IGShare/01_WPGS/04_MD/01_WSM/2D_도면.jpg

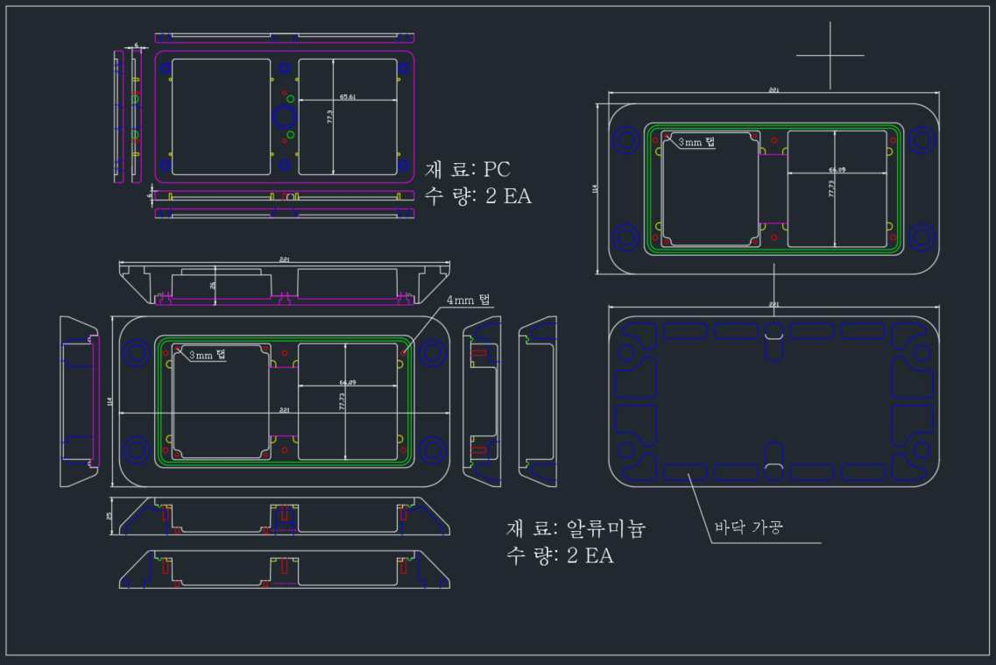
04_MD/01_WSM/2D_도면.jpg
