IGShare/01_WPGS/01_HW/02_WSCM/02_Development/01_WB/01_EVKit/01_CC2538/Readme.txt

XXXXXXXXXXXXXXXXXXXXXXXXXXXXXXXXXXXXXXXXXXXXXXXXXXXXXXXXXXXXXXXXX
X   	Artwork and documentation done by: 			X
X							X
X	TEXAS INSTRUMENTS NORWAY LPRF              		X
X  							X
X	Address: Gaustadalléen 21    0349 OSLO	              X
X 	web: www.ti.com/lprF		              	X
X                                                           	X
XXXXXXXXXXXXXXXXXXXXXXXXXXXXXXXXXXXXXXXXXXXXXXXXXXXXXXXXXXXXXXXXX

PCB NAME : CC2538EM
REVISION: 1.2
DATE: 2012-12-02

FILE:  PACKED WITH WinZIP 

PCB DESCRIPTION:4 LAYER PCB 1.6 MM
      Copper        1   35 um
      Dielectric  1-2   0.175 mm (e.g. 1x Prepreg 7628 AT05 47% Resin)
      Copper        2   18 um
      Dielectric  2-3   1.14 mm (6x 7628M 43% Resin)
      Copper        3   18 um
      Dielectric  3-4   0.175 mm (e.g. 1x Prepreg 7628 AT05 47% Resin)
      Copper        4   35 um
  DE104iML or equivalent substrate (Resin contents around 45%, which gives Er=4.42@2.4GHz, TanD=0.016)
  Dimensions in mm
  DOUBLE SIDE SOLDER MASK,
  DOUBLE SIDE SILKSCREEN,
  0.15 MM MIN TRACE WIDTH AND 0.15 MM MIN ISOLATION.

FILE NAME            		DESCRIPTION                               	FILE TYPE
-------------------------------------------------------------------------------------------
***PCB MANUFACTURING FILES:
layer1.art                 	LAYER 1 TOP SIDE/POSITIV              		EXT. GERBER
layer2.art                  	LAYER 2 Inner layer/POSITIV                 	EXT. GERBER
layer3.art                  	LAYER 3 Inner layer/POSITIV                 	EXT. GERBER
layer4.art                  	LAYER 4 SOLDER SIDE/POSITIV                 	EXT. GERBER
outline.art				Outline of PCB						EXT. GERBER
soldmask_top.art            	SOLDER MASK COMPONENT SIDE/NEGATIVE      		EXT. GERBER
soldmask_bottom.artL          SOLDER MASK SOLDER SIDE/NEGATIVE            	EXT. GERBER
silk_top.art	            SILKSCREEN COMPONENT SIDE/POSITIVE          	EXT. GERBER
silk_bottom.art			SILKSCREEN SOLDER SIDE/POSITIVE             	EXT. GERBER
NCdrill-1-4.drl               NC DRILL Plated		                       	EXCELLON
NCdrill-1-4-np.drl		NC DRILL non-Plated					EXCELLON
drill.art		            DRILL/MECHANICAL DRAWING                    	EXT. GERBER

ncdrill.log		              DRILL/NC DRILL REPORT                       	ASCII

*** ASSEMBLY FILES:
paste_top.art	             	SOLDER PAST COMPONENT SIDE/POSITIVE         	EXT. GERBER
paste_bottom.art	             	SOLDER PAST SOLDER SIDE/POSITIVE            	EXT. GERBER
assembly_top.art	            	ASSEMBLY DRAWING COMPONENT SIDE/NEGATIVE    	EXT. GERBER
assembly_bottom.art       	   	ASSEMBLY DRAWING SOLDER SIDE/NEGATIVE       	EXT. GERBER
pcp_rep.txt             		PICK AND PLACE FILE 
CC2538EM_PARTLIST_1_2_0.xlsx		BOM								Excel

PDF FILES:
CC2538EM_schematic_1_2_0.pdf	Circuit Diagram
CC2538EM_layout_1_2.pdf		Layout Diagram
CC2538EM_drill_1_2.pdf 		Drill

README.TXT           	THIS FILE                                 			ASCII

END.
