IGShare/01_WPGS/01_HW/01_WSM/02_Development/02_P0/04_Document/WSM 배치도.pptx

WSM 배치도

단위 : mm

65

65

15

8

10

18.4

23

25

13.5

5

65

- 14500 충전지-

20

40

18.4

65.3

55.2

14

50

WSM

77

J10

71

85

Antenna

56

55.2

71

J11

J12

Antenna

32

160

59

59

59

- 18650 충전지-

## Slide 2

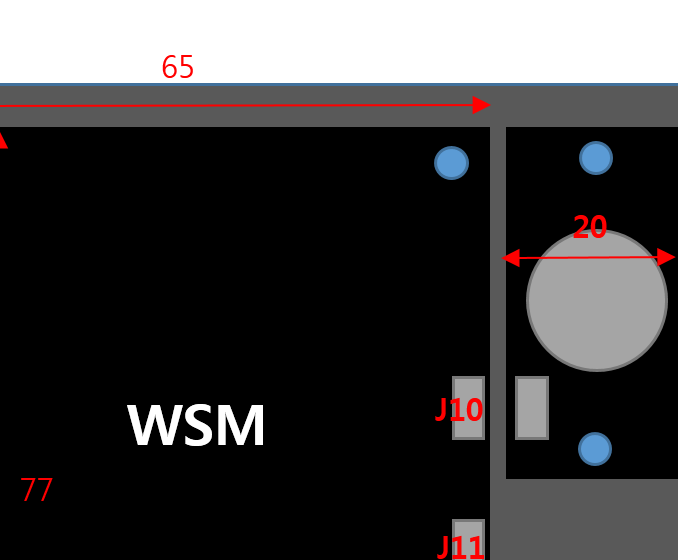
[picture p7: figure]

1.5mm

3mm

1.5mm
