IGShare/01_WPGS/01_HW/01_WSM/02_Development/03_P1/04_Document/WSM P1 배치도.pptx

77cm

WSM P1 배치도

S1 : ROM Enable 스위치
J7 : JTAGs
J6 : UART / D5,D6 : UART 보호다이오드
TH7 : D3V3P, 전원 측정 홀
TH6 : GND, 그라운드 홀
TH5 : D4V2P, 전원 측정 홀
D9 : 배터리 & 솔라 LED, 동작 전원
SW1(TP1, TP2) : CC2630 Reset 스위치
J9 : SmartRF06 evkit Debugging 핀
J8 : Reserved Pin
J2-J5: MCU Debugging LED 홀
J11(TH9, TH10) : 솔라 전원
J12(TH11, TH12) : Battery 전원
J10(TH3, TH4) : 초음파 센서 연결
U6 : D3V3P 출력 Regulator
U7 : PCM 배터리 보호칩
U3 : SPDT 초음파 Tx/Rx 선택 스위치
U4 : Op Amp 초음파 Rx 증폭
U5 : EEPROM
U2 : Magnetic Sensor
U1 : CC2630 7x7 MCU
J1 : SMA Right Angle Con, 안테나

WSM P1 배치도
- 전체 부품은 TOP 배치
- MCU 파트
1. U1, CC2630 Package 5x5 → 7x7 변경
2. S1, 스위치 KSD-02H → KHS22 변경
3. J7, JTAG Header 핀 수 변경
J8, Reserved 핀 수 변경
J9, SmartRF06 Evkit Debugging Header 추가
- Magnetic Sensor 파트
1. TP추가
- Ultra Sound Sensor 파트
1. 전원 공급 기존 D3V3P 공급 → D3V3P_US, Regulator 출력 전압
D4V2P_US, 배터리 or 솔라 출력 전압 선택 공급 가능
2. OP Amp TI社 TL072ID → TLV342IDR 변경
3. Detection Circuit IN4148W → BAT54 Shottky Diode 변경
4. TP추가
- Power 파트
1. PCM 칩 S-8200A → S-8240A 로 변경
2. 솔라 입력 전원 5V→ 4.5V 변경
3. 4.2V 출력 Regulator 삭제
4. 전원 입력 LED 삽입

1.2cm

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
TH11

J12

TH12

TH10

65cm

U2

U1

U4

J10

TH4

PCB
Ant.

TH3

1cm

J2

J3

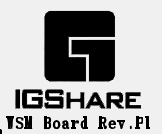
[picture p8: figure]

J1

J5

J4

1.4cm

65cm

55cm
