IGShare/01_WPGS/01_HW/01_WSM/02_Development/03_P1/04_Document/WSM P1_Review.pptx

## WSM P1_ Review

## Slide 2

WSM P0

WSM P1

1. MCU 2630RHB→ 2630RGZ 변경,
2. Reset 스위치 변경

## Slide 3

WSM P0

1. 기존에 센서 1개를 두어 초음파 아웃, 인 다이렉트로 연결 → SPDT 스위치를 두어 연결(스위치사용하면 펄서 형태 일그러짐 )
2. 다이오드 기존 정류다이오드 → 쇼트키 다이오드 BAT 54 변경

WSM P1

## Slide 4

WSM P0

WSM P1

1. PCM 사용하는 FET 변경 (너무 작아서 납땜 정확도 떨어진)
2. 초음파 전원 3.3V or 배터리 전원 선택 전원
3. 태양광에서 바로 연결된 4.2 LDO 제거(필요 없음)
4. 리튬 배터리의 그라운드는 PCM을 통해 연결되어야함. (P0설계 미스)

## Slide 5

WSM P1

WSM P1 배치도 (전체 배치 변경)
- 전체 부품은 TOP 배치
- MCU 파트
1. U1, CC2630 Package 5x5 → 7x7 변경
2. S1, 스위치 KSD-02H → KHS22 변경
3. J7, JTAG Header 핀 수 변경
J8, Reserved 핀 수 변경
J9, SmartRF06 Evkit Debugging Header 추가
- Magnetic Sensor 파트
1. TP추가
- Ultra Sound Sensor 파트
1. 전원 공급 기존 D3V3P 공급 → D3V3P_US, Regulator 출력 전압
D4V2P_US, 배터리 or 솔라 출력 전압 선택 공급 가능
2. OP Amp TI社 TL072ID → TLV342IDR 변경
3. Detection Circuit IN4148W → BAT54 Shottky Diode 변경
4. TP추가
- Power 파트
1. PCM 칩 S-8200A → S-8240A 로 변경
2. 솔라 입력 전원 5V→ 4.5V 변경
3. 4.2V 출력 Regulator 삭제
4. 전원 입력 LED 삽입
