IGShare/01_WPGS/01_HW/01_WSM/02_Development/03_P1/04_Document/아트웍 배치 WSM P1.pptx

77cm

WSM P1 배치도

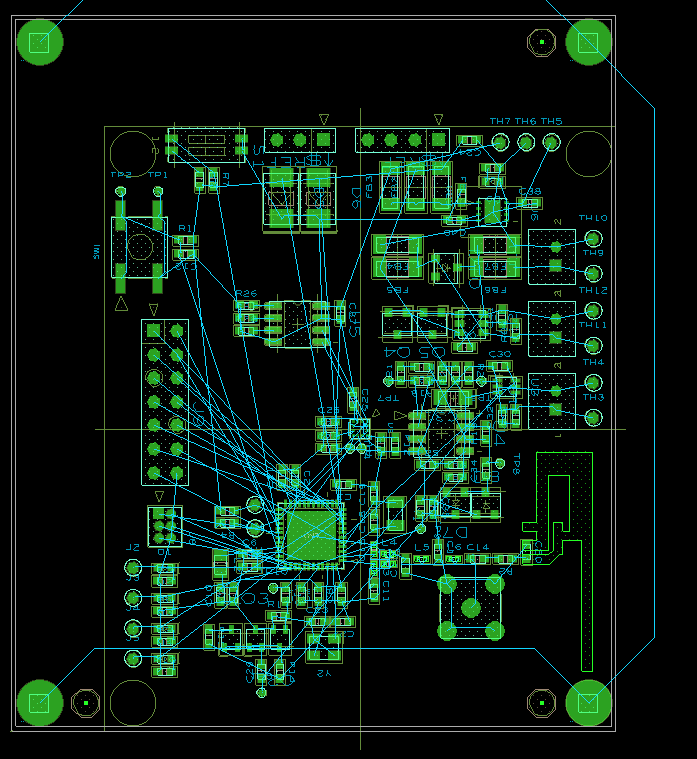
[picture p9: figure]

회사 로고 위치는
뒷면의 U2 아래 위치
WSM Board Rev. P1

1.2cm

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
TH11

J12

TH12

TH10

65cm

U2

U1

U4

J10

TH4

PCB
Ant.

TH3

1cm

J2

J3


J1

J5

J4

1.4cm

65cm

55cm
