IGShare/01_WPGS/01_HW/01_WSM/02_Development/04_P2/04_Document/WSM P2 리뷰자료.pptx

WSM P1→ P2 수정 사항
(I2C)
1. STATUS_LED3, STATUS_LED4 → I2C SCL, SDA 핀으로 변경
2. I2C 외부 연결 pin header J10 추가
(EEPROM)
1. EEPROM WP핀 스위치에 High low 변경 가능하게
(Ultra-sound)
1. Inverter SN74LVC1G04 추가
2. R19 300K → 1M
3. 3.3V 고정 전원이 아닌, 배터리 전원이 입력
(Power)
1. PCM Switch 연결
2. IRF7832PbF → CSD16413Q5A TI社
(ETC)
1. Connector Bottom 및 A2001 시리즈로 변경
2. 홀 제거
3. Vcut 제거
