IGShare/01_WPGS/01_HW/01_WSM/02_Development/05_P3/02_Artwork/wsm_p3_완료/netlist_report.htm

Design Name E:/work/jina/wsm_p3/allegro/wsm_p3_20170904.brd
Date Mon Sep 04 11:30:15 2017

Net List Report
Net Name | Net Pins
/RESET | R8.1 S1.2 U1.35
BTN_DOWN | J21.1 U1.18
BTN_RIGHT | J13.1 U1.28
BTN_SELECT | J20.1 U1.17
D3V3P | C26.2 C27.2 C28.2 C37.1 FB10.2 R12.2 TH7.1 U2.5 U2.6 U5.8
D3V3P_MCU | C2.2 C3.2 C4.2 C5.2 C6.2 C24.2 C44.2 C45.1 FB8.2 J7.1 R3.2 R4.2 R7.2 R8.2 R40.2 U1.13 U1.22 U1.34 U1.44
D3V3P_RX | C31.1 C36.2 FB12.2 FB14.2 R24.1 U4.8
D3V3P_TX | FB11.2 FB13.2 R14.2 R15.2 U8.5
D3V3P_US | C39.1 FB8.1 FB10.1 FB11.1 FB12.1 U6.1
D4V2P | C38.1 D9.1 FB13.1 FB14.1 R36.1 R50.1 TH5.1 U6.5 U6.8
DCDC_SW | L2.1 U1.33
DRDY | TP12.1 U2.8
EEPROM_WP | R40.1 S1.3 U5.7
ENABLE | R12.1 R13.2 U2.10
GND | C2.1 C3.1 C4.1 C5.1 C6.1 C7.1 C8.1 C9.1 C10.1 C11.2 C15.2 C16.1 C17.1 C18.2 C19.2 C21.2 C22.1 C23.1 C24.1 C25.1 C26.1 C27.1 C28.1 C31.2 C35.1 C36.1 C37.2 C38.2 C39.2 C40.2 C44.1 C45.2 C46.1 C52.1 D8.2 J1.2 J1.3 J1.4 J1.5 J6.3 J7.4 J10.3 J11.2 L7.2 Q2.2 Q3.3 Q4.1 Q4.2 Q4.3 R5.1 R13.1 R17.1 R22.1 R23.1 R25.1 R26.1 R27.1 R28.1 R30.2 R31.1 R38.2 R39.1 R51.2 S1.5 S1.6 S1.7 S1.8 TH6.1 U1.49 U2.3 U2.12 U4.4 U5.4 U6.4 U6.9 U8.3 Y2.2 Y2.4
GND-B | C41.2 C46.2 J12.1 Q5.1 Q5.2 Q5.3 S1.4 U7.4 U7.6
I2C_SCL | R3.1 U1.11 U2.1 U5.6
I2C_SDA | R4.1 U1.12 U2.11 U5.5
INT | U1.6 U2.7
JTAG_TCK | J7.2 U1.25
JTAG_TMS | J7.3 U1.24
LCD_CS | J14.1 U1.20
LCD_MODE | J15.1 U1.9
LCD_RESET | J16.1 U1.10
N167017791 | R38.1 U2.2
N16701813 | C25.2 U2.4
N16705809 | C32.2 R20.2
N16705820 | C32.1 R18.1 U4.2
N16705966 | R24.2 R25.2 U4.3 U4.5
N16706795 | C33.1 R19.1 U4.6
N16707221 | R18.2 R21.1 U4.1
N16707237 | C33.2 R21.2
N16707258 | C34.2 R19.2 U4.7
N16707911 | C34.1 D7.2 D8.1
N16724996 | Q2.1 R16.2 R17.2
N16725044 | Q1.1 Q2.3 Q3.1 R14.1
N167250560 | Q1.3 R15.1
N16725134 | C29.2 Q1.2 Q3.2
N16725188 | C29.1 U8.2
N16760492 | R27.2 U5.2
N16760496 | R28.2 U5.3
N16760500 | R26.2 U5.1
N16783258 | C40.1 U6.3
N16792762 | D9.2 R31.2
N16804439 | J11.1 J12.2 R29.1 R36.2
N16804638 | C41.1 R29.2 U7.5
N16804661 | Q5.4 U7.1
N16804663 | Q4.4 U7.3
N16805702 | R30.1 U7.2
N16807892 | Q4.5 Q4.6 Q4.7 Q4.8 Q4.9 Q5.5 Q5.6 Q5.7 Q5.8 Q5.9
N16891758 | J1.1 R2.1
N16891821 | C14.2 R2.2 R44.2
N16891831 | C13.2 C16.2 L4.2 L5.1
N16891837 | C13.1 L3.1 L8.2 U1.2
N16891839 | C23.2 U1.47 Y2.3
N16891854 | C14.1 C52.2 L6.2
N16891876 | C17.2 L5.2 L6.1
N16891929 | C15.1 L4.1 L8.1 U1.1
N16891931 | C22.2 U1.46 Y2.1
N16892413 | D1.2 R5.2
N16892809 | R41.1 U1.26
N16898279 | C53.1 R44.1
N16899923 | R46.2 U1.36
N16902060 | R48.1 U1.43
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
N16909290 | ANT1.1 C53.2 L7.1
N16917845 | R49.1 U1.40
N16921284 | R46.1 R50.2 R51.1
PLS_OUT | J10.1 U8.4
ROM_EN | R7.1 S1.1 U1.32
RX_ADC | C35.2 D7.1 R23.2 TP9.1 U1.42
RX_IN | J10.2 R20.1 R22.2
RX_TX | C11.1 L3.2 U1.3
SA1 | R39.2 TP11.1 U2.9
SPI_MISO | J17.1 U1.14
SPI_MOSI | J18.1 U1.15
SPI_SCK | J19.1 U1.16
STATUS_LED1 | D1.1 U1.38
TX_TRIG | R16.1 TP10.1 U1.41
UART_RX | J6.1 U1.7
UART_TX | J6.2 U1.8
VDDR | C7.2 C8.2 C9.2 C10.2 L2.2 U1.45 U1.48
