IGShare/01_WPGS/01_HW/01_WSM/02_Development/02_P0/04_Document/4.2V_3000mAh 리튬 배터리 테스트.pdf

테스트 날짜 | | | 테스트 날짜 | | | 테스트 날짜
배터리 단독 전압 | | | 배터리 단독 전압 | | | 배터리 단독 전압
로드 저항 값 | | | 로드 저항 값 | | | 로드 저항 값
배터리 | | | 배터리 | | | 배터리
측정 횟수(10분마다)/ 시간 | 배터리 전압(단위 : V) | 전류(단위 : A) | 측정 횟수(10분마다)/ 시간 | 배터리 전압(단위 : V) | 전류(단위 : A) | 측정 횟수(10분마다)/ 시간 | 배터리 전압(단위 : V) | 전류(단위 : A)
1 (시작) | 4.214(Load off) | 1.17 | 1 (시작) | 4.0681 (Load on) | 1.146 | 1 (시작) | 4.18794 (Load on) | 1.166
2 | 4.1739 | 1.153 | 2 | 4.00889 | 1.132 | 2 | 3.96937 | 1.142
3 | 4.0949 | 1.141 | 3 | 3.9108 | 1.107 | 3 | 3.97984 | 1.128
4 | 4.0553 | 1.125 | 4 | 3.83108 | 1.084 | 4 | 3.87055 | 1.114
5 | 4.0158 | 1.112 | 5 | 3.7915 | 1.075 | 5 | 3.85079 | 1.104
6 | 3.9763 | 1.102 | 6 | 3.77174 | 1.066 | 6 | 3.75198 | 1.075
7(1h) | 3.9368 | 1.092 | 7(1h) | 3.75198 | 1.058 | 7(1h) | 3.73221 | 1.066
8 | 3.8972 | 1.083 | 8 | 3.71245 | 1.052 | 8 | 3.71245 | 1.06
9 | 3.8577 | 1.069 | 9 | 3.69269 | 1.047 | 9 | 3.69269 | 1.054
10 | 3.78656 | 1.064 | 10 | 3.69269 | 1.041 | 10 | 3.67292 | 1.05
11 | 3.75494 | 1.059 | 11 | 3.67292 | 1.038 | 11 | 3.65316 | 1.047
12 | 3.71245 | 1.054 | 12 | 3.65316 | 1.035 | 12 | 3.65316 | 1.043
13(2h) | 3.69269 | 1.05 | 13(2h) | 3.6334 | 1.032 | 13(2h) | 3.6334 | 1.04
14 | 3.67292 | 1.048 | 14 | 3.61364 | 1.028 | 14 | 3.61364 | 1.036
15 | 3.65316 | 1.044 | 15 | 3.59387 | 1.018 | 15 | 3.61364 | 1.032
16 | 3.6334 | 1.04 | 16 | 3.57411 | 1.012 | 16 | 3.59387 | 1.026
17 | 3.61364 | 1.033 | 17 | 3.55435 | 1.004 | 17 | 3.57411 | 1.019
18 | 3.59387 | 1.011 | 18 | 3.4753 | 0.98 | 18 | 3.51482 | 1.007
19(3h) | 3.53458 | 0.902 | 19(3h) | x | x | 19(3h) | 3.39625 | 0.965
평균 전류 | | 1.071157895 | 평균 전류 | | 1.053055556 | 평균 전류 | | 1.061789474
#1 | #2

2016-10-25
4.229
3.4W
#1

### 배터리 전압 테스트

2016-10-21
4.214
3.4W

2016-10-24
4.204
3.4W
