IGShare/01_WPGS/01_HW/01_WSM/02_Development/02_P0/04_Document/이그쉐어 WSM 재작업 사항.pdf

# 이그쉐어 재 작업 요청사항

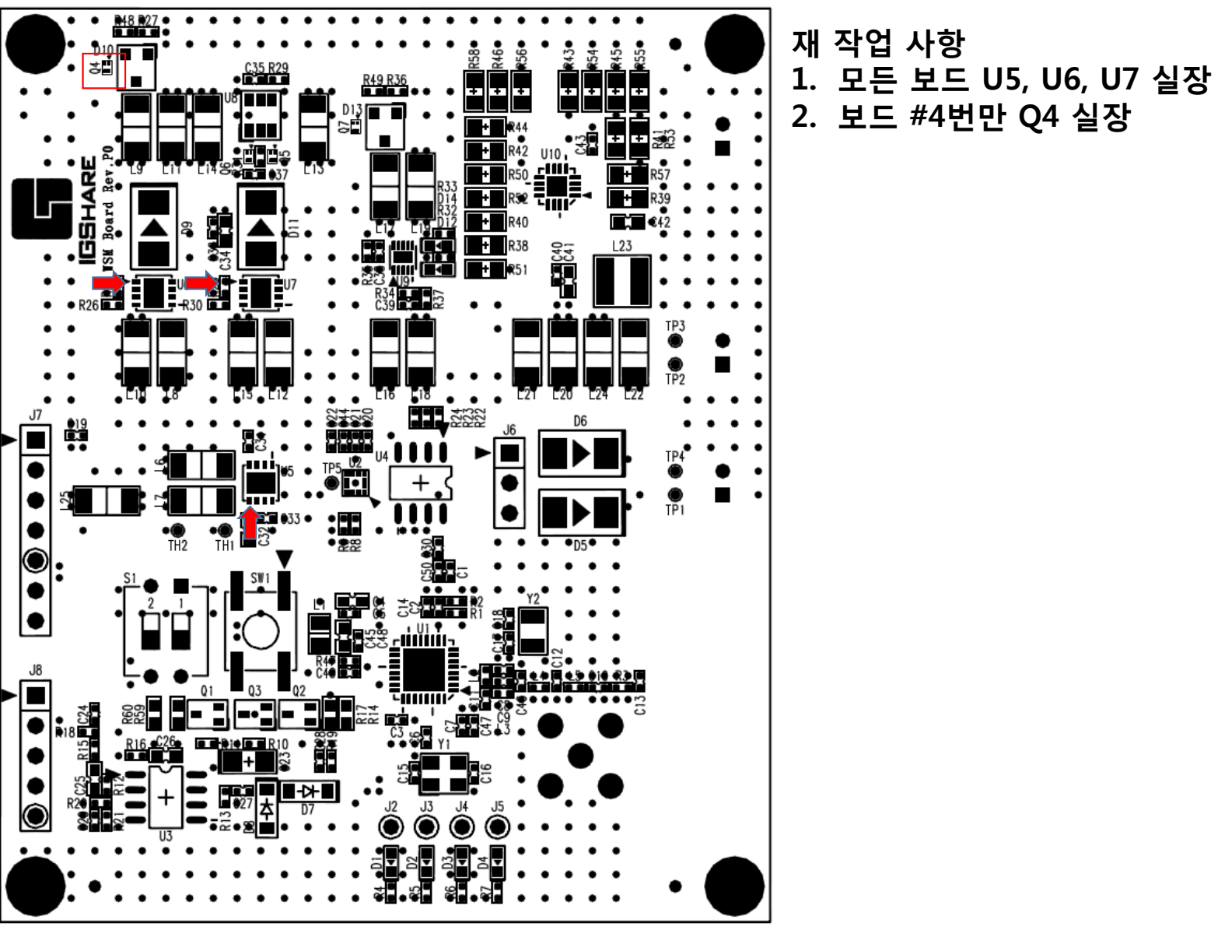
[picture p13: figure]
