IGShare/01_WPGS/01_HW/01_WSM/01_Documents/01_Datasheet/A2001-H+ (2).jpg

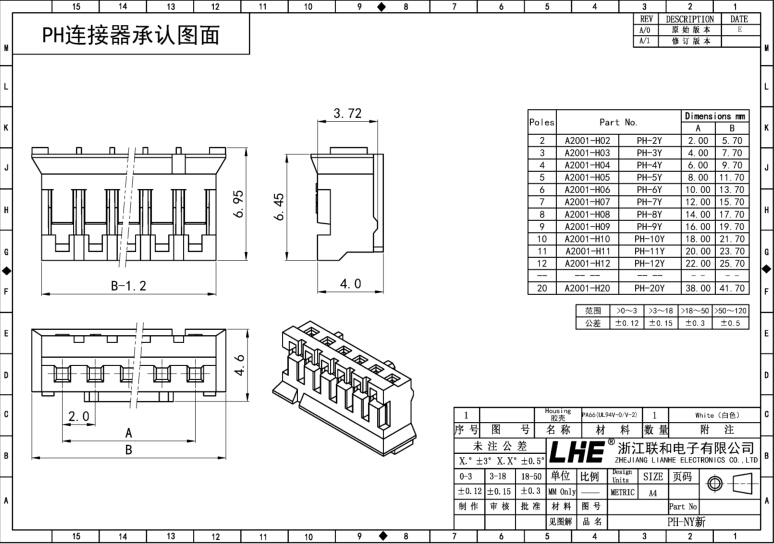
01_HW/01_WSM/01_Documents/01_Datasheet/A2001-H+ (2).jpg
