IGShare/01_WPGS/01_HW/01_WSM/01_Documents/01_Datasheet/A2001-WR .jpg

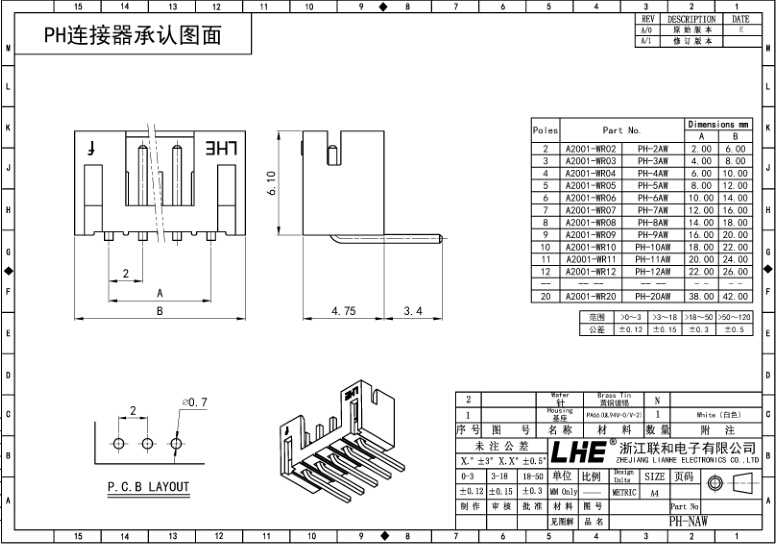
01_HW/01_WSM/01_Documents/01_Datasheet/A2001-WR .jpg
