IGShare/01_WPGS/01_HW/01_WSM/01_Documents/01_Datasheet/A2001-WV .png

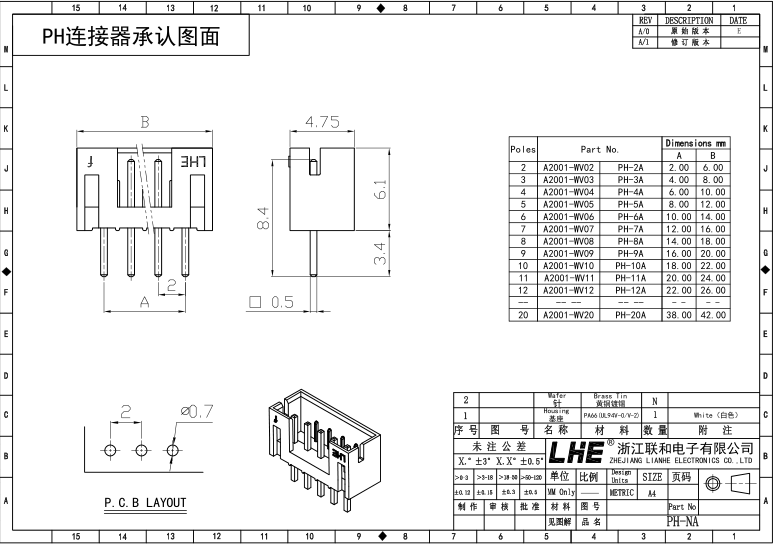
01_HW/01_WSM/01_Documents/01_Datasheet/A2001-WV .png
