IGShare/01_WPGS/01_HW/01_WSM/01_Documents/01_Datasheet/A3961-H02 (2).JPG

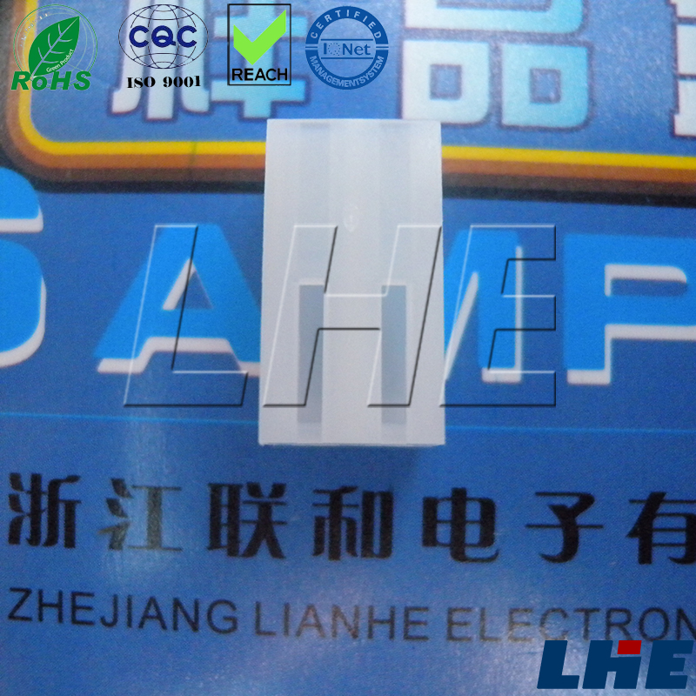
01_HW/01_WSM/01_Documents/01_Datasheet/A3961-H02 (2).JPG
