IGShare/01_WPGS/01_HW/01_WSM/01_Documents/01_Datasheet/A3961-TP2 (1).jpg

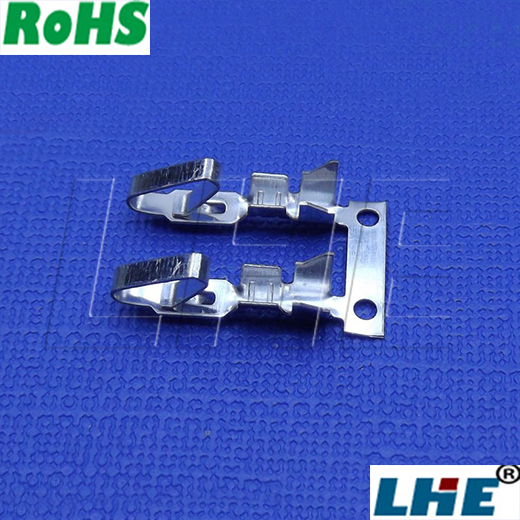
01_HW/01_WSM/01_Documents/01_Datasheet/A3961-TP2 (1).jpg
