IGShare/01_WPGS/01_HW/01_WSM/01_Documents/01_Datasheet/A3961-WV02 (1).JPG

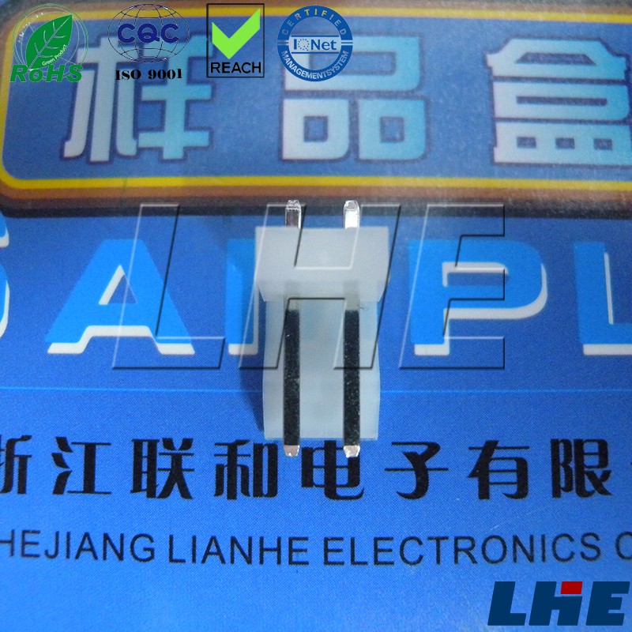
01_HW/01_WSM/01_Documents/01_Datasheet/A3961-WV02 (1).JPG
