IGShare/01_WPGS/01_HW/02_WSCM/01_Documents/01_Datasheet/Q4470-CL.jpg

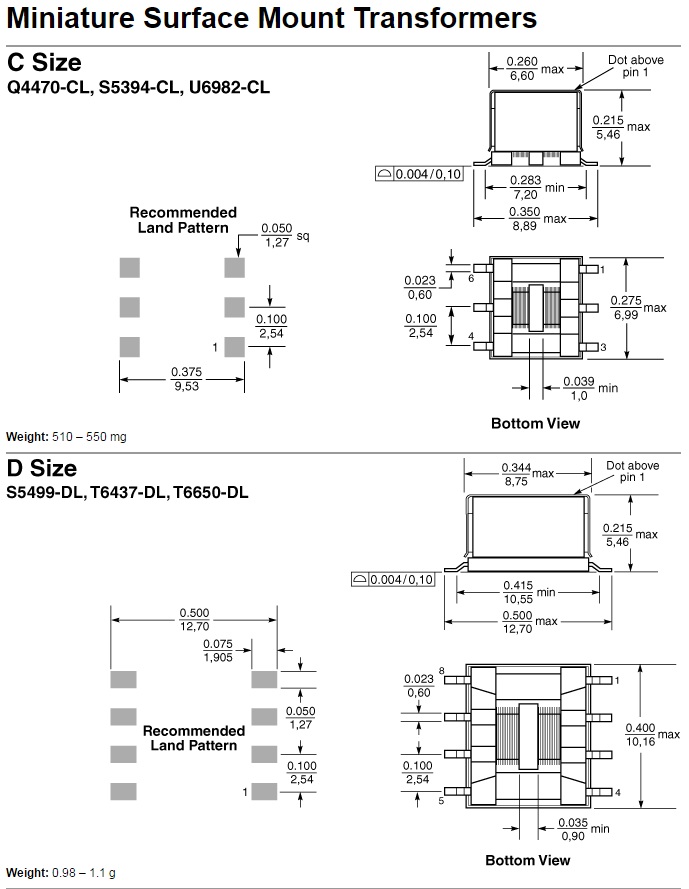
01_HW/02_WSCM/01_Documents/01_Datasheet/Q4470-CL.jpg
