IGShare/01_WPGS/01_HW/01_WSM/02_Development/02_P0/03_BOM/IGSHARE_WSM_V_P0.xlsx

BILL OF MATERIAL
Part Number |  |  |  | Rev No. | 00 | 작성자 | 김진아
Part Description |  |  | WSM Board | PCB Version | 00 | DATE | 2016-08-31 | PCB 수량 | 5
No | 품번 중복 | Material No. | 품명(Part description) | 규격(Specification) | MAKER | Quantity | Reference | 구분 | 구매 수량 | 변경 대상 | 변경 내용 | 비고
1 |  |  | 1uF | 0402X105K160CT, 1uF, 1005, 16V, 10%, X5R | WALSIN | 4 | C14,C22,C38,C39 | 도급 | 20
2 |  |  | 12pF | 0402N120K160CT, 12pF, 1005, 16V, 10%, NP0 | WALSIN | 3 | C10,C17,C18 | 도급 | 15
3 |  |  | 4.7K | 1608, 4.7K, 1% |  | 2 | R59,R60 | 도급 | 10 |  |  | 회사 재고품
4 |  |  | 100nF | 0402F104Z160CT, 100nF, 1005, 16V, -20/+80%, Y5V | WALSIN | 19 | C1,C2,C3,C5,C6,C7,C19,C20,C21,C29,C30,C31,C33,C35,C36,C37,C44,C48,C49 | 도급 | 95
5 |  |  | 1uF | TCSCN1C105MAAR, 1uF, 3216, 16V, 20%, Tant | SAMSUNG | 1 | C23 | 도급 | 5
6 |  |  | 47nF | 0402B473K160CT, 47nF, 1005, 16V, 10%, X7R | WALSIN | 1 | C24 | 도급 | 5
7 |  |  | 200pF | 200pF, 1608, 16V, 10%, NP0 | WALSIN | 1 | C25 | 도급 | 5
8 |  |  | 680pF | 0603N681K160CT, 680pF, 1608, 16V, 10%, NP0 | WALSIN | 1 | C26 | 도급 | 5
9 |  |  | 1nF | 0402B102K160CT, 1nF, 1005, 16V, 10%, X7R | WALSIN | 1 | C27 | 도급 | 5
10 |  |  | 560pF | 0402N561K160CT, 560pF, 1005, 16V, 10%, NP0 | WALSIN | 1 | C28 | 도급 | 5
11 |  |  | 2.2uF | 0603B225K160CT, 2.2uF, 1608, 16V, 10%, X7R | WALSIN | 2 | C32,C34 | 도급 | 10
12 |  |  | 10uF | 0603X106K160CT, 10uF, 1608, 16V, 10%, X5R | WALSIN | 2 | C4,C45 | 도급 | 10
13 |  |  | 10nF | 0402B103K500CT, 10nF, 1005, 50V, 10%, X7R | WALSIN | 2 | C40,C43 | 도급 | 10
14 |  |  | 4.7uF | 0603X475K160CT, 4.7uF, 1608, 16V, 10%, X5R | WALSIN | 2 | C41,C42 | 도급 | 10
15 |  |  | 1pF | 0402N1R0K160CT, 1pF, 1005, 16V, 10%, NP0 | WALSIN | 3 | C9,C11,C12 | 도급 | 15
16 |  |  | 6.8pF | 0402N6R8K160CT, 6.8pF, 1005, 16V, 10%, NP0 | WALSIN | 1 | C8 | 도급 | 5
17 |  |  | 10K | WR04X1002FTL, 1005, 10K, 1% | WALSIN | 8 | R1,R2,R15,R16,R20,R21,R35,R47 | 도급 | 40
18 |  |  | 47K | WR04X4702FTL, 1005, 47K, 1% | WALSIN | 1 | R10 | 도급 | 5
19 |  |  | 200 | WW04XR200FTL, 1005, 200, 1% | WALSIN | 1 | R11 | 도급 | 5
20 |  |  | 1M | WR04X1004FTL, 1005, 1M, 1% | WALSIN | 3 | R12,R27,R36 | 도급 | 15
21 |  |  | 300K | WR04X3003FTL, 1005, 300K, 1% | WALSIN | 1 | R13 | 도급 | 5
22 |  |  | 10K | WR06X103FTL, 1608, 10K, 5% | WALSIN | 2 | R14,R17 | 도급 | 10
23 |  |  | 3.9K | WR04X3901FTL, 1005, 3.9K, 1% | WALSIN | 1 | R18 | 도급 | 5
24 |  |  | 510K | WR04X5103FTL, 1005, 510K, 1% | WALSIN | 1 | R19 | 도급 | 5
25 |  |  | 4.64K | 1005, 4.64K, 1% | WALSIN | 2 | R25,R28 | 도급 | 10
26 |  |  | 2K | WR04X2001FTL, 1005, 2K, 1% | WALSIN | 4 | R26,R30,R31,R37 | 도급 | 20
27 |  |  | 0 | WR04X000PTL, 1005, 0, 1% | WALSIN | 1 | R3 | 도급 | 5
28 |  |  | 1.5K | WR04X1501FTL, 1005, 1.5K, 1% | WALSIN | 2 | R32, R33 | 도급 | 10
29 |  |  | 3.3M | 2012, 3.3M, 1% |  | 1 | R38 | 도급 | 5
30 |  |  | 4.3M | 2012, 4.3M, 1% |  | 3 | R39,R45,R46 | 도급 | 15
31 |  |  | 330 | WR04X3300FTL, 1005, 330, 1% | WALSIN | 5 | R4,R5,R6,R7,R29 | 도급 | 25
32 |  |  | 5.1M | 2012, 5.1M, 1% |  | 2 | R40,R44 | 도급 | 10
33 |  |  | 15M | 2012, 15M, 1% |  | 1 | R41 | 도급 | 5
34 |  |  | 1.2M | 2012, 1.2M, 1% |  | 1 | R42 | 도급 | 5
35 |  |  | 5.6M | 2012, 5.6M, 1% |  | 1 | R43 | 도급 | 5
36 |  |  | 1K | WR04X1001FTL, 1005, 1K, 1% | WALSIN | 7 | R8,R22,R23,R24,R34,R48,R49 | 도급 | 35
37 |  |  | 10uH | CKS2125100M-T, 2012, 10uH | Taiyo Yuden | 1 | L1 | 도급 | 5
38 |  |  | 2.4nH | LQG15HN2N4S02D, 1005, 2.4nH | Murata | 2 | L2,L3 | 도급 | 10
39 |  |  | 22uH | LPS4018-223MRC, 4mm*1.7mm, 22uH | Coilcraft | 1 | L23 | 도급 | 5
40 |  |  | 2nH | LQG15HN2N0S02D, 1005, 2nH | Murata | 2 | L4,L5 | 도급 | 10
41 |  |  | BLM41PG750SN1 | BLM41PG750SN1L, BEAD, 4516, 3A, 75ohm , 100MHz | Murata | 19 | L6,L7,L8,L9,L10,L11,L12,L13,L14,L15,L16,L17,L18,L19,L20,L21,L22,L24,L25 | 도급 | 95
42 |  |  | MMBT3904 | TR, NPN, 40V, 0.2A, SOT-23, | FAIRCHILD | 2 | Q1,Q2 | 도급 | 10
43 |  |  | MMBT3906 | TR, PNP, 40V, 0.2A, SOT-23, | FAIRCHILD | 1 | Q3 | 도급 | 5
44 |  |  | CSD13381F4 | MOSFET,N-CH, 12V, 3PICOSTAR | TI | 4 | Q4,Q5,Q6,Q7 | 사급 | 20
45 |  |  | BL-HG036A-AV-TRB | BL-HG036A-AV-TRB, LED, 1608, GREEN | BRT LED | 6 | D1,D2,D3,D4,D12,D14 | 도급 | 30
46 |  |  | BXZ84C2V7 | Zener Diode, 2.7V, 350mW | FCI | 2 | D10,D13 | 도급 | 10
47 |  |  | SMBJ26CA | TVS Diode, 26V, 600W, SMD | Bourns | 2 | D5,D6 | 도급 | 10
48 |  |  | 1N4148W | Diode, 100mA, 75V, SOD-123 | KD | 2 | D7,D8 | 도급 | 10
49 |  |  | VS-10BQ15-M3 | Schottky Diode, 15V, 1A, Vf=0.32, SMB(DO-214AA) | Vishay | 2 | D9,D11 | 도급 | 10
50
51 |  |  | SMW200-02 | 2mm Pitch, 2Pin, Straight Dip | YEONHO | 3 | J10,J11,J12 | 도급 | 15
52 |  |  | CC2630_RHB | IC, MCU, 128kB Flash, 48MHz, VQFN-32 | TI | 1 | U1 | 사급 | 5
53 |  |  | bq25504 | IC, BATTERY CHARGER, LI-ION, QFN-16 | TI | 1 | U10 | 사급 | 5
54 |  |  | LIS3MDL | IC, Magneticmeter, 3-AXIS, 12LGA | ST | 1 | U2 | 도급 | 5
55 |  |  | TL072ID | IC, Op-amp, JFET, 3MHz, DUAL, 8SOIC | TI | 1 | U3 | 사급 | 5
56 |  |  | AT24C02BN-SH | IC, 2Kbit, EEPROM, 8-SOIC | ATMEL | 1 | U4 | 도급 | 5
57 |  |  | TPS73533QDRBRQ1 | IC, LDO, 3.3V, 0.5A, 8SON | TI | 1 | U5 | 사급 | 5
58 |  |  | TPS73501-Q1 | IC, LDO, adj, 0.5A, 8SON | TI | 2 | U6,U7 | 사급 | 10
59 |  |  | S-8200ABE-M6T1U | IC, PCM, 1cell, SOT-23-6 | SII Semiconductor | 1 | U8 | 사급 | 5
60 |  |  | bq24040 | IC, Battery Charger Li-Ion, 800mA 4.2V 10-Pin, WSON | TI | 1 | U9 | 사급 | 5
61 |  |  | EVQ-Q2P02W | SWITCH, TACTILE, SPST, 20mA, 15VDC, SMD | PANASONIC | 1 | SW1 | 도급 | 5
62 |  |  | S3225A-024000-F09-YYD-1BDA | Crystal, 24.0000MHZ, SMD | YOKE | 1 | Y1 | 도급 | 5
63 |  |  | CM315D32768DZFT | Clock, 32.768KHz, SMD | CITIZEN | 1 | Y2 | 도급 | 5
64 |  |  | KSD-02H | DIP Switch, 접점 2 | KOREA OTAX | 1 | S1 | 도급 | 5
