IGShare/01_WPGS/01_HW/01_WSM/02_Development/03_P1/03_BOM/IGSHARE_WSM_V_P1.xlsx

BILL OF MATERIAL
Part Number |  |  |  | Rev No. | P1 | 작성자 | 김진아
Part Description |  |  | WSM Board | PCB Version | P1 | DATE | 2016-11-08 | PCB 수량
No | 품번 중복 | Material No. | 품명(Part description) | 규격(Specification) | MAKER | Quantity | Reference | 구분 | 구매 수량 | 변경 대상 | 변경 내용 | 비고
1 | 1 | 00000184 | 100nF | 1608, 100nF, 50V | WALSIN | 18 | C2,C3,C4,C6,C7,C8,C24,C25,C26,C27,C30,C36,C37,C38,C40,C41,C44,C45
2 | 1 | 00000012 | 10uF | 0603X106K160CT, 10uF, 1608, 16V, 10%, X5R | WALSIN | 3 | C5,C9,C28
3 | 1 | 00000087 | 6.8pF | 0603N6RBD500LT, 1608, 6.8pF, 50V | WALSIN | 1 | C11
4 | 1 | 00000156 | 1pF | 1pF, 1608, 16V |  | 3 | C13,C15,C17
5 | 1 | 00000172 | 12pF | 12pF, 1608, 16V, 10% |  | 3 | C14,C18,C19
6 | 1 | 00000153 | 1uF | 1uF, 1608, 16V |  | 1 | C21
7 | 1 | 00000173 | 47nF | 47nF, 1608, 16V, 10% |  | 1 | C29
8 | 1 | 00000115 | 6.8uF | 6.8uF, 3216, Tantal | AVX | 1 | C31
9 | 1 | 00000007 | 200pF | 200pF, 1608, 16V, 10%, NP0 | WALSIN | 1 | C32
10 | 1 | 00000008 | 680pF | 0603N681K160CT, 680pF, 1608, 16V, 10%, NP0 | WALSIN | 1 | C33
11 | 1 | 00000154 | 1nF | 1nF, 1608, 50V |  | 1 | C34
12 | 1 | 00000174 | 560pF | 560pF, 1608, 16V, 10% |  | 1 | C35
13 | 1 | 00000011 | 2.2uF | 0603B225K160CT, 2.2uF, 1608, 16V, 10%, X7R | WALSIN | 1 | C39
14 | 1 | 00000045 | BL-HG036A-AV-TRB | BL-HG036A-AV-TRB, LED, 1608, GREEN | BRT LED | 5 | D1,D2,D3,D4,D9
15 | 1 | 00000047 | SMBJ26CA | TVS Diode, 26V, 600W, SMD | Bourns | 2 | D5,D6
16 | 1 | 00000183 | BAT54 | Shottky Diode, SOT23, 20V, 200mA | Diode | 3 | D7,D8,D10
17 | 1 | 00000041 | BLM41PG750SN1 | BLM41PG750SN1L, BEAD, 4516, 3A, 75ohm , 100MHz | Murata | 2 | FB6,FB7
18 | 1 | 00000185 | BLM18HE152SN1 | 1608, 1500ohm, 500mA | Murata | 3 | FB8,FB9,FB10
19 | 1 | 00000037 | 10uH | CKS2125100M-T, 2012, 10uH | Taiyo Yuden | 1 | L2
20 | 1 | 00000038 | 2.4nH | LQG15HN2N4S02D, 1005, 2.4nH | Murata | 2 | L3,L4
21 | 1 | 00000040 | 2nH | LQG15HN2N0S02D, 1005, 2nH | Murata | 2 | L5,L6
22 | 1 | 00000042 | MMBT3904 | TR, NPN, 40V, 0.2A, SOT-23, | FAIRCHILD | 2 | Q1,Q2
23 | 1 | 00000043 | MMBT3906 | TR, PNP, 40V, 0.2A, SOT-23, | FAIRCHILD | 1 | Q3
24 | 1 | 00000128 | 0 | 0, 1608, 1% |  | 7 | R2,R36,R37,R38,R39,R40,R41
25 | 1 | 00000003 | 4.7K | 1608, 4.7K, 1% |  | 4 | R3,R4,R7,R8
26 | 1 | 00000166 | 330 | 330, 1608, 1% |  | 6 | R5,R6,R9,R10,R29,R31
27 | 1 | 00000132 | 1K | 1K, 1608, 1% |  | 5 | R12,R26,R27,R28,R30
28 | 1 | 00000079 | 47K | WR06X479JTL, 1608, 47K, 5% |  | 1 | R14
29 | 1 | 00000133 | 200 | 200, 1608, 1% |  | 1 | R15
30 | 1 | 00000022 | 10K | WR06X103FTL, 1608, 10K, 5% |  | 6 | R16,R17,R20,R21,R24,R25
31 | 1 | 00000175 | 1M | 1M, 1608, 1% |  | 1 | R18
32 | 1 | 00000176 | 300K | 300K, 1608, 1% |  | 1 | R19
33 | 1 | 00000177 | 100K | 100K, 1608, 1% |  | 1 | R22
34 | 1 | 00000178 | 510K | 510K, 1608, 1% |  | 1 | R23
35 | 1 | 00000179 | KHS22 | KHS22, 초소형SMD타입 DIP SWITCH 2극 Slide type, 2pole | KOREA OTAX | 1 | S1
36 | 1 | 00000180 | CC2630F128RGZT | MCU, 32BIT, CORTEX M3, 48MHZ, VQFN-48 | TI | 1 | U1
37 | 1 | 00000054 | LIS3MDL | IC, Magneticmeter, 3-AXIS, 12LGA | ST Microelectronics | 1 | U2
38 | 1 | 00000187 | STG3157 | SPDT Switch, SOT323-6L | ST Microelectronics | 1 | U3
39 | 1 | 00000181 | TLV342IDR | IC OPAMP GP R-R 2.3MHZ 8SOIC | TI | 1 | U4
40 | 1 | 00000056 | AT24C02BN-SH | IC, 2Kbit, EEPROM, 8-SOIC | ATMEL | 1 | U5
41 | 1 | 00000057 | TPS73533QDRBRQ1 | IC, LDO, 3.3V, 0.5A, 8SON | TI | 1 | U6
42 | 1 | 00000059 | S-8200ABE-M6T1U | IC, PCM, 1cell, SOT-23-6 | SII Semiconductor | 1 | U7
43 | 1 | 00000063 | CM315D32768DZFT | Clock, 32.768KHz, SMD | CITIZEN | 1 | Y1
44 | 1 | 00000062 | S3225A-024000-F09-YYD-1BDA | Crystal, 24.0000MHZ, SMD | YOKE | 1 | Y2
