IGShare/01_WPGS/01_HW/01_WSM/02_Development/04_P2/03_BOM/IGSHARE_WSM_V_P2_20170123.xlsx

BILL OF MATERIAL
Part Number |  |  |  | Rev No. | P2 | 작성자 | 김진아
Part Description |  |  | WSM Board | PCB Version | P2 | DATE | 2017-01-23 | PCB 수량 | 20
No | 품번 중복 | Material No. | 품명(Part description) | 규격(Specification) | MAKER | Quantity | Reference | 구분 | 구매 수량 | 변경 대상 | 변경 내용 | 비고
1 | 1 | 00000082 | 100nF | 0603Y104Z250BD, 1608, 100nF, 25V, -20/+80% | YAGEO, Walsin | 17 | C2,C3,C4,C6,C7,C8,C24,C25,C26,C27,C36,C37,C38,C40,C41,C44,C45 |  | 재고
2 | 1 | 00000012 | 10uF | 0603X106K160CT, 10uF, 1608, 16V, 10%, X5R | WALSIN | 3 | C5,C9,C28 |  | Reel
3 | 1 | 00000087 | 6.8pF | 0603N6RBD500LT, 1608, 6.8pF, 50V | WALSIN | 1 | C11 |  | 재고
4 | 1 | 00000156 | 1pF | 1pF, 1608, 50V |  | 3 | C13,C15,C17 |  | 재고
5 | 1 | 00000172 | 12pF | 12pF, 1608, 16V, 10% |  | 3 | C14,C18,C19 |  | 재고
6 | 1 | 00000153 | 1uF | 1uF, 1608, 16V |  | 2 | C21,C46 |  | Reel
7 | 1 | 00000173 | 47nF | 47nF, 2012, 50V, 10% |  | 1 | C29 |  | 재고
8 | 1 | 00000188 | TCSCS1C685MAAR | 6.8uF, 3216, 6.3V, 10%, Tant | AVX | 1 | C31 |  | 재고
9 | 1 | 00000007 | 200pF | 200pF, 1608, 50V, 10%, NP0 | WALSIN | 1 | C32 |  | 재고
10 | 1 | 00000008 | 680pF | 680pF, 1608, 50V, 10%, NP0 | WALSIN | 1 | C33 |  | 재고
11 | 1 | 00000154 | 1nF | 1nF, 1608, 50V |  | 1 | C34 |  | 재고
12 | 1 | 00000174 | 560pF | 560pF, 1608, 50V, 10% |  | 1 | C35 |  | 재고
13 | 1 | 00000011 | 2.2uF | 0603B225K160CT, 2.2uF, 1608, 16V, 10%, X7R | WALSIN | 1 | C39 |  | 재고
14 | 1 | 00000045 | BL-HG036A-AV-TRB | BL-HG036A-AV-TRB, LED, 1608, GREEN | BRT LED | 3 | D1,D2,D9 |  | Reel
15 | 1 | 00000047 | SMBJ26CA | TVS Diode, 26V, 600W, SMD | Bourns | 2 | D5,D6 |  | 50
16 | 1 | 00000183 | BAT54 | Shottky Diode, SOT23, 20V, 200mA | Diode | 2 | D7,D8 |  | 재고
17 | 1 | 00000185 | BLM18HE152SN1 | 1608, 1500ohm, 500mA | Murata | 2 | FB8,FB10 |  | 재고
18 | 1 | 00000124 | PH01(2.54)-SS40P-11.5MM | 2.54 pitch, Header | FCI | 4 | J6,J7,J9,J13 |  | 재고
19 | 1 | 00000213 | A2001-WR03 | R/A Connector, 3Pin | LHE | 1 | J10 |  | 재고
20 | 1 | 00000214 | A2001-WR02 | R/A Connector 2 pin | LHE | 2 | J11,J12 |  | 재고
21 | 1 | 00000037 | 10uH | CKS2125100M-T, 2012, 10uH | Murata | 1 | L2 |  | 재고
22 | 1 | 00000038 | 2.4nH | LQG15HN2N4S02D, 1005, 2.4nH | Murata | 2 | L3,L4 |  | 재고
23 | 1 | 00000040 | 2nH | LQG15HN2N0S02D, 1005, 2nH | Murata | 2 | L5,L6 |  | 재고
24 | 1 | 00000042 | MMBT3904 | TR, NPN, 40V, 0.2A, SOT-23, | FAIRCHILD | 2 | Q1,Q2 |  | 재고
25 | 1 | 00000043 | MMBT3906 | TR, PNP, 40V, 0.2A, SOT-23, | FAIRCHILD | 1 | Q3 |  | 재고
26 | 1 | 00000210 | CSD16413Q5A | MOSFET, n Channel 8-SON | TI | 2 | Q4,Q5 |  | 재고
27 | 1 | 00000128 | 0 | 0, 1608, 1% |  | 7 | R2,R36,R37,R38,R39,R41,R42 |  | 재고
28 | 1 | 00000003 | 4.7K | 1608, 4.7K, 1% | YAGEO | 5 | R3,R4,R7,R8,R40 |  | 재고
29 | 1 | 00000166 | 330 | 330, 1608, 1% |  | 4 | R5,R6,R29,R31 |  | 재고
30 | 1 | 00000132 | 1K | 1K, 1608, 1% |  | 5 | R12,R26,R27,R28,R30 |  | 재고
31 | 1 | 00000079 | 47K | WR06X479JTL, 1608, 47K, 5% | WALSIN | 1 | R14 |  | 재고
32 | 1 | 00000133 | 200 | 200, 1608, 1% |  | 1 | R15 |  | 재고
33 | 1 | 00000022 | 10K | WR06X103FTL, 1608, 10K, 5% | WALSIN | 6 | R16,R17,R20,R21,R24,R25 |  | 재고
34 | 1 | 00000175 | 1M | 1M, 1608, 1% |  | 2 | R18,R19 |  | 재고
35 | 1 | 00000177 | 100K | 100K, 1608, 1% |  | 1 | R22 |  | 재고
36 | 1 | 00000178 | 510K | 510K, 1608, 1% |  | 1 | R23 |  | 재고
37 | 1 | 00000215 | LL1051-1-4 | DIP Switch, 접점 4 |  | 1 | S1 |  | 재고
38 | 1 | 00000180 | CC2630F128RGZT | MCU, 32BIT, CORTEX M3, 48MHZ, VQFN-48 |  | 1 | U1 |  | 재고
39 | 1 | 00000054 | LIS3MDL | IC, Magneticmeter, 3-AXIS, 12LGA |  | 1 | U2 |  | 재고
40 | 1 | 00000216 | TLV342IDR | C OPAMP GP R-R 2.3MHZ 8SOIC | TI | 1 | U4 |  | 재고
41 | 1 | 00000056 | AT24HC02C-SSHM-T | IC, 2Kbit, EEPROM, 8-SOIC | ATMEL | 1 | U5 |  | 재고
42 | 1 | 00000057 | TPS73533QDRBRQ1 | IC, LDO, 3.3V, 0.5A, 8SON | TI | 1 | U6 |  | 재고
43 | 1 | 00000219 | DW01A | One Cell Battery protection IC | Fortune | 1 | U7 |  | 재고
44 | 1 | 00000217 | SN74LVC1G04 | IC, INVERTER, SINGLE, SMD, SOT-23-5 | TI | 1 | U8 |  | 재고
45 | 1 | 00000063 | CM315D32768DZFT | Clock, 32.768KHz, SMD | CITIZEN | 1 | Y1 |  | 재고
46 | 1 | 00000062 | S3225A-024000-F09-YYD-1BDA | Crystal, 24.0000MHZ, SMD | YOKE | 1 | Y2 |  | 재고
