IGShare/01_WPGS/01_HW/02_WSCM/02_Development/01_WB/02_P0/03_BOM/IGSHARE_WB_V_P0.xlsx

BILL OF MATERIAL
Part Number |  |  |  | Rev No. | P0 | 작성자 | 김진아
Part Description |  |  | WB | PCB Version | 00 | DATE | 2016-09-30 | PCB 수량 | 5
No | 품번 중복 | Material No. | 품명(Part description) | 규격(Specification) | MAKER | Quantity | Reference | 구분 | 구매 수량 | 변경 대상 | 변경 내용 | 비고
1 | 1 | 00000082 | 100nF | 0603Y104Z250BD, 1608, 100nF, 25V, -20/+80% | YAGEO | 18 | C1,C2,C3,C4,C6,C7,C10,C14,C25,C26,C27,C28,C29,C30,C31,C34,C36,C38 | 사급 | 0
2 | 1 | 00000153 | 1uF | 1uF, 1608, 16V |  | 4 | C8,C9,C19,C33 | 도급 | 20
3 | 1 | 00000154 | 1nF | 1nF, 1608, 16V |  | 2 | C11,C35 | 도급 | 10 |  |  | 회사 재고품
4 | 1 | 00000155 | 18pF | 18pF, 1608, 16V |  | 2 | C12,C18 | 도급 | 10
5 | 1 | 00000156 | 1pF | 1pF, 1608, 16V |  | 2 | C13,C20 | 도급 | 10
6 | 1 | 00000094 | 220pF | 0603B221K500BD, 1608, 220pF, 50V, 10% | YAGEO | 1 | C15 | 사급 | 0
7 | 1 | 00000157 | 1.2pF | 1.2pF, 1608, 16V |  | 1 | C16 | 도급 | 5
8 | 1 | 00000158 | 22pF | 22pF, 1608, 16V |  | 2 | C23,C24 | 도급 | 10
9 | 1 | 00000159 | 10uF | 10uF, 2012, 16V, 10%, Tant |  | 1 | C32 | 도급 | 5
12 | 1 | 00000011 | 2.2uF | 0603B225K160CT, 2.2uF, 1608, 16V, 10%, X7R | WALSIN | 1 | C37 | 사급 | 0
13 | 1 | 00000045 | BL-HG036A-AV-TRB | BL-HG036A-AV-TRB, LED, 1608, GREEN | BRT LED | 4 | D1,D2,D3,D4 | 사급 | 0
14 | 1 | 00000047 | SMBJ26CA | TVS Diode, 26V, 600W, SMD | Bourns | 2 | D7,D8 | 도급 | 10
15 | 1 | 00000160 | BLM41PG181SN1 | Bead, 4516, 3A, 180@100MHz | Murata | 2 | FB1,FB2 | 도급 | 10
16 | 1 | 00000161 | SMA-LR-PC | RF Connector, SMA Right, DIP | Hirose | 1 | J1 | 사급 | 0
17 | 1 | 00000162 | SMW200-03 | 2mm Pitch, 3Pin, Straight Dip | YEONHO | 1 | J10 | 도급 | 5
18 | 1 | 00000123 | 76342-305LF | 76342-305LF, 2Row, 5+5way | Molex | 2 | J11,J13 | 도급 | 10
19 | 1 | 00000040 | 2nH | LQG15HN2N0S02D, 1005, 2nH | Murata | 3 | L1,L3,L4 | 사급 | 0
20 | 1 | 00000163 | 3.3nH | LQG15HN3N3S02, 1005, 3.3nH | Murata | 2 | L2,L8 | 도급 | 10
21 | 1 | 00000041 | BLM41PG750SN1 | BLM41PG750SN1L, BEAD, 4516, 3A, 75ohm , 100MHz | Murata | 3 | L5,L6,L7 | 사급 | 0
22 | 1 | 00000164 | 2.2K | 2.2K, 1608, 1% |  | 1 | R1 | 도급 | 5
23 | 1 | 00000165 | 56K | 56K, 1608, 1% |  | 1 | R2 | 도급 | 5
24 | 1 | 00000166 | 330 | 330, 1608, 1% |  | 4 | R5,R6,R7,R8 | 도급 | 20
25 | 1 | 00000167 | 0 | 0, 1608, 1% |  | 4 | R9,R10,R11,R12 | 도급 | 20
26 | 1 | 00000168 | CC2538 | RF IC, Zigbee | TI | 1 | U1 | 도급 | 5
27 | 1 | 00000169 | MAX3232CDR_SOIC | RS-232 인터페이스 IC 3-5.5V Mult-Ch RS232 | TI | 1 | U2 | 도급 | 5
28 | 1 | 00000170 | TPS73533QDRBRQ1 | LDO 전압 레귤레이터 500-mA, Low Quiescnt low noise high PSRR | TI | 1 | U3 | 도급 | 5
29 | 1 | 00000171 | 32 MHz Crystal/S3225A Crystal | S3225A, SMD Crystal 32*25*0.7 | YOKETAN CORPORATION | 1 | Y1 | 도급 | 5
30 | 1 | 00000063 | CM315D32768DZFT | Clock, 32.768KHz, SMD | CITIZEN | 1 | Y2 | 사급 | 0
