IGShare/01_WPGS/01_HW/02_WSCM/02_Development/01_WB/03_P1/03_BOM/IGSHARE_WB_V_P1.xlsx

BILL OF MATERIAL
Part Number |  |  |  | Rev No. | P0 | 작성자 | 김진아
Part Description |  |  | WB | PCB Version | 00 | DATE | 2016-12-27 | PCB 수량 | 3
No | 품번 중복 | Material No. | 품명(Part description) | 규격(Specification) | MAKER | Quantity | Reference | 구분 | 구매 수량 | 변경 대상 | 변경 내용 | 비고
1 | 1 | 00000082 | 100nF | 0603Y104Z250BD, 1608, 100nF, 25V, -20/+80% | YAGEO | 17 | C1,C2,C3,C6,C7,C10,C14,C26,C27,C28,C29,C30,C31,C34,C36,C38,C39 | 사급
2 | 1 | 00000153 | 1uF | 1uF, 1608, 16V |  | 4 | C8,C9,C19,C33 | 도급 | 12
3 | 1 | 00000154 | 1nF | 1nF, 1608, 16V |  | 2 | C11,C35 | 사급
4 | 1 | 00000155 | 18pF | 18pF, 1608, 16V |  | 2 | C12,C18 | 도급 | 6
5 | 1 | 00000156 | 1pF | 1pF, 1608, 16V |  | 2 | C13,C20 | 사급
6 | 1 | 00000094 | 220pF | 0603B221K500BD, 1608, 220pF, 50V, 10% | YAGEO | 1 | C15 | 사급
7 | 1 | 00000157 | 1.2pF | 1.2pF, 1608, 16V |  | 1 | C16 | 사급
8 | 1 | 00000172 | 12pF | 12pF, 1608, 16V, 10% |  | 2 | C21,C22 | 사급
9 | 1 | 00000158 | 22pF | 22pF, 1608, 16V |  | 2 | C23,C24 | 사급
10 | 1 | 00000159 | 10uF | 10uF, 2012, 16V, 10%, Tant |  | 1 | C32 | 사급
13 | 1 | 00000011 | 2.2uF | 0603B225K160CT, 2.2uF, 1608, 16V, 10%, X7R | WALSIN | 1 | C37 | 사급
14 | 1 | 00000045 | BL-HG036A-AV-TRB | BL-HG036A-AV-TRB, LED, 1608, GREEN | BRT LED | 5 | D1,D2,D3,D4,D11 | 사급
15 | 1 | 00000047 | SMBJ26CA | TVS Diode, 26V, 600W, SMD | Bourns | 4 | D7,D8,D9,D10 | 도급 | 12
16 | 1 | 00000160 | BLM41PG181SN1 | Bead, 4516, 3A, 180@100MHz | Murata | 2 | FB1,FB2 | 사급
17 | 1 | 00000161 | SMA-LR-PC | RF Connector, SMA Right, DIP | Hirose | 1 | J1
18 | 1 | 00000124 | PH01(2.54)-SS40P-11.5MM | 2.54 pitch, Header | FCI | 4 | J6,J12,J11, J13
21 | 1 | 00000040 | 2nH | LQG15HN2N0S02D, 1005, 2nH | Murata | 3 | L1,L3,L4 | 사급
23 | 1 | 00000185 | BLM18HE152SN1 | 1608, 1500ohm, 500mA | Murata | 2 | L5,L7 | 사급
24 | 1 | 00000163 | 3.3nH | LQG15HN3N3S02, 1005, 3.3nH | Murata | 1 | L8 | 도급 | 3
25 | 1 | 00000164 | 2.2K | 2.2K, 1608, 1% |  | 1 | R1 | 사급
26 | 1 | 00000165 | 56K | 56K, 1608, 1% |  | 1 | R2 | 사급
27 | 1 | 00000166 | 330 | 330, 1608, 1% |  | 5 | R5,R6,R7,R8,R34 | 사급
28 | 1 | 00000167 | 0 | 0, 1608, 1% |  | 4 | R9,R10,R11,R12 | 도급 | 12
29 | 1 | 00000075 | 4.7K | RC0603JR-074K7, 1608, 4.7K, 5% | YAGEO | 2 | R32,R33 | 사급
30 | 1 | 00000179 | KHS22 | KHS22, 초소형SMD타입 DIP SWITCH 2극 Slide type, 2pole | KOREA OTAX | 1 | S1 | 사급
31 | 1 | 00000168 | CC2538 | RF IC, Zigbee | TI | 1 | U1 | 사급
32 | 1 | 00000169 | MAX3232CDR_SOIC | RS-232 인터페이스 IC 3-5.5V Mult-Ch RS232 | TI | 1 | U2 | 사급
33 | 1 | 00000170 | TPS73533QDRBRQ1 | LDO 전압 레귤레이터 500-mA, Low Quiescnt low noise high PSRR | TI | 1 | U3 | 사급
34 | 1 | 00000171 | 32 MHz Crystal/S3225A Crystal | S3225A, SMD Crystal 32*25*0.7 | YOKETAN CORPORATION | 1 | Y1 | 도급 | 3
35 | 1 | 00000063 | CM315D32768DZFT | Clock, 32.768KHz, SMD | CITIZEN | 1 | Y2 | 사급
