IGShare/01_WPGS/01_HW/01_WSM/02_Development/05_P3/02_Artwork/wsm_p3_완료/components_location_unit_(mm).txt

    ---------------------------------------------------------------------------
                                                                           
    * Data units = mm                            
    * TOP/BOTTOM	REFDES	PCB_x	PCB_y	ROTATION	VALUE	FOOTPRINT
   SMD_TOP	ANT1	28.500000	36.000000	0.0	ANTENNA	ANTENNA868_915MHZ
   SMD_TOP	C10	24.875000	13.875000	180.0	DNI	CC1608
   SMD_TOP	C11	21.750000	29.000000	90.0	100pF	CC1005
   SMD_TOP	C13	22.750000	29.000000	90.0	3.6pF	CC1005
   SMD_TOP	C14	30.750000	30.750000	0.0	100pF	CC1005
   SMD_TOP	C15	24.250000	27.500000	0.0	3.6pF	CC1005
   SMD_TOP	C16	23.250000	31.250000	270.0	2.7pF	CC1005
   SMD_TOP	C17	26.250000	30.250000	90.0	6.2pF	CC1005
   SMD_TOP	C18	19.250000	32.250000	270.0	12pF	CC1005
   SMD_TOP	C19	19.250000	30.250000	90.0	12pF	CC1005
   SMD_TOP	C2	16.125000	19.250000	90.0	100nF	CC1005
   SMD_TOP	C21	16.375000	16.375000	270.0	1uF	CC1608
   SMD_TOP	C22	31.250000	22.250000	180.0	DNI	CC1005
   SMD_TOP	C23	30.125000	27.500000	180.0	DNI	CC1005
   SMD_TOP	C24	17.500000	10.500000	90.0	100nF	CC1005
   SMD_TOP	C25	13.375000	26.000000	180.0	100nF	CC1005
   SMD_TOP	C26	14.500000	27.750000	180.0	100nF	CC1005
   SMD_TOP	C27	14.500000	28.750000	180.0	100nF	CC1005
   SMD_TOP	C28	8.750000	26.625000	90.0	10uF	CC1608
   SMD_TOP	C29	50.500000	14.250000	0.0	47nF	CC2012
   SMD_TOP	C3	23.500000	16.375000	90.0	100nF	CC1005
   SMD_TOP	C31	40.125000	16.000000	270.0	6.8uF	TC3216
   SMD_TOP	C32	47.250000	20.250000	90.0	200pF	CC1608
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
   SMD_TOP	R8	19.500000	10.500000	90.0	4.7K	RC1005
   SMD_TOP	S1	16.000000	3.500000	90.0	KHS-42C	KHS-42C
   SMD_TOP	TP10	34.625000	14.250000	0.0	T__POINT__S	TP_SMD
   SMD_TOP	TP11	10.125000	31.125000	0.0	T__POINT__S	TP_SMD
   SMD_TOP	TP12	13.375000	31.125000	270.0	T__POINT__S	TP_SMD
   SMD_TOP	TP9	34.750000	16.750000	0.0	T__POINT__S	TP_SMD
   SMD_TOP	U1	20.750000	22.000000	270.0	CC1310F128RGZT	QFN48_7_0_5
   SMD_TOP	U2	12.000000	28.000000	90.0	LIS3MDL	LGA-12
   SMD_TOP	U4	41.500000	22.750000	90.0	TLV342IDR	SOP8_3_9_6_1_27
   SMD_TOP	U5	9.875000	20.500000	0.0	AT24HC02C-SSHM__	SOP8_3_9_6_1_27
   SMD_TOP	U6	39.750000	5.500000	180.0	TPS73533QDRBRQ1	QFN8_3_0_65
   SMD_TOP	U7	25.000000	9.750000	0.0	S-8200ABE-M6T1U	SOT23-6P
   SMD_TOP	U8	50.250000	17.375000	0.0	SN74LVC1G04	SOT23-5P_0_95P
   SMD_TOP	Y1	17.500000	31.250000	90.0	32.768KHz__XTAL/CM315D3279DZFT	CM315
   SMD_TOP	Y2	30.500000	24.875000	90.0	24__MHz__Crystal/S3225A__Crystal	S3225A
 DIP_TOP	H1	3.000000	45.000000	0.0	PCB_HOLE	PCB-HOLE
 DIP_TOP	H2	52.000000	45.000000	0.0	PCB_HOLE	PCB-HOLE
 DIP_TOP	H3	3.000000	3.000000	0.0	PCB_HOLE	PCB-HOLE
 DIP_TOP	H4	52.000000	3.000000	0.0	PCB_HOLE	PCB-HOLE
 DIP_TOP	J1	38.750000	30.750000	0.0	RF__SMA-R-PC/DNI	RF_SMA_R_PC
 DIP_TOP	J10	48.750000	24.000000	90.0	A2001-WR03	A2001-WR03
 DIP_TOP	J11	6.250000	20.450000	270.0	A2001-WR02	A2001-WR02
 DIP_TOP	J12	6.250000	27.300000	270.0	A2001-WR02	A2001-WR02
 DIP_TOP	J13	19.500000	14.250000	270.0	1__PIN__HDR	1PIN-HDR
 DIP_TOP	J14	14.750000	14.875000	0.0	1__PIN__HDR	1PIN-HDR
 DIP_TOP	J15	13.250000	33.500000	0.0	1__PIN__HDR	1PIN-HDR
 DIP_TOP	J16	10.500000	33.500000	0.0	1__PIN__HDR	1PIN-HDR
 DIP_TOP	J17	13.500000	23.250000	0.0	1__PIN__HDR	1PIN-HDR
 DIP_TOP	J18	13.625000	21.125000	0.0	1__PIN__HDR	1PIN-HDR
 DIP_TOP	J19	13.750000	19.000000	0.0	1__PIN__HDR	1PIN-HDR
 DIP_TOP	J20	13.500000	16.875000	0.0	1__PIN__HDR	1PIN-HDR
 DIP_TOP	J21	12.250000	15.125000	0.0	1__PIN__HDR	1PIN-HDR
 DIP_TOP	J6	5.000000	34.000000	0.0	HEADER_2.54mm_3P	HEADER3
 DIP_TOP	J7	14.750000	11.500000	180.0	HEADER_2.54mm_4P/DNI	HEADER4
 DIP_TOP	TH5	36.750000	1.500000	0.0	D4V2P	1PIN-HDR
 DIP_TOP	TH6	40.750000	1.500000	0.0	GND	1PIN-HDR
 DIP_TOP	TH7	44.750000	1.500000	0.0	D3V3P	1PIN-HDR
