IGShare/01_WPGS/01_HW/02_WSCM/02_Development/01_WB/02_P0/02_Artwork/rep/기구도/assy1.dxf

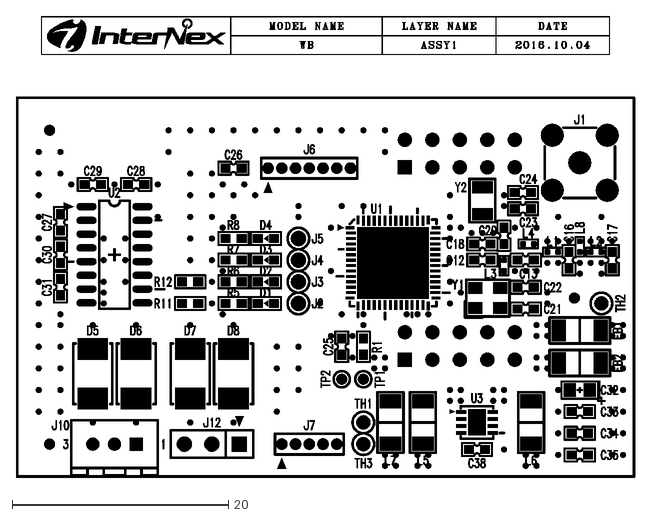
[picture p26: CAD file, 2018-02-06]
01_HW/02_WSCM/02_Development/01_WB/02_P0/02_Artwork/rep/기구도/assy1.dxf
57.2 x 42.6
