IGShare/01_WPGS/01_HW/01_WSM/02_Development/05_P3/02_Artwork/wsm_p3_완료/wsm_p3_top.dxf

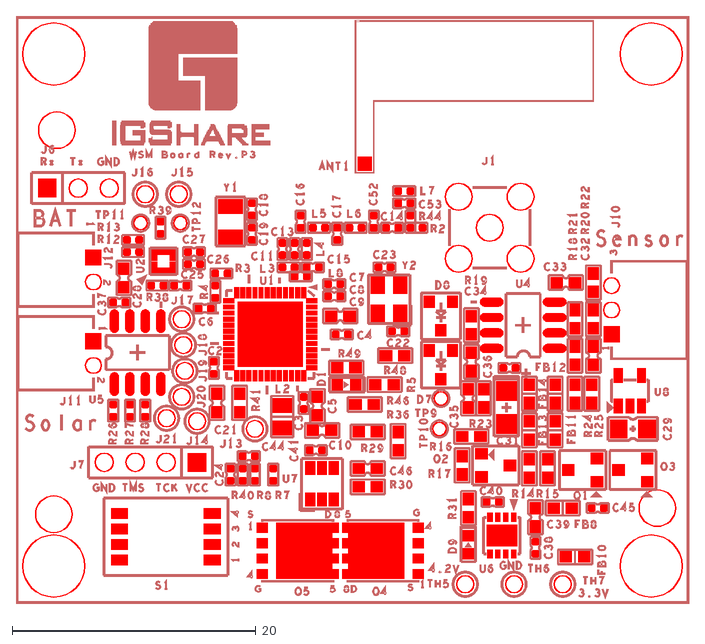
[picture p28: CAD file, 2018-02-06]
01_HW/01_WSM/02_Development/05_P3/02_Artwork/wsm_p3_완료/wsm_p3_top.dxf
55.2 x 48.2
