IGShare/01_WPGS/01_HW/02_WSCM/02_Development/01_WB/03_P1/02_Artwork/dxf/top.dxf

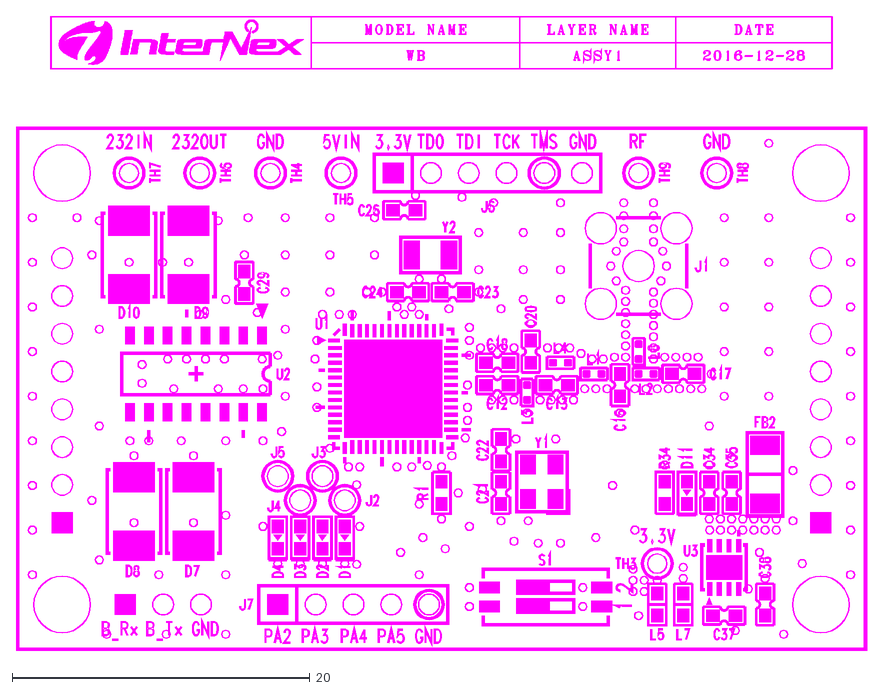
[picture p29: CAD file, 2018-02-06]
01_HW/02_WSCM/02_Development/01_WB/03_P1/02_Artwork/dxf/top.dxf
57.2 x 42.6
