IGShare/01_WPGS/01_HW/01_WSM/02_Development/03_P1/02_Artwork/dxf/top.dxf

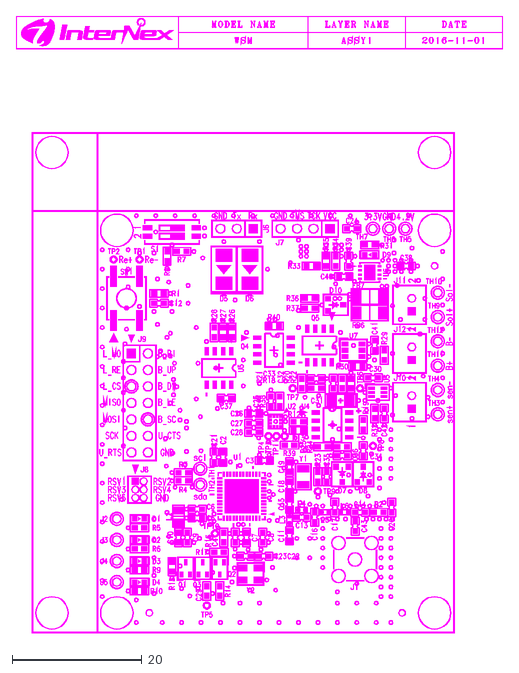
[picture p30: CAD file, 2018-02-06]
01_HW/01_WSM/02_Development/03_P1/02_Artwork/dxf/top.dxf
75.1 x 95.1
