IGShare/01_WPGS/04_MD/01_WSM/SW-1711[RF-2000].igs

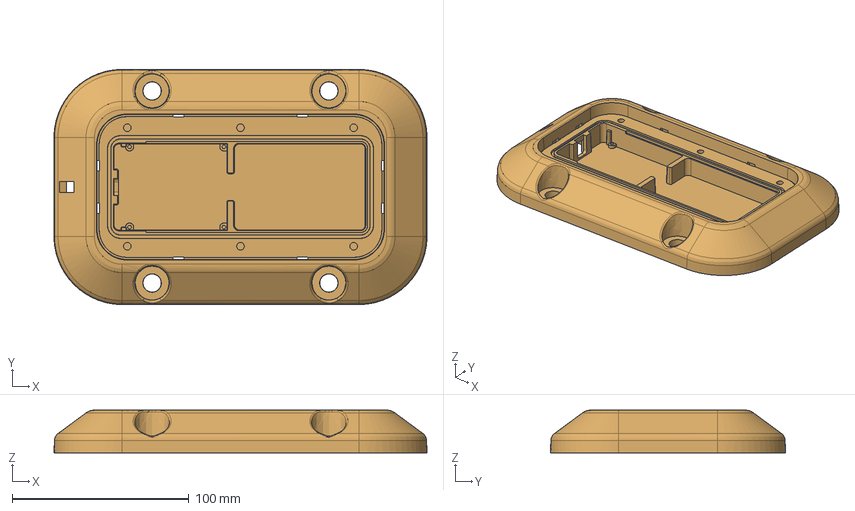
[picture p32: CAD file, 2018-02-06]
04_MD/01_WSM/SW-1711[RF-2000].igs
211.0 x 133.0 x 24.2 mm
