IGShare/01_WPGS/04_MD/01_WSM/wsm_p3_top.dxf

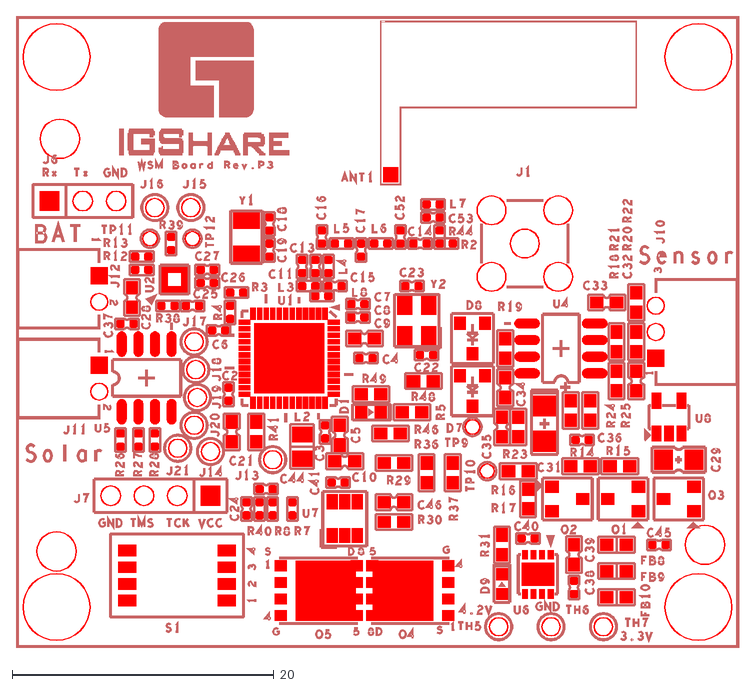
[picture p33: CAD file, 2018-02-06]
04_MD/01_WSM/wsm_p3_top.dxf
55.2 x 48.2
