IGShare/01_WPGS/04_MD/01_WSM/SW-1711[RF-2000]_2.STL

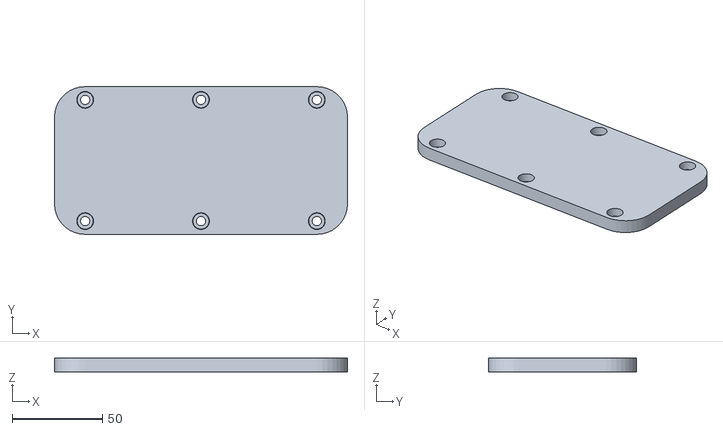
[picture p34: CAD file, 2018-02-06]
04_MD/01_WSM/SW-1711[RF-2000]_2.STL
161.9 x 81.6 x 7.70
