IGShare/01_WPGS/(list of files, cad)

Other CAD files:
02_FW/01_WSM/12_esayLinkTest_01/tirtos_builds_CC1310_LAUNCHXL_release_ccs/src/sysbios/m3_IntrinsicsSupport_asm.obj
02_FW/01_WSM/13_EasyLinkWLGM/tirtos_builds_CC1310_LAUNCHXL_release_ccs/src/sysbios/m3_Hwi_asm_switch.obj
02_FW/01_WSM/14_EasyLinkWSM/tirtos_builds_CC1310_LAUNCHXL_release_ccs/src/sysbios/m3_Hwi_asm.obj
02_FW/01_WSM/i2c_light_sensor(20171201 대충됨)/projects/iar_tirtos/src/sysbios/rom_arm_m3_IntrinsicsSupport_asm_iar_lib.obj
02_FW/01_WSM/11_RFTEST_01/tirtos_builds_CC1310_LAUNCHXL_release_ccs/src/sysbios/m3_TaskSupport_asm.obj
02_FW/01_WSM/12_esayLinkTest_01/tirtos_builds_CC1310_LAUNCHXL_release_ccs/src/sysbios/m3_Hwi_asm_switch.obj
02_FW/01_WSM/13_EasyLinkWLGM/tirtos_builds_CC1310_LAUNCHXL_release_ccs/src/sysbios/m3_IntrinsicsSupport_asm.obj
02_FW/01_WSM/14_EasyLinkWSM/tirtos_builds_CC1310_LAUNCHXL_release_ccs/src/sysbios/m3_Hwi_asm_switch.obj
02_FW/01_WSM/11_RFTEST_01/tirtos_builds_CC1310_LAUNCHXL_release_ccs/src/sysbios/m3_Hwi_asm_switch.obj
02_FW/01_WSM/12_esayLinkTest_01/tirtos_builds_CC1310_LAUNCHXL_release_ccs/src/sysbios/m3_TaskSupport_asm.obj
02_FW/01_WSM/14_EasyLinkWSM/tirtos_builds_CC1310_LAUNCHXL_release_ccs/src/sysbios/m3_IntrinsicsSupport_asm.obj
02_FW/01_WSM/i2c_light_sensor(20171201 대충됨)/projects/iar_tirtos/src/sysbios/rom_arm_m3_Hwi_asm_switch_iar_lib.obj
02_FW/01_WSM/11_RFTEST_01/tirtos_builds_CC1310_LAUNCHXL_release_ccs/src/sysbios/m3_Hwi_asm.obj
02_FW/01_WSM/12_esayLinkTest_01/tirtos_builds_CC1310_LAUNCHXL_release_ccs/src/sysbios/m3_Hwi_asm.obj
02_FW/01_WSM/13_EasyLinkWLGM/tirtos_builds_CC1310_LAUNCHXL_release_ccs/src/sysbios/m3_TaskSupport_asm.obj
02_FW/01_WSM/i2c_light_sensor(20171201 대충됨)/projects/iar_tirtos/src/sysbios/rom_arm_m3_Hwi_asm_iar_lib.obj
02_FW/01_WSM/11_RFTEST_01/tirtos_builds_CC1310_LAUNCHXL_release_ccs/src/sysbios/m3_IntrinsicsSupport_asm.obj
02_FW/01_WSM/13_EasyLinkWLGM/tirtos_builds_CC1310_LAUNCHXL_release_ccs/src/sysbios/m3_Hwi_asm.obj
02_FW/01_WSM/14_EasyLinkWSM/tirtos_builds_CC1310_LAUNCHXL_release_ccs/src/sysbios/m3_TaskSupport_asm.obj
02_FW/01_WSM/i2c_light_sensor(20171201 대충됨)/projects/iar_tirtos/src/sysbios/rom_arm_m3_TaskSupport_asm_iar_lib.obj
02_FW/01_WSM/07_CC1310_RF/rfPacketRx_CC1310DK_7XD_TI/Debug/smartrf_settings/smartrf_settings.obj
02_FW/01_WSM/11_RFTEST_01/rfPacketTx_CC1310_LAUNCHXL_tirtos_ccs/Debug/smartrf_settings/smartrf_settings.obj
02_FW/01_WSM/11_RFTEST_01/tirtos_builds_CC1310_LAUNCHXL_release_ccs/src/sysbios/rom_sysbios.obj
02_FW/01_WSM/12_esayLinkTest_01/rfEasyLinkNp_CC1310_LAUNCHXL_tirtos_ccs/Debug/at/AtControl.obj
02_FW/01_WSM/12_esayLinkTest_01/rfEasyLinkNp_CC1310_LAUNCHXL_tirtos_ccs/Debug/at/platform/tirtos/AtTerm.obj
02_FW/01_WSM/12_esayLinkTest_01/rfEasyLinkNp_CC1310_LAUNCHXL_tirtos_ccs/Debug/easylink/EasyLink.obj
02_FW/01_WSM/12_esayLinkTest_01/rfEasyLinkNp_CC1310_LAUNCHXL_tirtos_ccs/Debug/smartrf_settings/smartrf_settings.obj
04_MD/01_WSM/RF-2000 수정 도면 dwg.dwg
02_FW/01_WSM/12_esayLinkTest_01/rfEasyLinkNp_CC1310_LAUNCHXL_tirtos_ccs/Debug/at/AtProcess.obj
02_FW/01_WSM/12_esayLinkTest_01/rfEasyLinkNp_CC1310_LAUNCHXL_tirtos_ccs/Debug/smartrf_settings/smartrf_settings_predefined.obj
02_FW/01_WSM/i2c_light_sensor(20171201 대충됨)/projects/iar_tirtos/src/sysbios/rom_sysbios.obj
02_FW/01_WSM/12_esayLinkTest_01/rfEasyLinkNp_CC1310_LAUNCHXL_tirtos_ccs/Debug/at/AtParams.obj
02_FW/01_WSM/13_EasyLinkWLGM/tirtos_builds_CC1310_LAUNCHXL_release_ccs/src/sysbios/rom_sysbios.obj
04_MD/01_WSM/쎈서 도면 전송 2.dwg
02_FW/01_WSM/14_EasyLinkWSM/tirtos_builds_CC1310_LAUNCHXL_release_ccs/src/sysbios/rom_sysbios.obj
04_MD/01_WSM/dxf_RF-M 최종수정 도면 2[2852].dxf
02_FW/01_WSM/12_esayLinkTest_01/tirtos_builds_CC1310_LAUNCHXL_release_ccs/src/sysbios/rom_sysbios.obj
04_MD/01_WSM/RF 2000 바닥용 도면2.dwg
04_MD/01_WSM/RF-2000 전송 도면 dwg.dwg
04_MD/01_WSM/myEom_New_WSM_2007.dwg
04_MD/01_WSM/WSM_TOP.dwg
04_MD/01_WSM/RF-M 최종수정 도면 2[2852].dwg
04_MD/01_WSM/RF 2000 바닥용 도면.dwg
04_MD/01_WSM/P고정판 금형도면 1.dwg
04_MD/01_WSM/myEom_New_WSM.dwg
02_FW/01_WSM/07_CC1310_RF/rfPacketRx_CC1310DK_7XD_TI/src/sysbios/m3_Hwi_asm.obj
02_FW/01_WSM/07_CC1310_RF/rfPacketRx_CC1310DK_7XD_TI/src/sysbios/m3_Hwi_asm_switch.obj
02_FW/01_WSM/07_CC1310_RF/rfPacketRx_CC1310DK_7XD_TI/src/sysbios/m3_IntrinsicsSupport_asm.obj
02_FW/01_WSM/07_CC1310_RF/rfPacketRx_CC1310DK_7XD_TI/src/sysbios/m3_TaskSupport_asm.obj
02_FW/01_WSM/07_CC1310_RF/rfPacketRx_CC1310DK_7XD_TI/src/sysbios/rom_sysbios.obj
04_MD/01_WSM/SW-1711[RF-2000].STL
