IGShare/01_WPGS/03_SW/03_UARTTest/UARTDebug/Debug/BuildLog.htm

빌드 로그

| | 빌드 시작: 프로젝트: UARTDebug, 구성: Debug|Win32

명령줄

"rc.exe /d "_DEBUG" /d "_AFXDLL" /l 0x412 /I "Debug" /fo"Debug/UARTDebug.res" .\UARTDebug.rc" 명령줄을 만들고 있습니다.
다음 내용이 포함된 "e:\igs_svn_data\PROJECT_01\03_SW\03_UARTTest\UARTDebug\Debug\RSP000001159529792.rsp" 임시 파일을 만들고 있습니다.
[
/OUT:"E:\igs_svn_data\PROJECT_01\03_SW\03_UARTTest\UARTDebug\Debug\UARTDebug.exe" /INCREMENTAL /MANIFEST /MANIFESTFILE:"Debug\UARTDebug.exe.intermediate.manifest" /MANIFESTUAC:"level='asInvoker' uiAccess='false'" /DEBUG /PDB:"e:\igs_svn_data\PROJECT_01\03_SW\03_UARTTest\UARTDebug\Debug\UARTDebug.pdb" /SUBSYSTEM:WINDOWS /DYNAMICBASE /NXCOMPAT /MACHINE:X86 ".\Debug\Comm.obj"

".\Debug\stdafx.obj"

".\Debug\UARTDebug.obj"

".\Debug\UARTDebugDlg.obj"

".\Debug\UARTDebug.res"

".\Debug\UARTDebug.exe.embed.manifest.res"
]
"link.exe @e:\igs_svn_data\PROJECT_01\03_SW\03_UARTTest\UARTDebug\Debug\RSP000001159529792.rsp /NOLOGO /ERRORREPORT:PROMPT" 명령줄을 만들고 있습니다.
다음 내용이 포함된 "e:\igs_svn_data\PROJECT_01\03_SW\03_UARTTest\UARTDebug\Debug\RSP000002159529792.rsp" 임시 파일을 만들고 있습니다.
[
/out:.\Debug\UARTDebug.exe.embed.manifest /notify_update /manifest

.\Debug\UARTDebug.exe.intermediate.manifest
]
"mt.exe @e:\igs_svn_data\PROJECT_01\03_SW\03_UARTTest\UARTDebug\Debug\RSP000002159529792.rsp /nologo" 명령줄을 만들고 있습니다.
다음 내용이 포함된 "e:\igs_svn_data\PROJECT_01\03_SW\03_UARTTest\UARTDebug\Debug\BAT000003159529792.bat" 임시 파일을 만들고 있습니다.
[
@echo 매니페스트 리소스 최종 업데이트: %TIME%(%DATE%) > .\Debug\mt.dep
]
"e:\igs_svn_data\PROJECT_01\03_SW\03_UARTTest\UARTDebug\Debug\BAT000003159529792.bat" 명령줄을 만들고 있습니다.

출력 창

| | 리소스를 컴파일하고 있습니다... Microsoft (R) Windows (R) Resource Compiler Version 6.1.6723.1 Copyright (C) Microsoft Corporation. All rights reserved. 링크하고 있습니다... 매니페스트를 포함하고 있습니다...

결과

| | 빌드 로그가 "file://e:\igs_svn_data\PROJECT_01\03_SW\03_UARTTest\UARTDebug\Debug\BuildLog.htm"에 저장되었습니다. UARTDebug - 오류: 0개, 경고: 0개
