IGShare/01_WPGS/03_SW/01_FWDownLoader/FWDownLoader/Debug/BuildLog.htm

빌드 로그

| | 빌드 시작: 프로젝트: FWDownLoader, 구성: Debug|Win32

명령줄

다음 내용이 포함된 "d:\igs_svn_data\PROJECT_01\03_SW\01_FWDownLoader\FWDownLoader\Debug\RSP00000180244980.rsp" 임시 파일을 만들고 있습니다.
[
/Od /D "WIN32" /D "_WINDOWS" /D "_DEBUG" /D "_AFXDLL" /D "_MBCS" /Gm /EHsc /RTC1 /MDd /Yu"stdafx.h" /Fp"Debug\FWDownLoader.pch" /Fo"Debug\\" /Fd"Debug\vc90.pdb" /W3 /c /ZI /TP .\FWDownLoaderDlg.cpp

.\FWDownLoader.cpp

.\Comm.cpp
]
"cl.exe @d:\igs_svn_data\PROJECT_01\03_SW\01_FWDownLoader\FWDownLoader\Debug\RSP00000180244980.rsp /nologo /errorReport:prompt" 명령줄을 만들고 있습니다.
다음 내용이 포함된 "d:\igs_svn_data\PROJECT_01\03_SW\01_FWDownLoader\FWDownLoader\Debug\RSP00000280244980.rsp" 임시 파일을 만들고 있습니다.
[
/Od /D "WIN32" /D "_WINDOWS" /D "_DEBUG" /D "_AFXDLL" /D "_MBCS" /Gm /EHsc /RTC1 /MDd /Yc"stdafx.h" /Fp"Debug\FWDownLoader.pch" /Fo"Debug\\" /Fd"Debug\vc90.pdb" /W3 /c /ZI /TP .\stdafx.cpp
]
"cl.exe @d:\igs_svn_data\PROJECT_01\03_SW\01_FWDownLoader\FWDownLoader\Debug\RSP00000280244980.rsp /nologo /errorReport:prompt" 명령줄을 만들고 있습니다.
"rc.exe /d "_DEBUG" /d "_AFXDLL" /l 0x412 /I "Debug" /fo"Debug/FWDownLoader.res" .\FWDownLoader.rc" 명령줄을 만들고 있습니다.
다음 내용이 포함된 "d:\igs_svn_data\PROJECT_01\03_SW\01_FWDownLoader\FWDownLoader\Debug\TMP00000380244980.tmp" 임시 파일을 만들고 있습니다.
[
1 /* CREATEPROCESS_MANIFEST_RESOURCE_ID */ 24 /* RT_MANIFEST */ ".\\Debug\\FWDownLoader.exe.embed.manifest"
]
"rc.exe /fo".\Debug\FWDownLoader.exe.embed.manifest.res" d:\igs_svn_data\PROJECT_01\03_SW\01_FWDownLoader\FWDownLoader\Debug\TMP00000380244980.tmp" 명령줄을 만들고 있습니다.
다음 내용이 포함된 "d:\igs_svn_data\PROJECT_01\03_SW\01_FWDownLoader\FWDownLoader\Debug\RSP00000480244980.rsp" 임시 파일을 만들고 있습니다.
[
/OUT:"D:\igs_svn_data\PROJECT_01\03_SW\01_FWDownLoader\FWDownLoader\Debug\FWDownLoader.exe" /INCREMENTAL /MANIFEST /MANIFESTFILE:"Debug\FWDownLoader.exe.intermediate.manifest" /MANIFESTUAC:"level='asInvoker' uiAccess='false'" /DEBUG /PDB:"d:\igs_svn_data\PROJECT_01\03_SW\01_FWDownLoader\FWDownLoader\Debug\FWDownLoader.pdb" /SUBSYSTEM:WINDOWS /DYNAMICBASE /NXCOMPAT /MACHINE:X86 ".\Debug\Comm.obj"

".\Debug\FWDownLoader.obj"

".\Debug\FWDownLoaderDlg.obj"

".\Debug\stdafx.obj"

".\Debug\FWDownLoader.res"

".\Debug\FWDownLoader.exe.embed.manifest.res"
]
"link.exe @d:\igs_svn_data\PROJECT_01\03_SW\01_FWDownLoader\FWDownLoader\Debug\RSP00000480244980.rsp /NOLOGO /ERRORREPORT:PROMPT" 명령줄을 만들고 있습니다.
다음 내용이 포함된 "d:\igs_svn_data\PROJECT_01\03_SW\01_FWDownLoader\FWDownLoader\Debug\RSP00000580244980.rsp" 임시 파일을 만들고 있습니다.
[
/out:.\Debug\FWDownLoader.exe.embed.manifest /notify_update /manifest

.\Debug\FWDownLoader.exe.intermediate.manifest
]
"mt.exe @d:\igs_svn_data\PROJECT_01\03_SW\01_FWDownLoader\FWDownLoader\Debug\RSP00000580244980.rsp /nologo" 명령줄을 만들고 있습니다.
다음 내용이 포함된 "d:\igs_svn_data\PROJECT_01\03_SW\01_FWDownLoader\FWDownLoader\Debug\BAT00000680244980.bat" 임시 파일을 만들고 있습니다.
[
@echo 매니페스트 리소스 최종 업데이트: %TIME%(%DATE%) > .\Debug\mt.dep
]
"d:\igs_svn_data\PROJECT_01\03_SW\01_FWDownLoader\FWDownLoader\Debug\BAT00000680244980.bat" 명령줄을 만들고 있습니다.

출력 창

컴파일하고 있습니다...
stdafx.cpp
컴파일하고 있습니다...
Comm.cpp
FWDownLoader.cpp
FWDownLoaderDlg.cpp
d:\igs_svn_data\project_01\03_sw\01_fwdownloader\fwdownloader\fwdownloaderdlg.cpp(203) : warning C4101: 'temp' :참조되지 않은 지역 변수입니다.
코드를 생성하고 있습니다...
리소스를 컴파일하고 있습니다...
Microsoft (R) Windows (R) Resource Compiler Version 6.1.6723.1
Copyright (C) Microsoft Corporation. All rights reserved.
매니페스트를 리소스에 컴파일하고 있습니다...
Microsoft (R) Windows (R) Resource Compiler Version 6.1.6723.1
Copyright (C) Microsoft Corporation. All rights reserved.
링크하고 있습니다...
LINK : D:\igs_svn_data\PROJECT_01\03_SW\01_FWDownLoader\FWDownLoader\Debug\FWDownLoader.exe을(를) 찾을 수 없거나 마지막 증분 링크에 의해 빌드되지 않았습니다. 전체 링크를 수행하고 있습니다.
매니페스트를 포함하고 있습니다...

결과

| | 빌드 로그가 "file://d:\igs_svn_data\PROJECT_01\03_SW\01_FWDownLoader\FWDownLoader\Debug\BuildLog.htm"에 저장되었습니다. FWDownLoader - 오류: 0개, 경고: 1개
