IGShare/01_WPGS/03_SW/04_DebugTool/01_WSMDebugTool/Debug/BuildLog.htm

빌드 로그

| | 빌드 시작: 프로젝트: 01_WSMDebugTool, 구성: Debug|Win32

명령줄

다음 내용이 포함된 "e:\igs_svn_data\PROJECT_01\03_SW\04_DebugTool\01_WSMDebugTool\Debug\RSP0000071451618752.rsp" 임시 파일을 만들고 있습니다.
[
/Od /D "WIN32" /D "_WINDOWS" /D "_DEBUG" /D "_AFXDLL" /D "_MBCS" /Gm /EHsc /RTC1 /MDd /Fo"Debug\\" /Fd"Debug\vc90.pdb" /W3 /c /ZI /TP .\01_WSMDebugToolDlg.cpp
]
"cl.exe @e:\igs_svn_data\PROJECT_01\03_SW\04_DebugTool\01_WSMDebugTool\Debug\RSP0000071451618752.rsp /nologo /errorReport:prompt" 명령줄을 만들고 있습니다.
다음 내용이 포함된 "e:\igs_svn_data\PROJECT_01\03_SW\04_DebugTool\01_WSMDebugTool\Debug\RSP0000081451618752.rsp" 임시 파일을 만들고 있습니다.
[
/OUT:"E:\igs_svn_data\PROJECT_01\03_SW\04_DebugTool\01_WSMDebugTool\Debug\01_WSMDebugTool.exe" /INCREMENTAL /MANIFEST /MANIFESTFILE:"Debug\01_WSMDebugTool.exe.intermediate.manifest" /MANIFESTUAC:"level='asInvoker' uiAccess='false'" /DEBUG /PDB:"e:\igs_svn_data\PROJECT_01\03_SW\04_DebugTool\01_WSMDebugTool\Debug\01_WSMDebugTool.pdb" /SUBSYSTEM:WINDOWS /DYNAMICBASE /NXCOMPAT /MACHINE:X86 ".\Debug\01_WSMDebugTool.obj"

".\Debug\01_WSMDebugToolDlg.obj"

".\Debug\Comm.obj"

".\Debug\stdafx.obj"

".\Debug\01_WSMDebugTool.res"

".\Debug\01_WSMDebugTool.exe.embed.manifest.res"
]
"link.exe @e:\igs_svn_data\PROJECT_01\03_SW\04_DebugTool\01_WSMDebugTool\Debug\RSP0000081451618752.rsp /NOLOGO /ERRORREPORT:PROMPT" 명령줄을 만들고 있습니다.
다음 내용이 포함된 "e:\igs_svn_data\PROJECT_01\03_SW\04_DebugTool\01_WSMDebugTool\Debug\RSP0000091451618752.rsp" 임시 파일을 만들고 있습니다.
[
/out:.\Debug\01_WSMDebugTool.exe.embed.manifest /notify_update /manifest

.\Debug\01_WSMDebugTool.exe.intermediate.manifest
]
"mt.exe @e:\igs_svn_data\PROJECT_01\03_SW\04_DebugTool\01_WSMDebugTool\Debug\RSP0000091451618752.rsp /nologo" 명령줄을 만들고 있습니다.
다음 내용이 포함된 "e:\igs_svn_data\PROJECT_01\03_SW\04_DebugTool\01_WSMDebugTool\Debug\BAT00000A1451618752.bat" 임시 파일을 만들고 있습니다.
[
@echo 매니페스트 리소스 최종 업데이트: %TIME%(%DATE%) > .\Debug\mt.dep
]
"e:\igs_svn_data\PROJECT_01\03_SW\04_DebugTool\01_WSMDebugTool\Debug\BAT00000A1451618752.bat" 명령줄을 만들고 있습니다.

출력 창

컴파일하고 있습니다...
01_WSMDebugToolDlg.cpp
e:\igs_svn_data\project_01\03_sw\04_debugtool\01_wsmdebugtool\01_wsmdebugtooldlg.cpp(427) : warning C4805: '==' : 연산에 'bool' 형식과 'int' 형식을 함께 사용하는 것은 안전하지 않습니다.
e:\igs_svn_data\project_01\03_sw\04_debugtool\01_wsmdebugtool\01_wsmdebugtooldlg.cpp(612) : warning C4996: 'fopen': This function or variable may be unsafe. Consider using fopen_s instead. To disable deprecation, use _CRT_SECURE_NO_WARNINGS. See online help for details.
c:\program files (x86)\microsoft visual studio 9.0\vc\include\stdio.h(237) : 'fopen' 선언을 참조하십시오.
e:\igs_svn_data\project_01\03_sw\04_debugtool\01_wsmdebugtool\01_wsmdebugtooldlg.cpp(614) : warning C4996: 'fopen': This function or variable may be unsafe. Consider using fopen_s instead. To disable deprecation, use _CRT_SECURE_NO_WARNINGS. See online help for details.
c:\program files (x86)\microsoft visual studio 9.0\vc\include\stdio.h(237) : 'fopen' 선언을 참조하십시오.
링크하고 있습니다...
매니페스트를 포함하고 있습니다...

결과

| | 빌드 로그가 "file://e:\igs_svn_data\PROJECT_01\03_SW\04_DebugTool\01_WSMDebugTool\Debug\BuildLog.htm"에 저장되었습니다. 01_WSMDebugTool - 오류: 0개, 경고: 3개
