IGShare/01_WPGS/03_SW/04_DebugTool/01_WSMDebugTool/Data/Image/10_ultrasound_normal.png

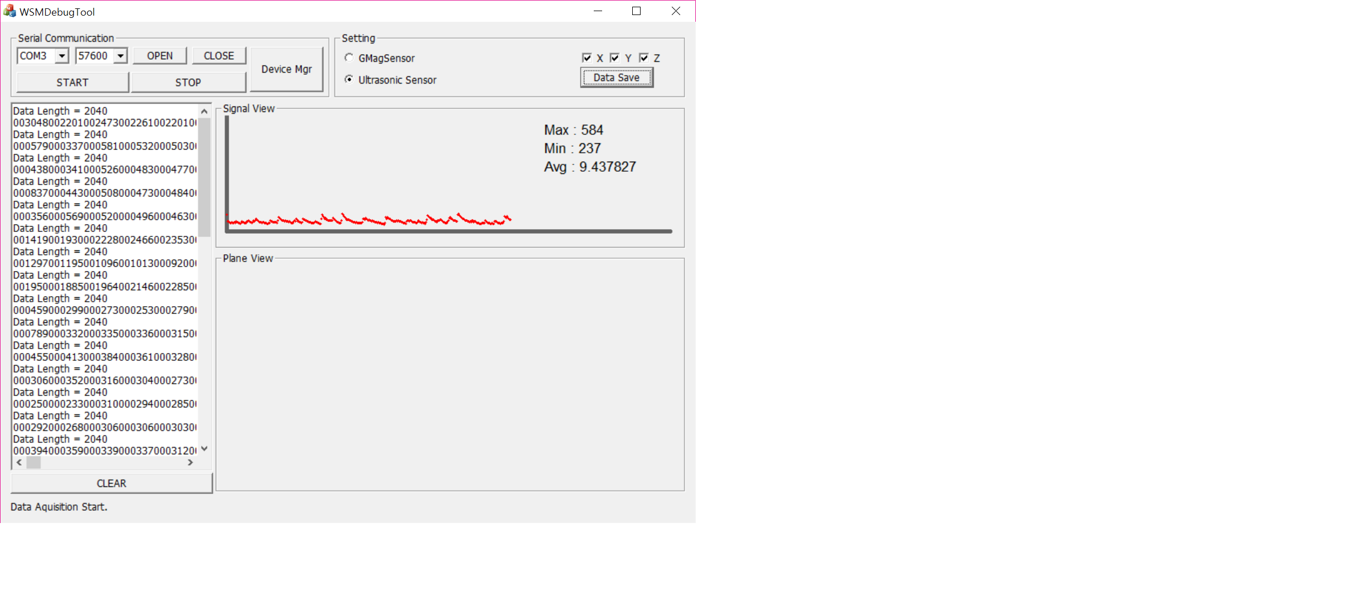
03_SW/04_DebugTool/01_WSMDebugTool/Data/Image/10_ultrasound_normal.png
