IGShare/01_WPGS/03_SW/04_DebugTool/01_WSMDebugTool/Data/Image/14_GMS_OFFSET_YZ.png

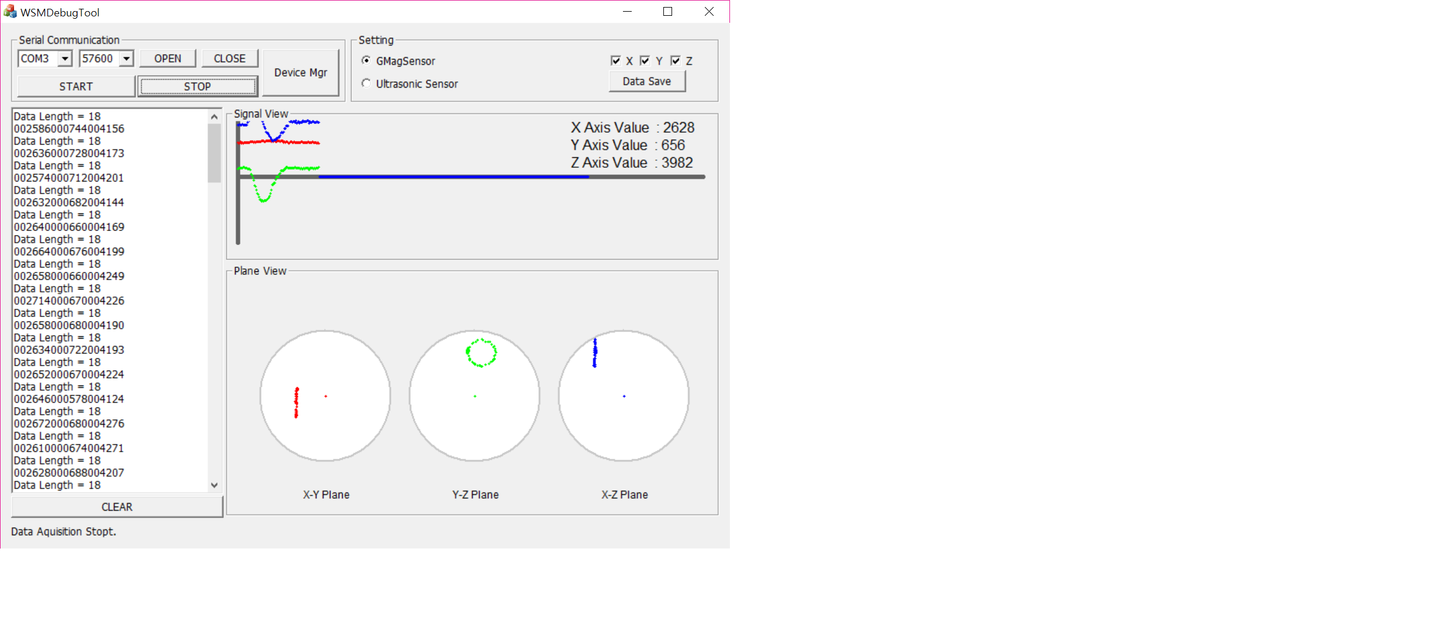
03_SW/04_DebugTool/01_WSMDebugTool/Data/Image/14_GMS_OFFSET_YZ.png
