IGShare/01_WPGS/03_SW/04_DebugTool/01_WSMDebugTool/Data/Image/벡터 양자화.jpg

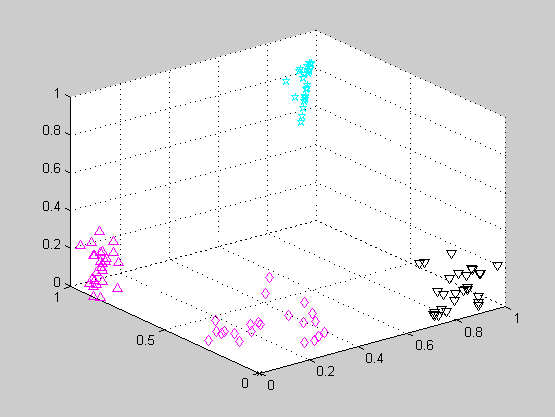
03_SW/04_DebugTool/01_WSMDebugTool/Data/Image/벡터 양자화.jpg
