IGShare/01_WPGS/01_HW/02_WSCM/02_Development/01_WB/01_EVKit/01_CC2538/Schematic/CC2538EM_schematic_1_2_0.pdf

# USB interface Power supply

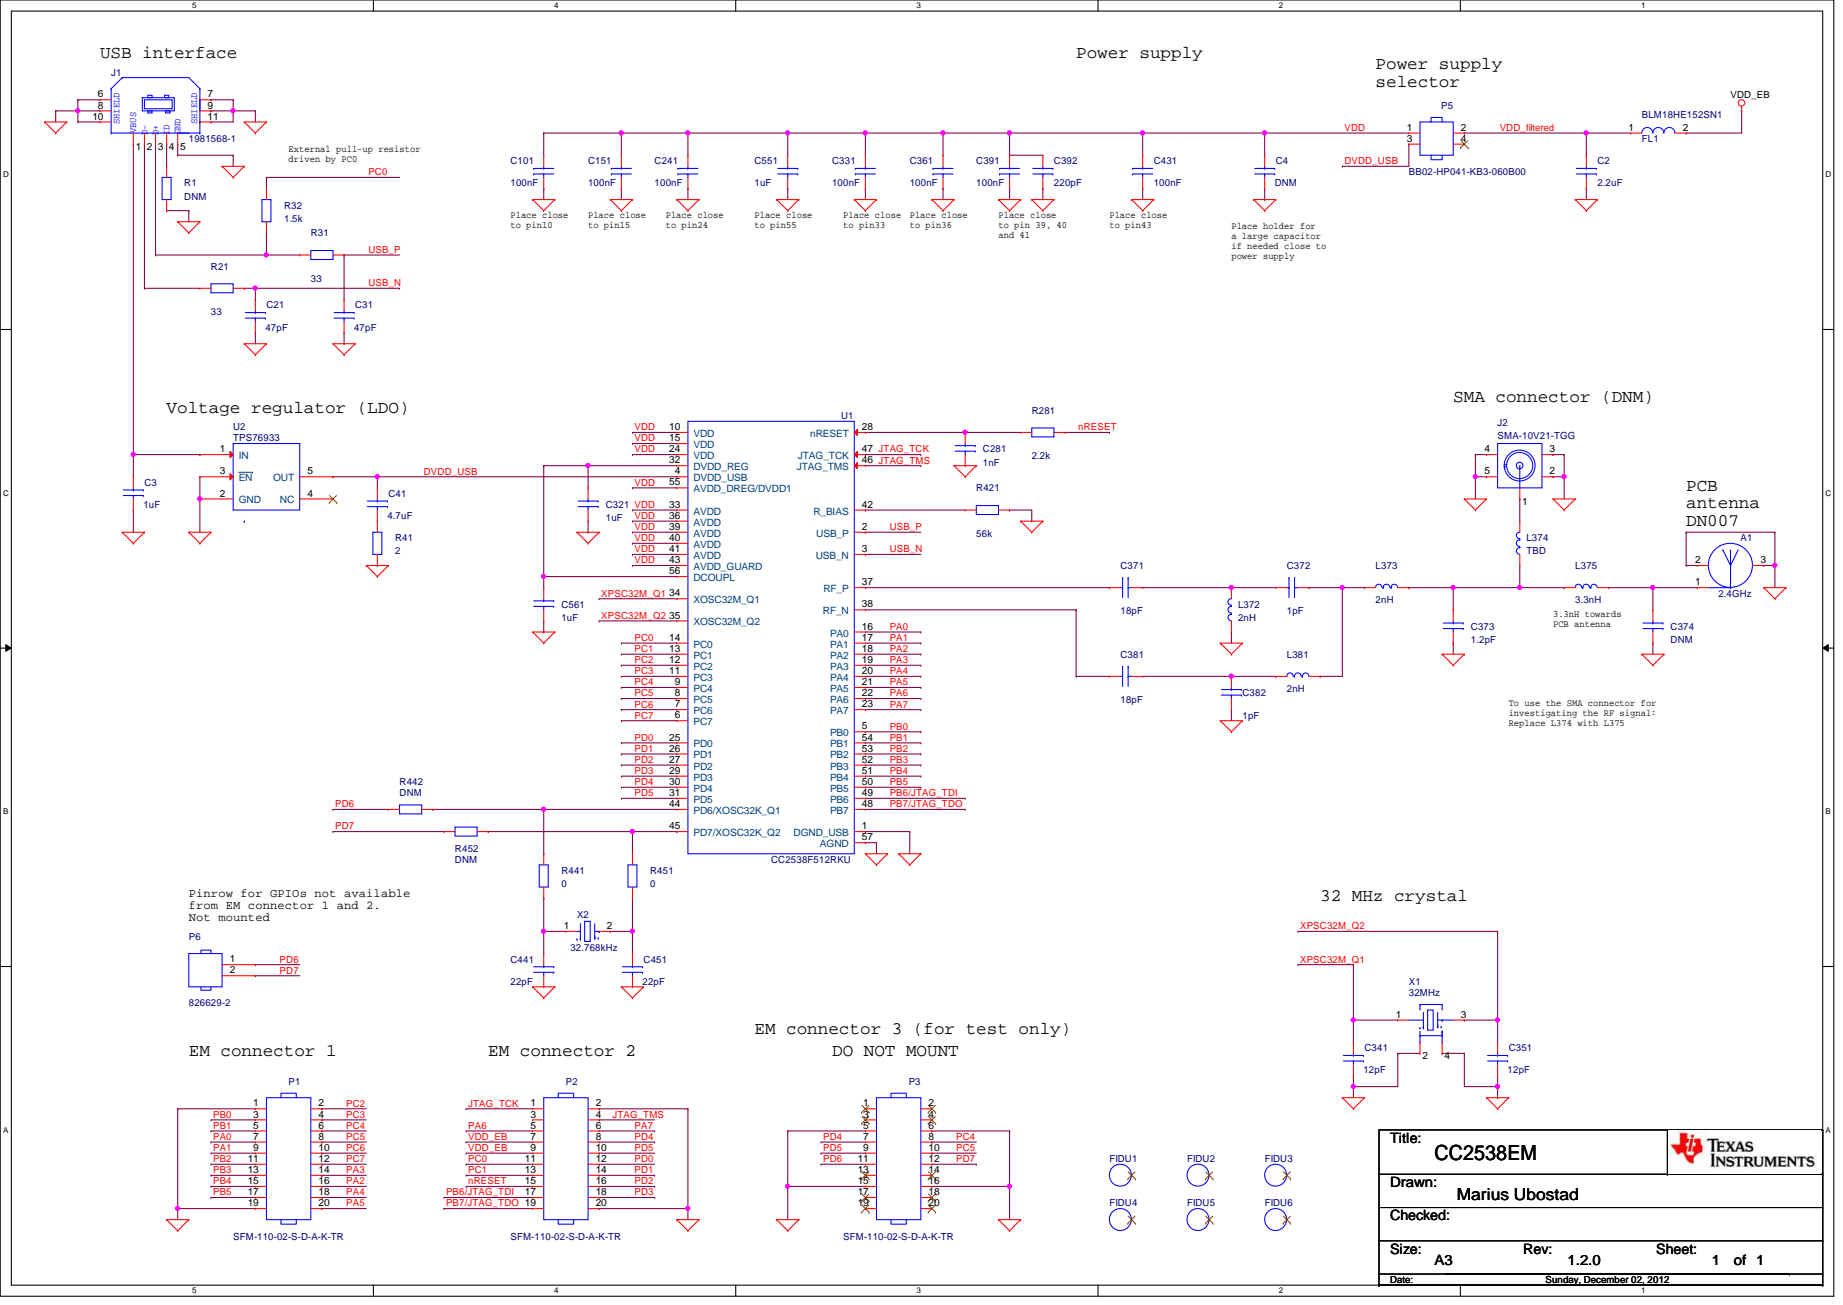
[picture p48: page 1]

External pull-up resistor
driven by PC0

Place holder for
a large capacitor
if needed close to
power supply

To use the SMA connector for
investigating the RF signal:
Replace L374 with L375

Pinrow for GPIOs not available
from EM connector 1 and 2.
Not mounted

EM connector 3 (for test only)
