IGShare/01_WPGS/01_HW/01_WSM/02_Development/02_P0/01_Circuit/igshare_wsm_16_2v_p0.pdf

# WSM Board by IGS_Version P0

# Initial drawing

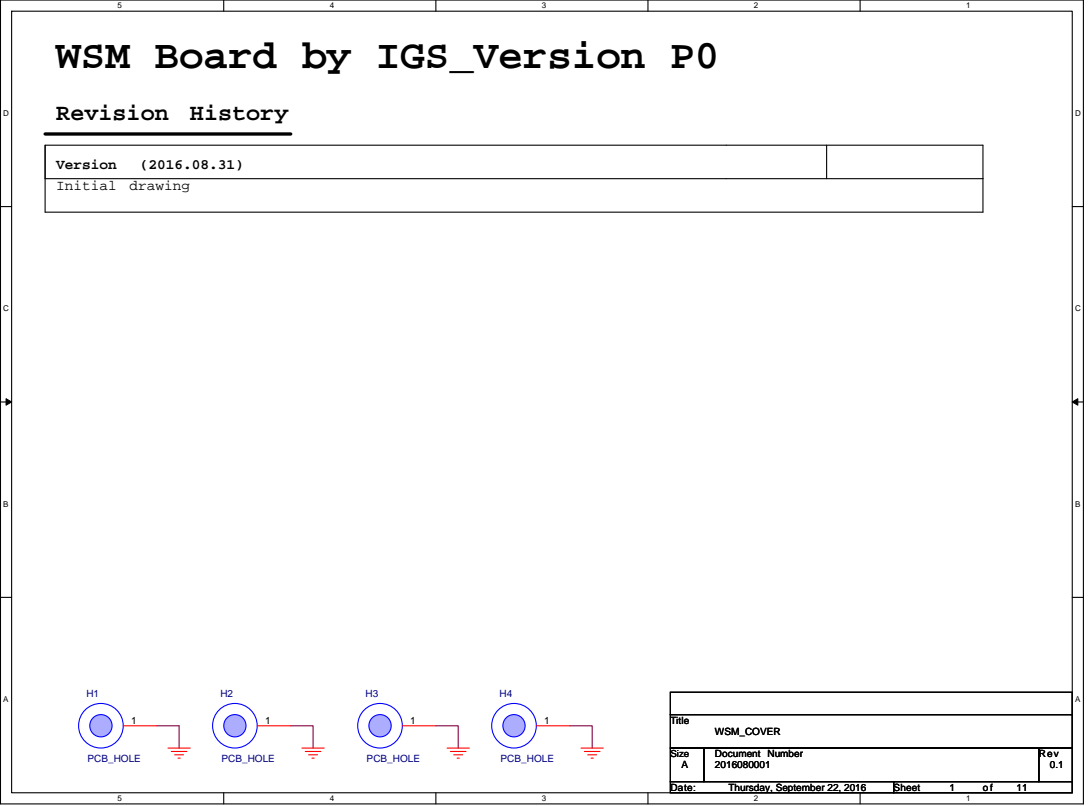
[picture p49: page 1]
Revision History; Version; Title; WSM_COVER; PCB_HOLE

Size A A A | Document Number 2016080001 | Rev 0.1

Date: Thursday, September 22, 2016 Thursday, September 22, 2016 Thursday, September 22, 2016 | Sheet 1 1 1 of 11 11 11

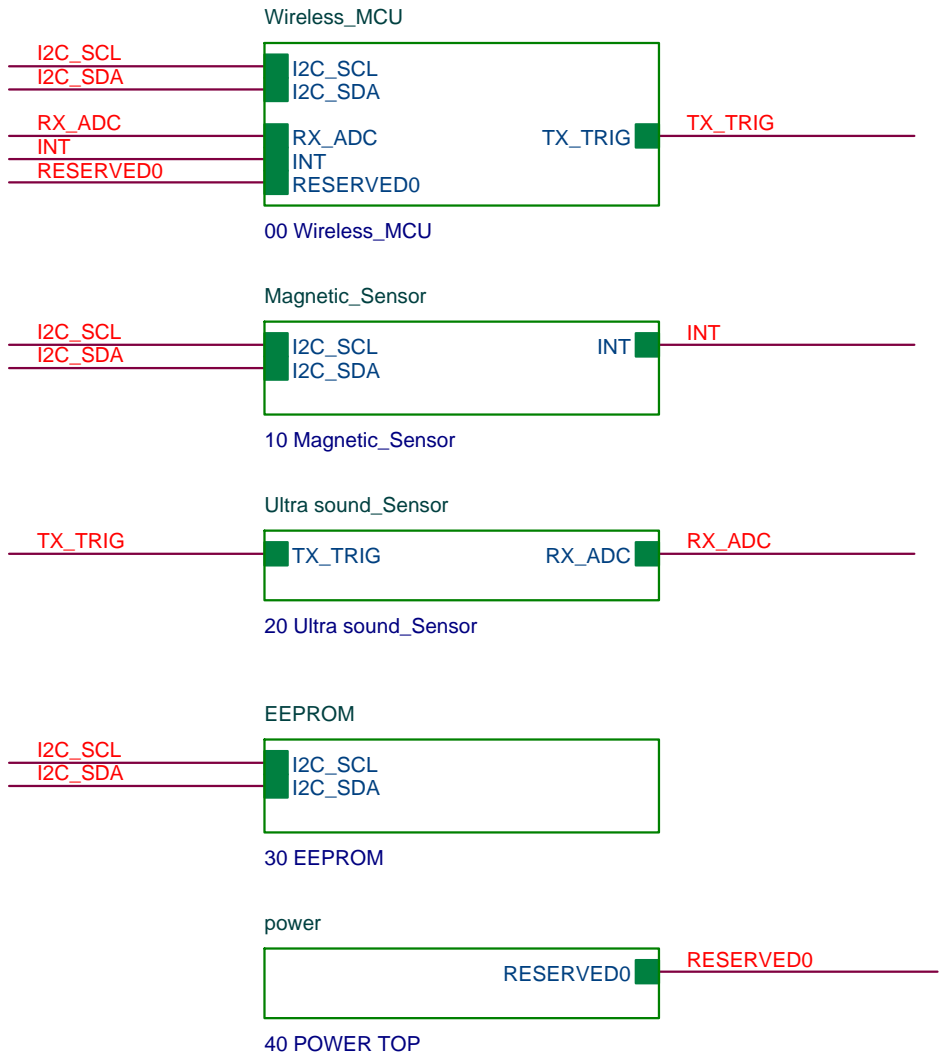
[picture p50: page 2]
I2C_SCL I2C_SDA; TX_TRIG; RX_ADC; INT; RESERVED0; INT RESERVED0; Title; WSM_TOP; EEPROM; 30 EEPROM; Wireless_MCU; 00 Wireless_MCU; I2C_SDA; I2C_SCL; Magnetic_Sensor; 10 Magnetic_Sensor; power; 40 POWER TOP; Ultra sound_Sensor; 20 Ultra sound_Sensor

Thursday, September 22, 2016 Thursday, September 22, 2016 Thursday, September 22, 2016 | 2 2 2 11 11 11

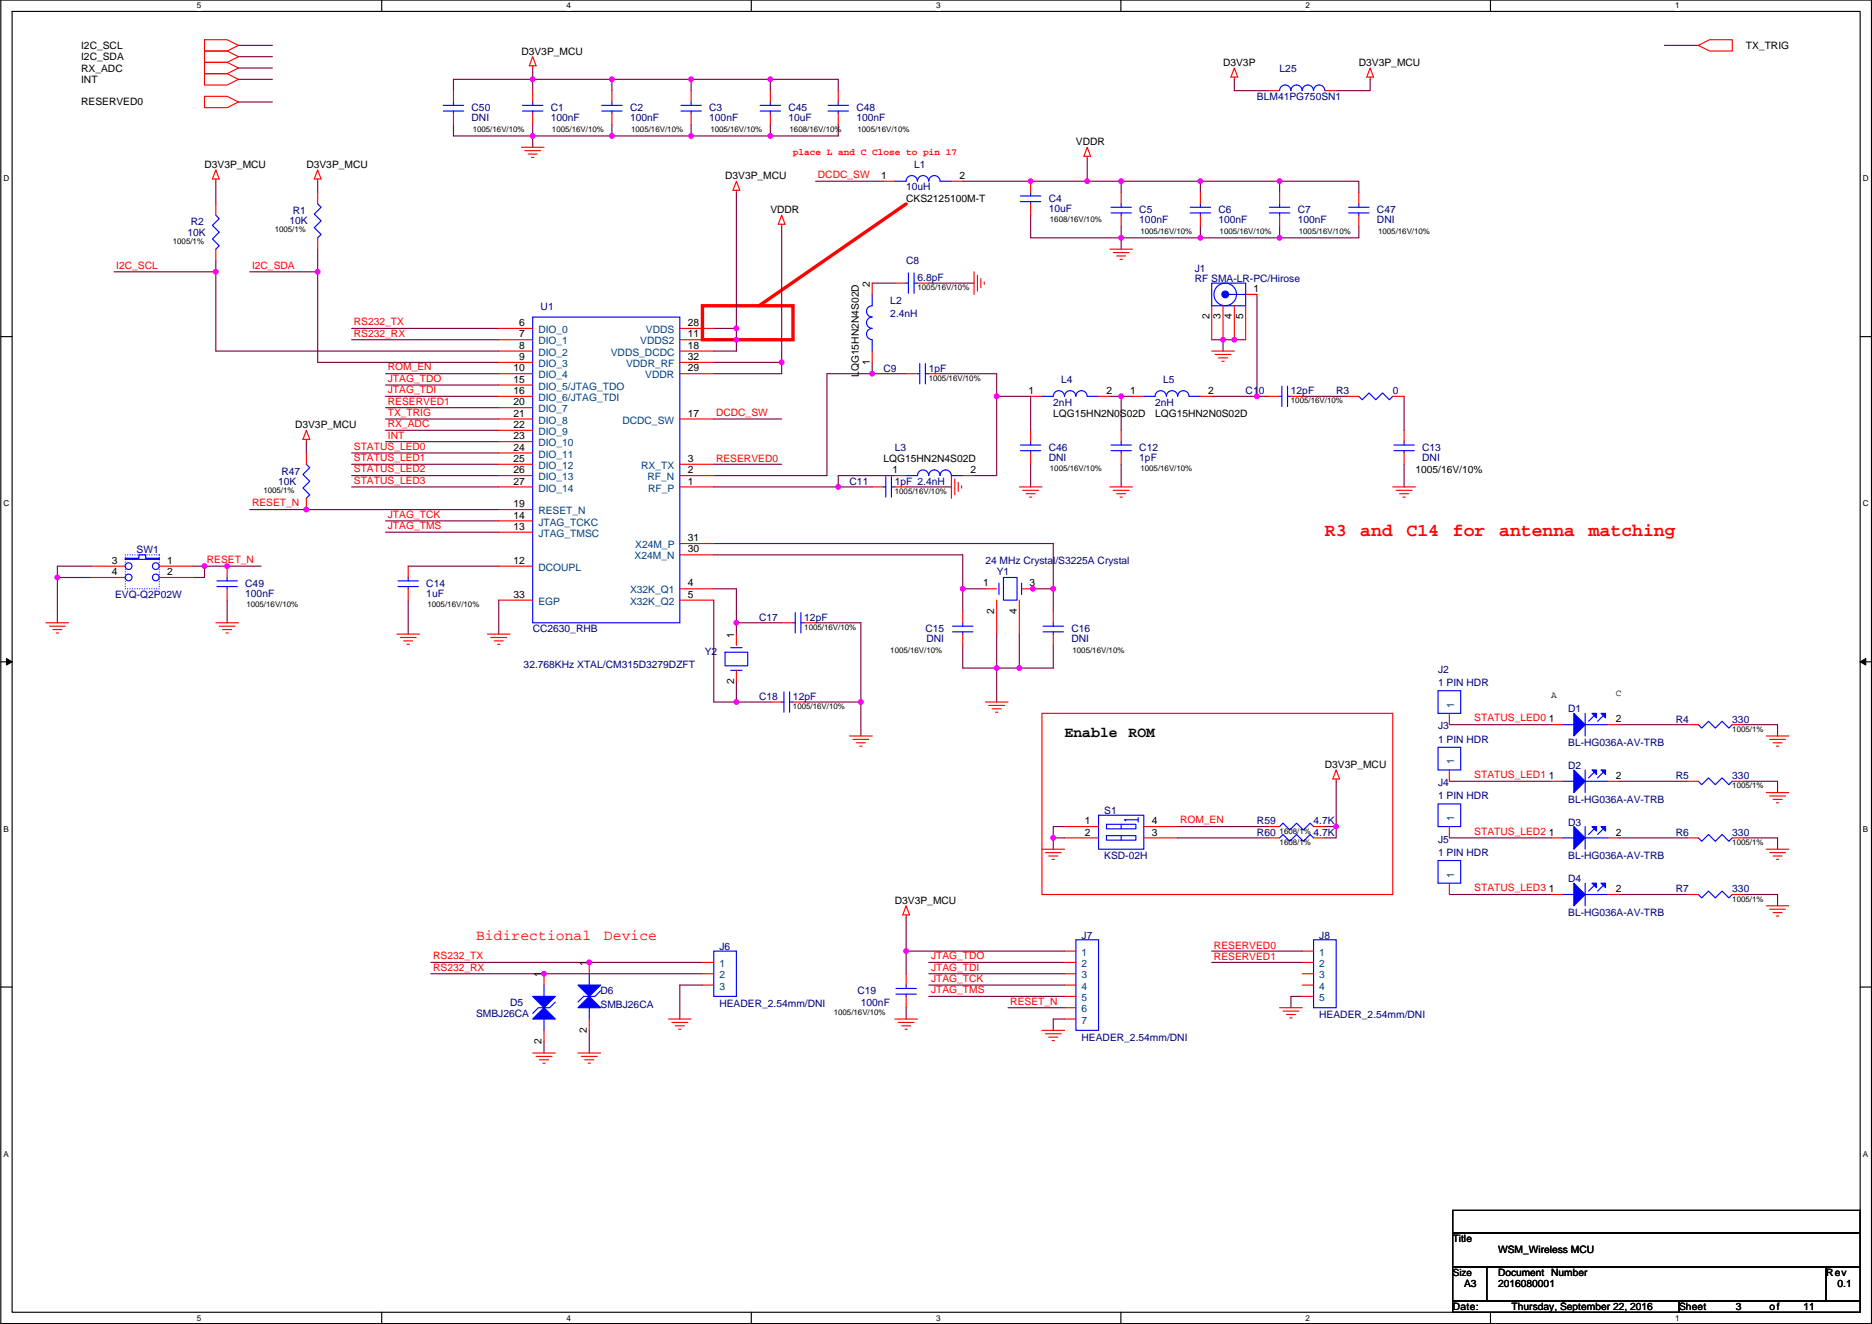
[picture p51: page 3]

place L and C Close to pin 17

RF SMA-LR-PC/Hirose

R3 and C14 for antenna matching

Thursday, September 22, 2016 Thursday, September 22, 2016 Thursday, September 22, 2016 | 3 3 3 11 11 11

I2C

## High=able/Low=Disable

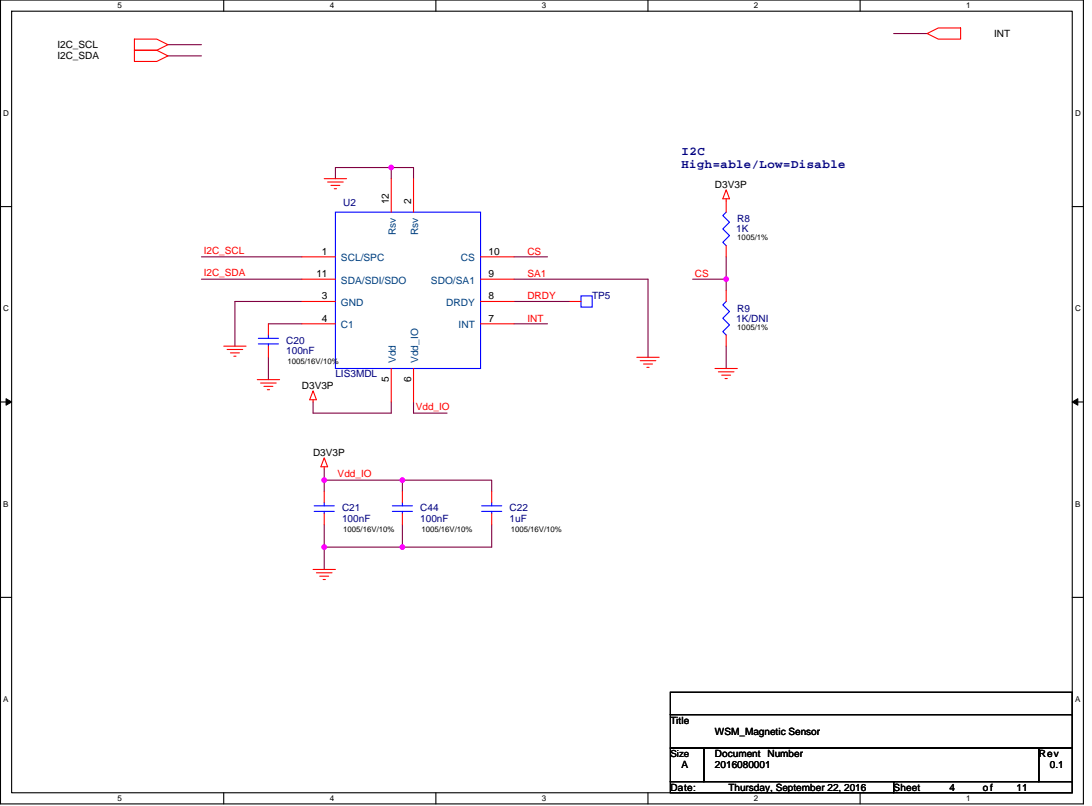
[picture p52: page 4]

Thursday, September 22, 2016 Thursday, September 22, 2016 Thursday, September 22, 2016 | 4 4 4 11 11 11

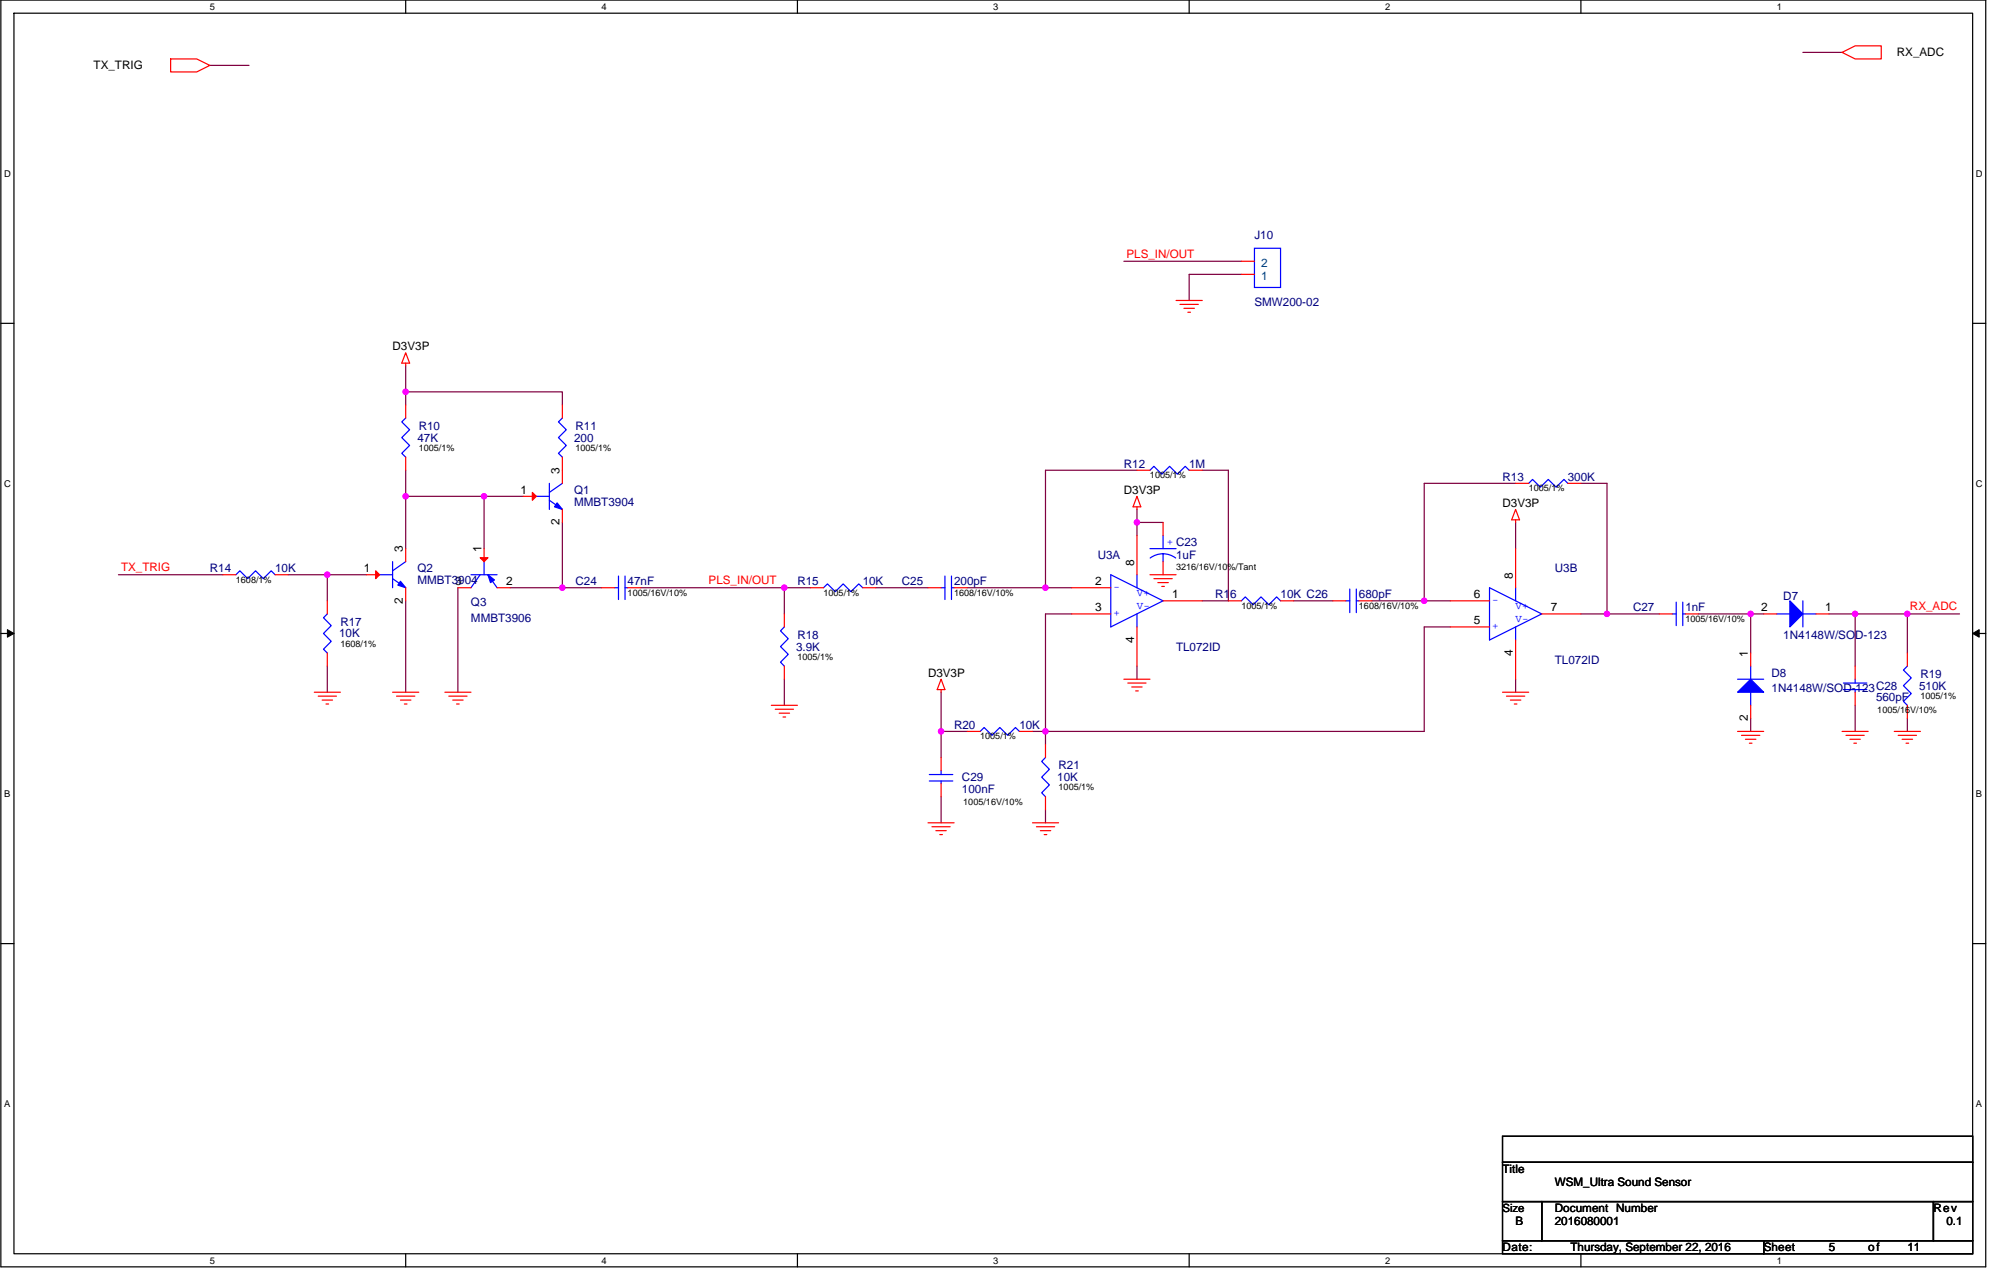
[picture p53: page 5]

Size Size Size B B B | Document Number Document Number Document Number 2016080001 2016080001 2016080001 | Rev Rev Rev 0.1 0.1 0.1

Date: Date: Date: Thursday, September 22, 2016 Thursday, September 22, 2016 Thursday, September 22, 2016 | Sheet Sheet Sheet 5 5 5 of of of 11 11 11

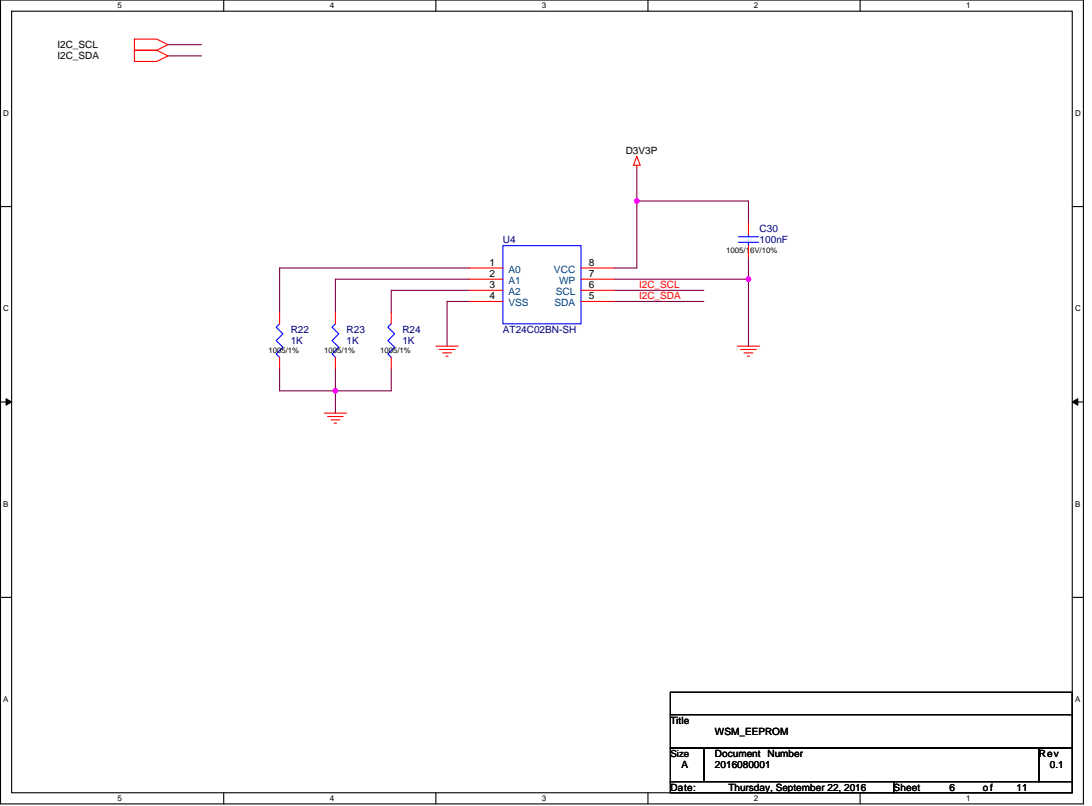
[picture p54: page 6]
I2C_SCL I2C_SDA; Title; WSM_EEPROM; VSS 4; SDA; 5 SCL; 67 VCC

Thursday, September 22, 2016 Thursday, September 22, 2016 Thursday, September 22, 2016 | 6 6 6 11 11 11

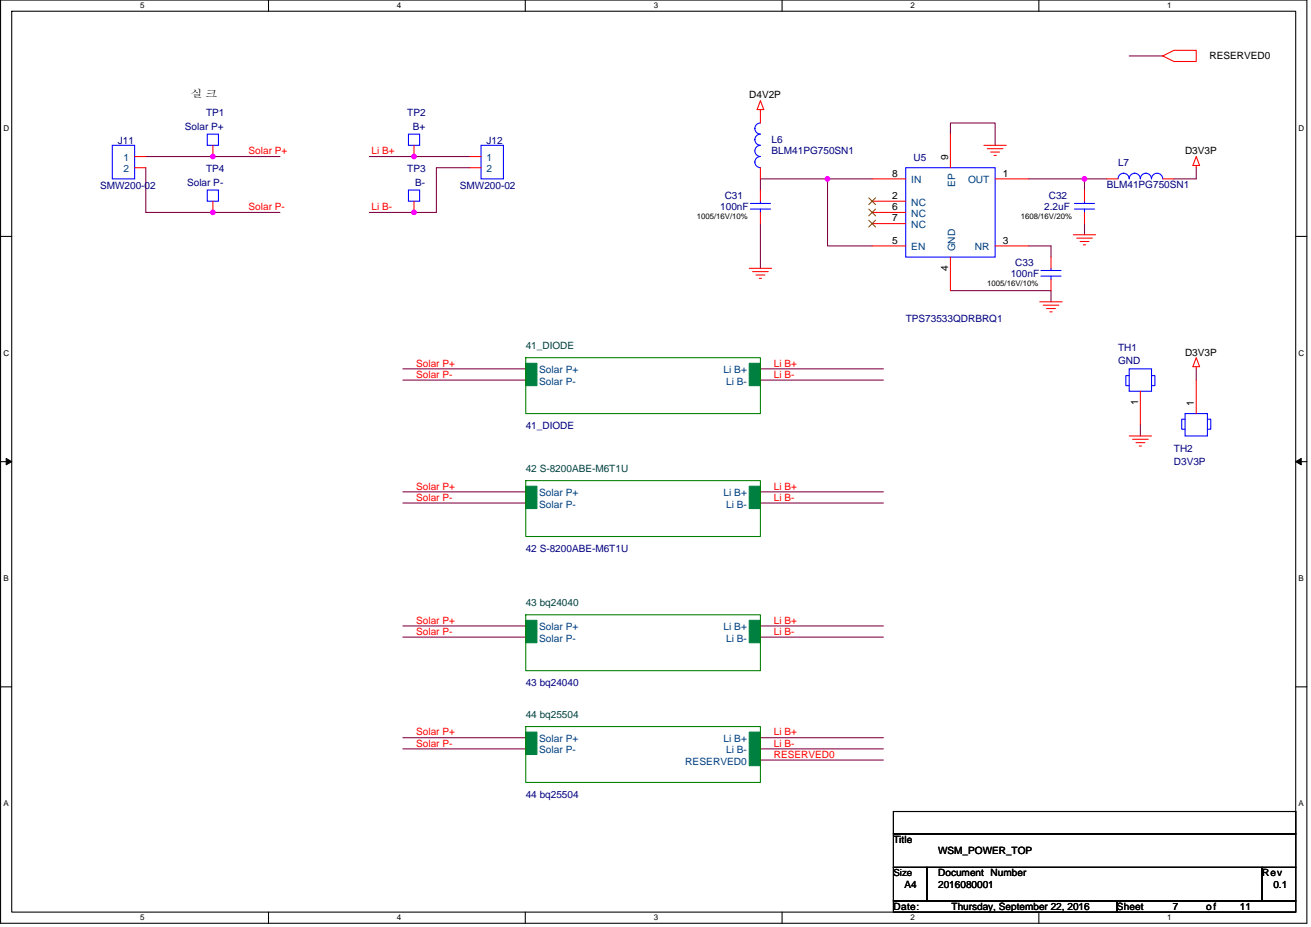
[picture p55: page 7]

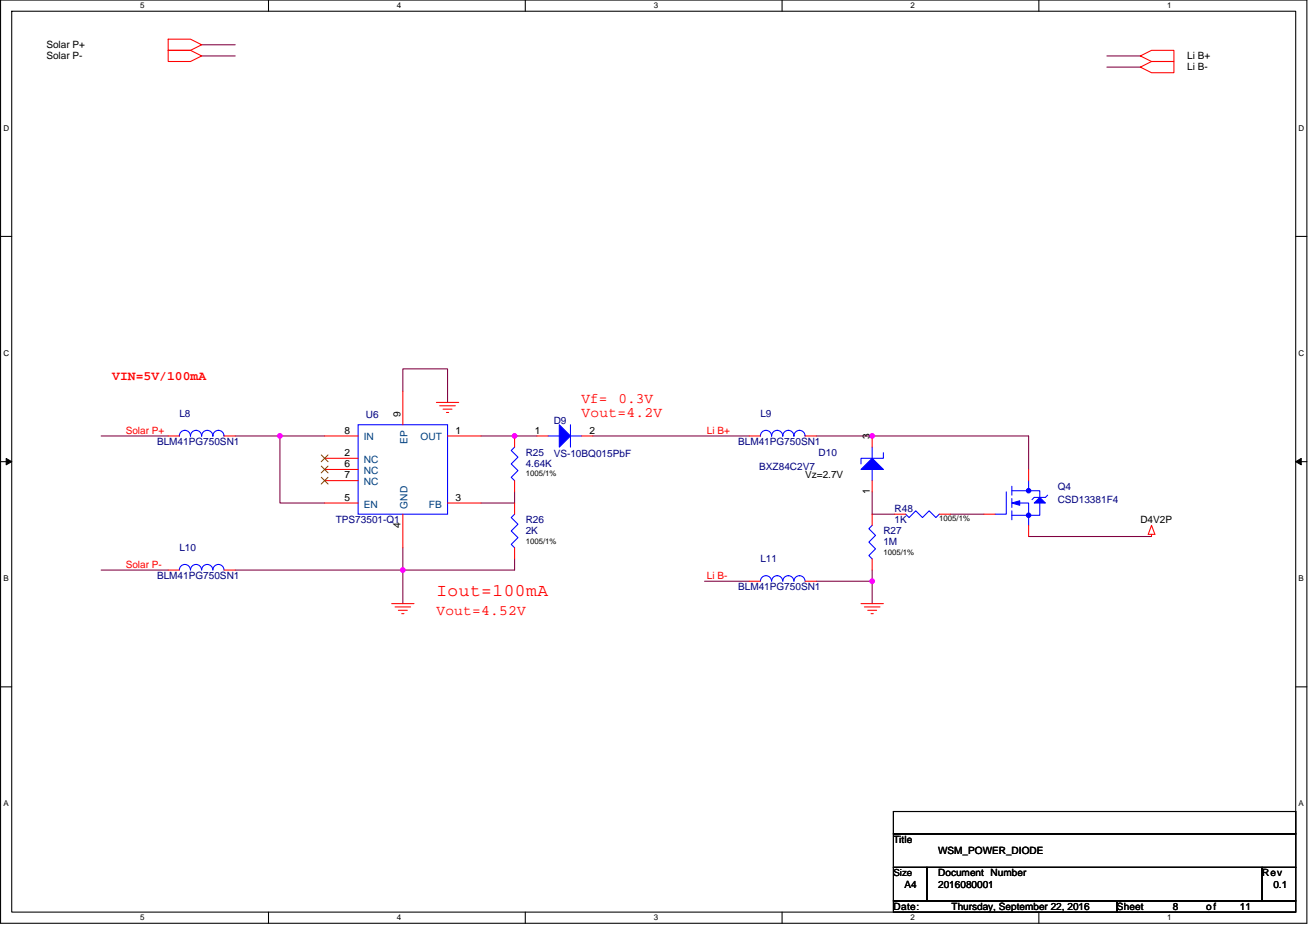
[picture p56: page 8]

VIN=5V | Vf=0.32V

# Li B+ Li B-

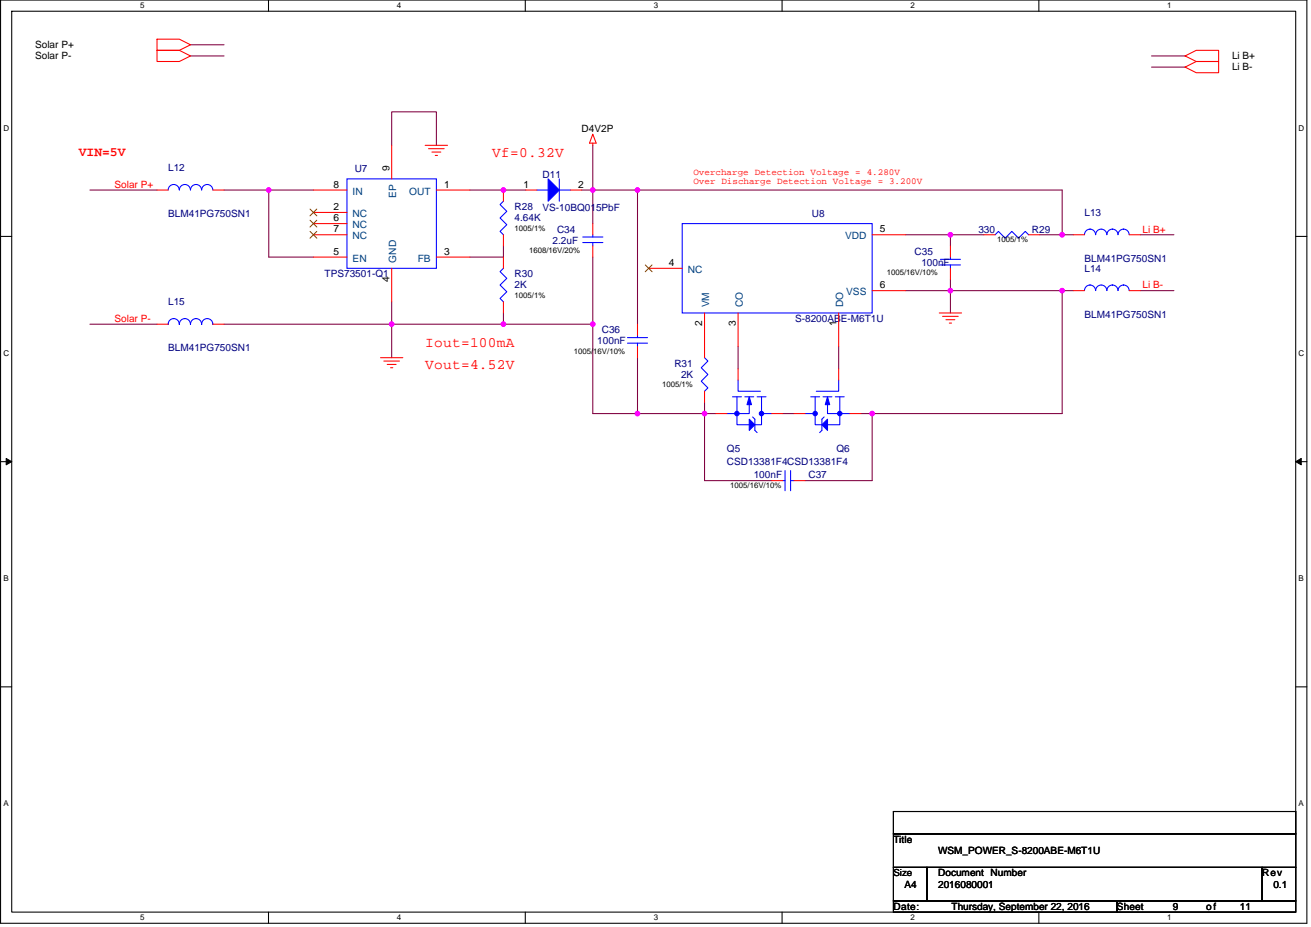
[picture p57: page 9]

Overcharge Detection Voltage = 4.280V
Over Discharge Detection Voltage = 3.200V

## VIN=5V

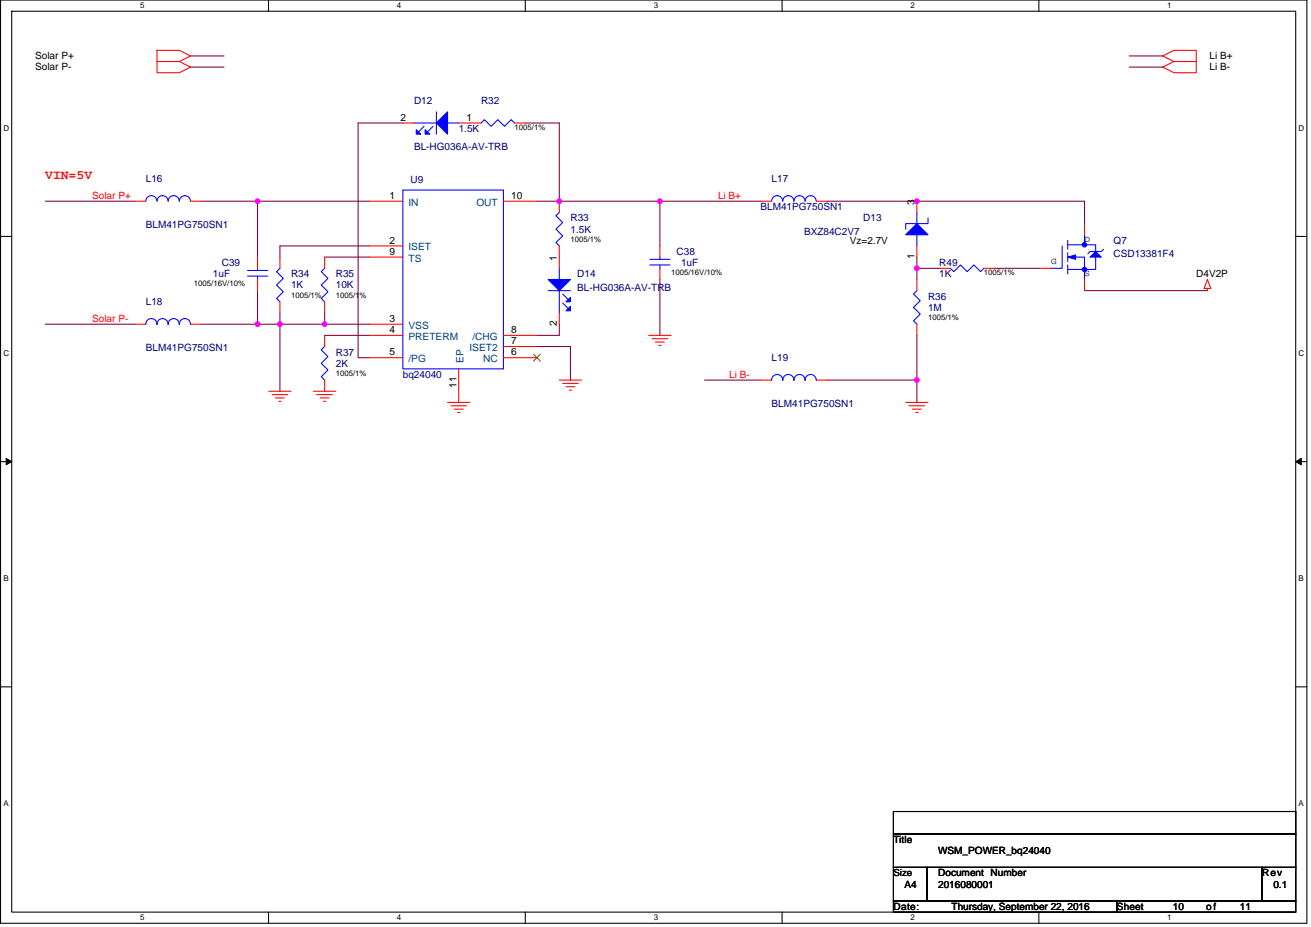
[picture p58: page 10]

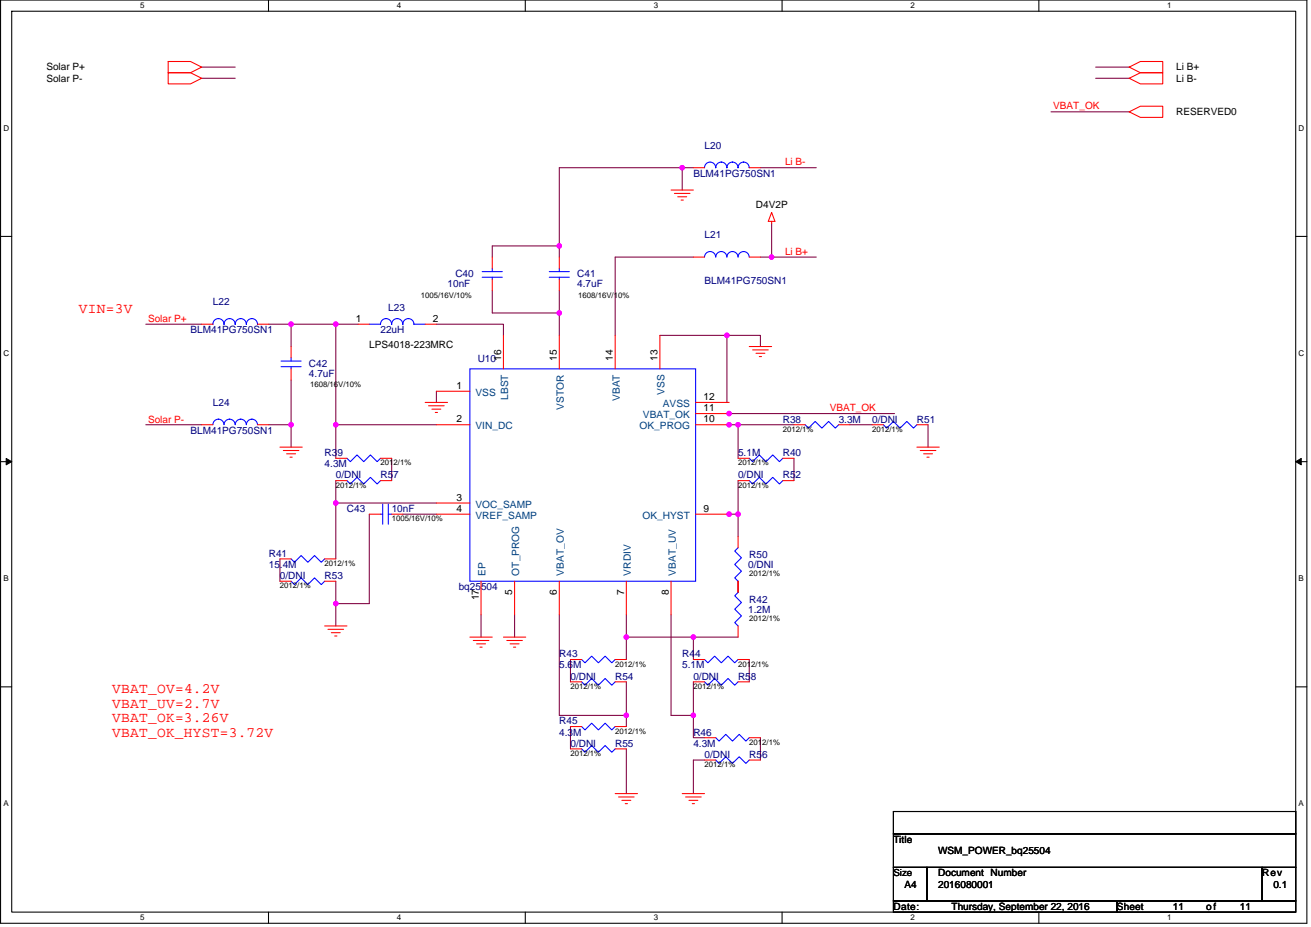
[picture p59: page 11]
