IGShare/01_WPGS/01_HW/01_WSM/02_Development/03_P1/01_Circuit/igshare_wsm_p1_16_2v_Final.pdf

D | D

# WSM Board by IGS_Version P1

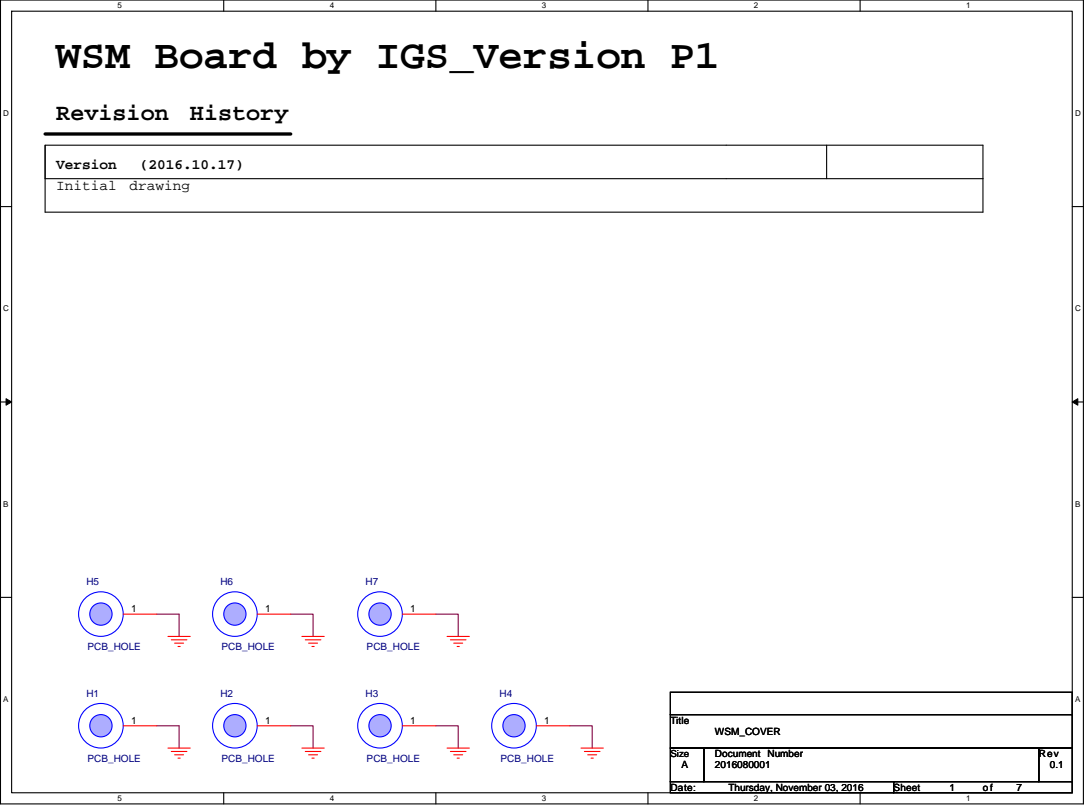
[picture p60: page 1]
Initial drawing; Revision History; Version; Title; WSM_COVER; PCB_HOLE

Size A | Document Number 2016080001 | Rev 0.1

Date: Thursday, November 03, 2016 Thursday, November 03, 2016 Thursday, November 03, 2016 | Sheet 1 1 1 of 7 7 7

D | D

## I2C_SCL

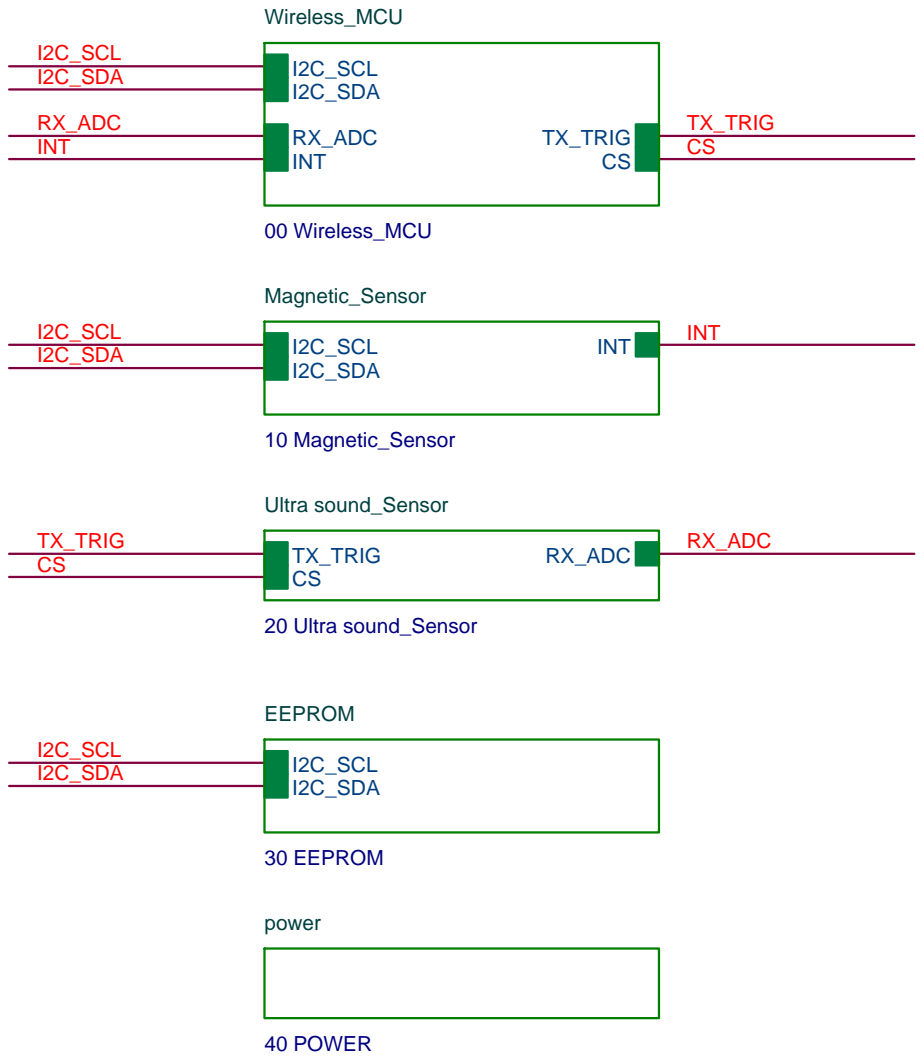
[picture p61: page 2]
I2C_SCL I2C_SDA; I2C_SDA; TX_TRIG; RX_ADC; INT; Title; WSM_TOP; Thursday, November 03, 2016; EEPROM; 30 EEPROM; Wireless_MCU; 00 Wireless_MCU; I2C_SCL; Magnetic_Sensor; 10 Magnetic_Sensor; power; 40 POWER; Ultra sound_Sensor; 20 Ultra sound_Sensor

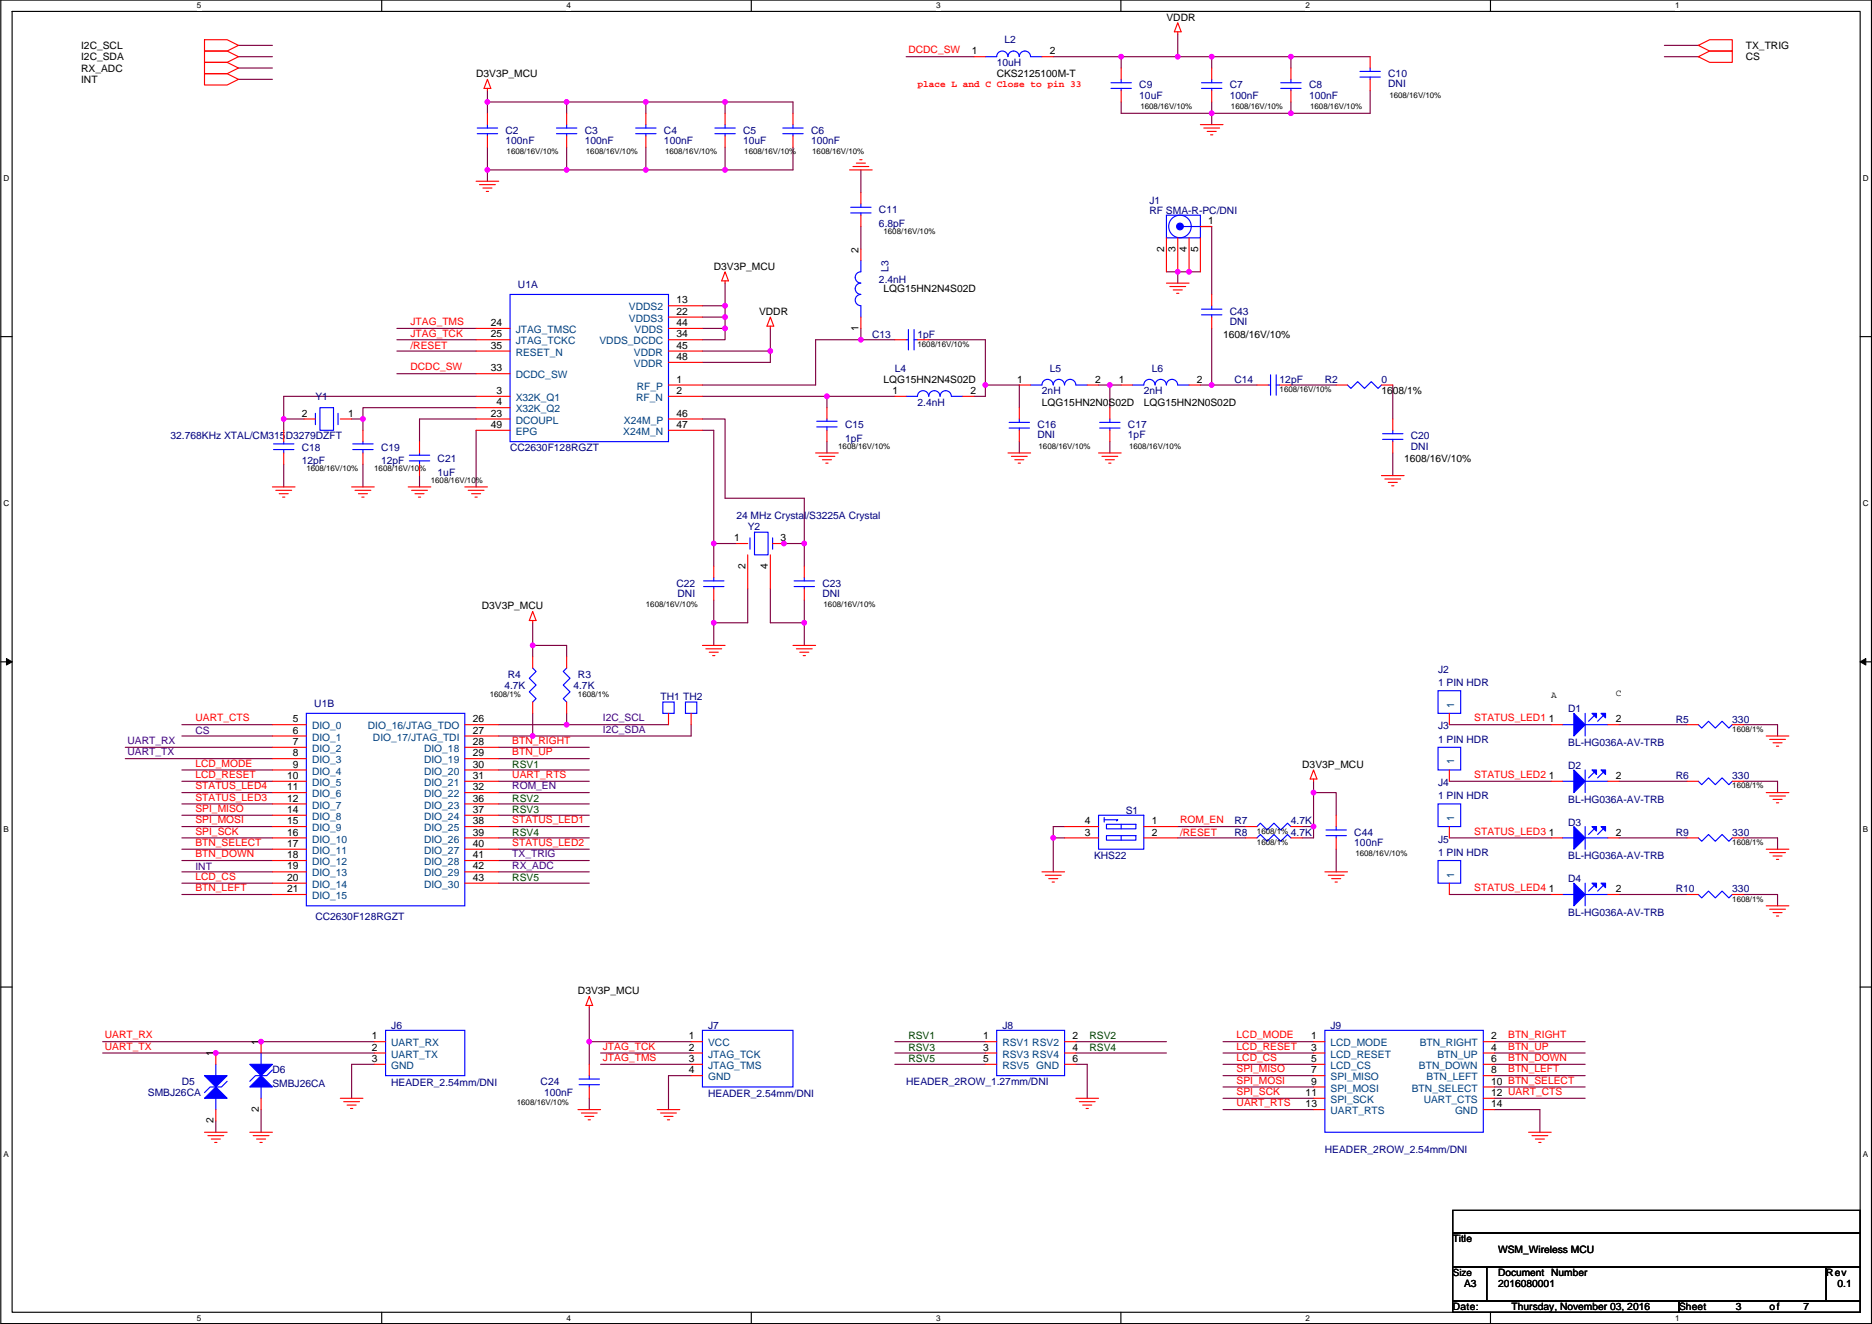
[picture p62: page 3]

place L and C Close to pin 33

RF SMA-R-PC/DNI

Thursday, November 03, 2016 Thursday, November 03, 2016 Thursday, November 03, 2016 | 3 3 3 7 7 7

D | D

I2C

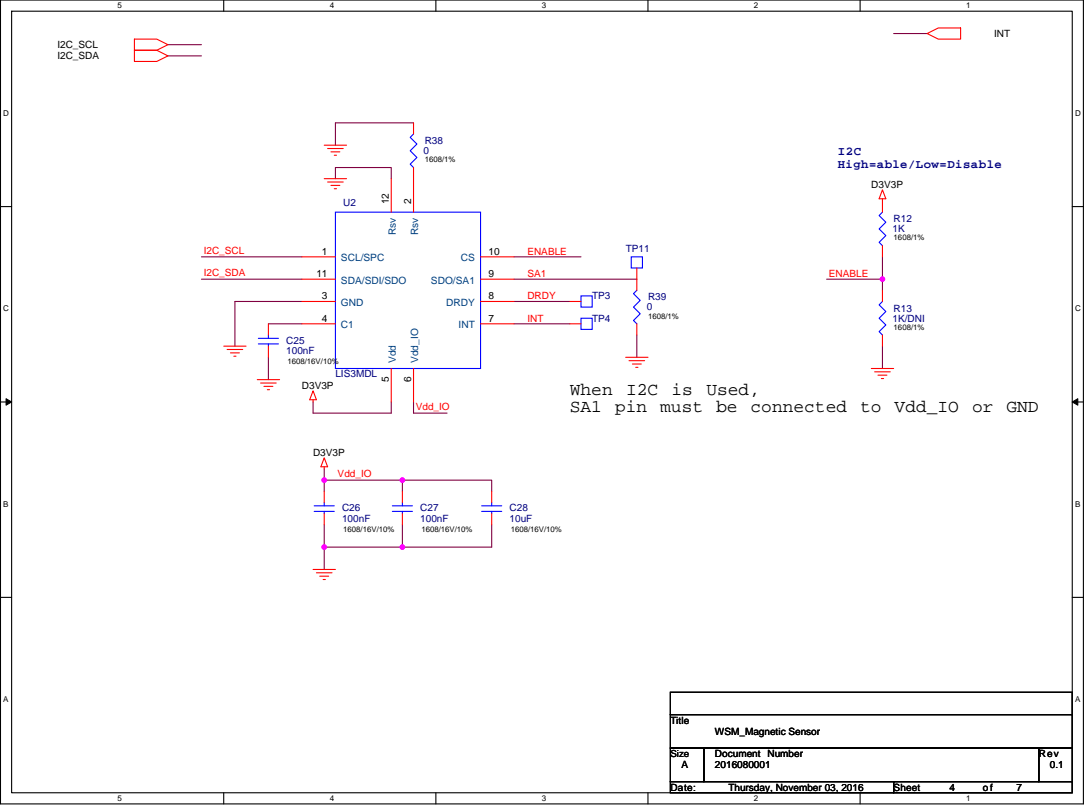
[picture p63: page 4]

High=able/Low=Disable

When I2C is Used,
SA1 pin must be connected to Vdd_IO or GND

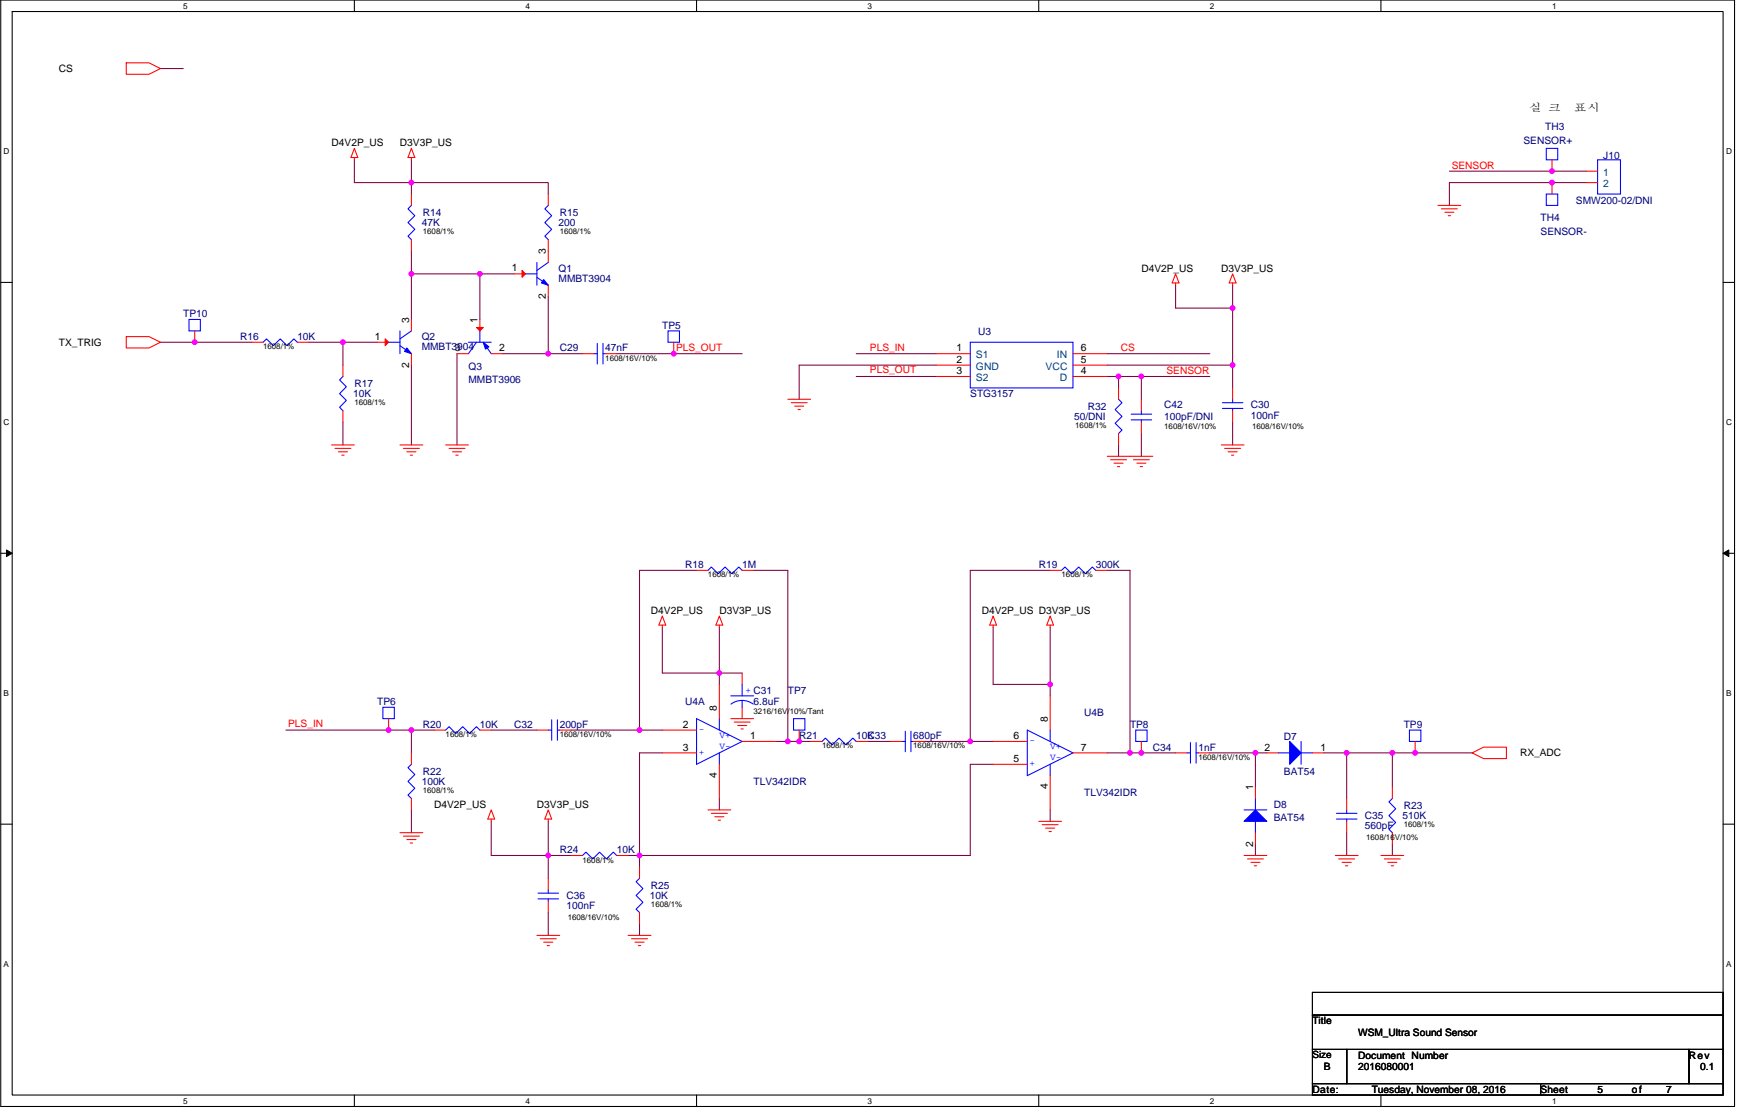
[picture p64: page 5]

Size Size Size B B B | Document Number Document Number Document Number 2016080001 2016080001 2016080001 | Rev Rev Rev 0.1 0.1 0.1

Date: Date: Date: Tuesday, November 08, 2016 Tuesday, November 08, 2016 Tuesday, November 08, 2016 | Sheet Sheet Sheet 5 5 5 of of of 7 7 7

D | D

## D3V3P

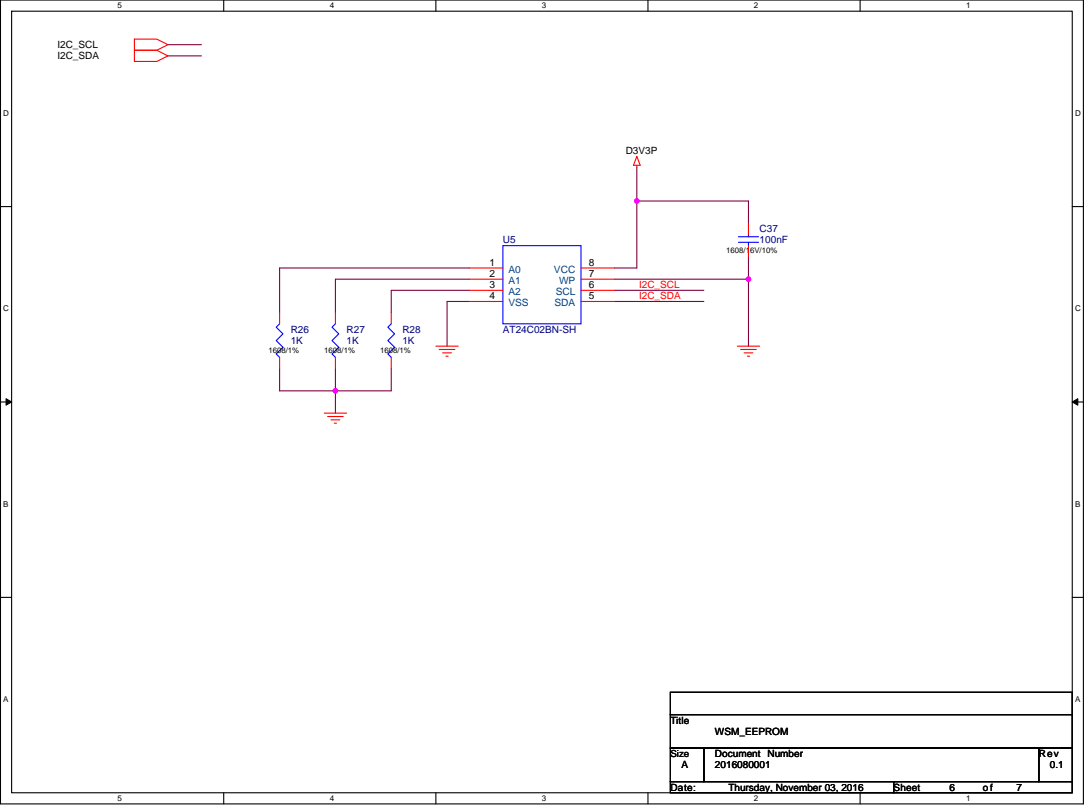
[picture p65: page 6]
I2C_SCL I2C_SDA; Title; WSM_EEPROM; Thursday, November 03, 2016; VSS 4; SDA; 5 SCL; 67 VCC

## D4V2P

D4V2P | D3V3P

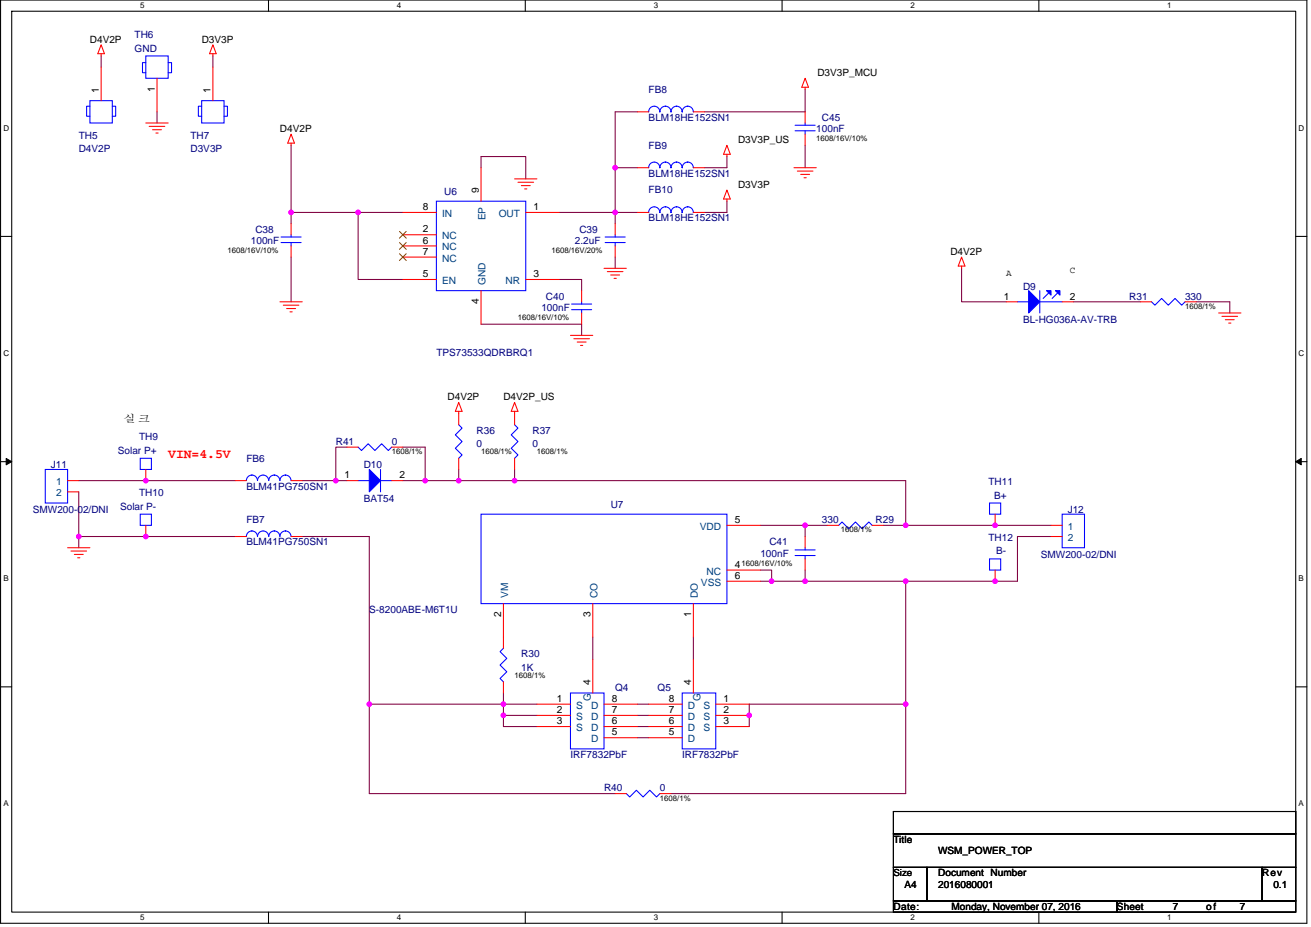
[picture p66: page 7]

Monday, November 07, 2016 Monday, November 07, 2016 Monday, November 07, 2016 | 7 7 7
