IGShare/01_WPGS/01_HW/01_WSM/02_Development/04_P2/01_Circuit/IGSHARE_WSM_P2_16_2V_0_02.pdf

D | D

# WSM Board by IGS_Version P2

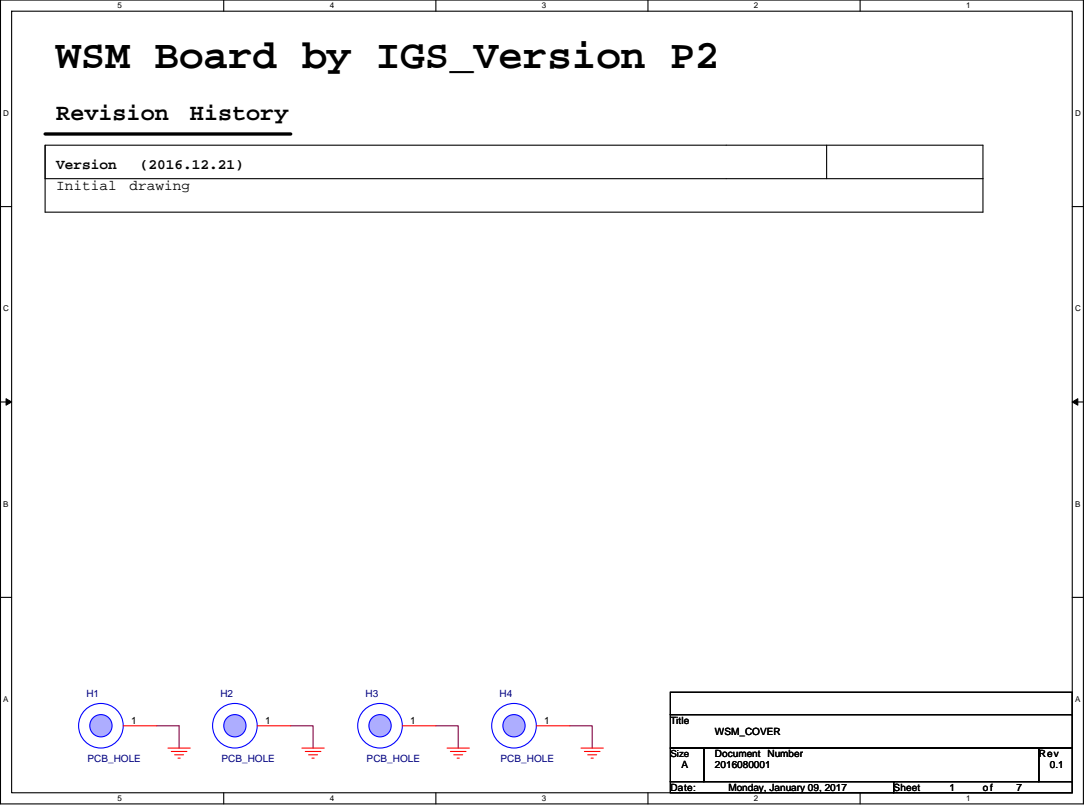
[picture p67: page 1]
Initial drawing; Revision History; Version; Title; WSM_COVER; PCB_HOLE

Size A | Document Number 2016080001 | Rev 0.1

Date: Monday, January 09, 2017 Monday, January 09, 2017 Monday, January 09, 2017 | Sheet 1 1 1 of 7 7 7

D | D

## I2C_SCL

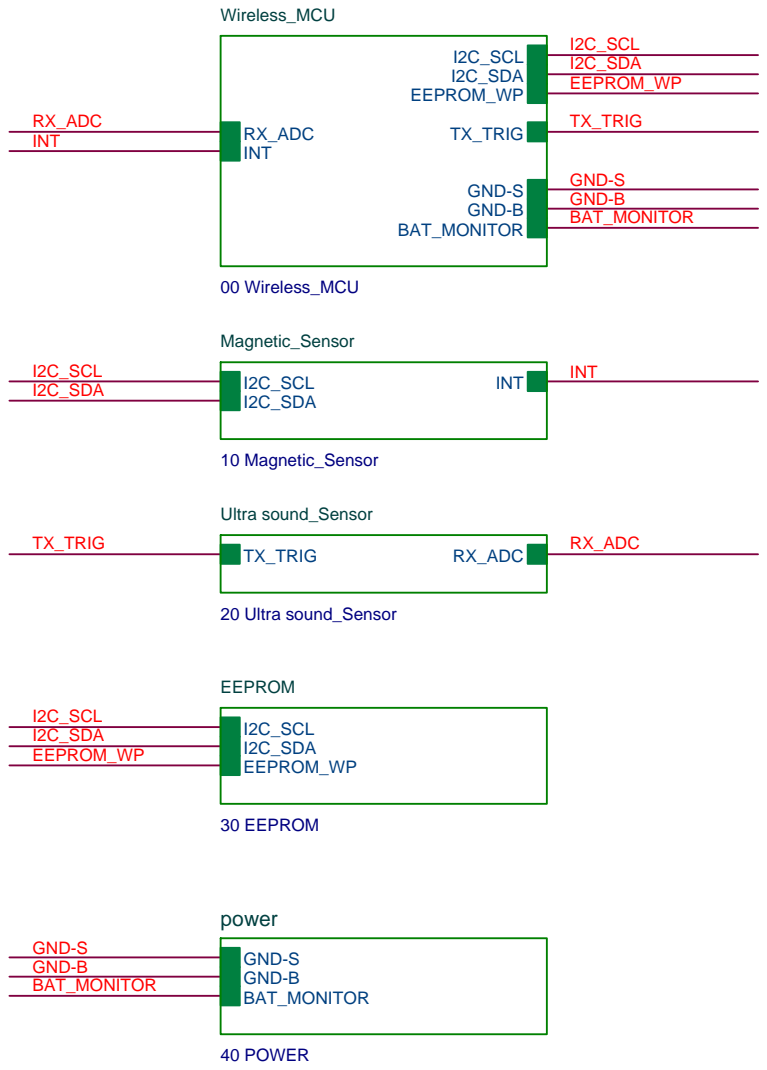
[picture p68: page 2]
I2C_SCL I2C_SDA; TX_TRIG; RX_ADC; INT; EEPROM_WP; I2C_SDA; GND-S GND-B; GND-S GND-B BAT_MONITOR; BAT_MONITOR; Title; WSM_TOP; Monday, January 09, 2017; EEPROM; 30 EEPROM; I2C_SCL I2C_SDA EEPROM_WP; Magnetic_Sensor; 10 Magnetic_Sensor; I2C_SCL; Ultra sound_Sensor; 20 Ultra sound_Sensor; Wireless_MCU; 00 Wireless_MCU; GND-B; GND-S; power; 40 POWER

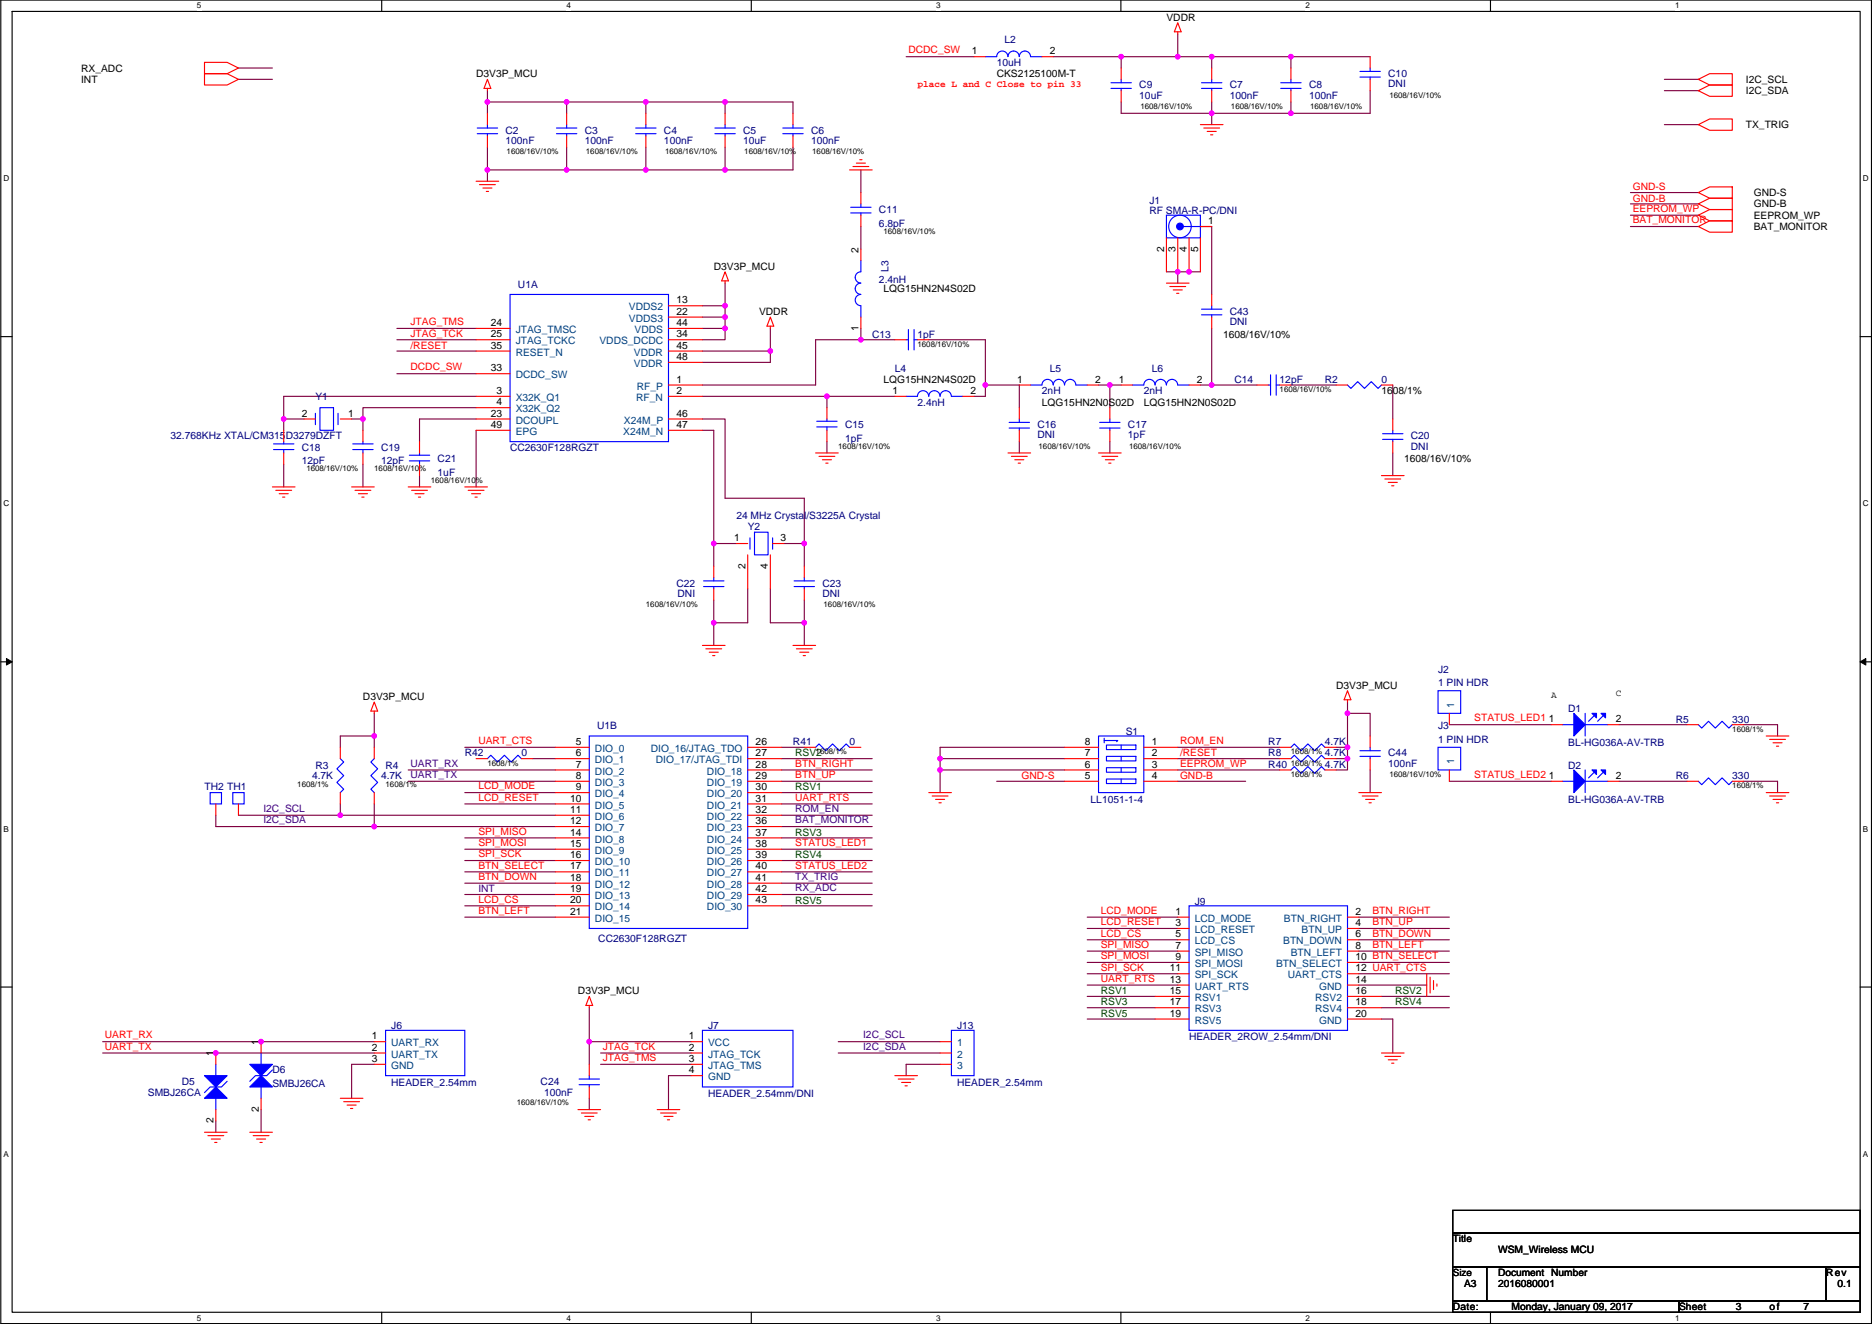
[picture p69: page 3]

place L and C Close to pin 33

RF SMA-R-PC/DNI

Monday, January 09, 2017 Monday, January 09, 2017 Monday, January 09, 2017 | 3 3 3 7 7 7

D | D

I2C

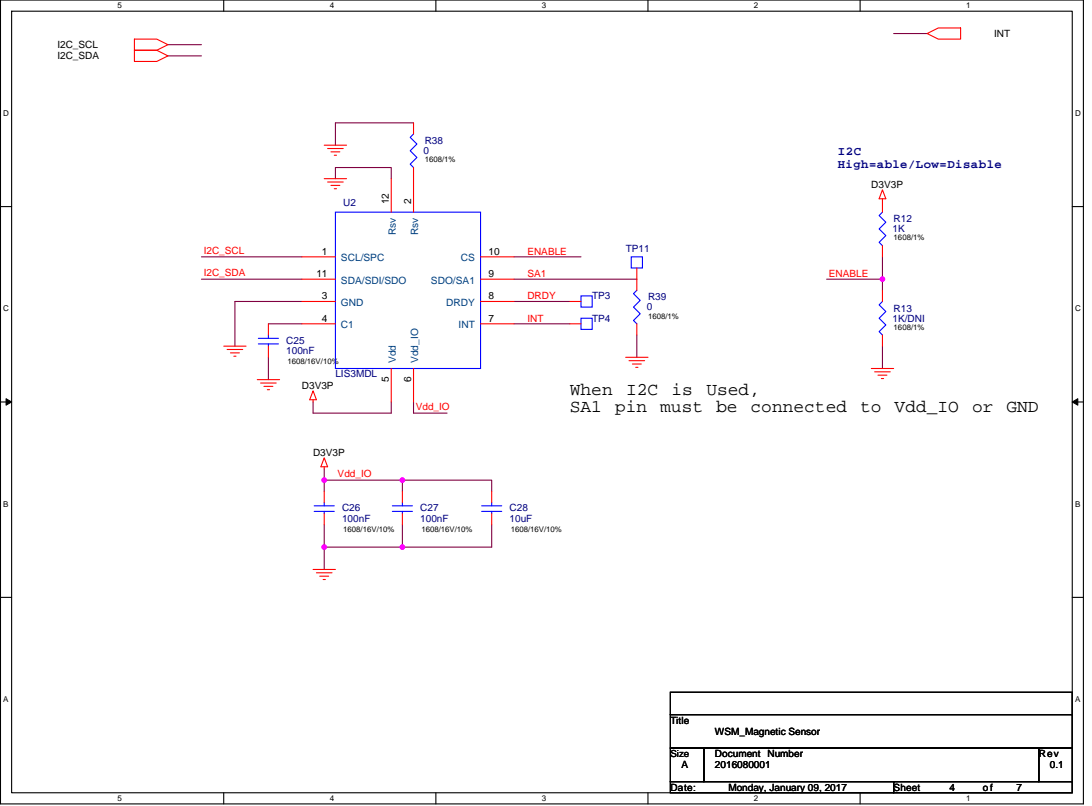
[picture p70: page 4]

High=able/Low=Disable

When I2C is Used,
SA1 pin must be connected to Vdd_IO or GND

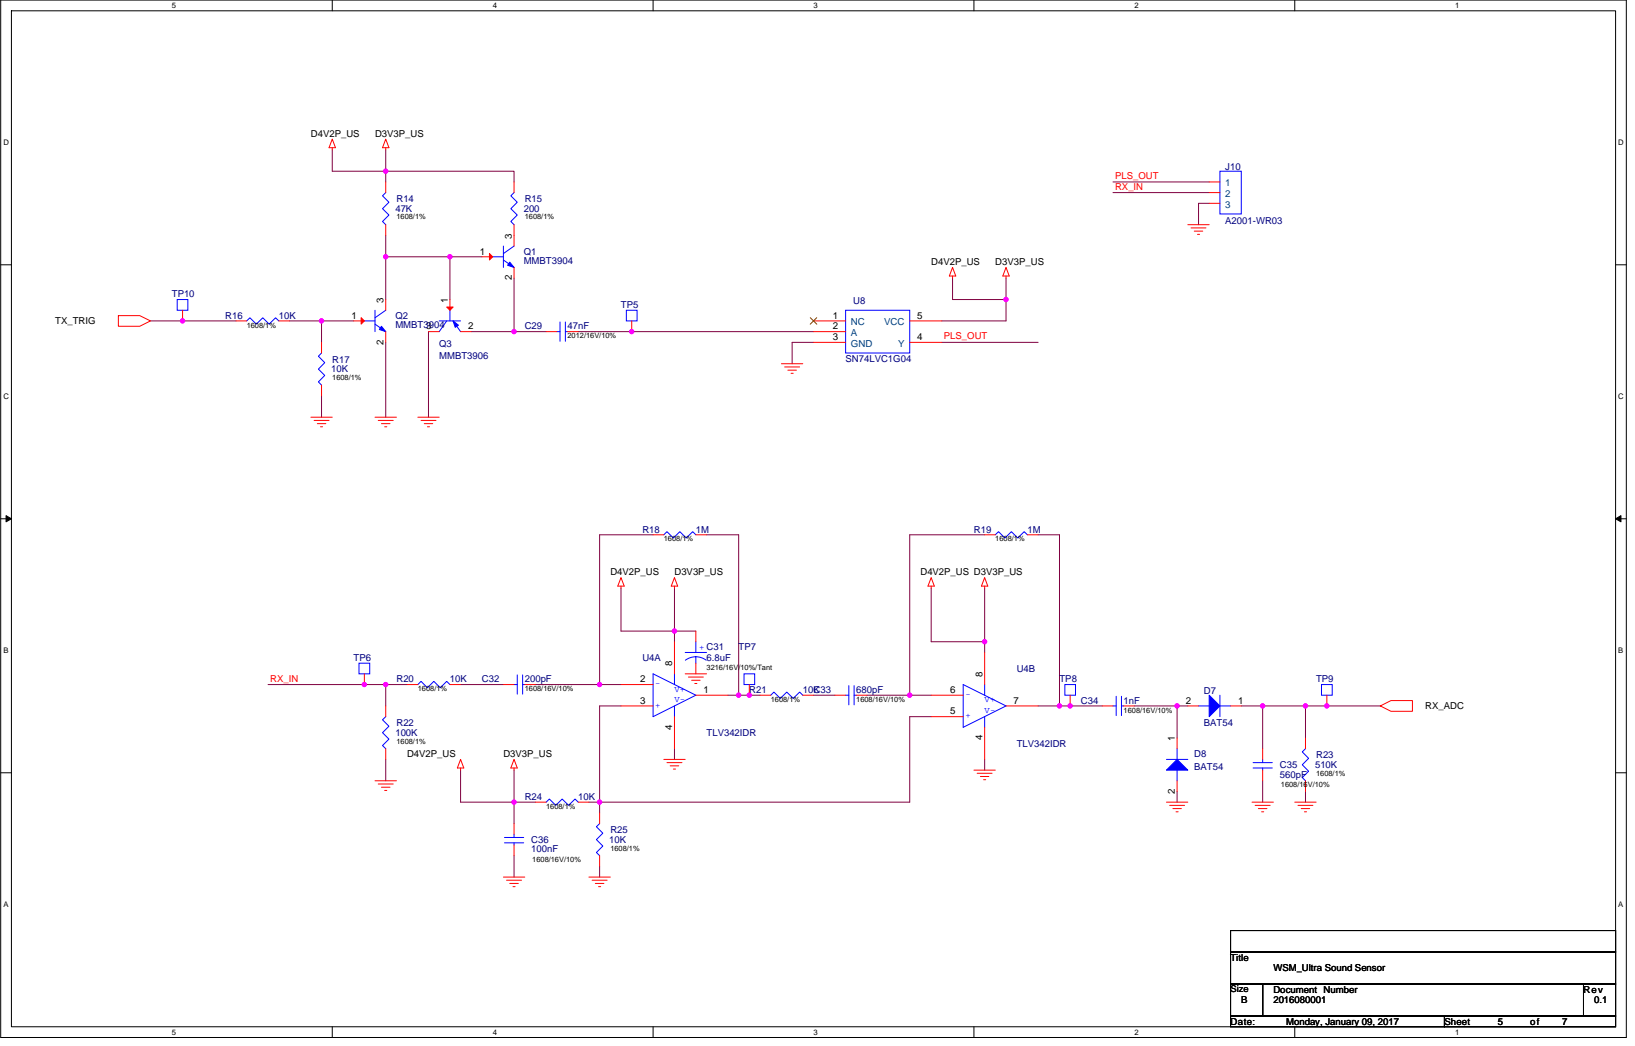
[picture p71: page 5]

Size Size Size B B B | Document Number Document Number Document Number 2016080001 2016080001 2016080001 | Rev Rev Rev 0.1 0.1 0.1

Date: Date: Date: Monday, January 09, 2017 Monday, January 09, 2017 Monday, January 09, 2017 | Sheet Sheet Sheet 5 5 5 of of of 7 7 7

D | D

## EEPROM_WP

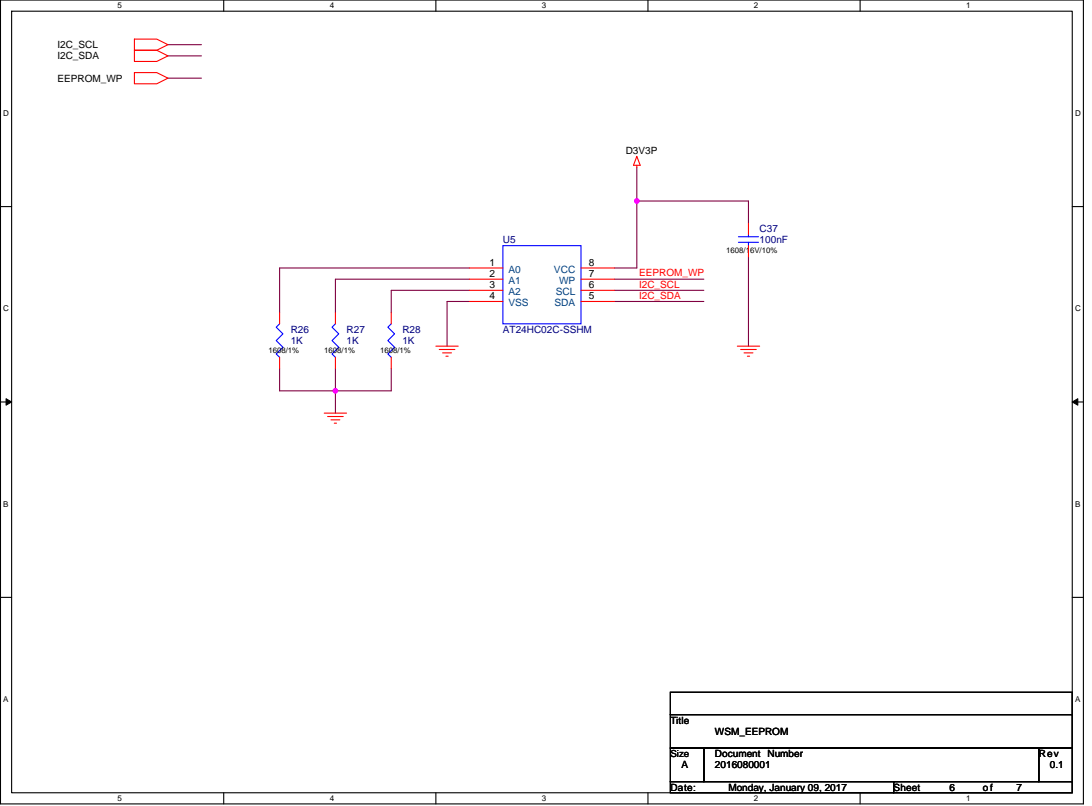
[picture p72: page 6]
I2C_SCL I2C_SDA; EEPROM_WP; Title; WSM_EEPROM; Monday, January 09, 2017; AT24HC02C-SSHM; VSS 4; SDA; 5 SCL; 67 VCC

## D4V2P

D4V2P | D3V3P

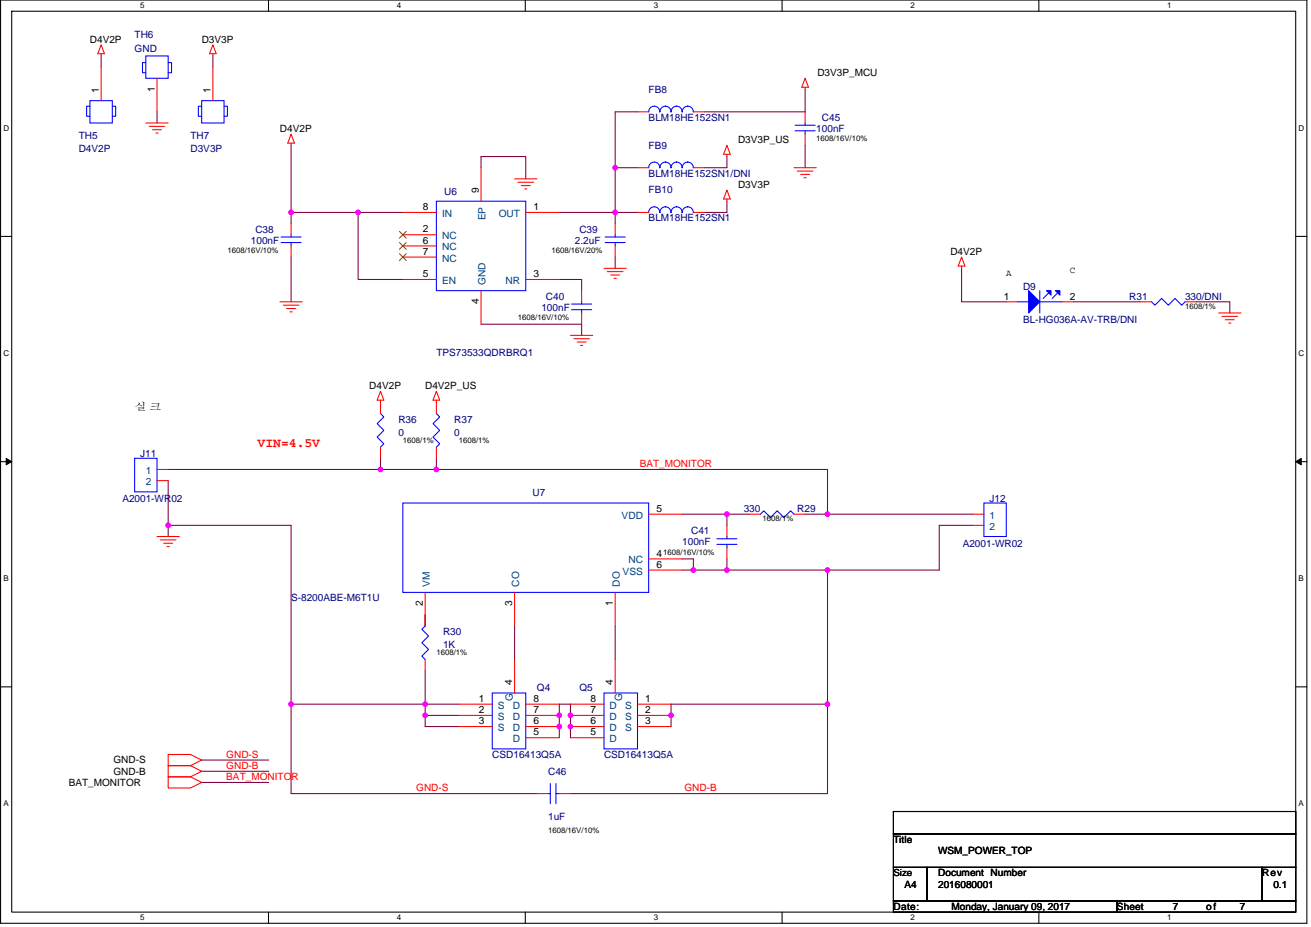
[picture p73: page 7]

BL-HG036A-AV-TRB/DNI

Monday, January 09, 2017 Monday, January 09, 2017 Monday, January 09, 2017 | 7 7 7
