IGShare/01_WPGS/01_HW/01_WSM/02_Development/05_P3/01_Circuit/igshare_wsm_p3_16_2v_0_16 _fina.pdf

# WSM Board by IGS_Version P3

## Initial drawing

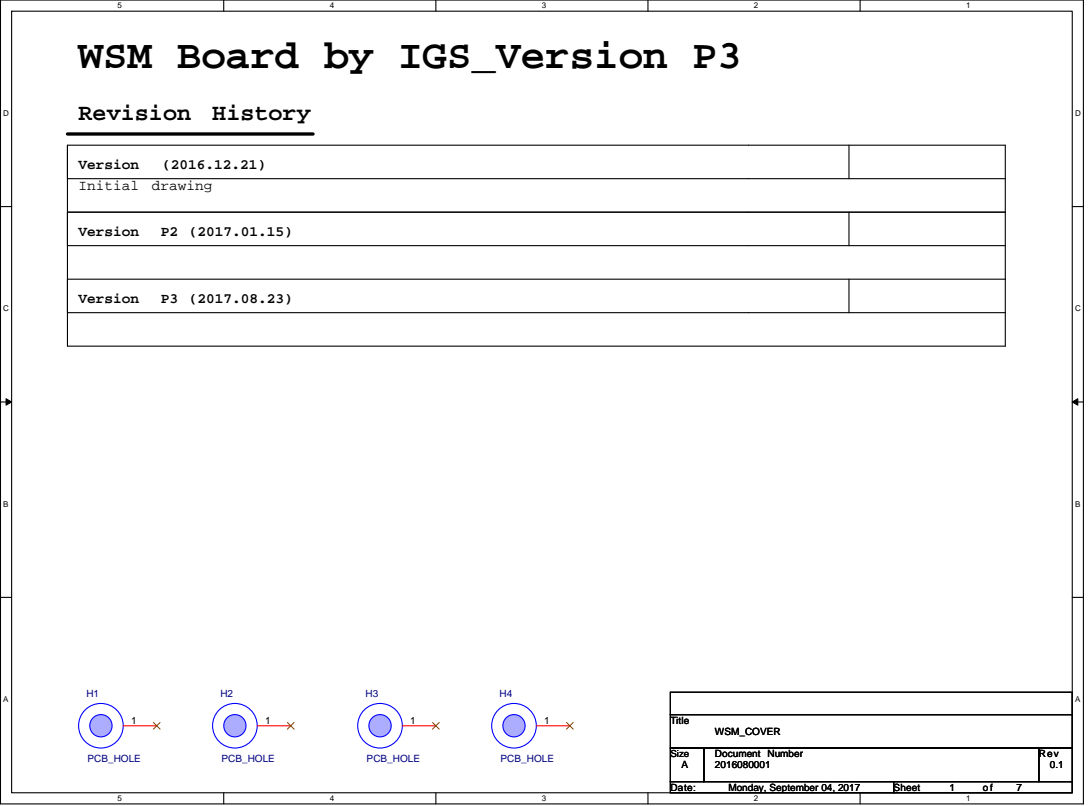
[picture p74: page 1]
Revision History; Version; Title; WSM_COVER; PCB_HOLE

Size A | Document Number 2016080001 | Rev 0.1

Date: Monday, September 04, 2017 Monday, September 04, 2017 Monday, September 04, 2017 | Sheet 1 1 1 of 7 7 7

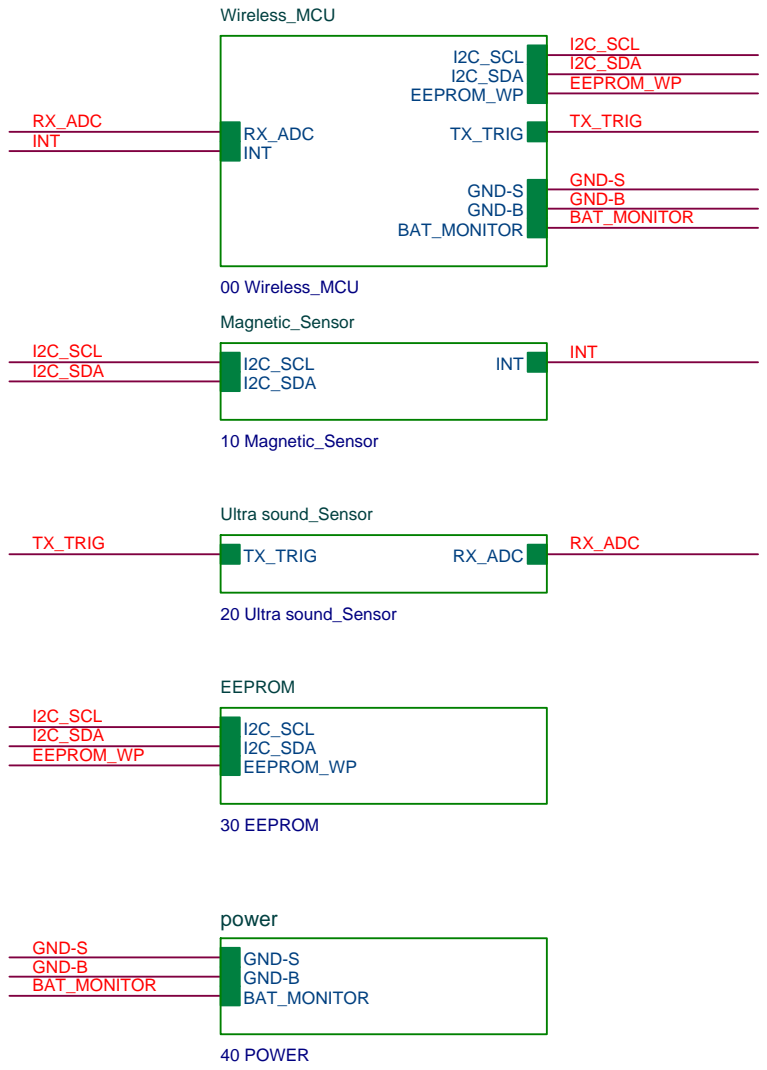
[picture p75: page 2]
I2C_SCL I2C_SDA; TX_TRIG; RX_ADC; INT; EEPROM_WP; I2C_SCL; I2C_SDA; GND-S GND-B; GND-S GND-B BAT_MONITOR; BAT_MONITOR; Title; WSM_TOP; Monday, September 04, 2017; EEPROM; 30 EEPROM; I2C_SCL I2C_SDA EEPROM_WP; Wireless_MCU; 00 Wireless_MCU; GND-B; GND-S; Magnetic_Sensor; 10 Magnetic_Sensor; power; 40 POWER; Ultra sound_Sensor; 20 Ultra sound_Sensor

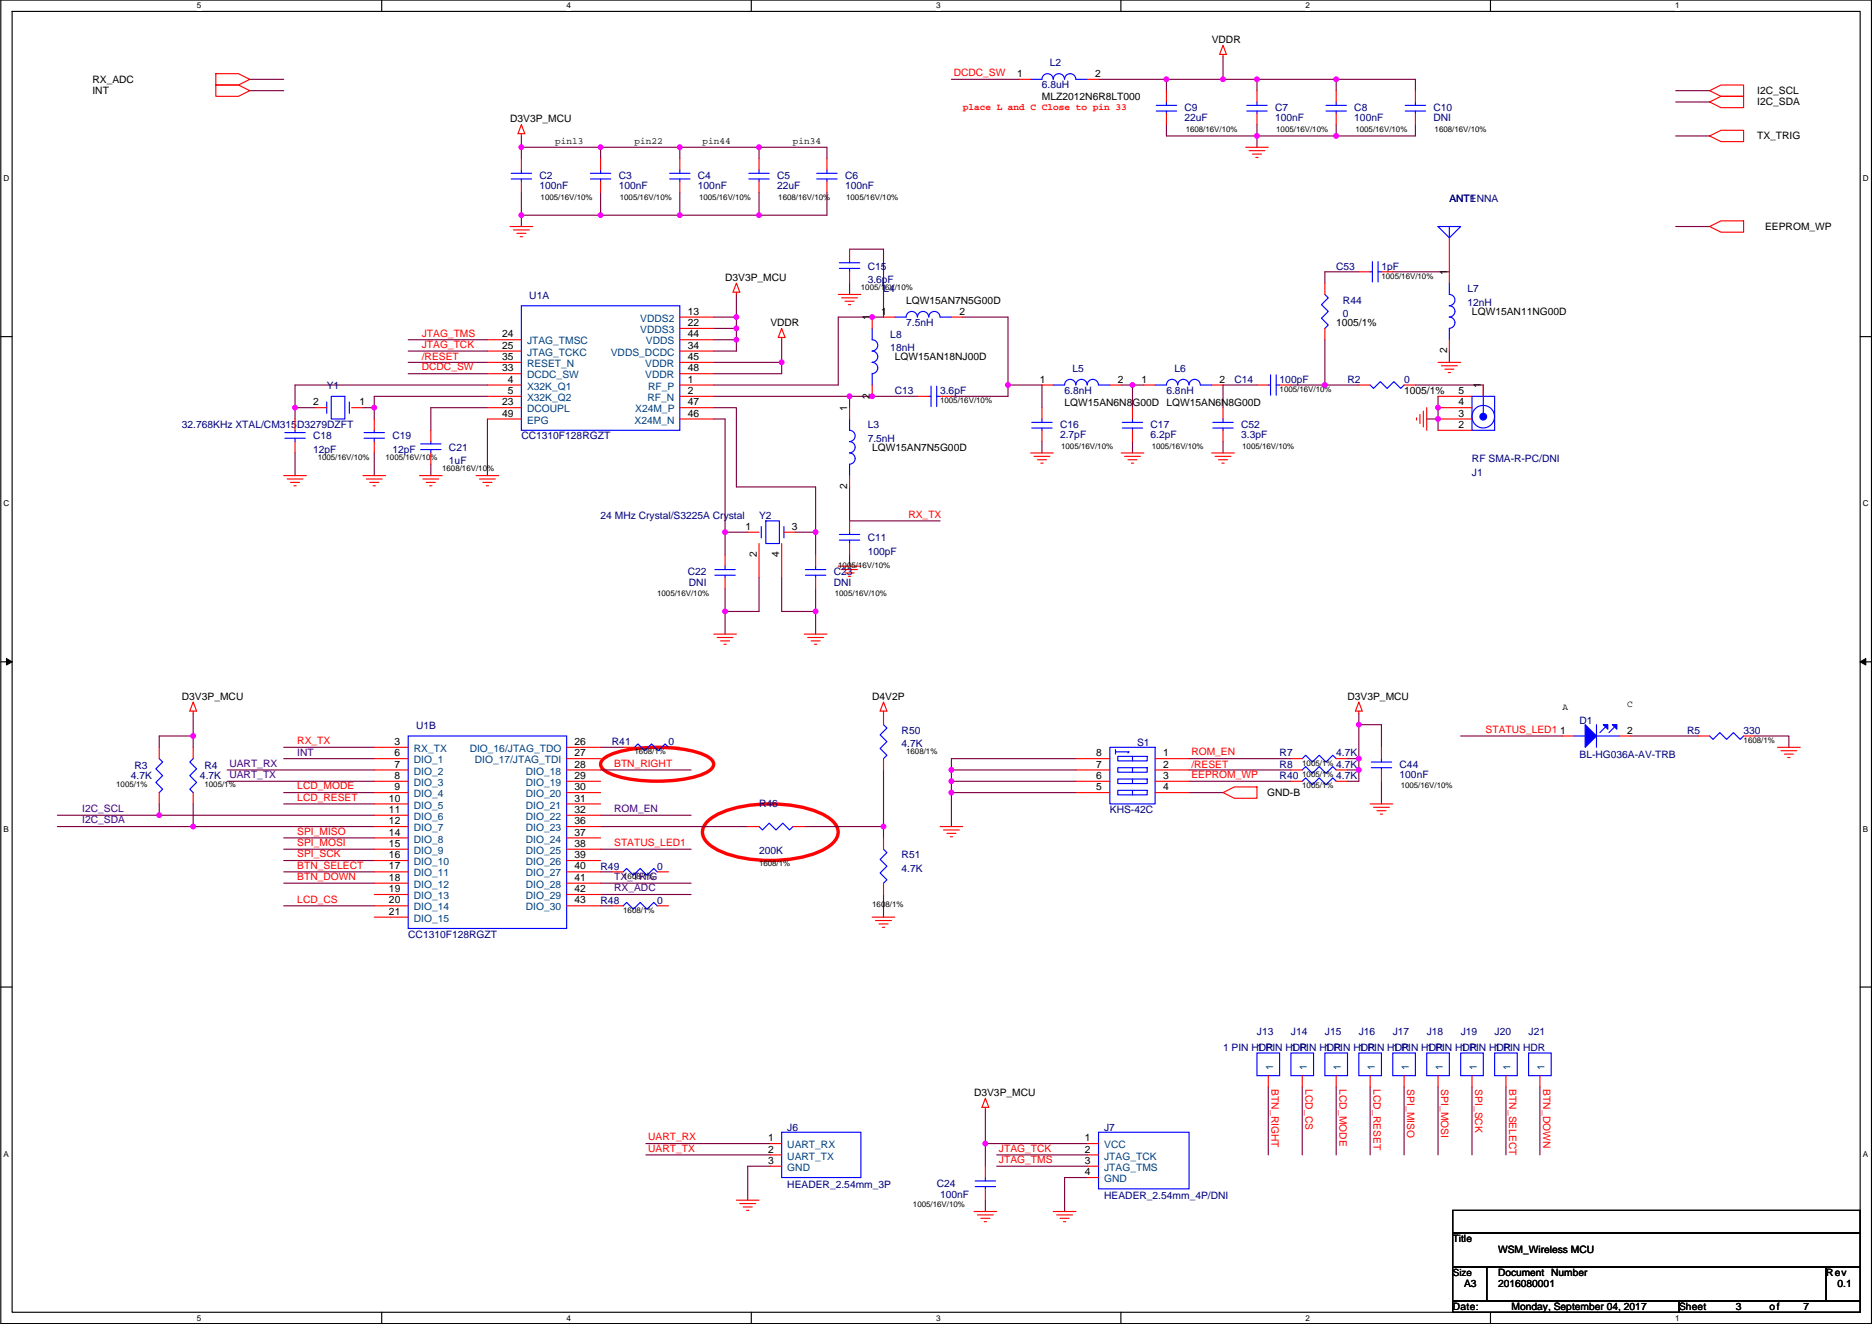
[picture p76: page 3]

place L and C Close to pin 33

RF SMA-R-PC/DNI

Monday, September 04, 2017 Monday, September 04, 2017 Monday, September 04, 2017 | 3 3 3 7 7 7

I2C

### High=able/Low=Disable

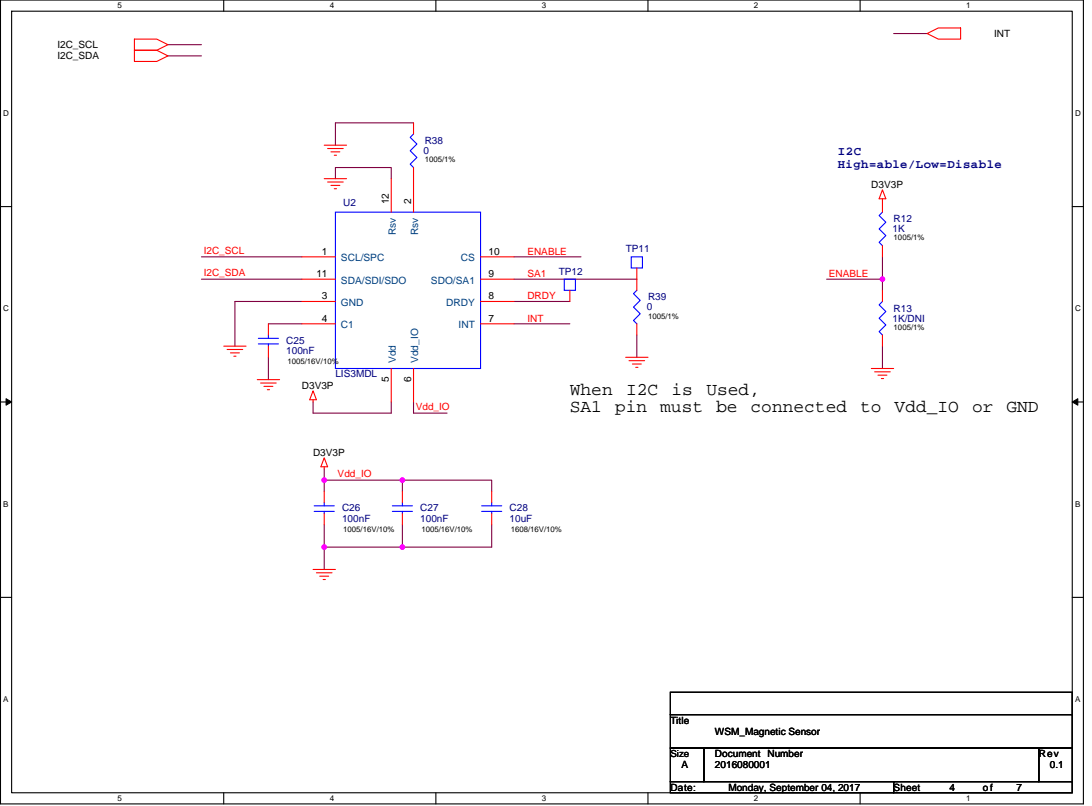
[picture p77: page 4]

When I2C is Used,
SA1 pin must be connected to Vdd_IO or GND

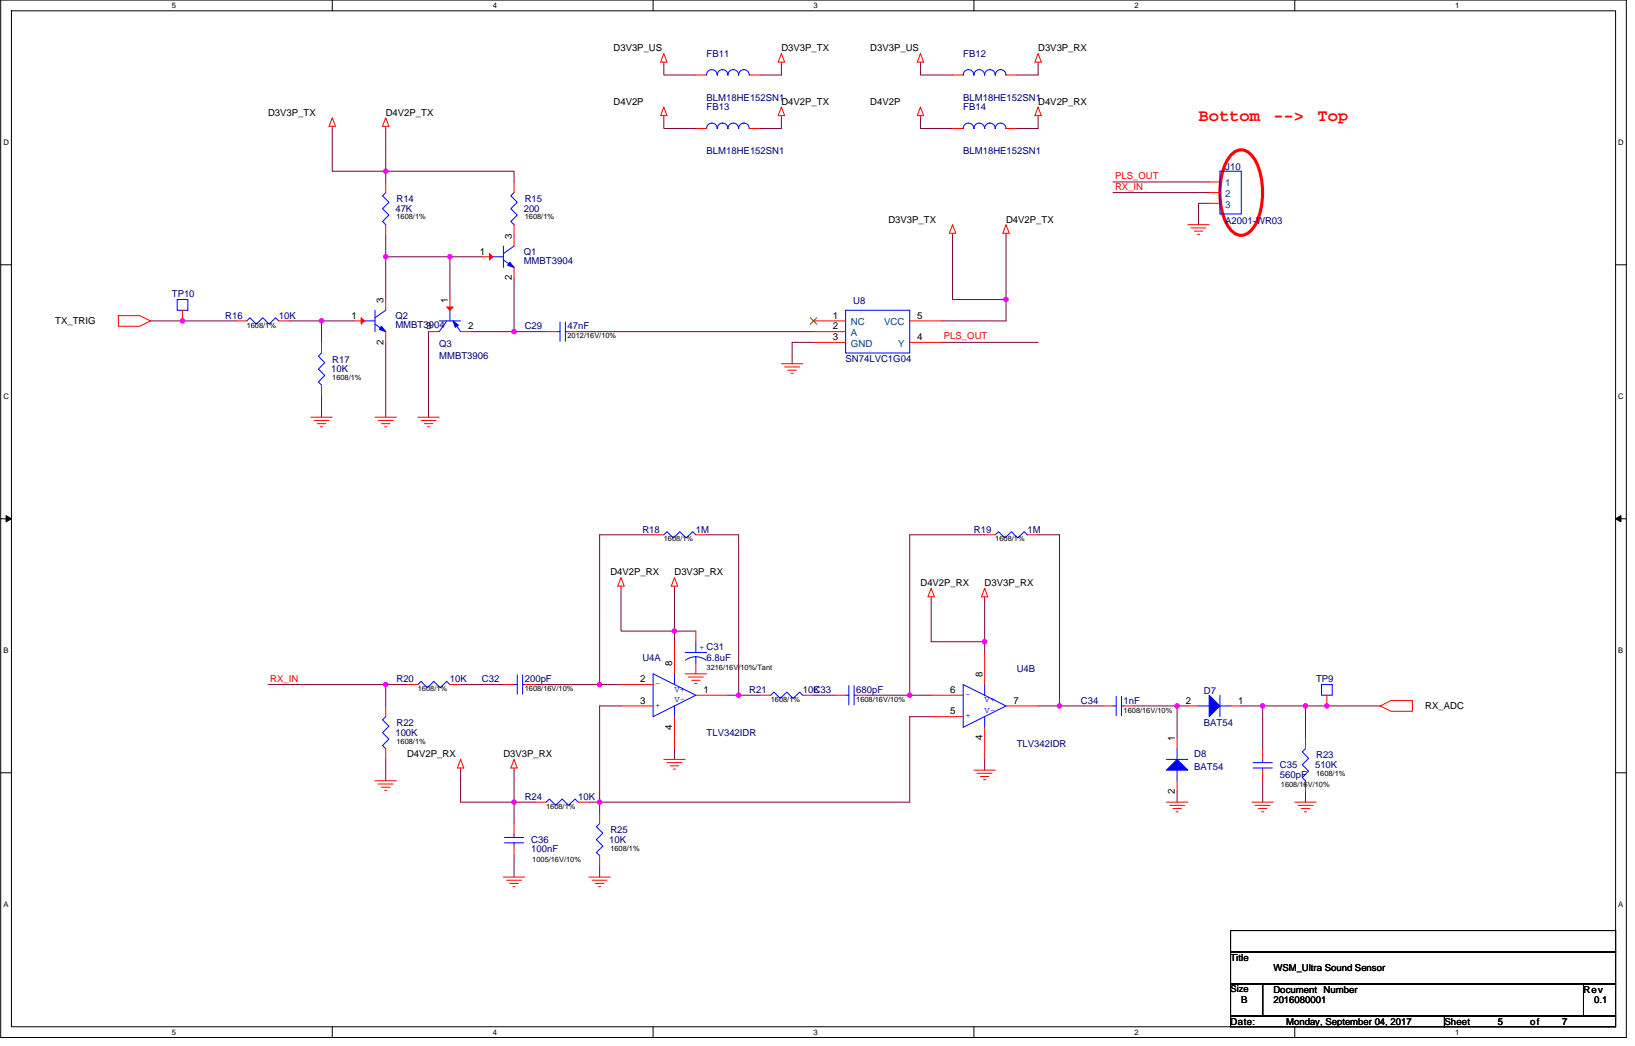
[picture p78: page 5]

Size Size Size B B B | Document Number Document Number Document Number 2016080001 2016080001 2016080001 | Rev Rev Rev 0.1 0.1 0.1

Date: Date: Date: Monday, September 04, 2017 Monday, September 04, 2017 Monday, September 04, 2017 | Sheet Sheet Sheet 5 5 5 of of of 7 7 7

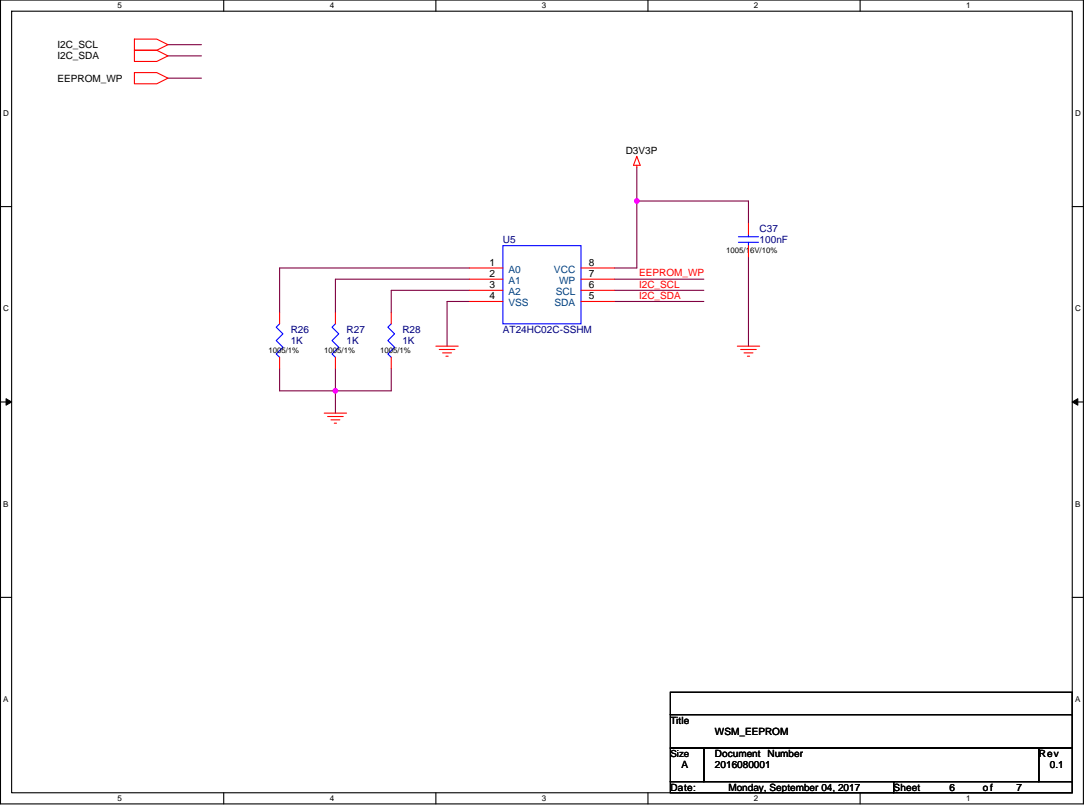
[picture p79: page 6]
I2C_SCL I2C_SDA; EEPROM_WP; Title; WSM_EEPROM; Monday, September 04, 2017; AT24HC02C-SSHM; VSS 4; SDA; 5 SCL; 67 VCC

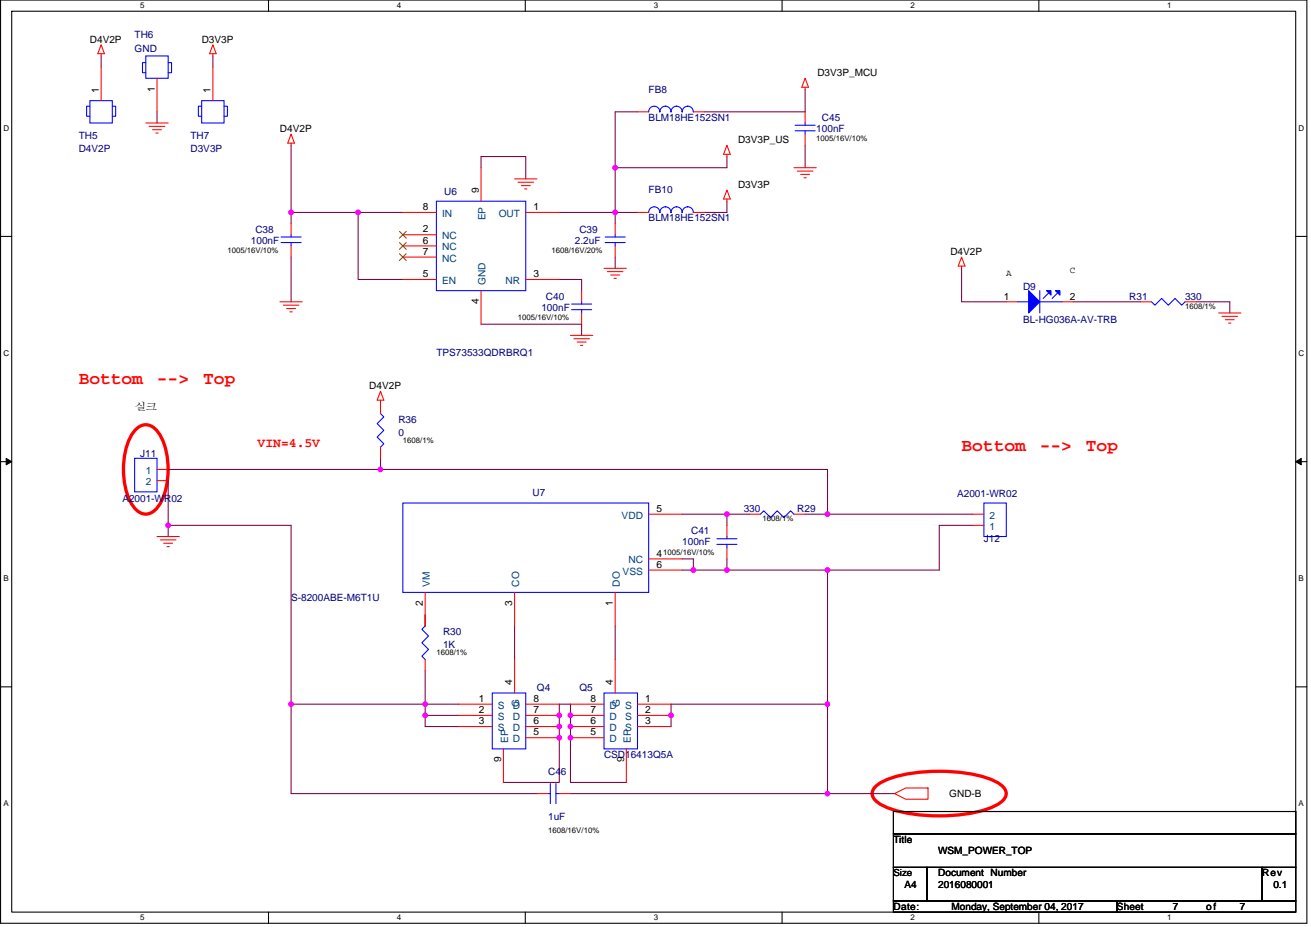
[picture p80: page 7]

Monday, September 04, 2017 Monday, September 04, 2017 Monday, September 04, 2017 | 7 7 7
