IGShare/01_WPGS/01_HW/02_WSCM/02_Development/01_WB/02_P0/01_Circuit/IGSHARE_WB_16_2_VP0.pdf

# Wireless Board

## Initial drawing

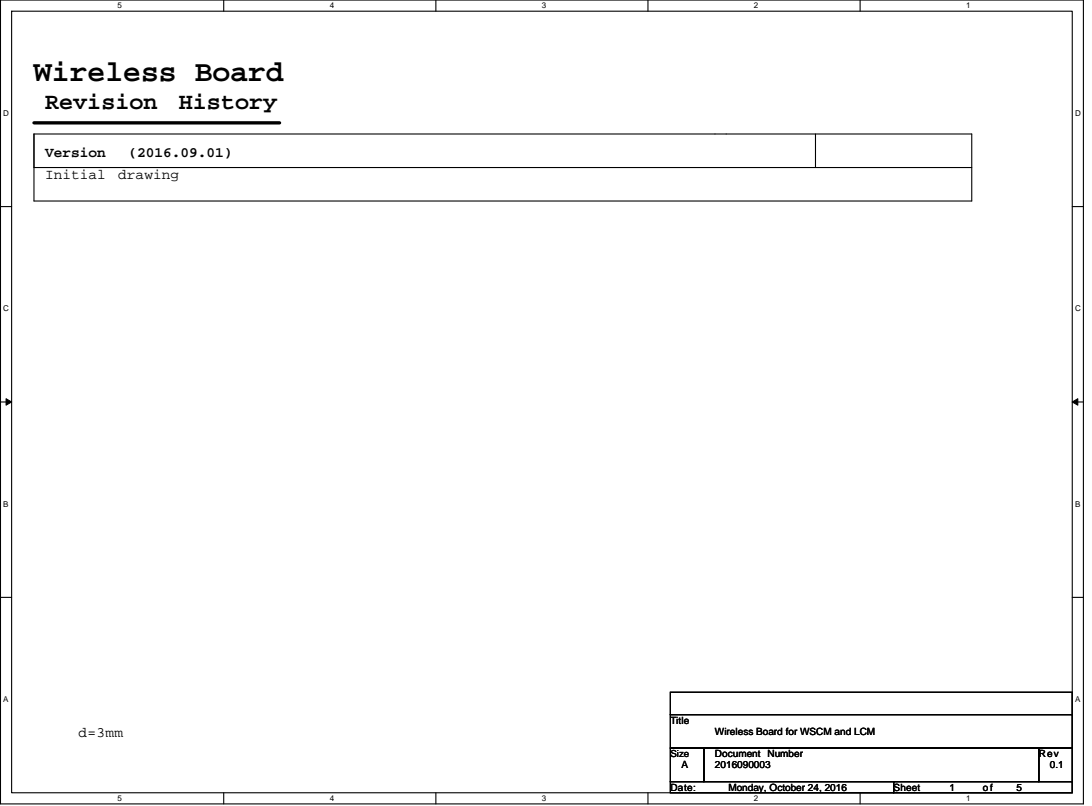
[picture p81: page 1]
Revision History; Version; Title

Wireless Board for WSCM and LCM

Size A | Document Number 2016090003 | Rev 0.1

Date: Monday, October 24, 2016 Monday, October 24, 2016 Monday, October 24, 2016 | Sheet 1 1 1 of 5 5 5

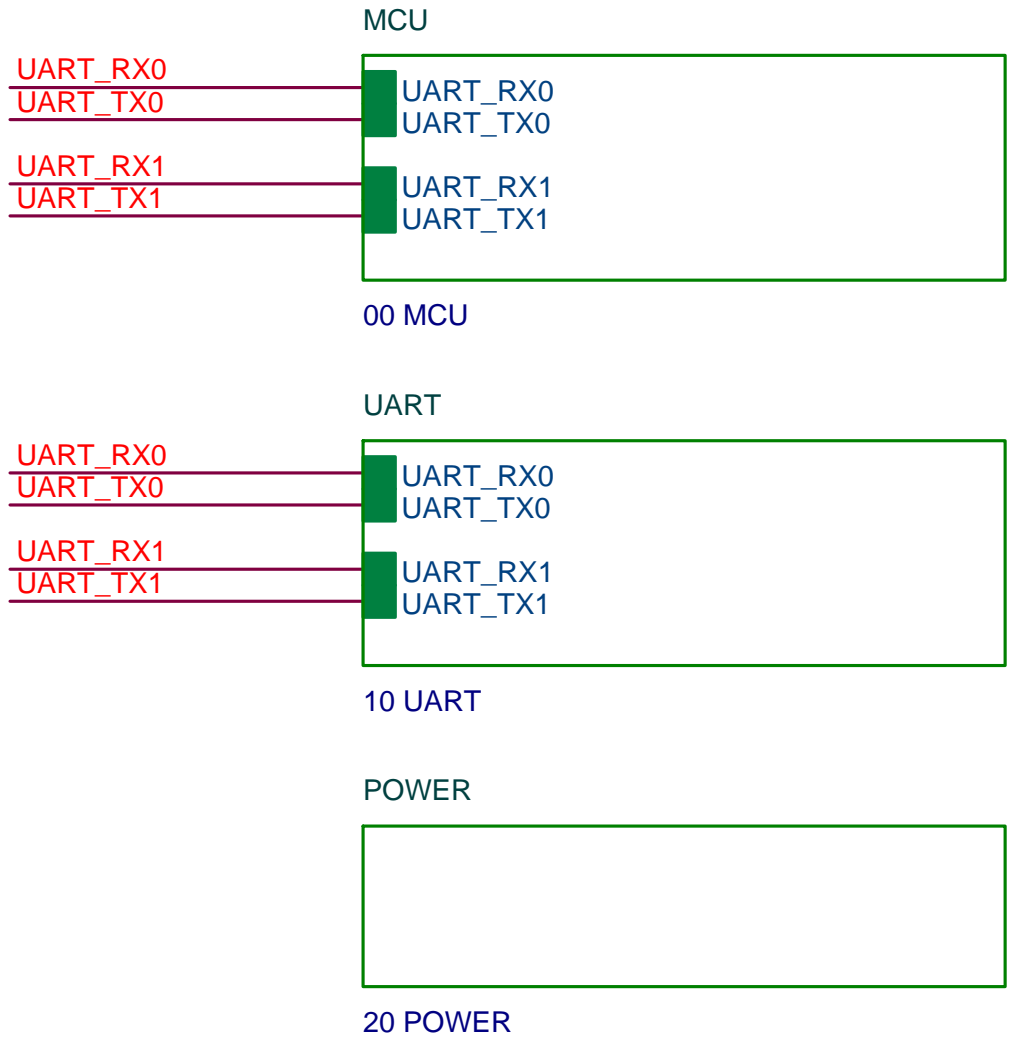
[picture p82: page 2]
UART_RX0 UART_TX0; UART_RX1 UART_TX1; Title; Monday, October 24, 2016; MCU; 00 MCU; UART_RX0; UART_RX1; UART_TX0; UART_TX1; UART; 10 UART; POWER; 20 POWER

Wireless Board for SCM and LED_TOP

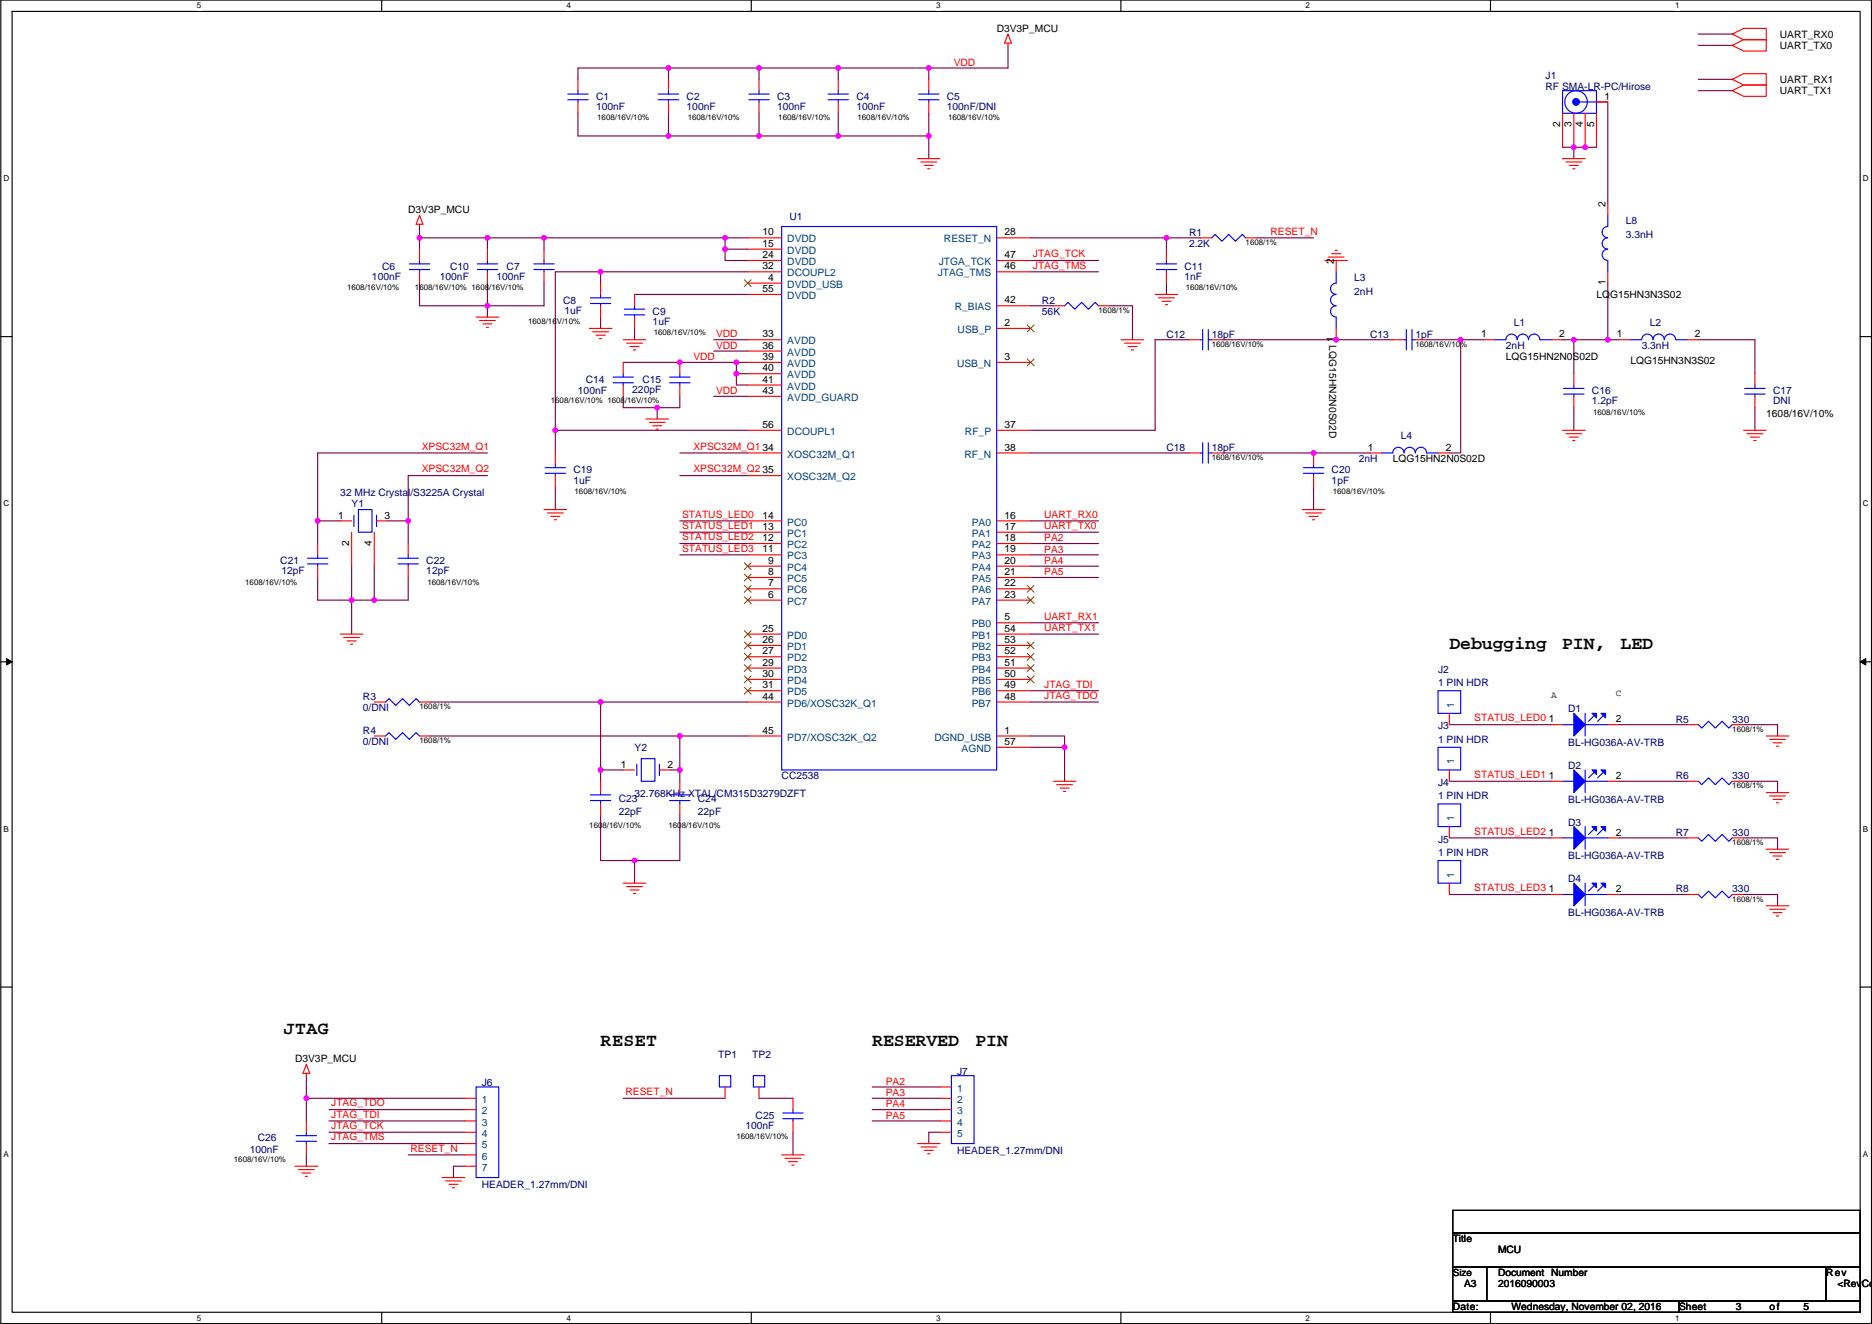
[picture p83: page 3]

RF SMA-LR-PC/Hirose

A3 A3 A3 | 2016090003 2016090003 2016090003 | <RevCo <RevCo <RevCo

Wednesday, November 02, 2016 Wednesday, November 02, 2016 Wednesday, November 02, 2016 | 3 3 3 5 5 5

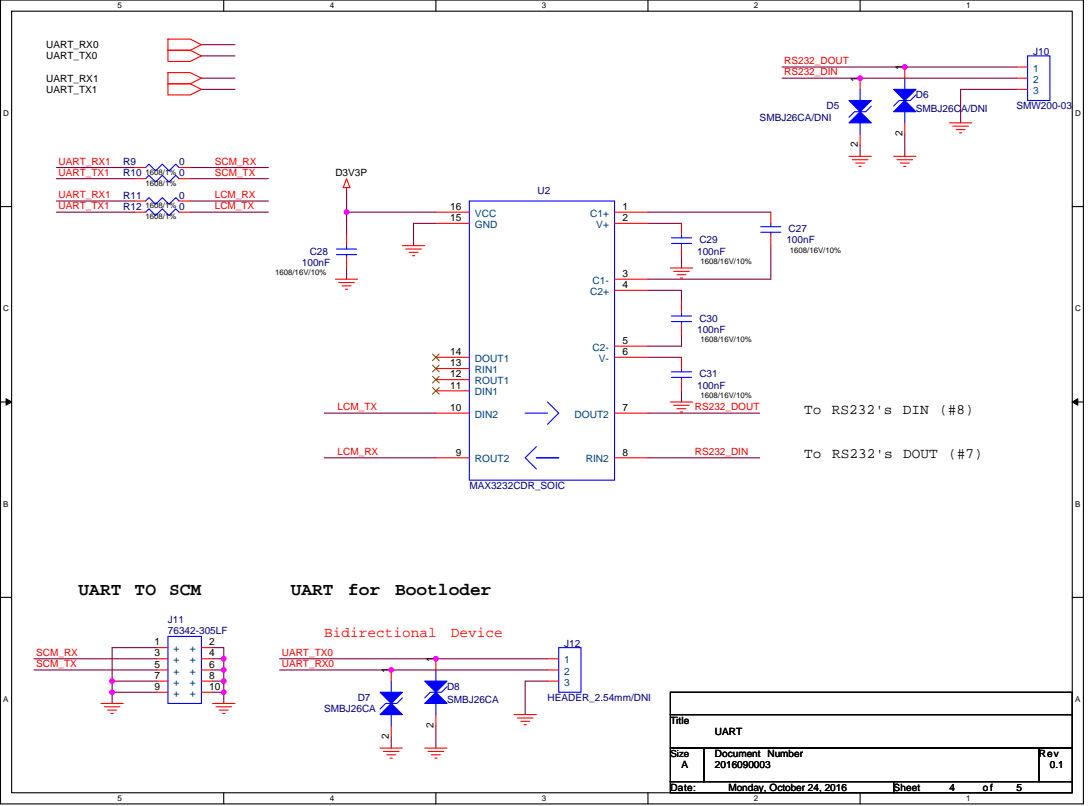
[picture p84: page 4]

용량이큽니다 . 선을굵게 부 탁 드 립니 다.

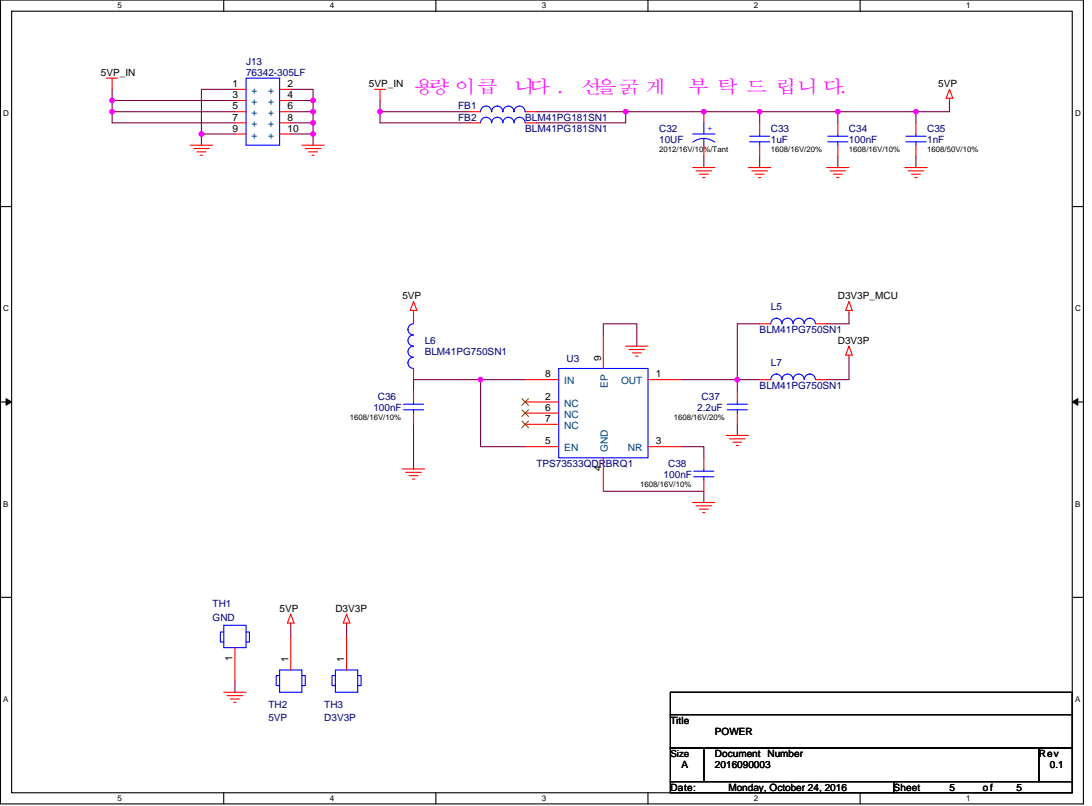
[picture p85: page 5]
