IGShare/01_WPGS/01_HW/02_WSCM/02_Development/01_WB/03_P1/01_Circuit/IGSHARE_WB_REV_P1_.pdf

# Wireless Board

## Initial drawing

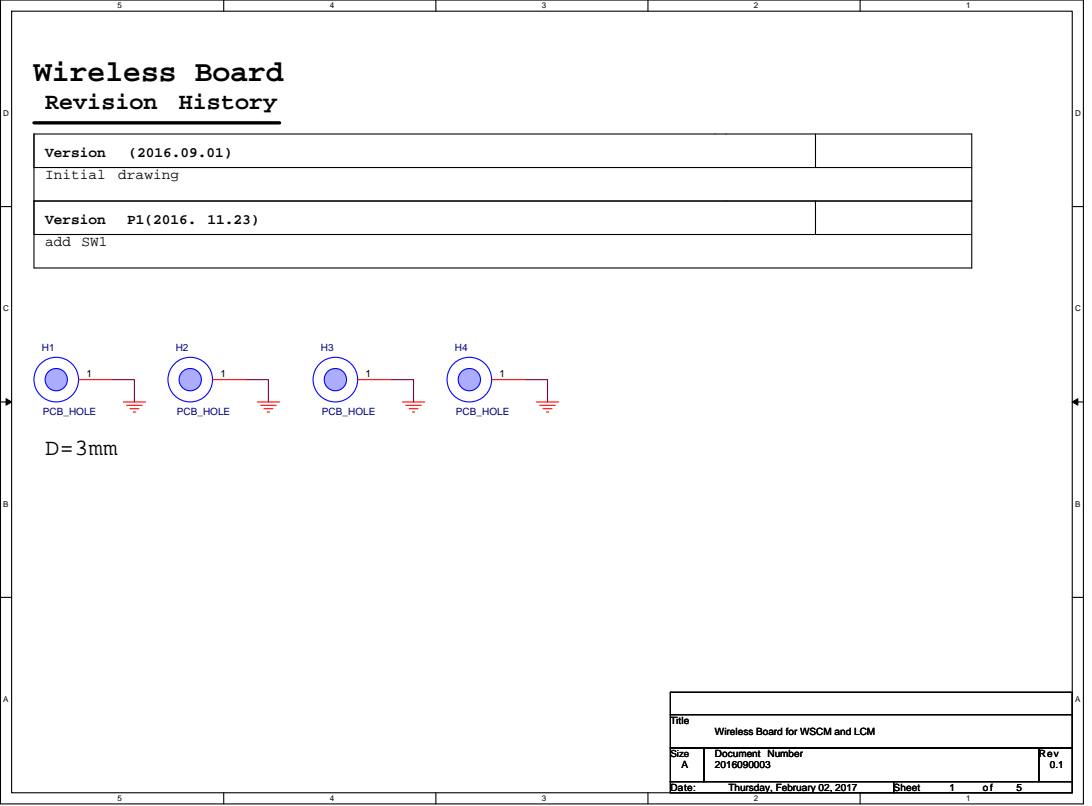
[picture p86: page 1]
Revision History; Version; add SW1; Title; PCB_HOLE

Wireless Board for WSCM and LCM

Size A | Document Number 2016090003 | Rev 0.1

Date: Thursday, February 02, 2017 Thursday, February 02, 2017 Thursday, February 02, 2017 | Sheet 1 1 1 of 5 5 5

UART_RX0 UART_TX0; UART_RX1 UART_TX1; Title; Thursday, February 02, 2017; POWER; 20 POWER; MCU; 00 MCU; UART_RX0; UART_RX1; UART_TX0; UART_TX1; UART; 10 UART

Wireless Board for SCM and LED_TOP

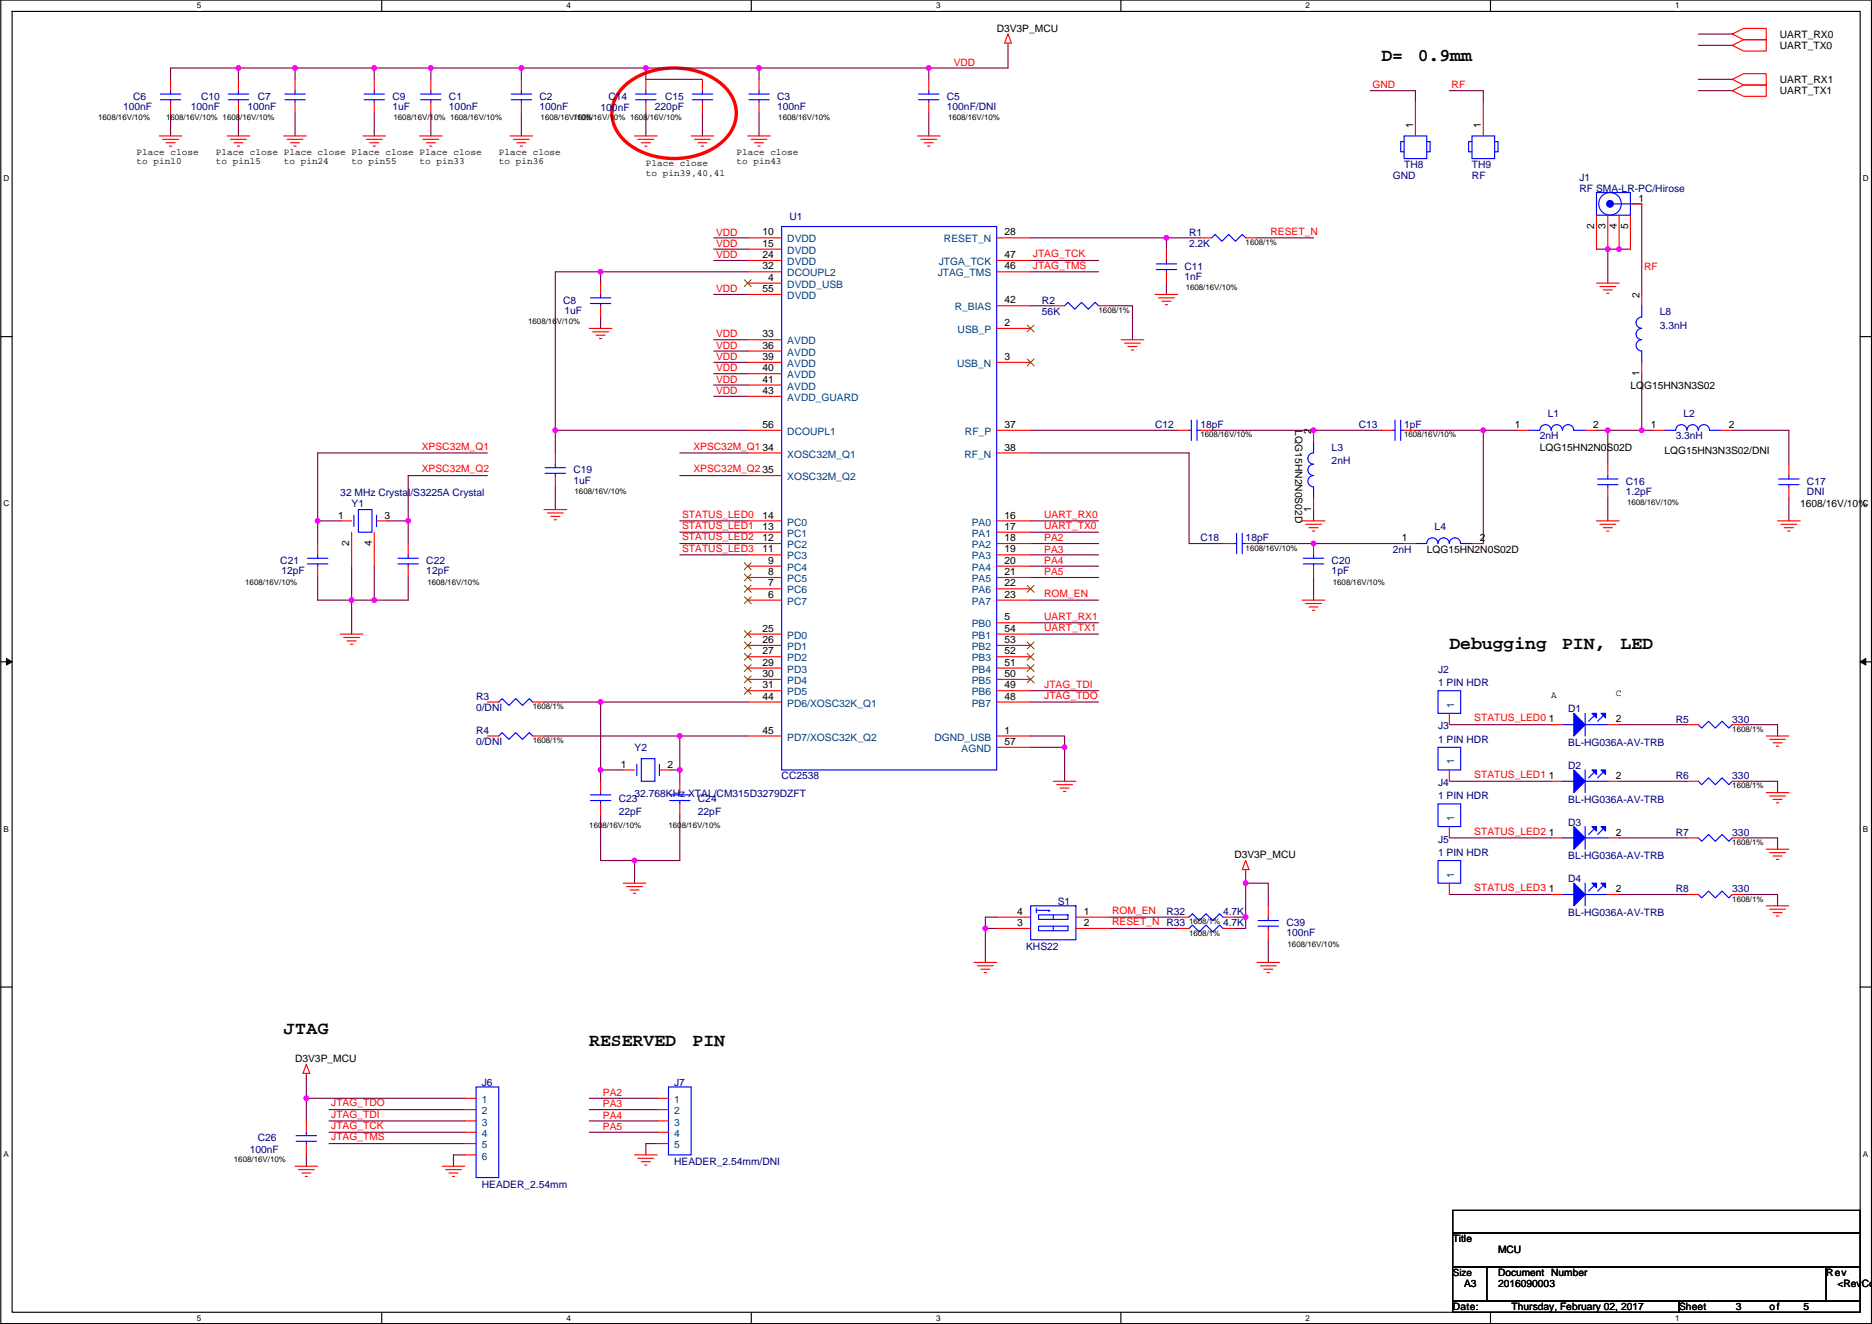
[picture p87: page 3]

RF SMA-LR-PC/Hirose

A3 A3 A3 | 2016090003 2016090003 2016090003 | <RevCo <RevCo <RevCo

Thursday, February 02, 2017 Thursday, February 02, 2017 Thursday, February 02, 2017 | 3 3 3 5 5 5

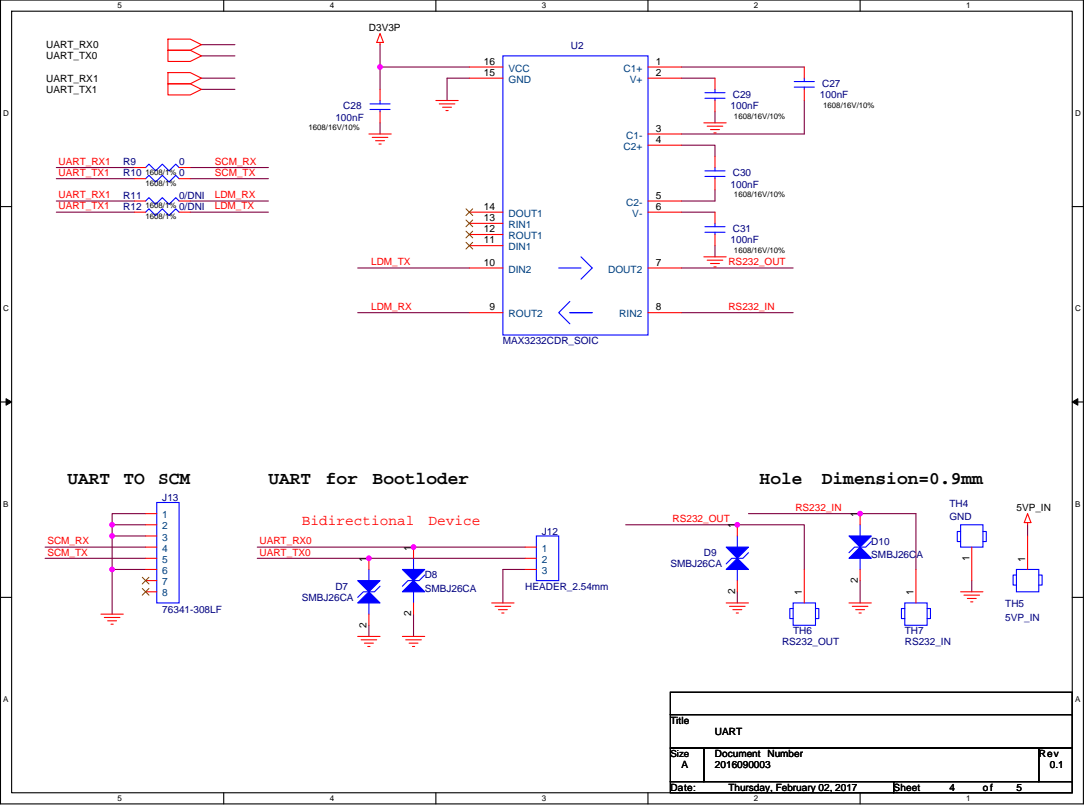
[picture p88: page 4]

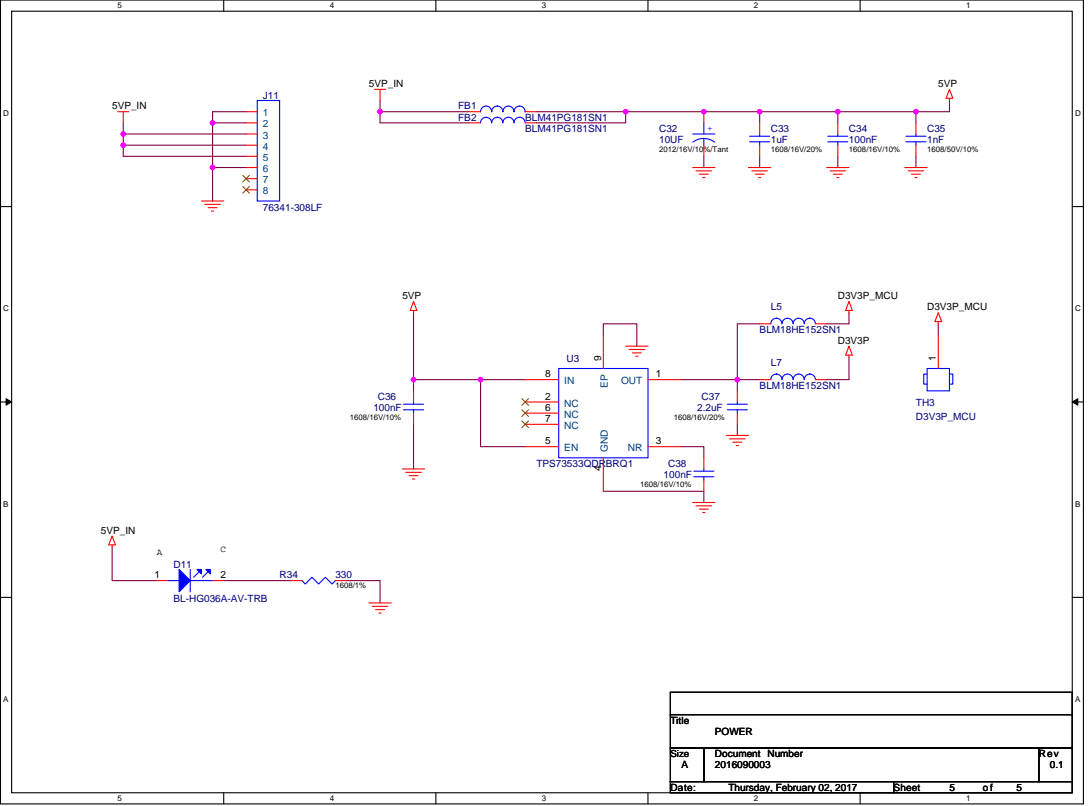
[picture p89: page 5]
