IGShare/01_WPGS/01_HW/02_WSCM/02_Development/01_WB/01_EVKit/01_CC2538/Gerber/CC2538EM_drill_1_2.pdf

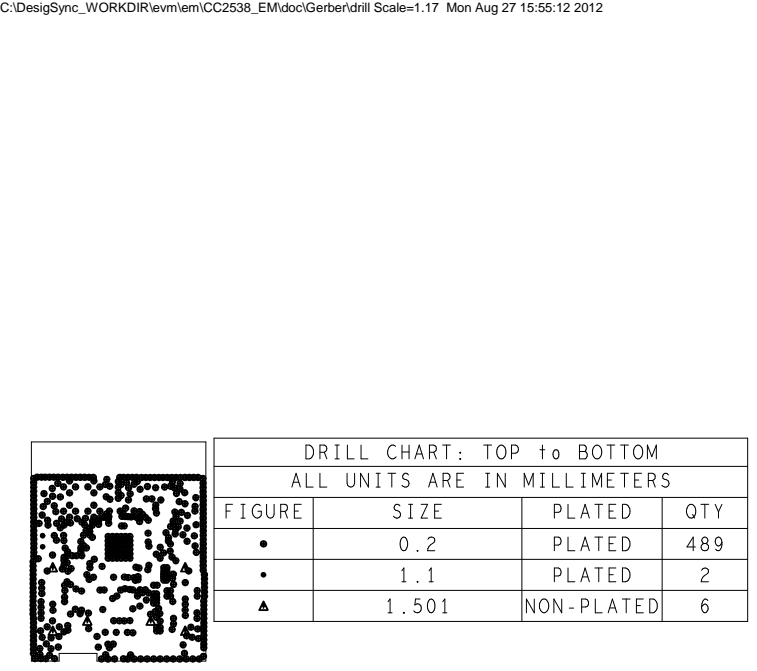
[picture p90: page 1]

C:\DesigSync_WORKDIR\evm\em\CC2538_EM\doc\Gerber\drill Scale=1.17 Mon Aug 27 15:55:12 2012
