IGShare/01_WPGS/01_HW/01_WSM/02_Development/02_P0/02_Artwork/gbr_pdf/fab.pdf

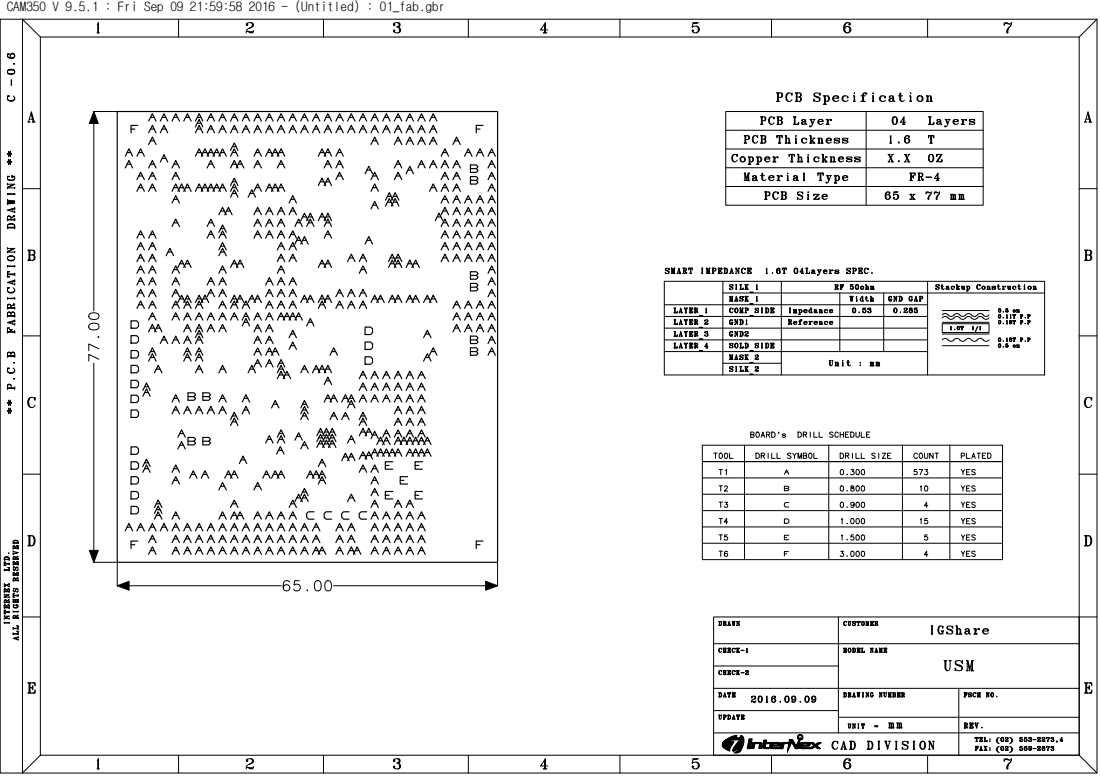
[picture p91: page 1]

CAM350 V 9.5.1 : Fri Sep 09 21:59:58 2016 - (Untitled) : 01_fab.gbr
