IGShare/01_WPGS/01_HW/01_WSM/02_Development/02_P0/02_Artwork/gbr_pdf/gbr_pdf.pdf

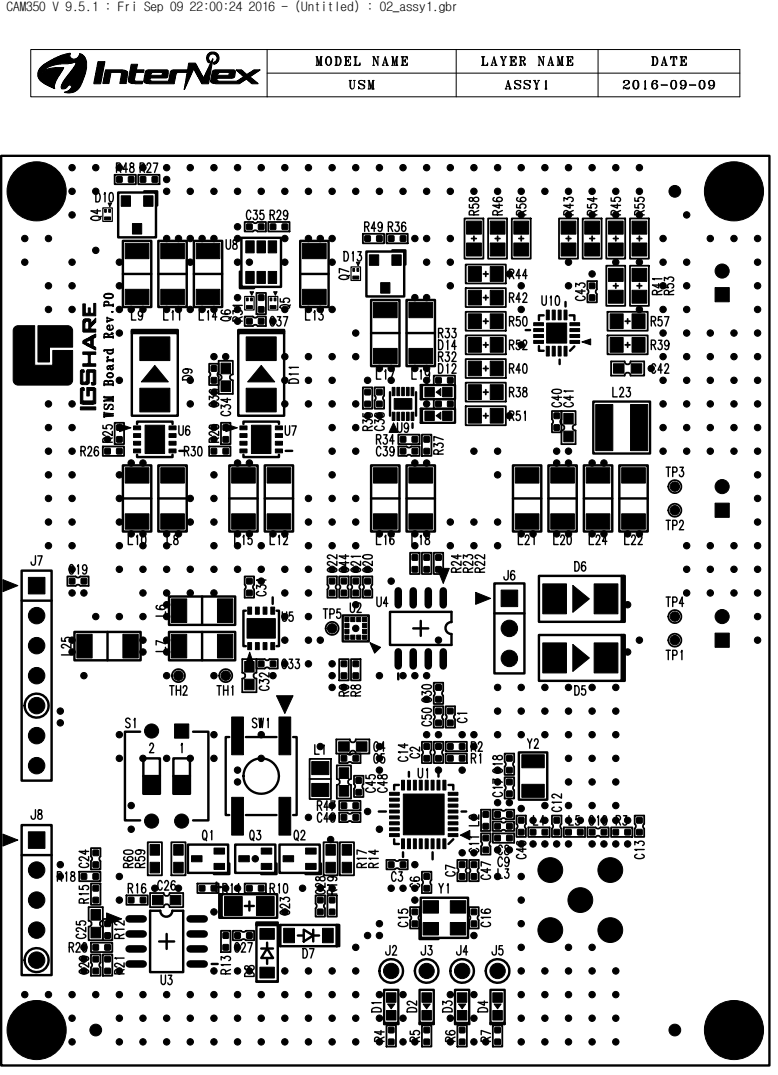
[picture p92: page 1]

CAM350 V 9.5.1 : Fri Sep 09 22:00:24 2016 - (Untitled) : 02_assy1.gbr

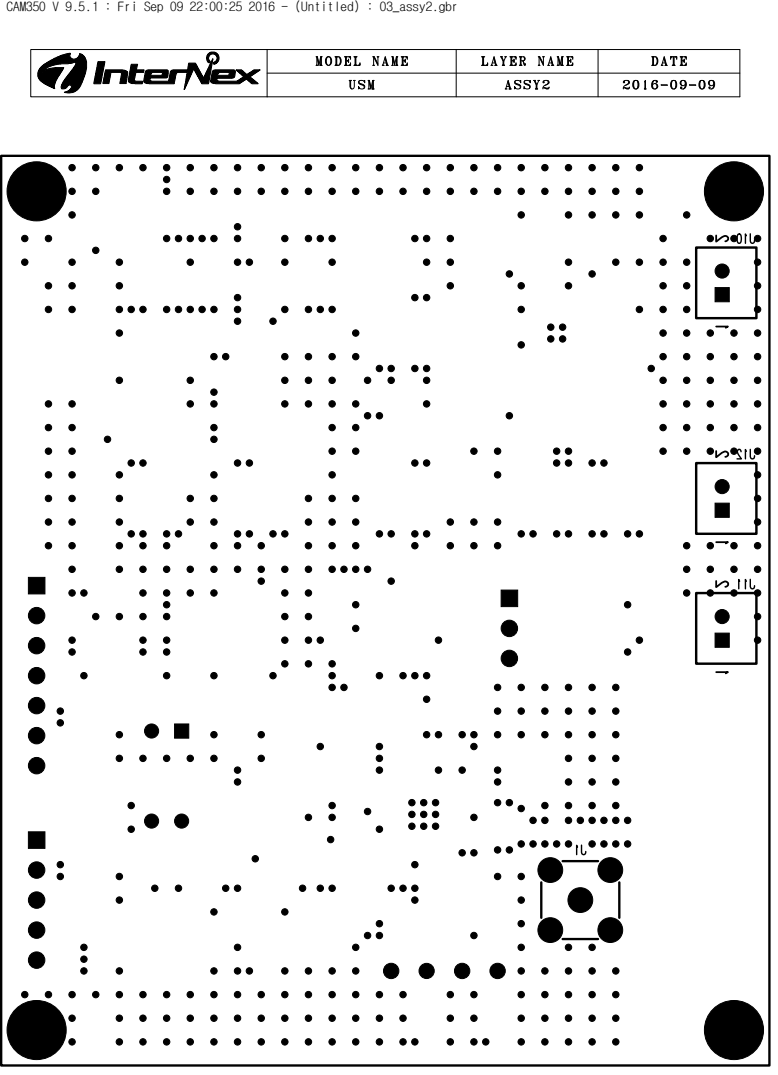
[picture p93: page 2]

CAM350 V 9.5.1 : Fri Sep 09 22:00:25 2016 - (Untitled) : 03_assy2.gbr

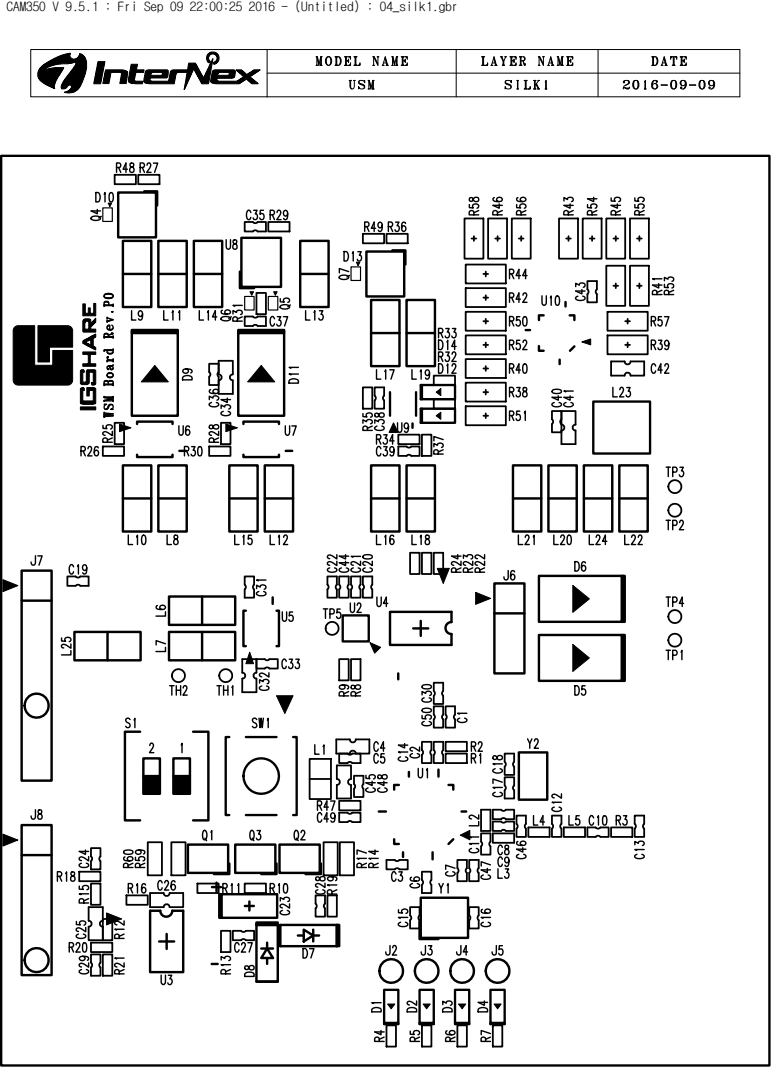
[picture p94: page 3]

CAM350 V 9.5.1 : Fri Sep 09 22:00:25 2016 - (Untitled) : 04_silk1.gbr

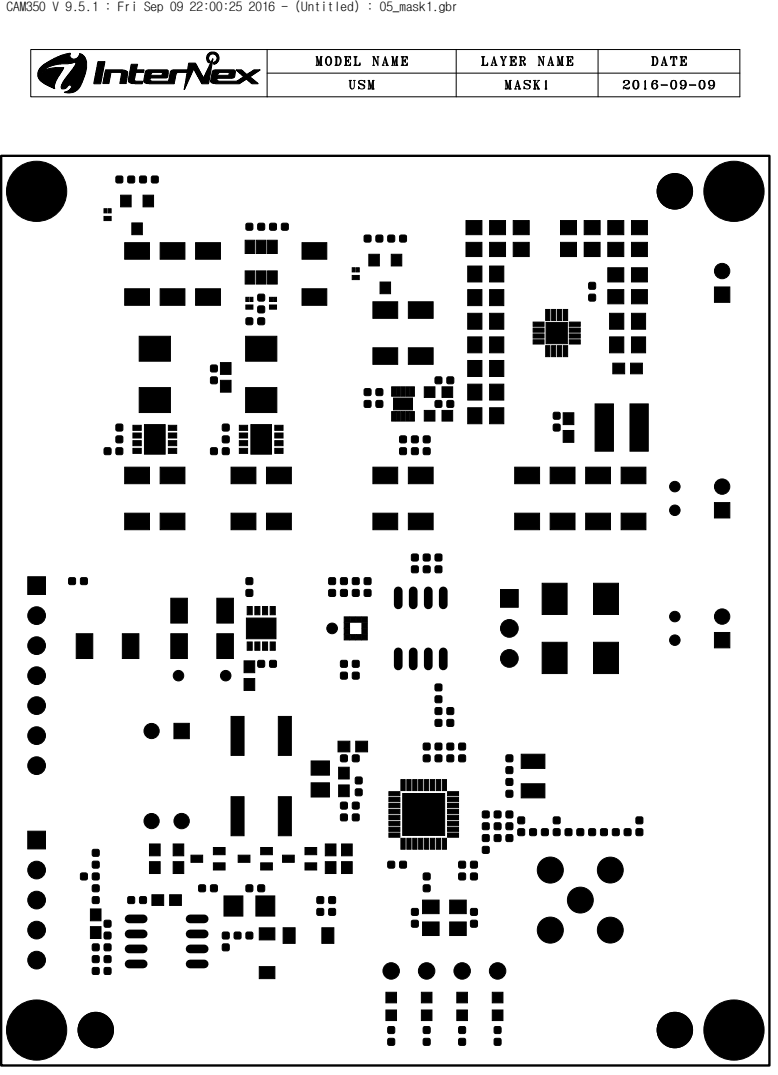
[picture p95: page 4]

CAM350 V 9.5.1 : Fri Sep 09 22:00:25 2016 - (Untitled) : 05_mask1.gbr

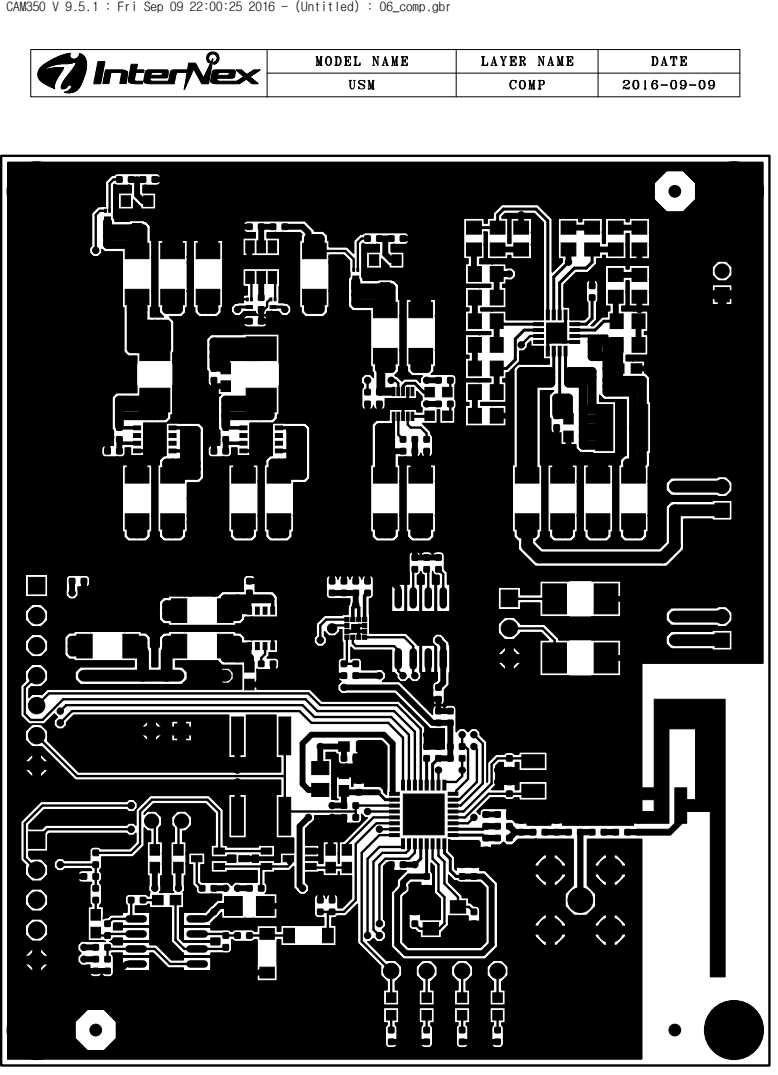
[picture p96: page 5]

CAM350 V 9.5.1 : Fri Sep 09 22:00:25 2016 - (Untitled) : 06_comp.gbr

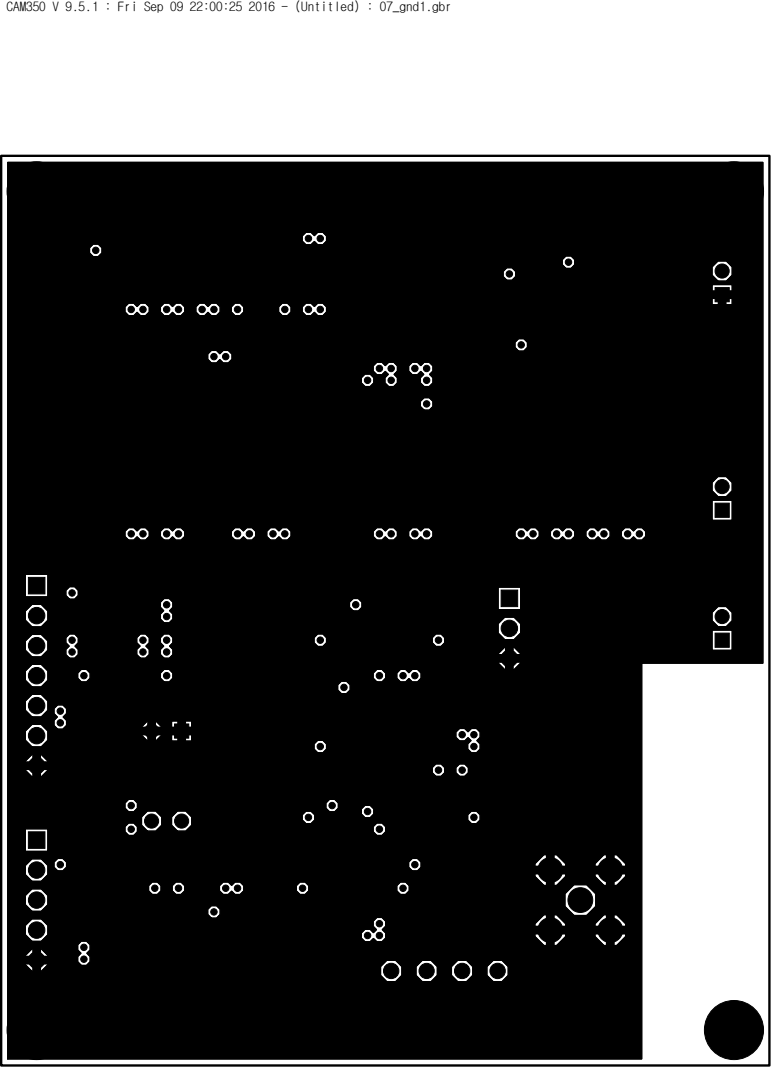
[picture p97: page 6]

CAM350 V 9.5.1 : Fri Sep 09 22:00:25 2016 - (Untitled) : 07_gnd1.gbr

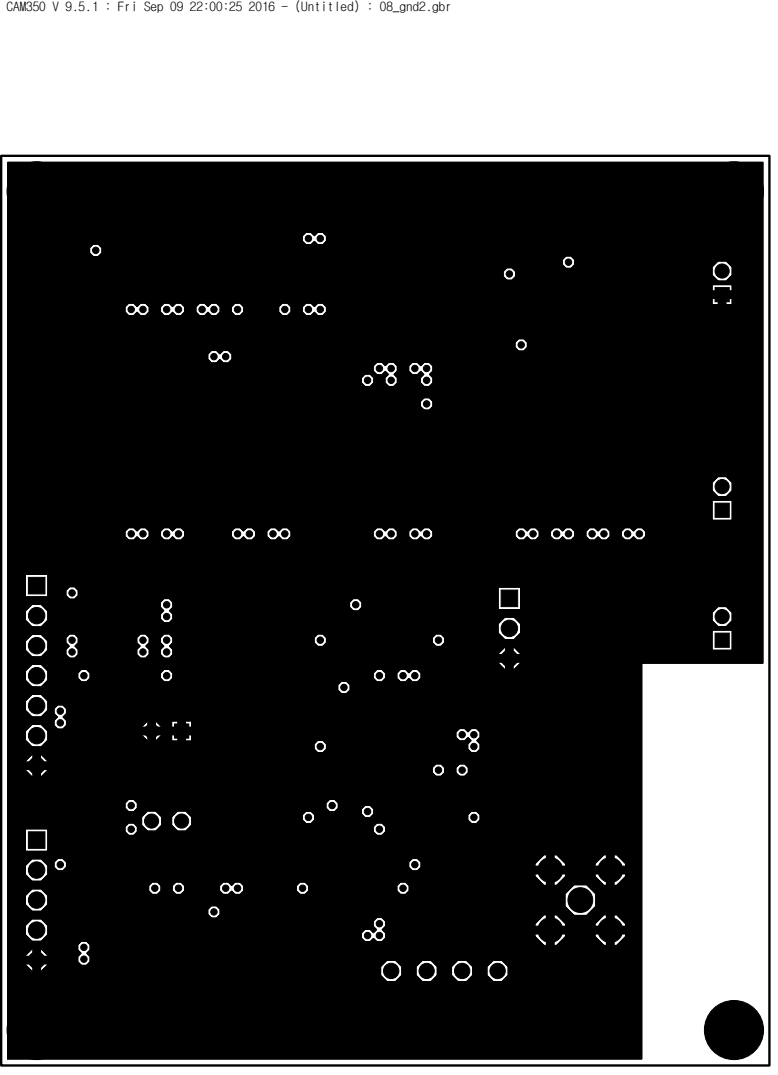
[picture p98: page 7]

CAM350 V 9.5.1 : Fri Sep 09 22:00:25 2016 - (Untitled) : 08_gnd2.gbr

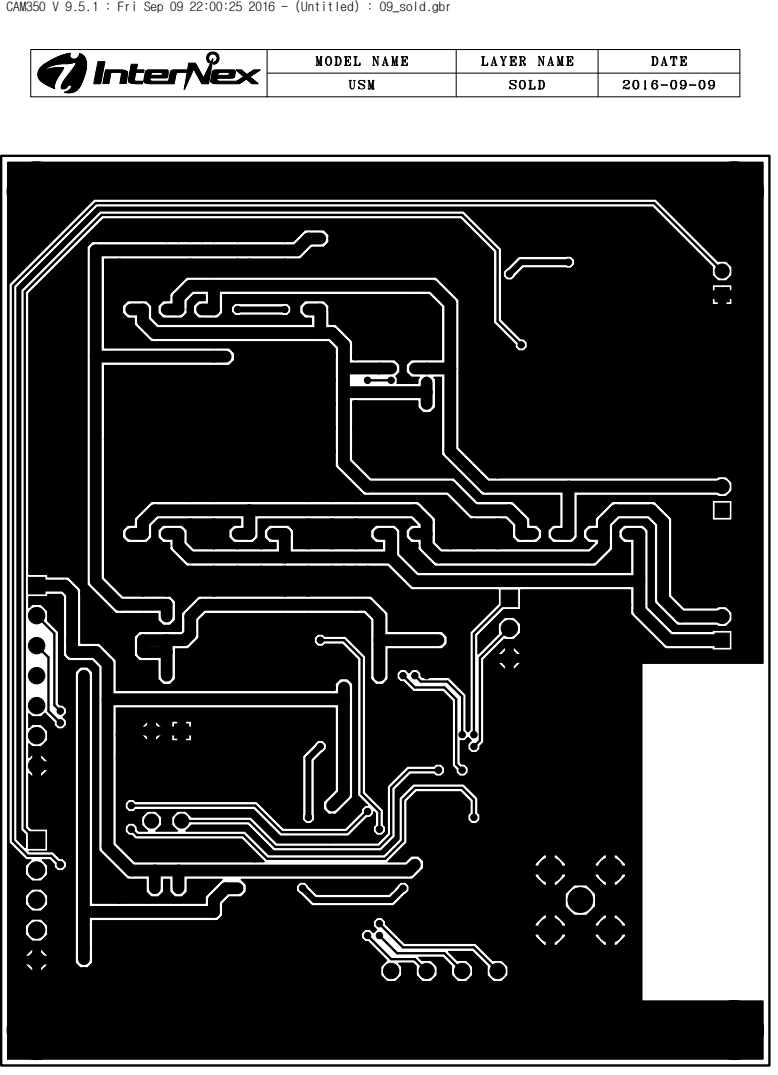
[picture p99: page 8]

CAM350 V 9.5.1 : Fri Sep 09 22:00:25 2016 - (Untitled) : 09_sold.gbr

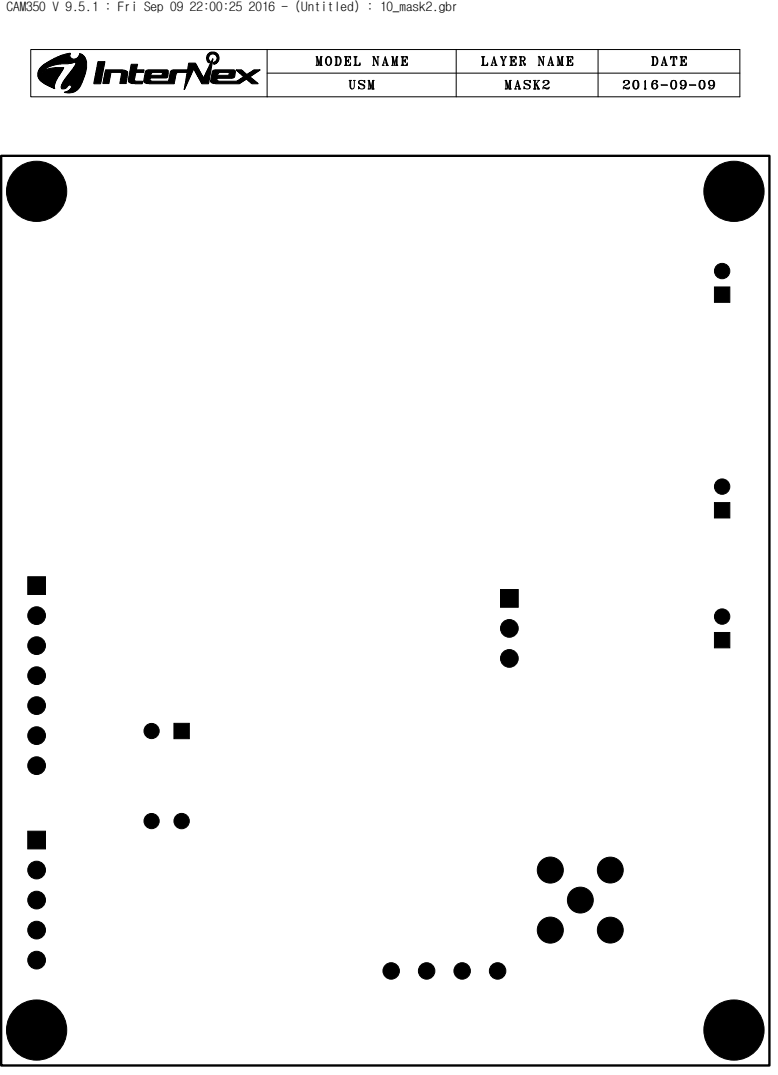
[picture p100: page 9]

CAM350 V 9.5.1 : Fri Sep 09 22:00:25 2016 - (Untitled) : 10_mask2.gbr

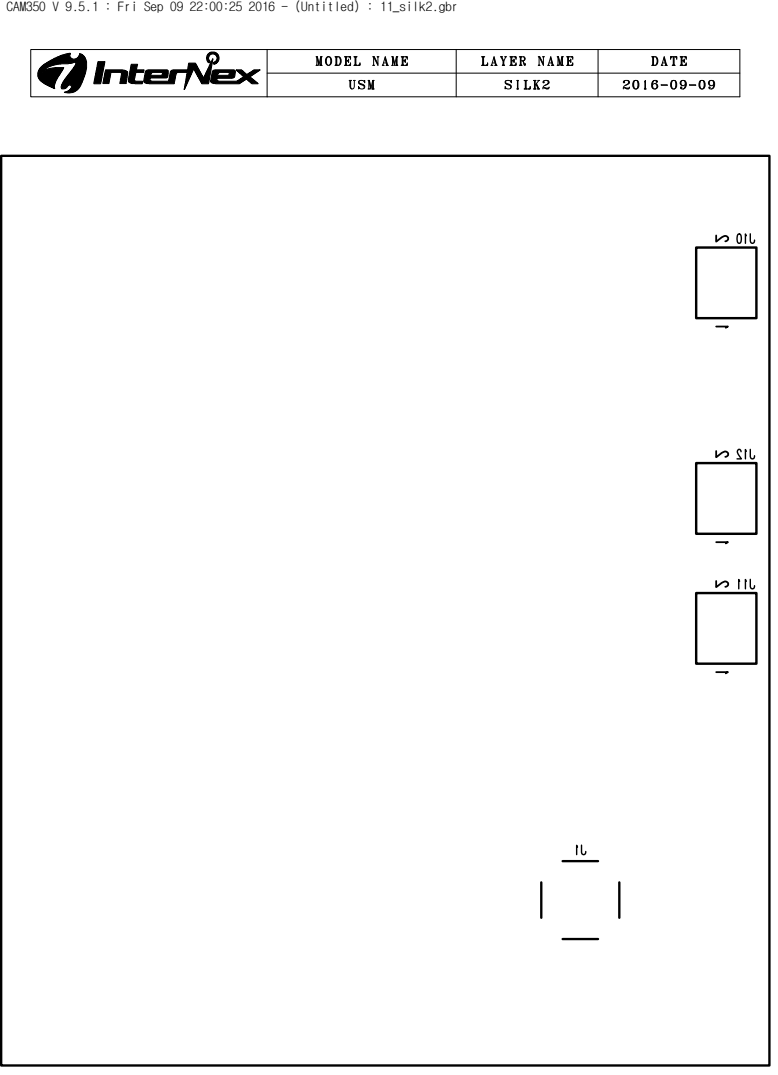
[picture p101: page 10]

CAM350 V 9.5.1 : Fri Sep 09 22:00:25 2016 - (Untitled) : 11_silk2.gbr

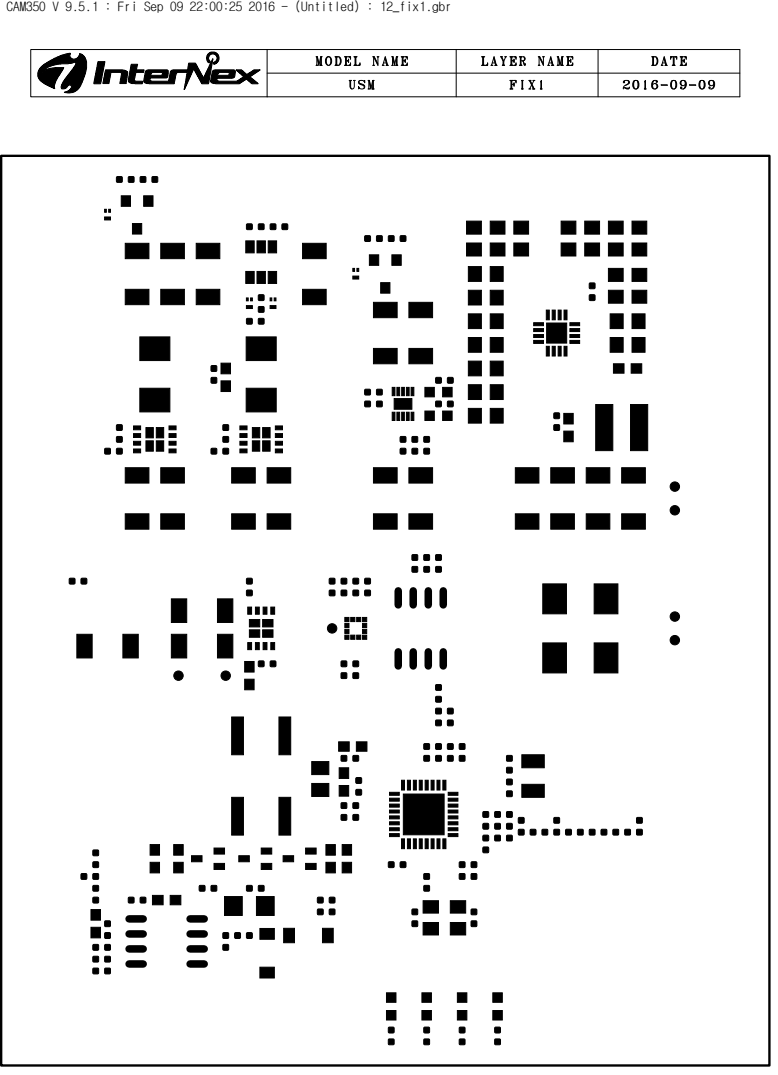
[picture p102: page 11]

CAM350 V 9.5.1 : Fri Sep 09 22:00:25 2016 - (Untitled) : 12_fix1.gbr

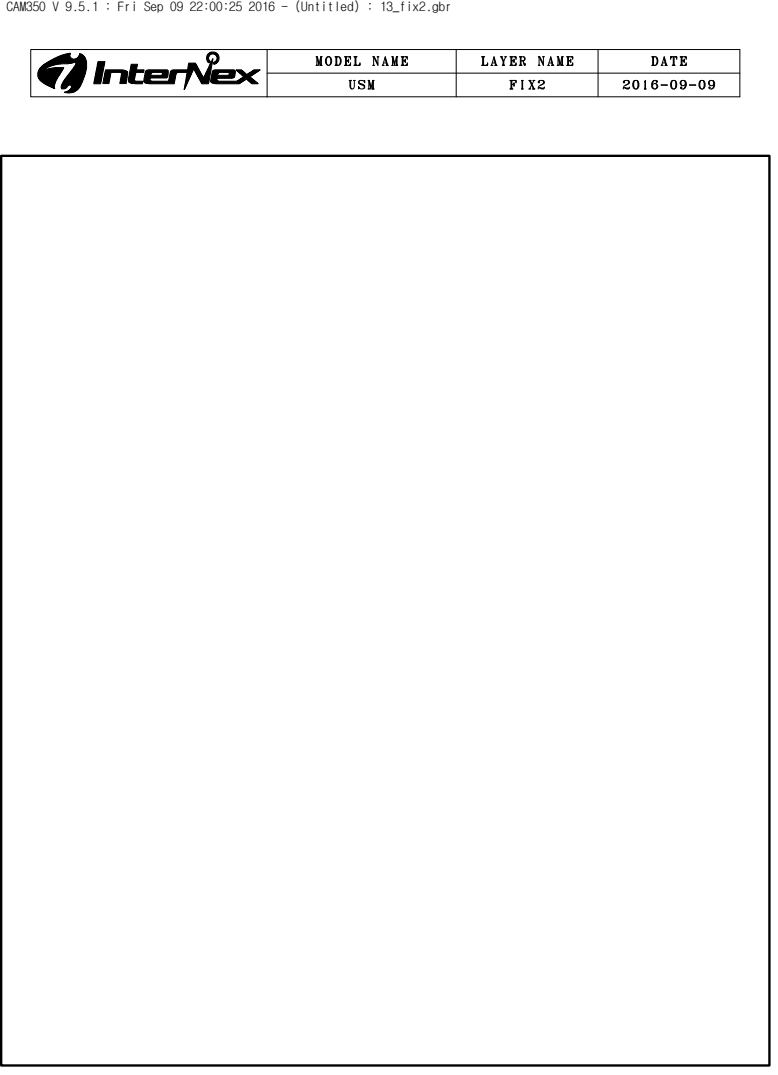
[picture p103: page 12]

CAM350 V 9.5.1 : Fri Sep 09 22:00:25 2016 - (Untitled) : 13_fix2.gbr
