IGShare/01_WPGS/01_HW/01_WSM/02_Development/03_P1/02_Artwork/gbr_pdf/fab.pdf

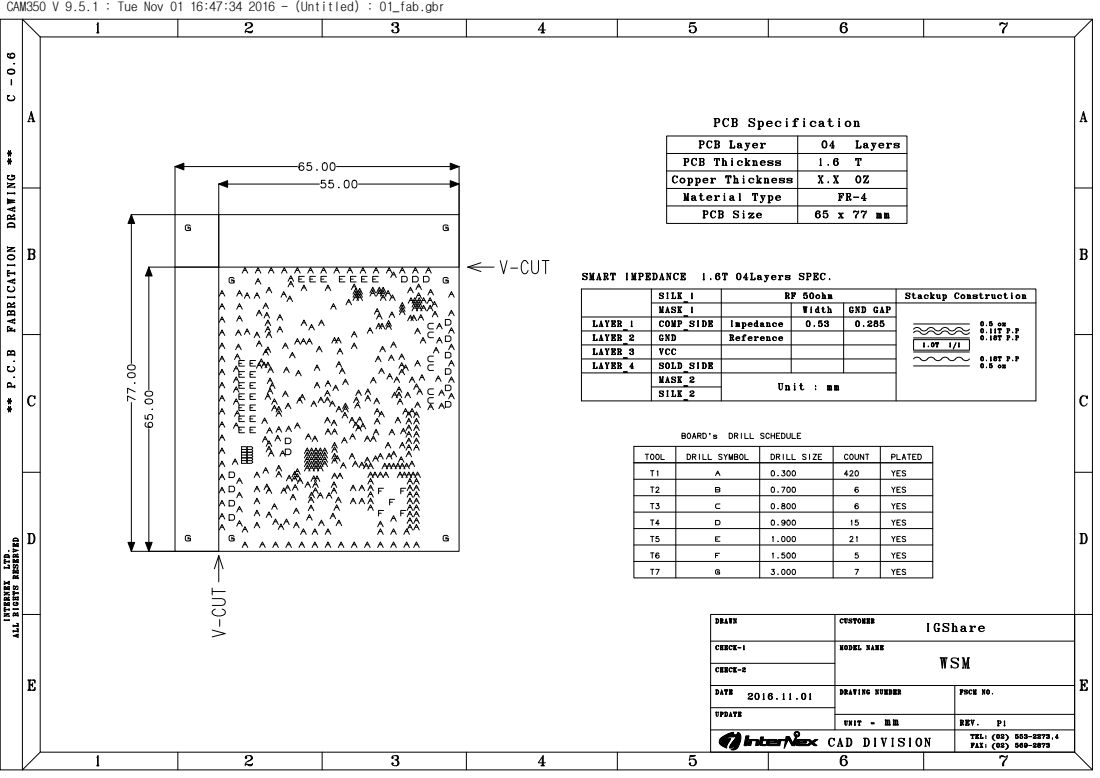
[picture p104: page 1]

CAM350 V 9.5.1 : Tue Nov 01 16:47:34 2016 - (Untitled) : 01_fab.gbr
