IGShare/01_WPGS/01_HW/01_WSM/02_Development/03_P1/02_Artwork/gbr_pdf/gbr_pdf.pdf

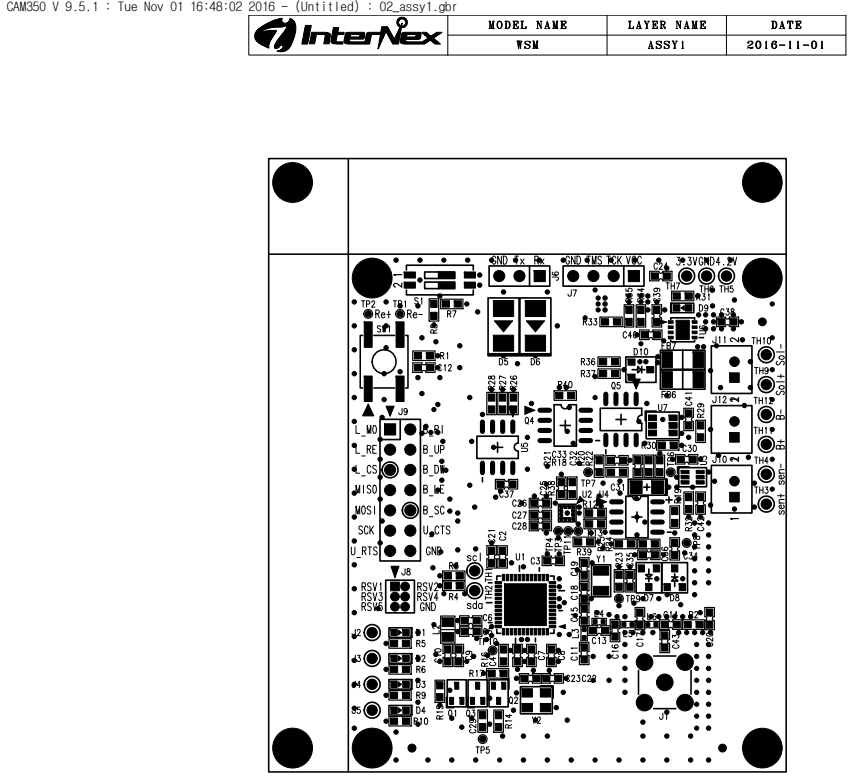
[picture p105: page 1]

CAM350 V 9.5.1 : Tue Nov 01 16:48:02 2016 - (Untitled) : 02_assy1.gbr

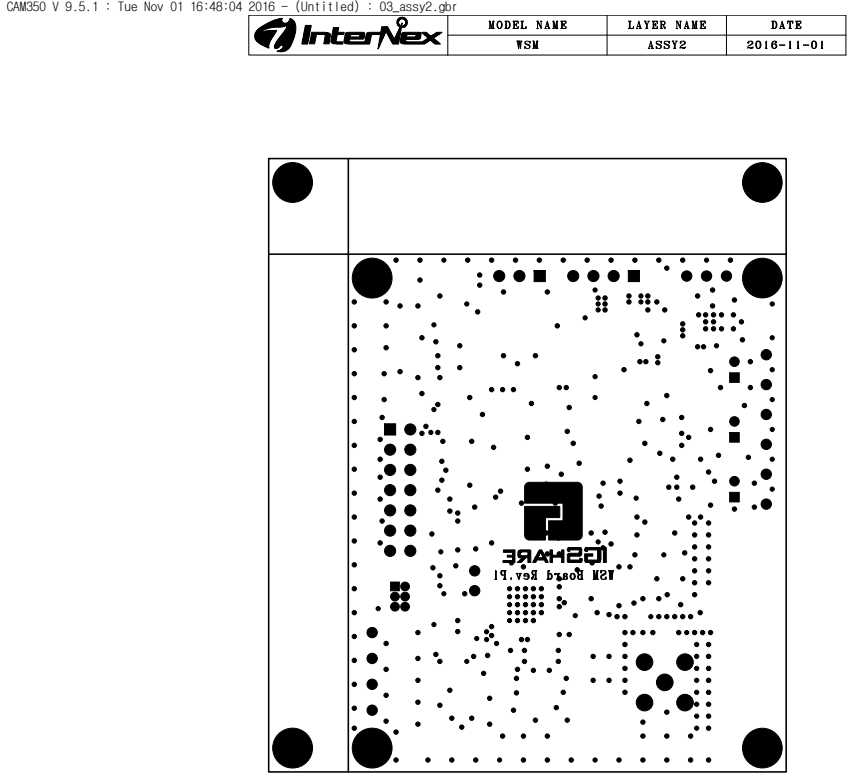
[picture p106: page 2]

CAM350 V 9.5.1 : Tue Nov 01 16:48:04 2016 - (Untitled) : 03_assy2.gbr

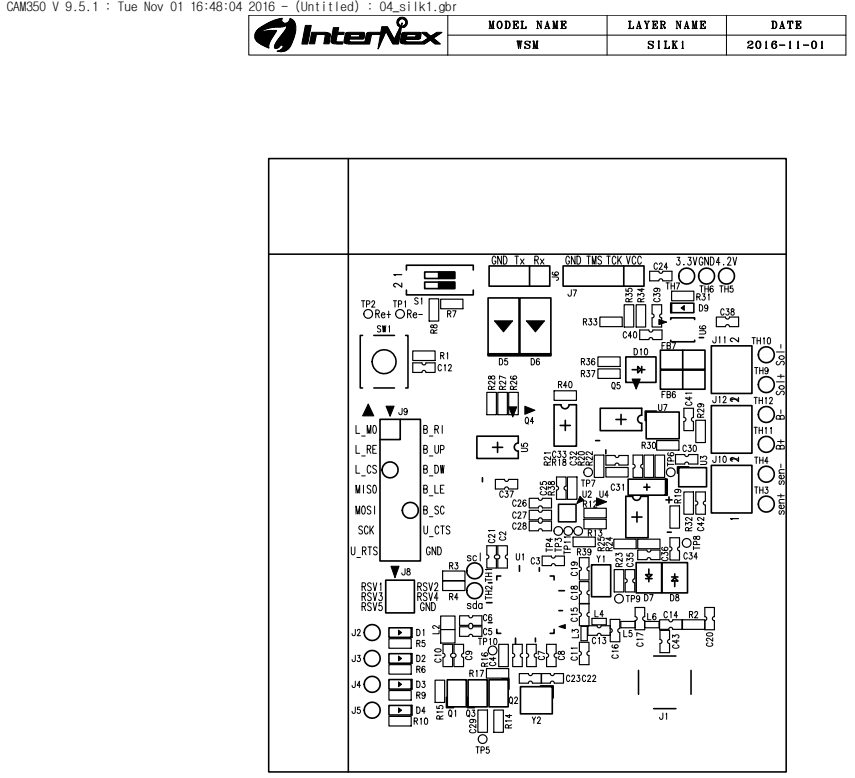
[picture p107: page 3]

CAM350 V 9.5.1 : Tue Nov 01 16:48:04 2016 - (Untitled) : 04_silk1.gbr

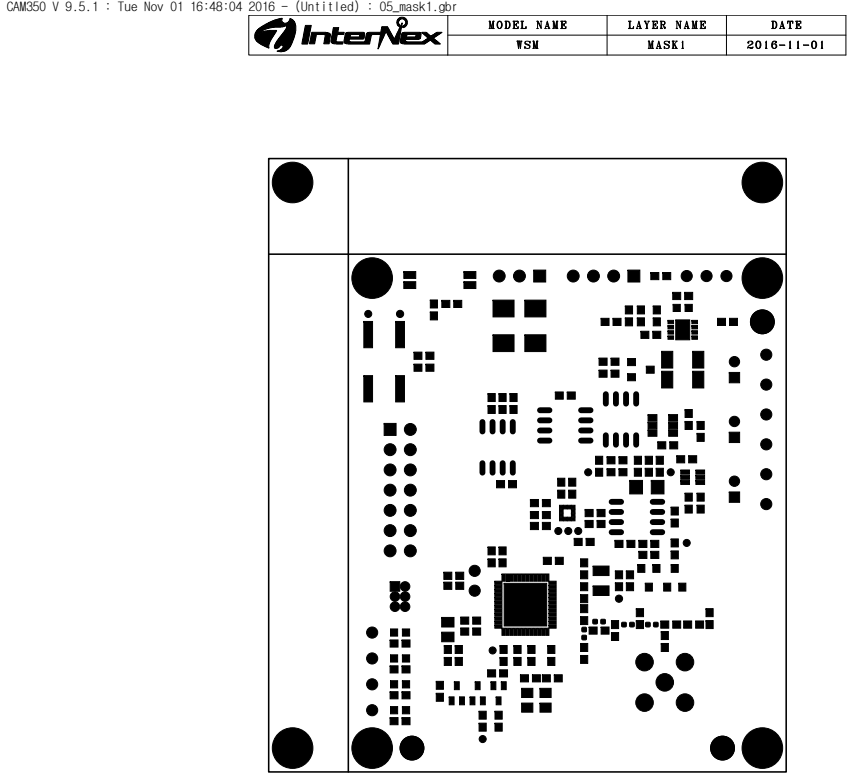
[picture p108: page 4]

CAM350 V 9.5.1 : Tue Nov 01 16:48:04 2016 - (Untitled) : 05_mask1.gbr

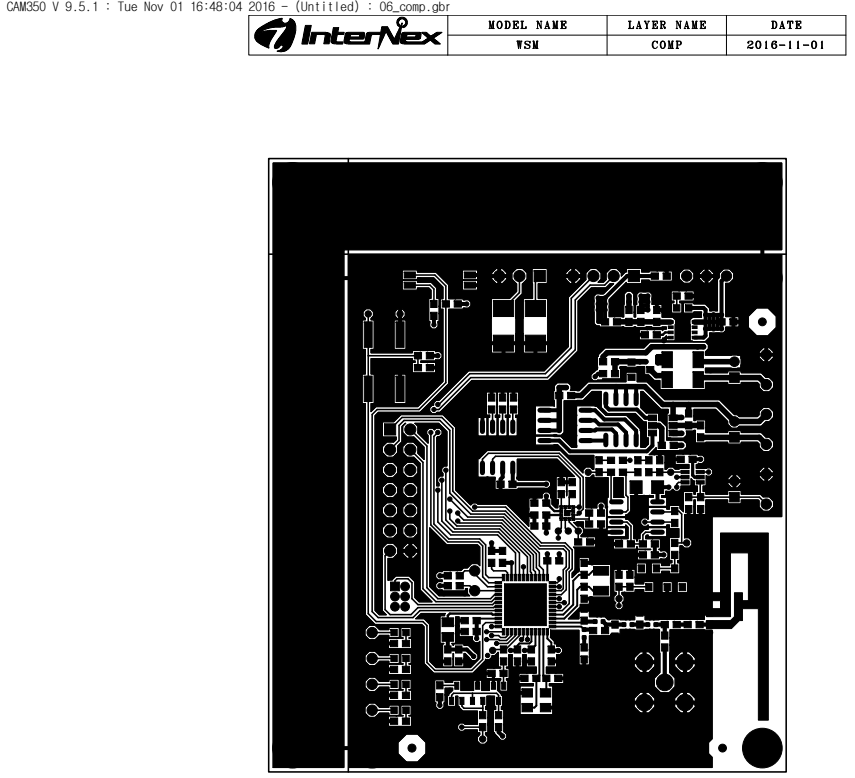
[picture p109: page 5]

CAM350 V 9.5.1 : Tue Nov 01 16:48:04 2016 - (Untitled) : 06_comp.gbr

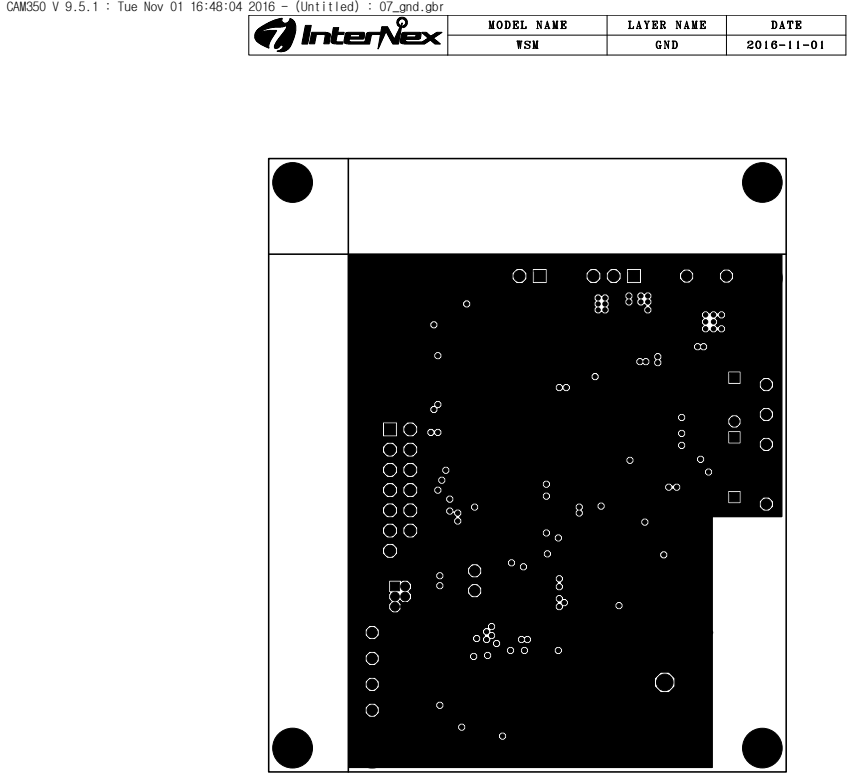
[picture p110: page 6]

CAM350 V 9.5.1 : Tue Nov 01 16:48:04 2016 - (Untitled) : 07_gnd.gbr

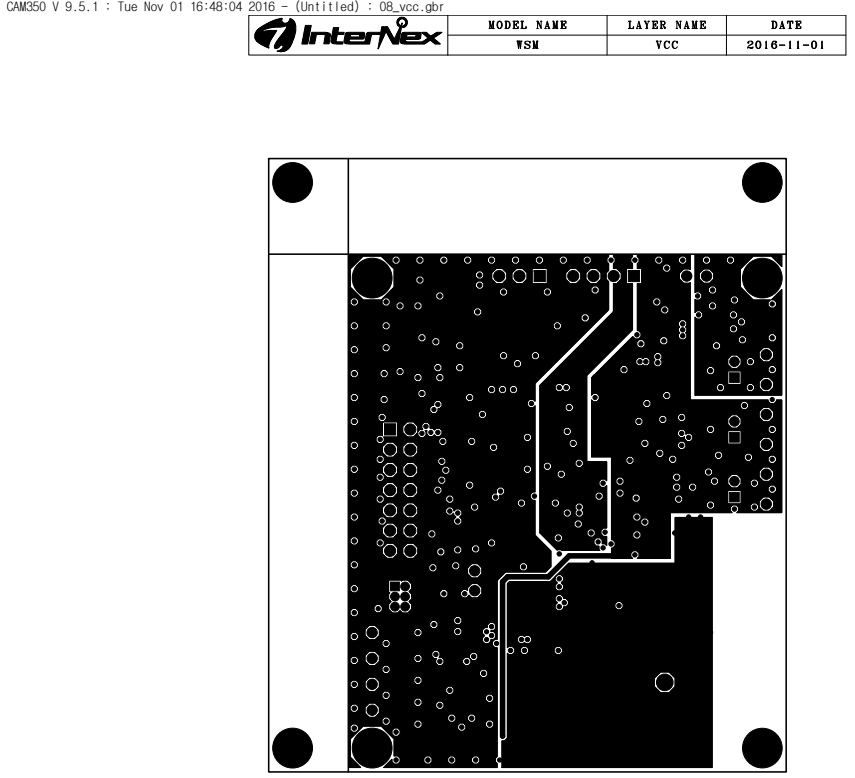
[picture p111: page 7]

CAM350 V 9.5.1 : Tue Nov 01 16:48:04 2016 - (Untitled) : 08_vcc.gbr

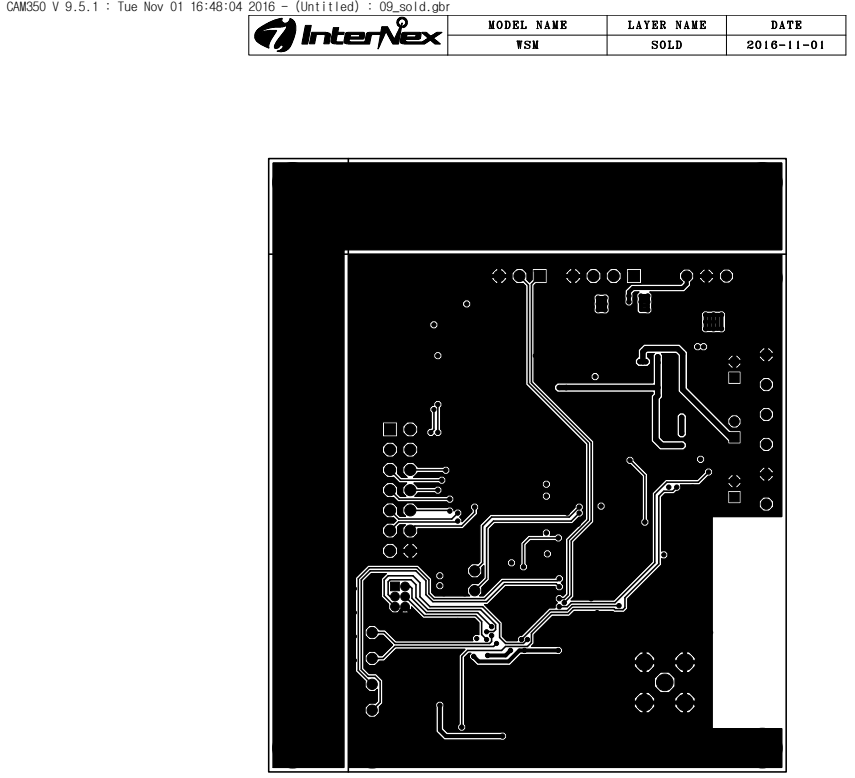
[picture p112: page 8]

CAM350 V 9.5.1 : Tue Nov 01 16:48:04 2016 - (Untitled) : 09_sold.gbr

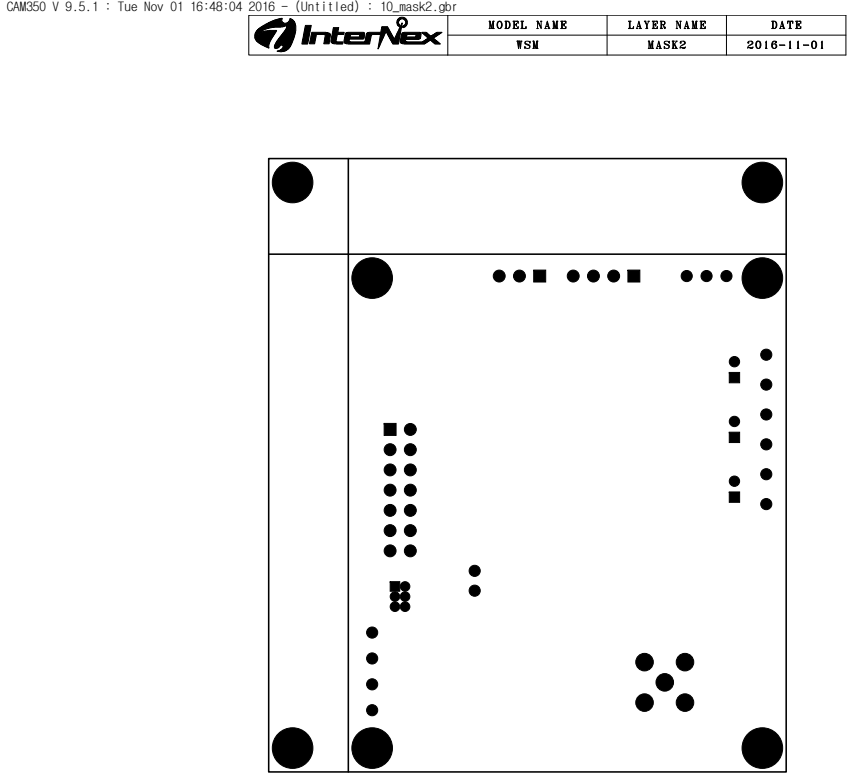
[picture p113: page 9]

CAM350 V 9.5.1 : Tue Nov 01 16:48:04 2016 - (Untitled) : 10_mask2.gbr

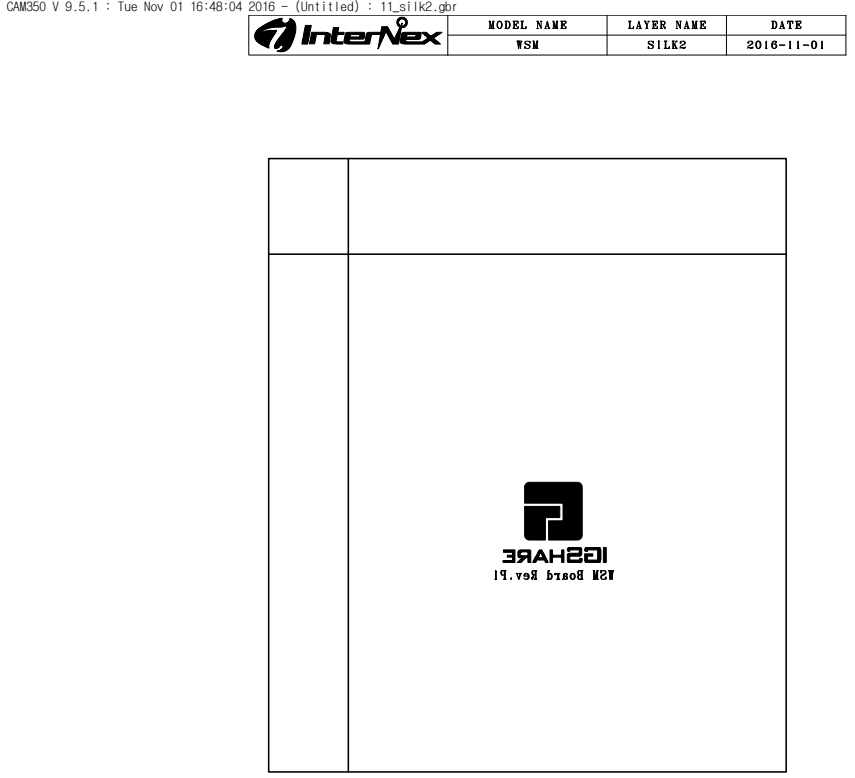
[picture p114: page 10]

CAM350 V 9.5.1 : Tue Nov 01 16:48:04 2016 - (Untitled) : 11_silk2.gbr

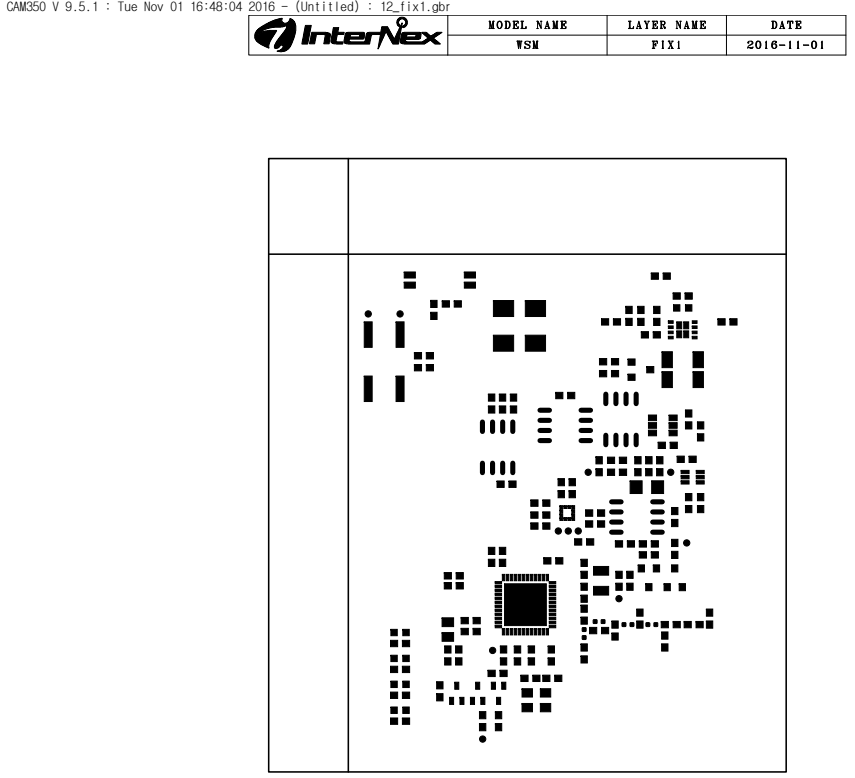
[picture p115: page 11]

CAM350 V 9.5.1 : Tue Nov 01 16:48:04 2016 - (Untitled) : 12_fix1.gbr

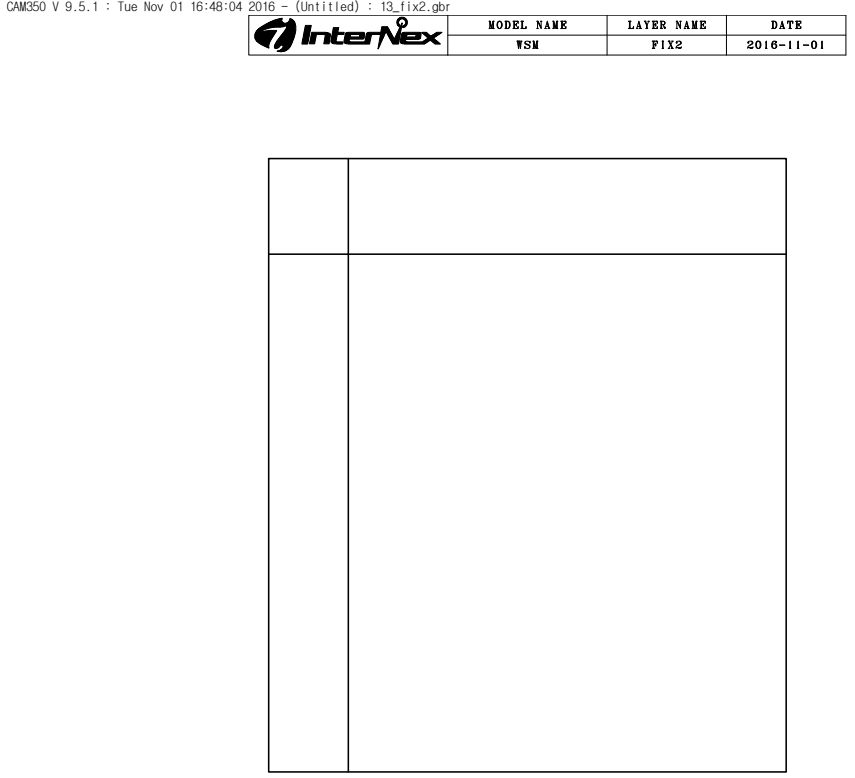
[picture p116: page 12]

CAM350 V 9.5.1 : Tue Nov 01 16:48:04 2016 - (Untitled) : 13_fix2.gbr
