IGShare/01_WPGS/01_HW/01_WSM/02_Development/05_P3/02_Artwork/wsm_p3_완료/wsm_p3_20170904.pdf

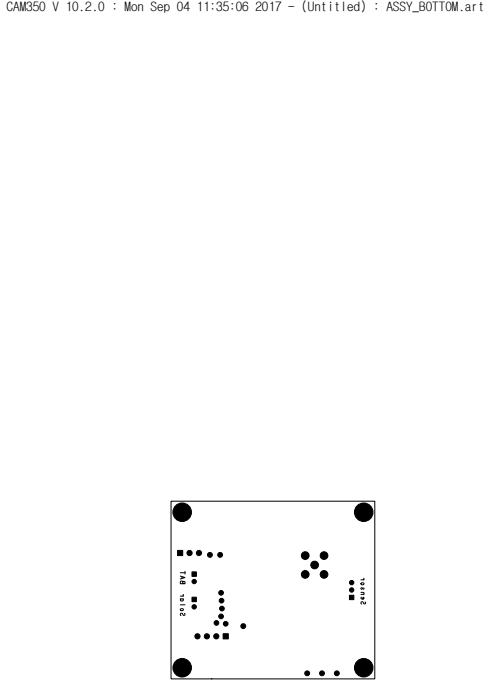
[picture p117: page 1]

CAM350 V 10.2.0 : Mon Sep 04 11:35:06 2017 - (Untitled) : ASSY_BOTTOM.art

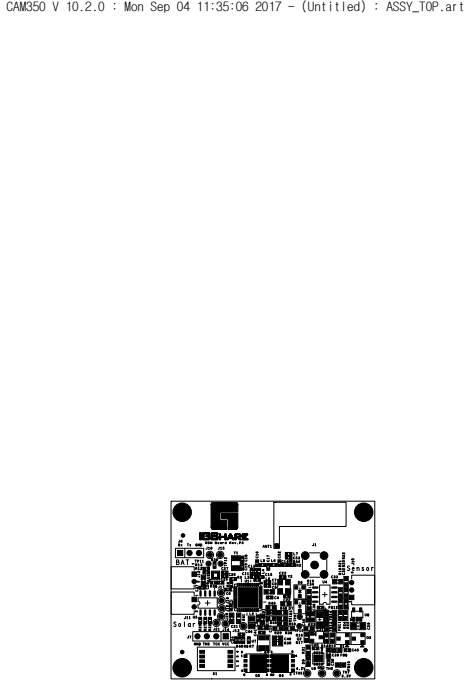
[picture p118: page 2]

CAM350 V 10.2.0 : Mon Sep 04 11:35:06 2017 - (Untitled) : ASSY_TOP.art

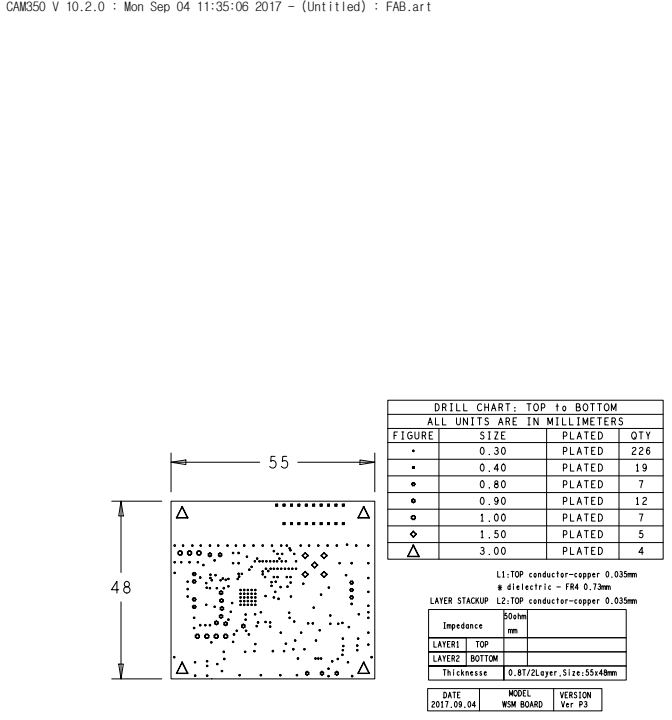
[picture p119: page 3]

CAM350 V 10.2.0 : Mon Sep 04 11:35:06 2017 - (Untitled) : FAB.art

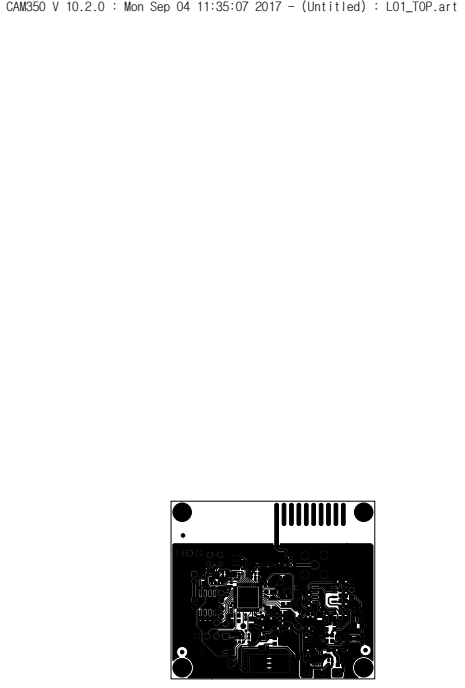
[picture p120: page 4]

CAM350 V 10.2.0 : Mon Sep 04 11:35:07 2017 - (Untitled) : L01_TOP.art

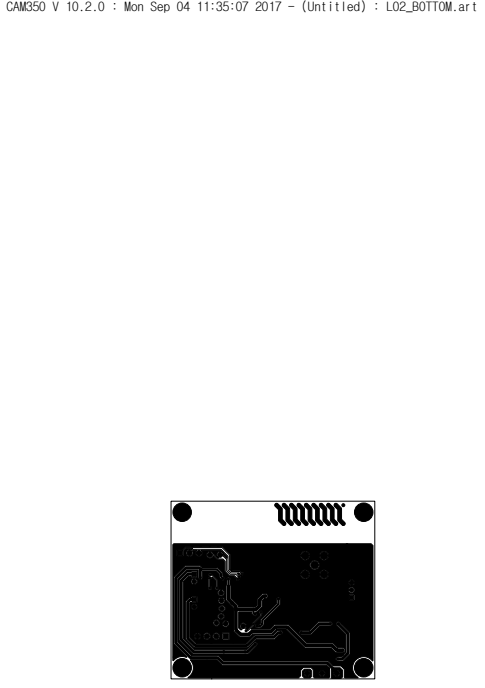
[picture p121: page 5]

CAM350 V 10.2.0 : Mon Sep 04 11:35:07 2017 - (Untitled) : L02_BOTTOM.art

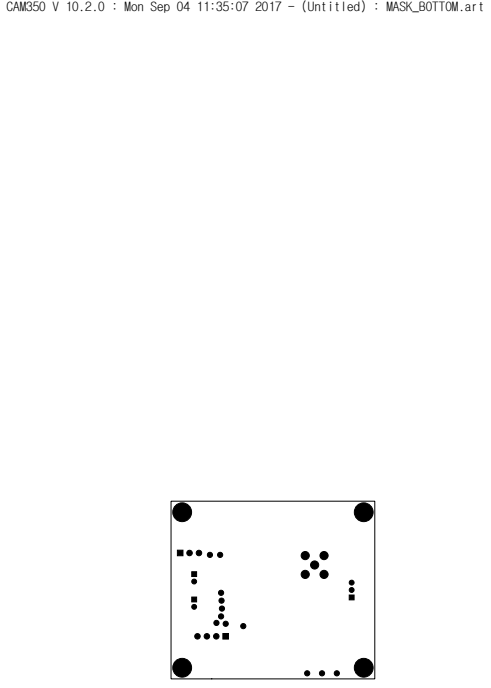
[picture p122: page 6]

CAM350 V 10.2.0 : Mon Sep 04 11:35:07 2017 - (Untitled) : MASK_BOTTOM.art

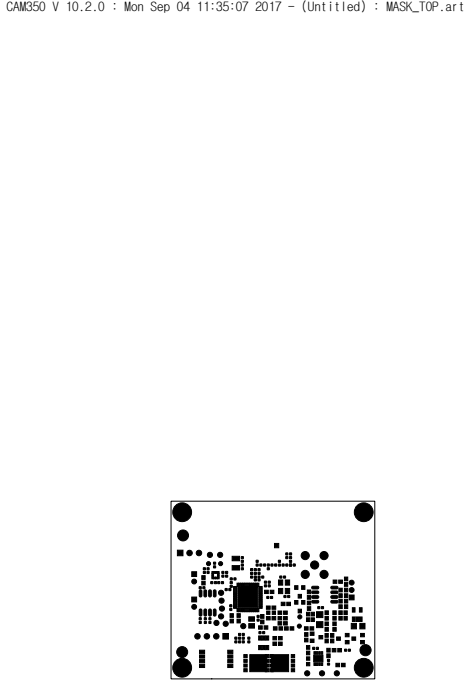
[picture p123: page 7]

CAM350 V 10.2.0 : Mon Sep 04 11:35:07 2017 - (Untitled) : MASK_TOP.art

CAM350 V 10.2.0 : Mon Sep 04 11:35:07 2017 - (Untitled) : PASTE_BOTTOM.art

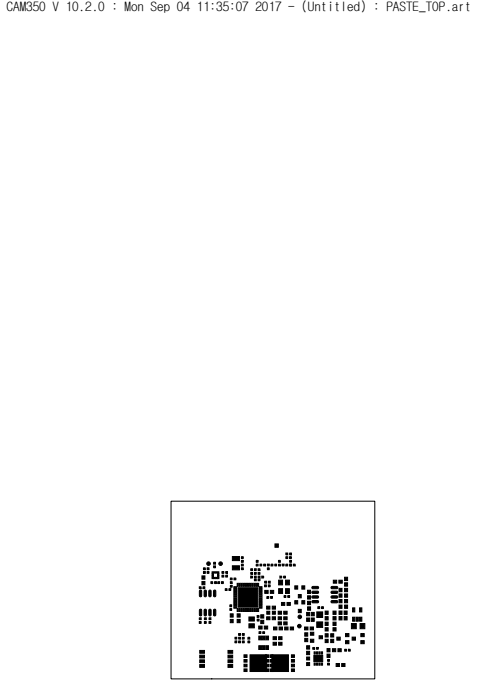
[picture p124: page 9]

CAM350 V 10.2.0 : Mon Sep 04 11:35:07 2017 - (Untitled) : PASTE_TOP.art

CAM350 V 10.2.0 : Mon Sep 04 11:35:07 2017 - (Untitled) : SILK_BOTTOM.art

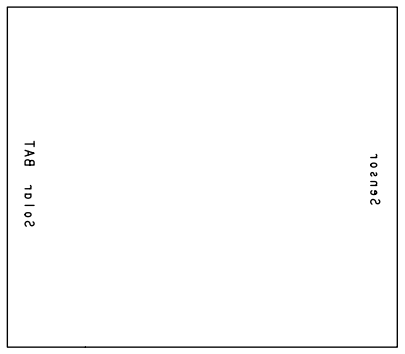
[picture p125: figure]
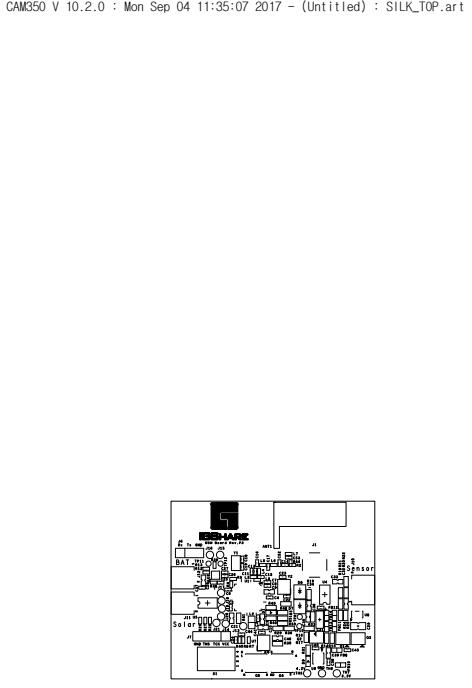
[picture p126: page 11]

CAM350 V 10.2.0 : Mon Sep 04 11:35:07 2017 - (Untitled) : SILK_TOP.art

CAM350 V 10.2.0 : Mon Sep 04 11:35:07 2017 - (Untitled) : wsm_p3_20170904-1-2.drl
