IGShare/01_WPGS/01_HW/02_WSCM/02_Development/01_WB/03_P1/02_Artwork/gbr_pdf/fab.pdf

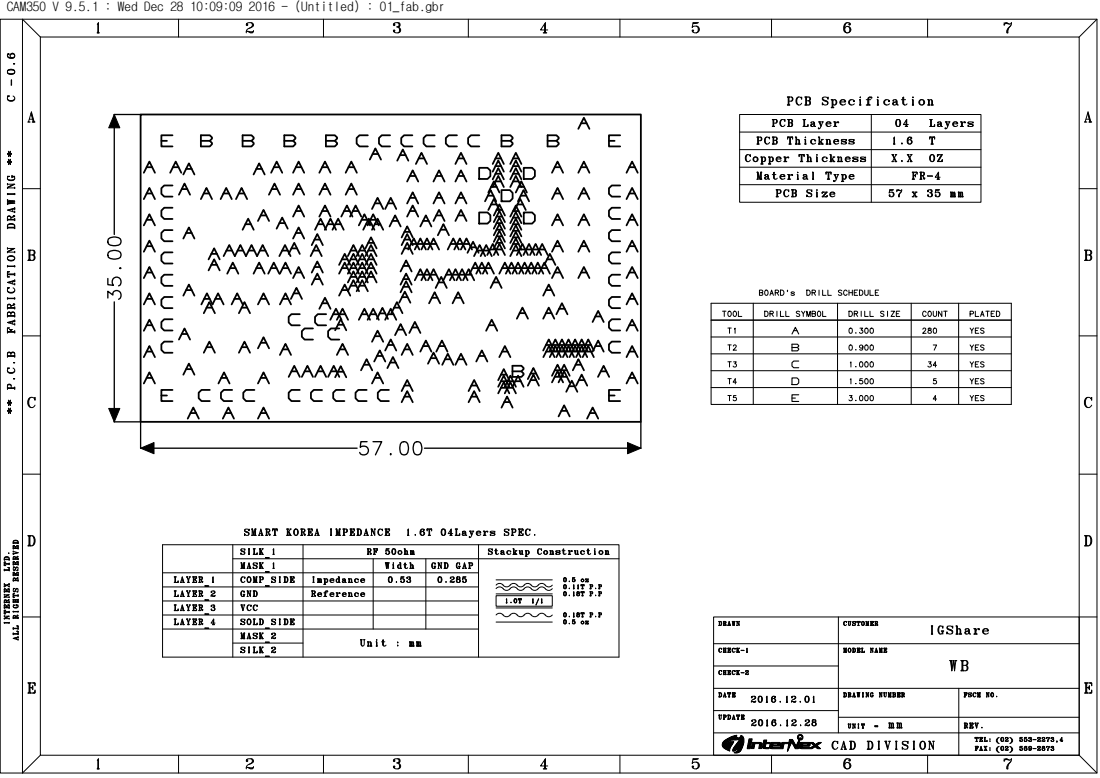
[picture p127: page 1]

CAM350 V 9.5.1 : Wed Dec 28 10:09:09 2016 - (Untitled) : 01_fab.gbr
