IGShare/01_WPGS/01_HW/02_WSCM/02_Development/01_WB/03_P1/02_Artwork/gbr_pdf/gbr_pdf.pdf

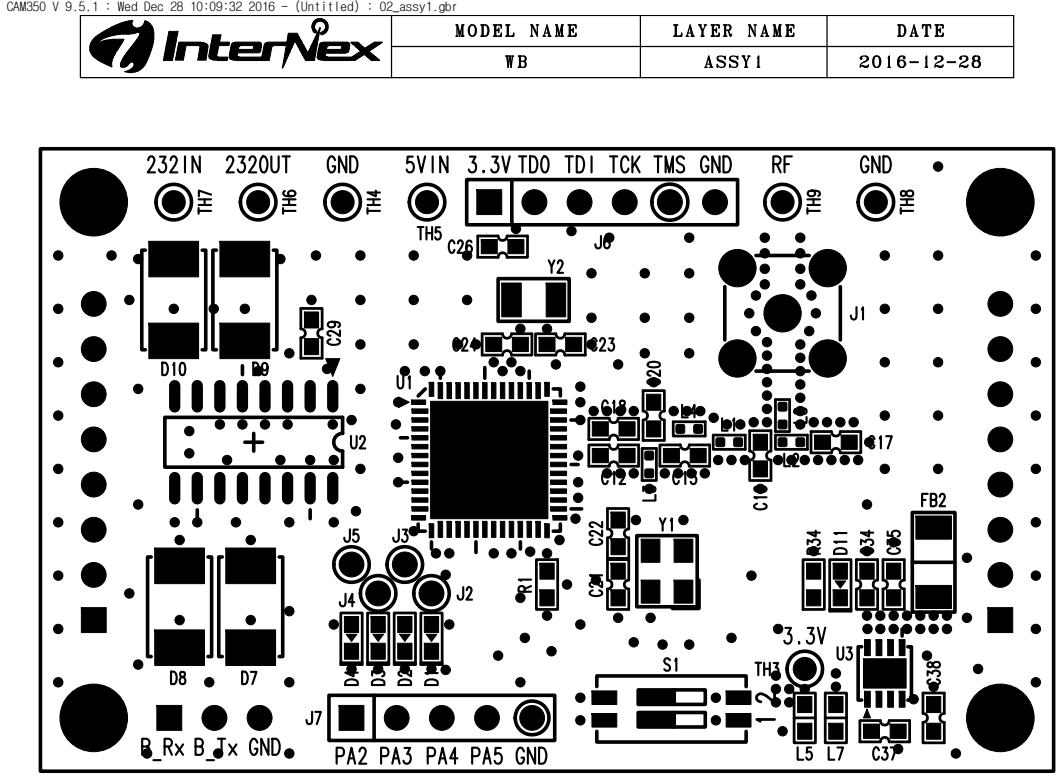
[picture p128: page 1]

CAM350 V 9.5.1 : Wed Dec 28 10:09:32 2016 - (Untitled) : 02_assy1.gbr

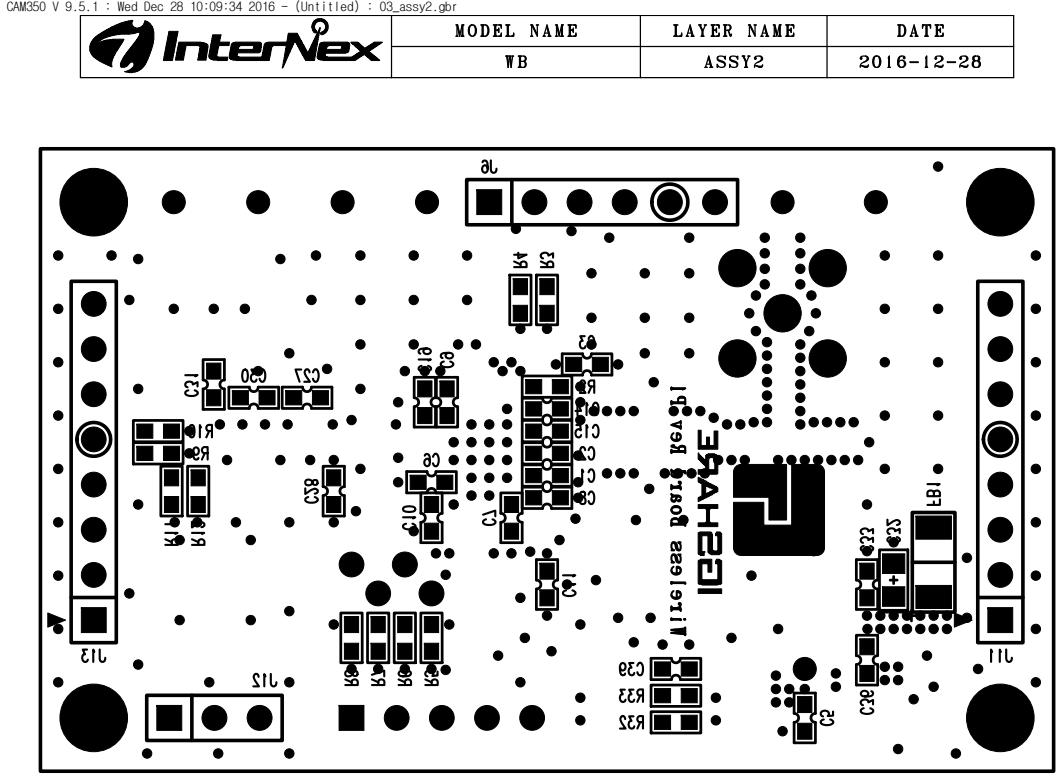
[picture p129: page 2]

CAM350 V 9.5.1 : Wed Dec 28 10:09:34 2016 - (Untitled) : 03_assy2.gbr

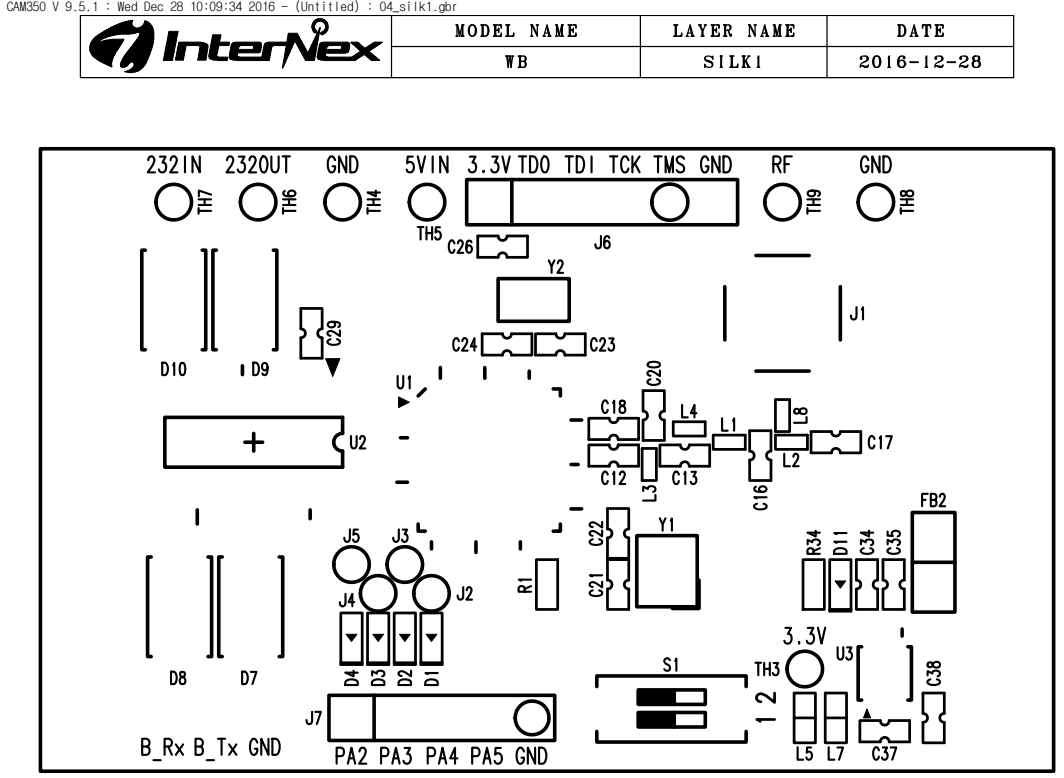
[picture p130: page 3]

CAM350 V 9.5.1 : Wed Dec 28 10:09:34 2016 - (Untitled) : 04_silk1.gbr

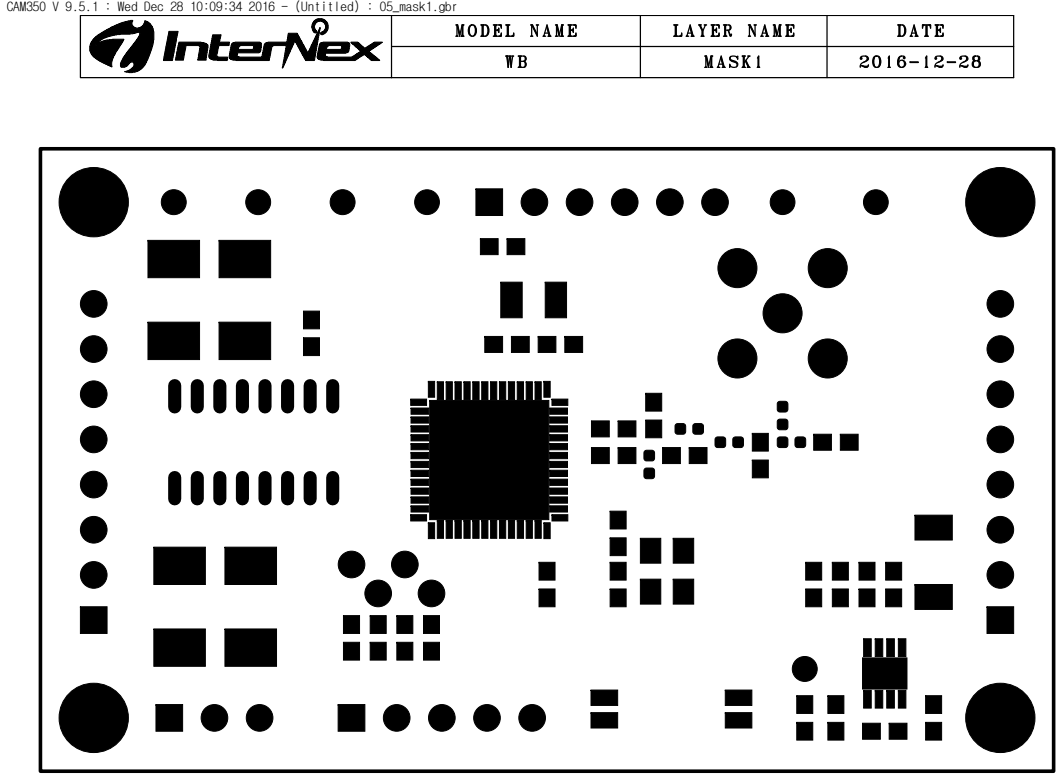
[picture p131: page 4]

CAM350 V 9.5.1 : Wed Dec 28 10:09:34 2016 - (Untitled) : 05_mask1.gbr

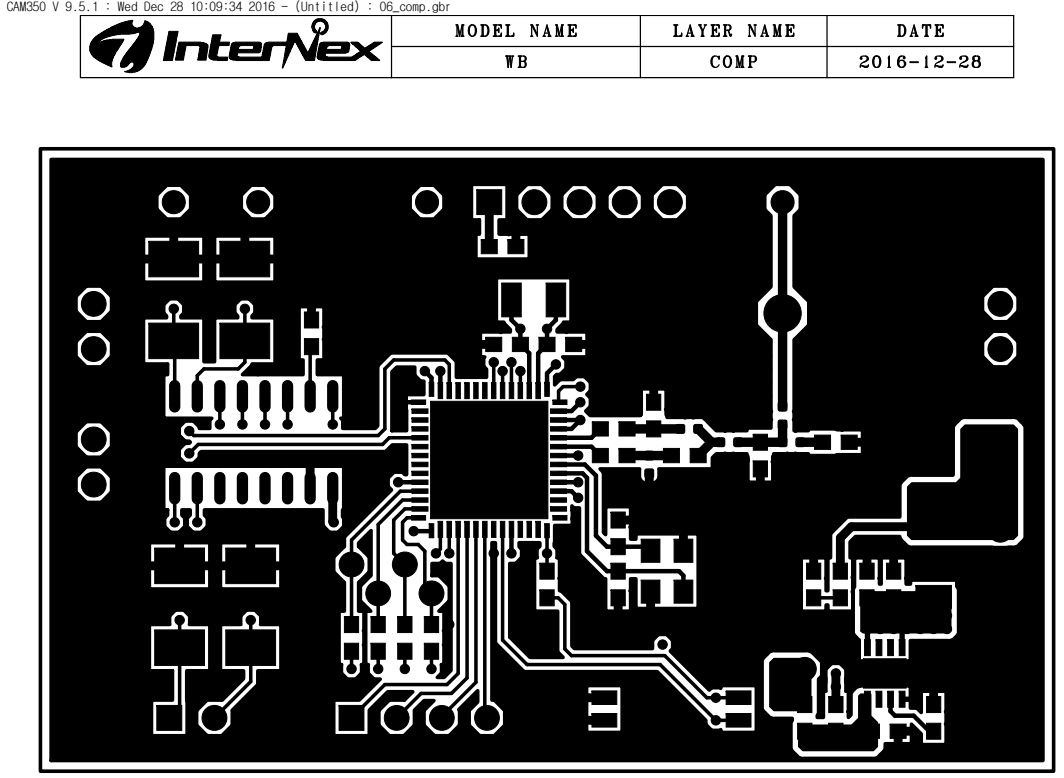
[picture p132: page 5]

CAM350 V 9.5.1 : Wed Dec 28 10:09:34 2016 - (Untitled) : 06_comp.gbr

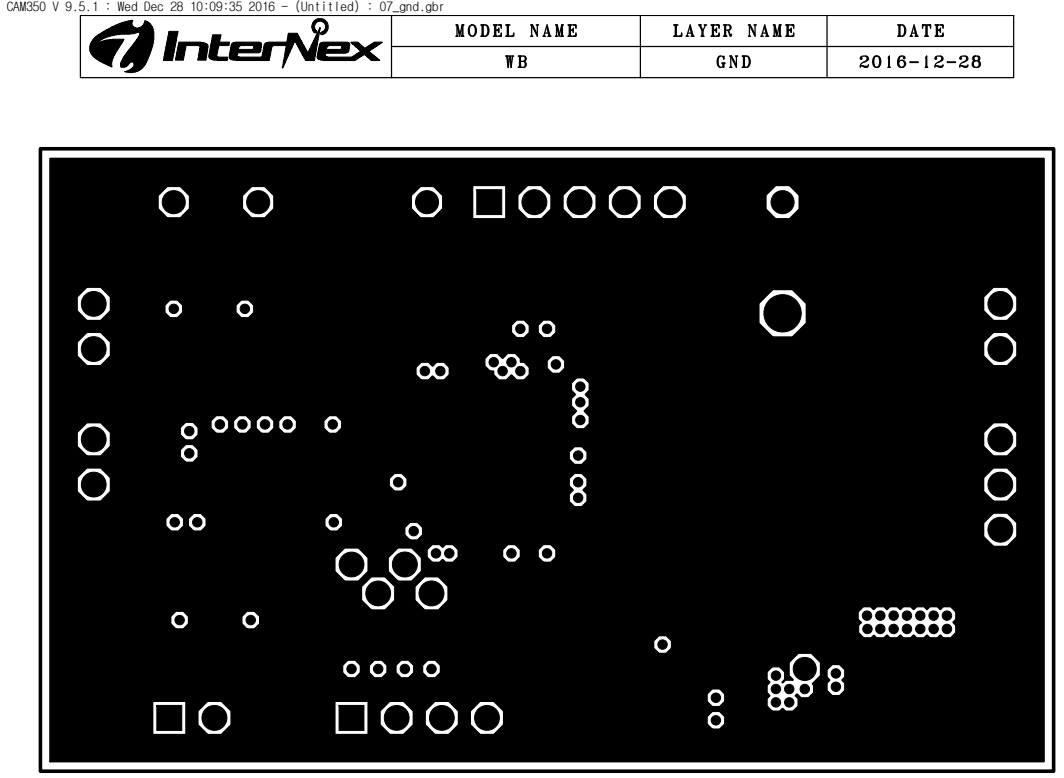
[picture p133: page 6]

CAM350 V 9.5.1 : Wed Dec 28 10:09:35 2016 - (Untitled) : 07_gnd.gbr

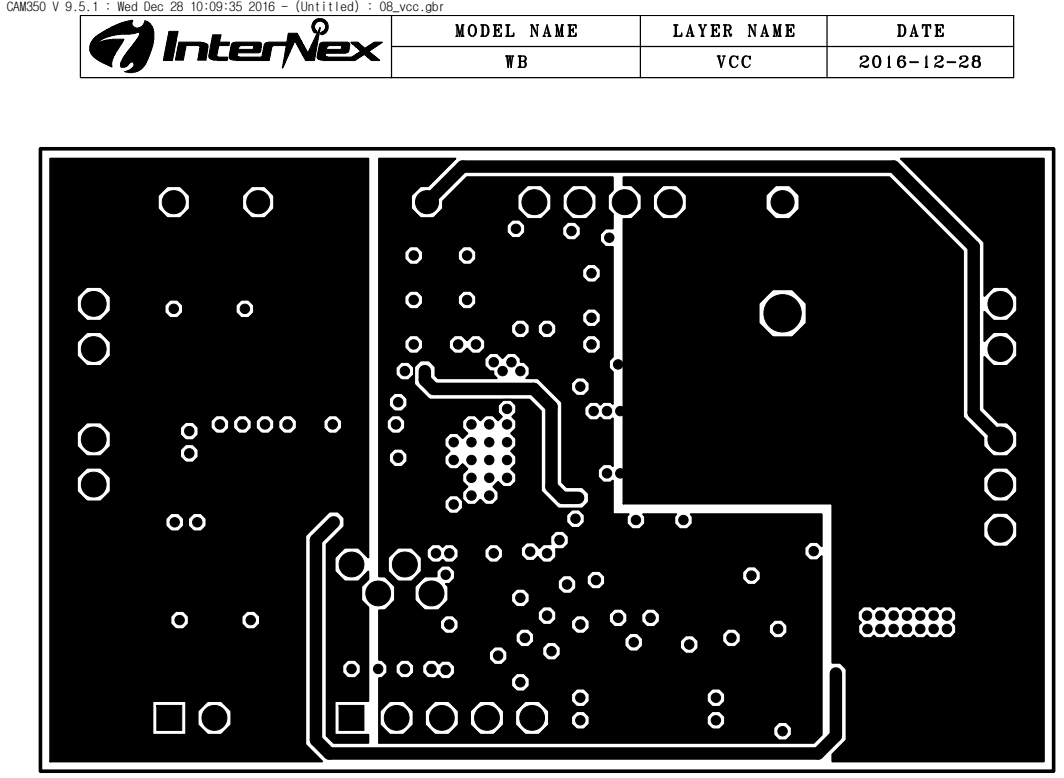
[picture p134: page 7]

CAM350 V 9.5.1 : Wed Dec 28 10:09:35 2016 - (Untitled) : 08_vcc.gbr

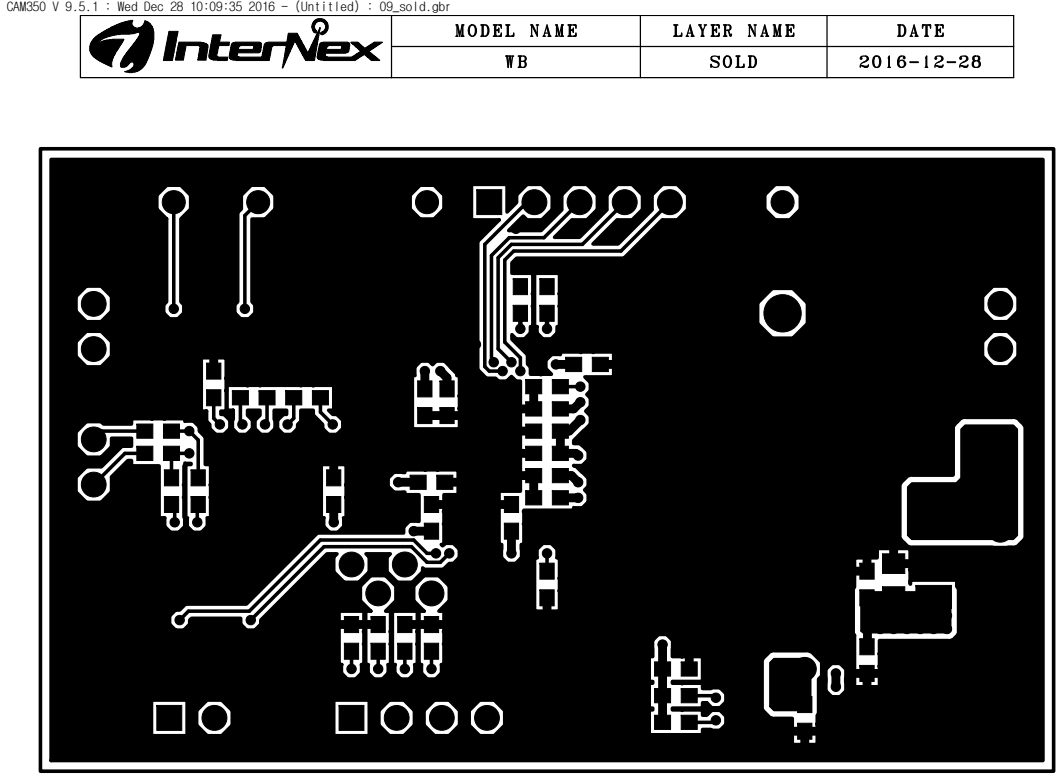
[picture p135: page 8]

CAM350 V 9.5.1 : Wed Dec 28 10:09:35 2016 - (Untitled) : 09_sold.gbr

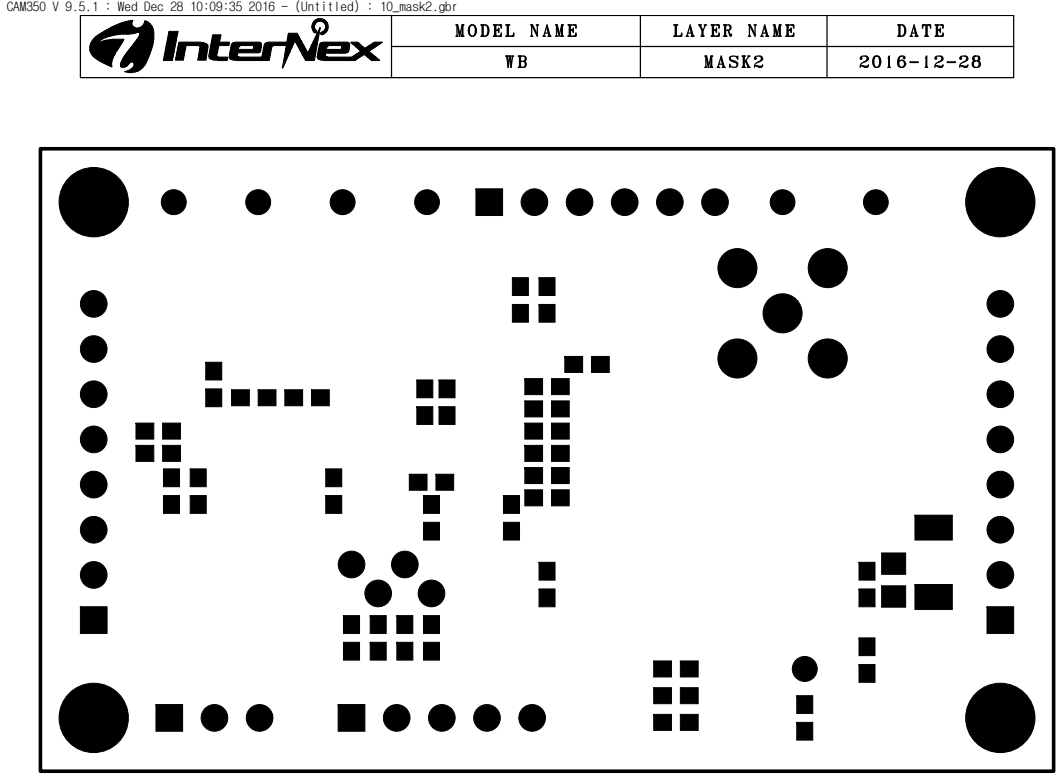
[picture p136: page 9]

CAM350 V 9.5.1 : Wed Dec 28 10:09:35 2016 - (Untitled) : 10_mask2.gbr

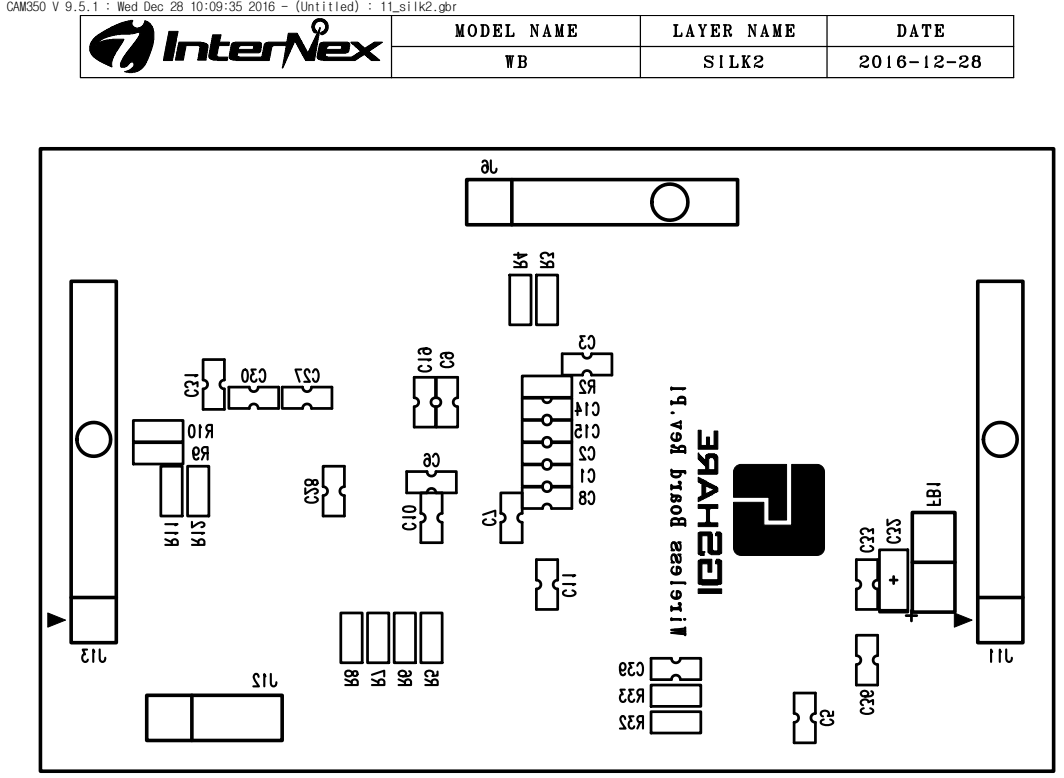
[picture p137: page 10]

CAM350 V 9.5.1 : Wed Dec 28 10:09:35 2016 - (Untitled) : 11_silk2.gbr

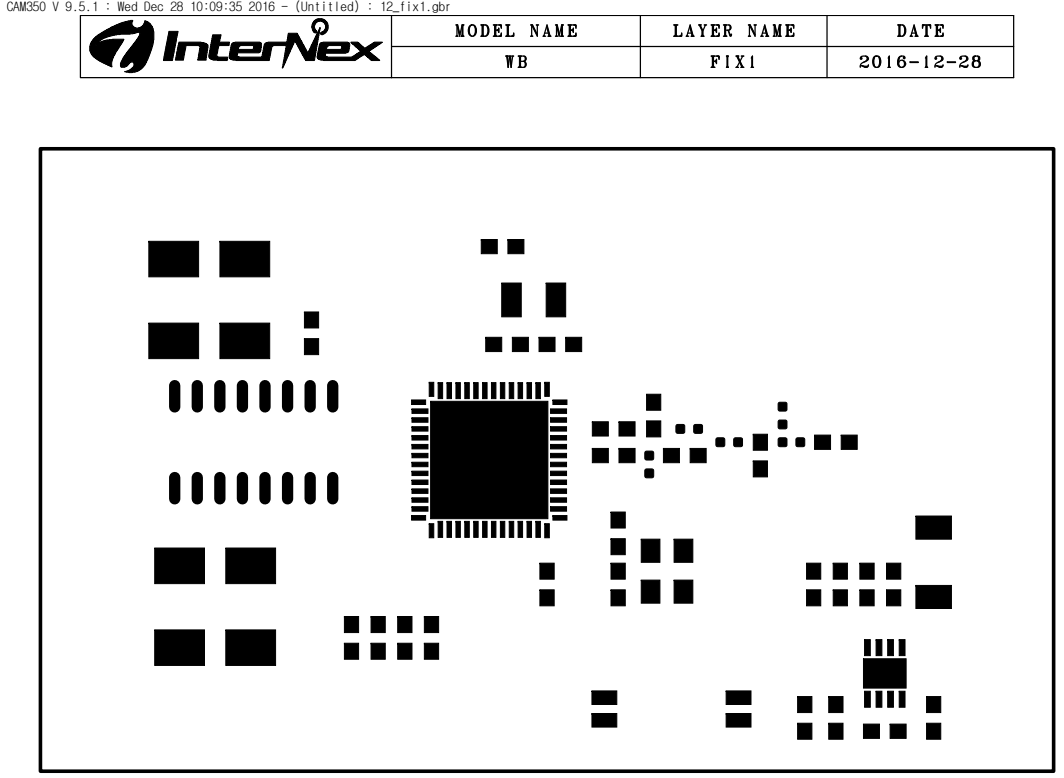
[picture p138: page 11]

CAM350 V 9.5.1 : Wed Dec 28 10:09:35 2016 - (Untitled) : 12_fix1.gbr

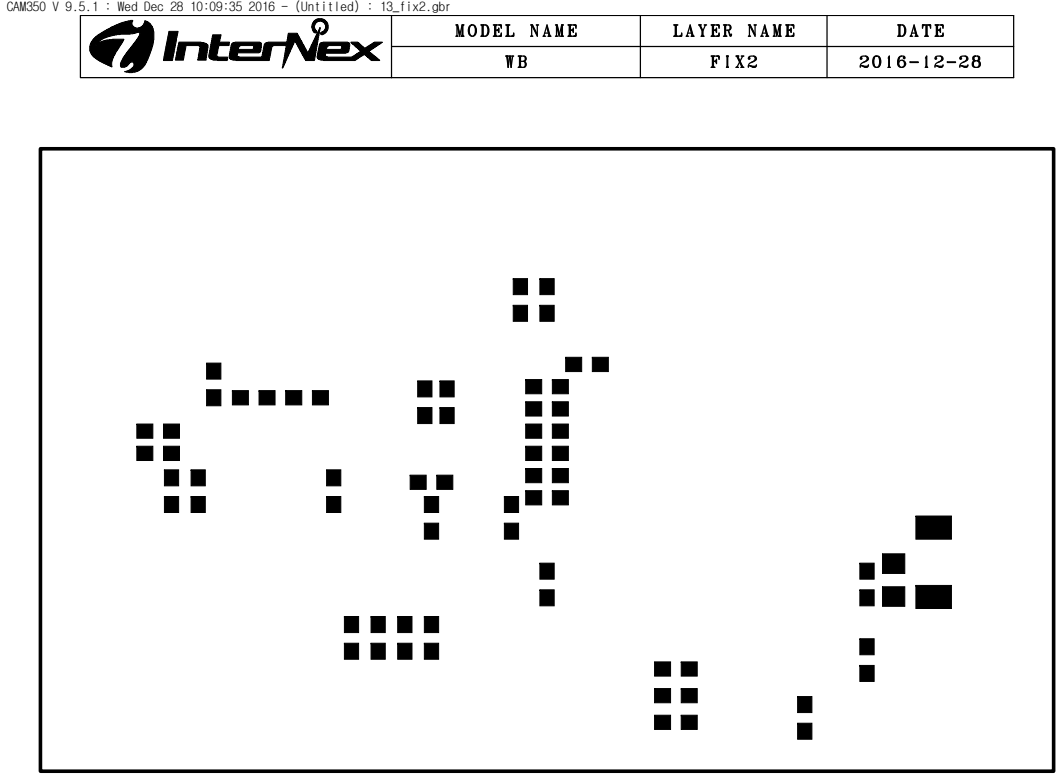
[picture p139: page 12]

CAM350 V 9.5.1 : Wed Dec 28 10:09:35 2016 - (Untitled) : 13_fix2.gbr
