IGShare/01_WPGS/01_HW/02_WSCM/02_Development/01_WB/02_P0/02_Artwork/gbrpdf/gbrpdf/gbrpdf.pdf

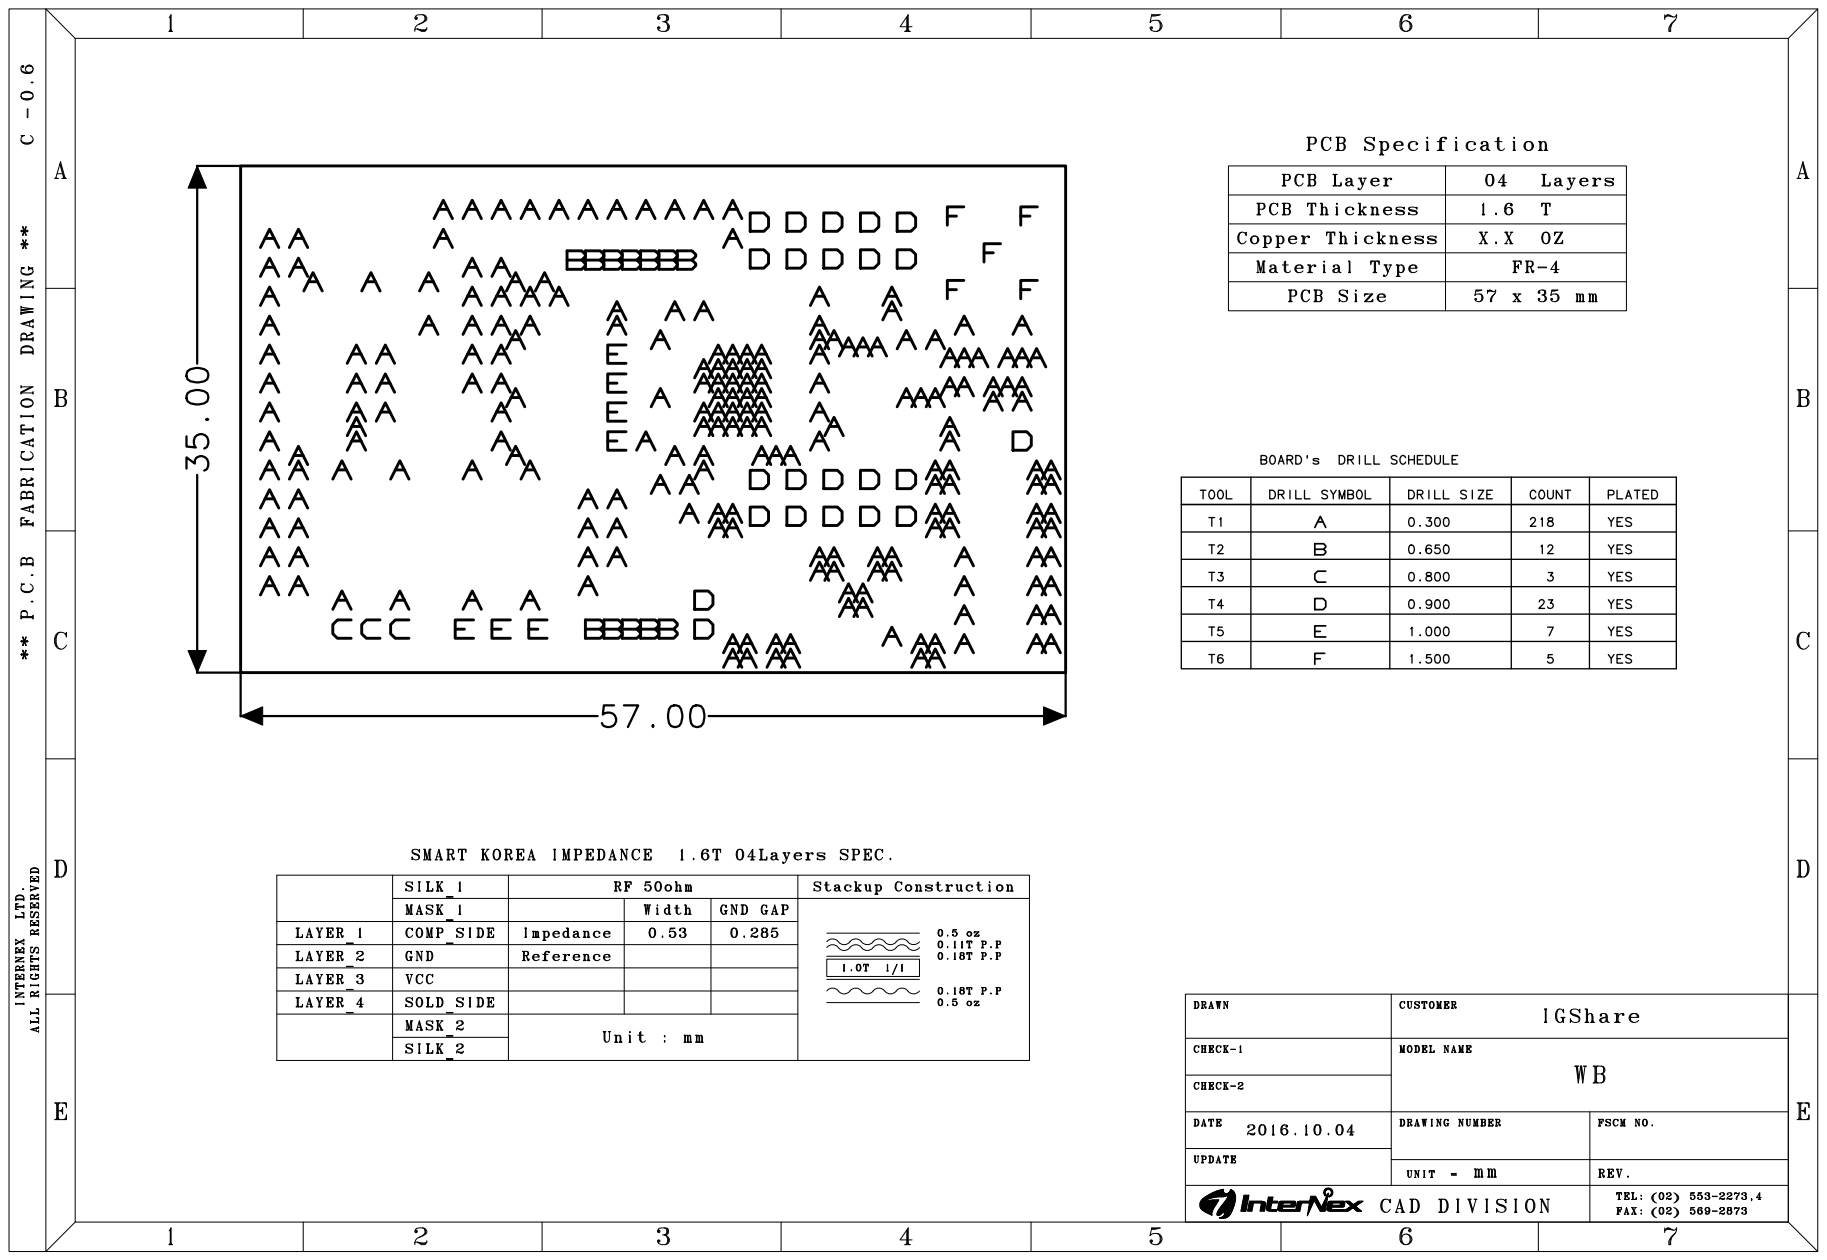
[picture p140: page 1]

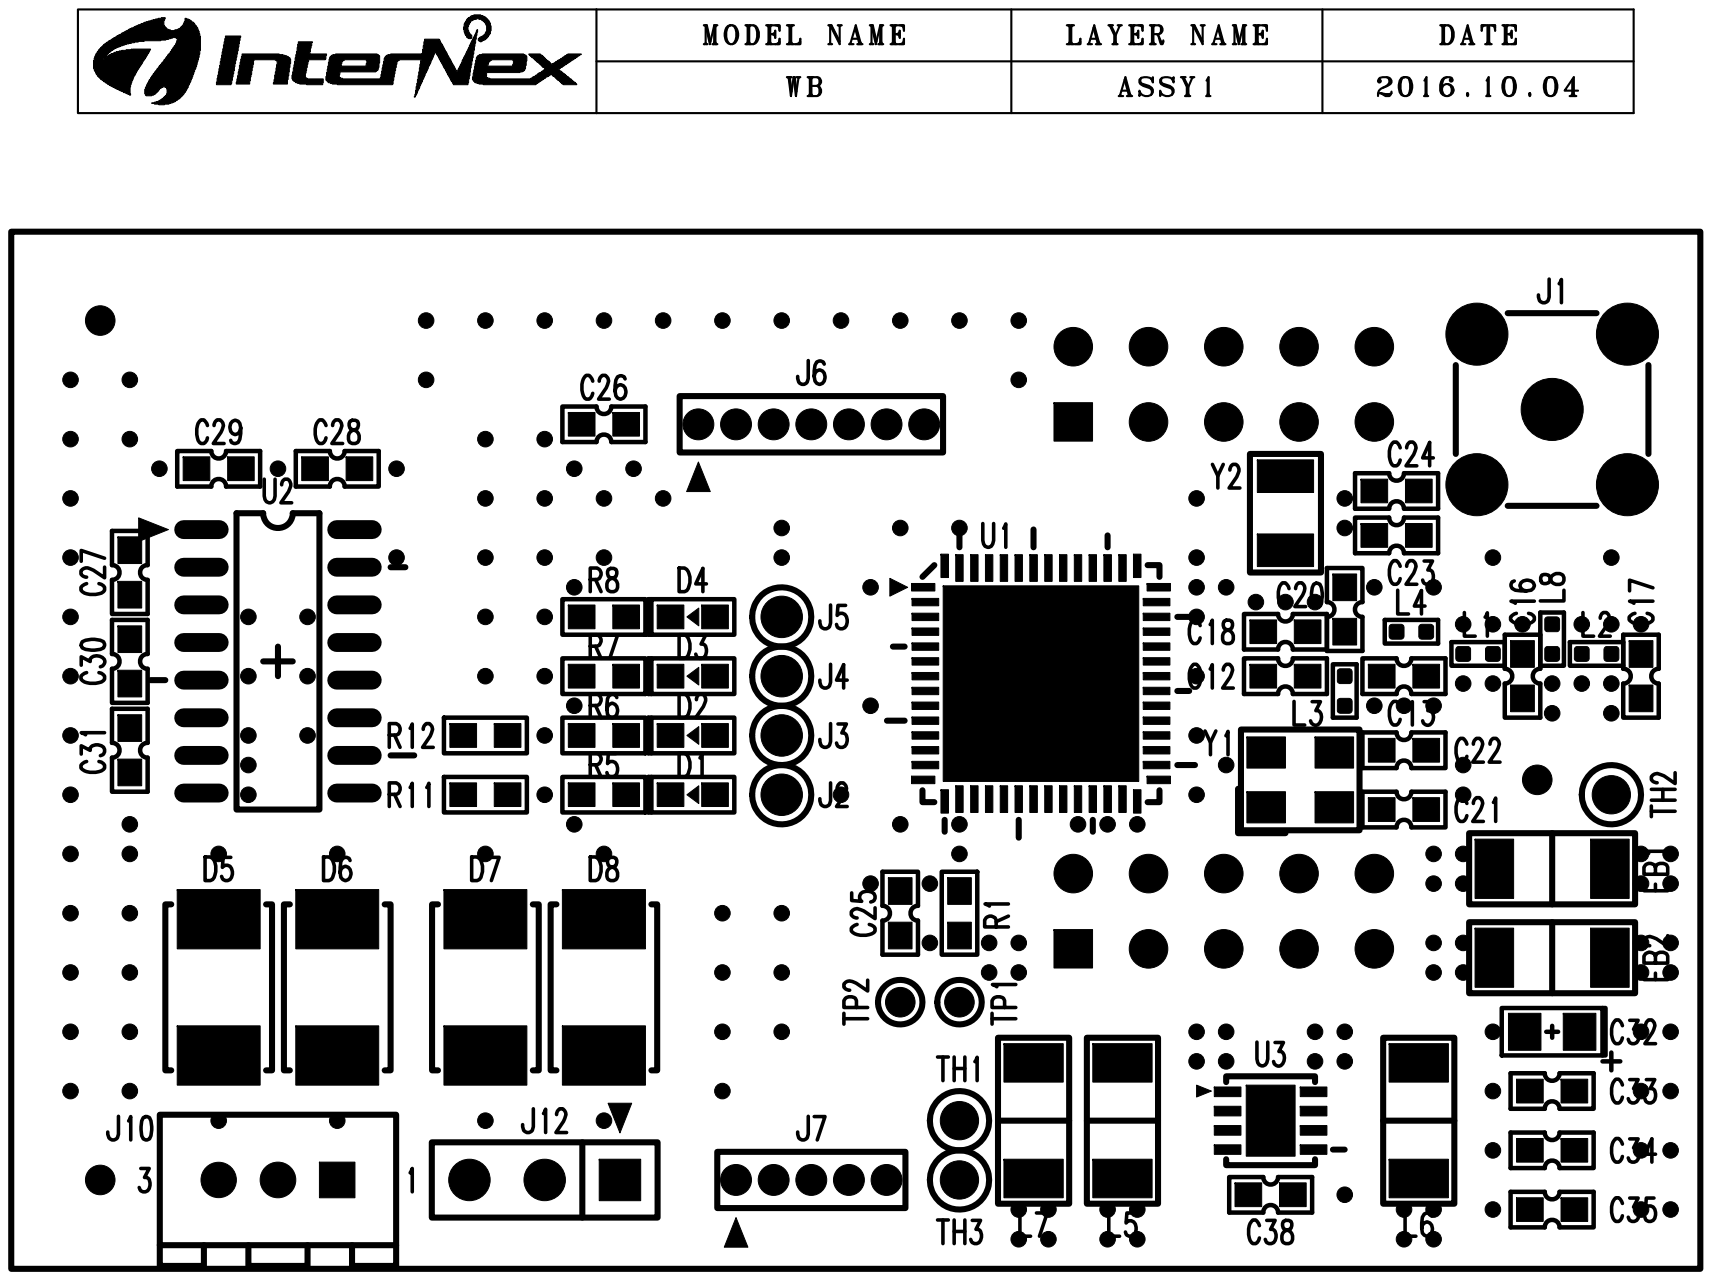
[picture p141: page 2]

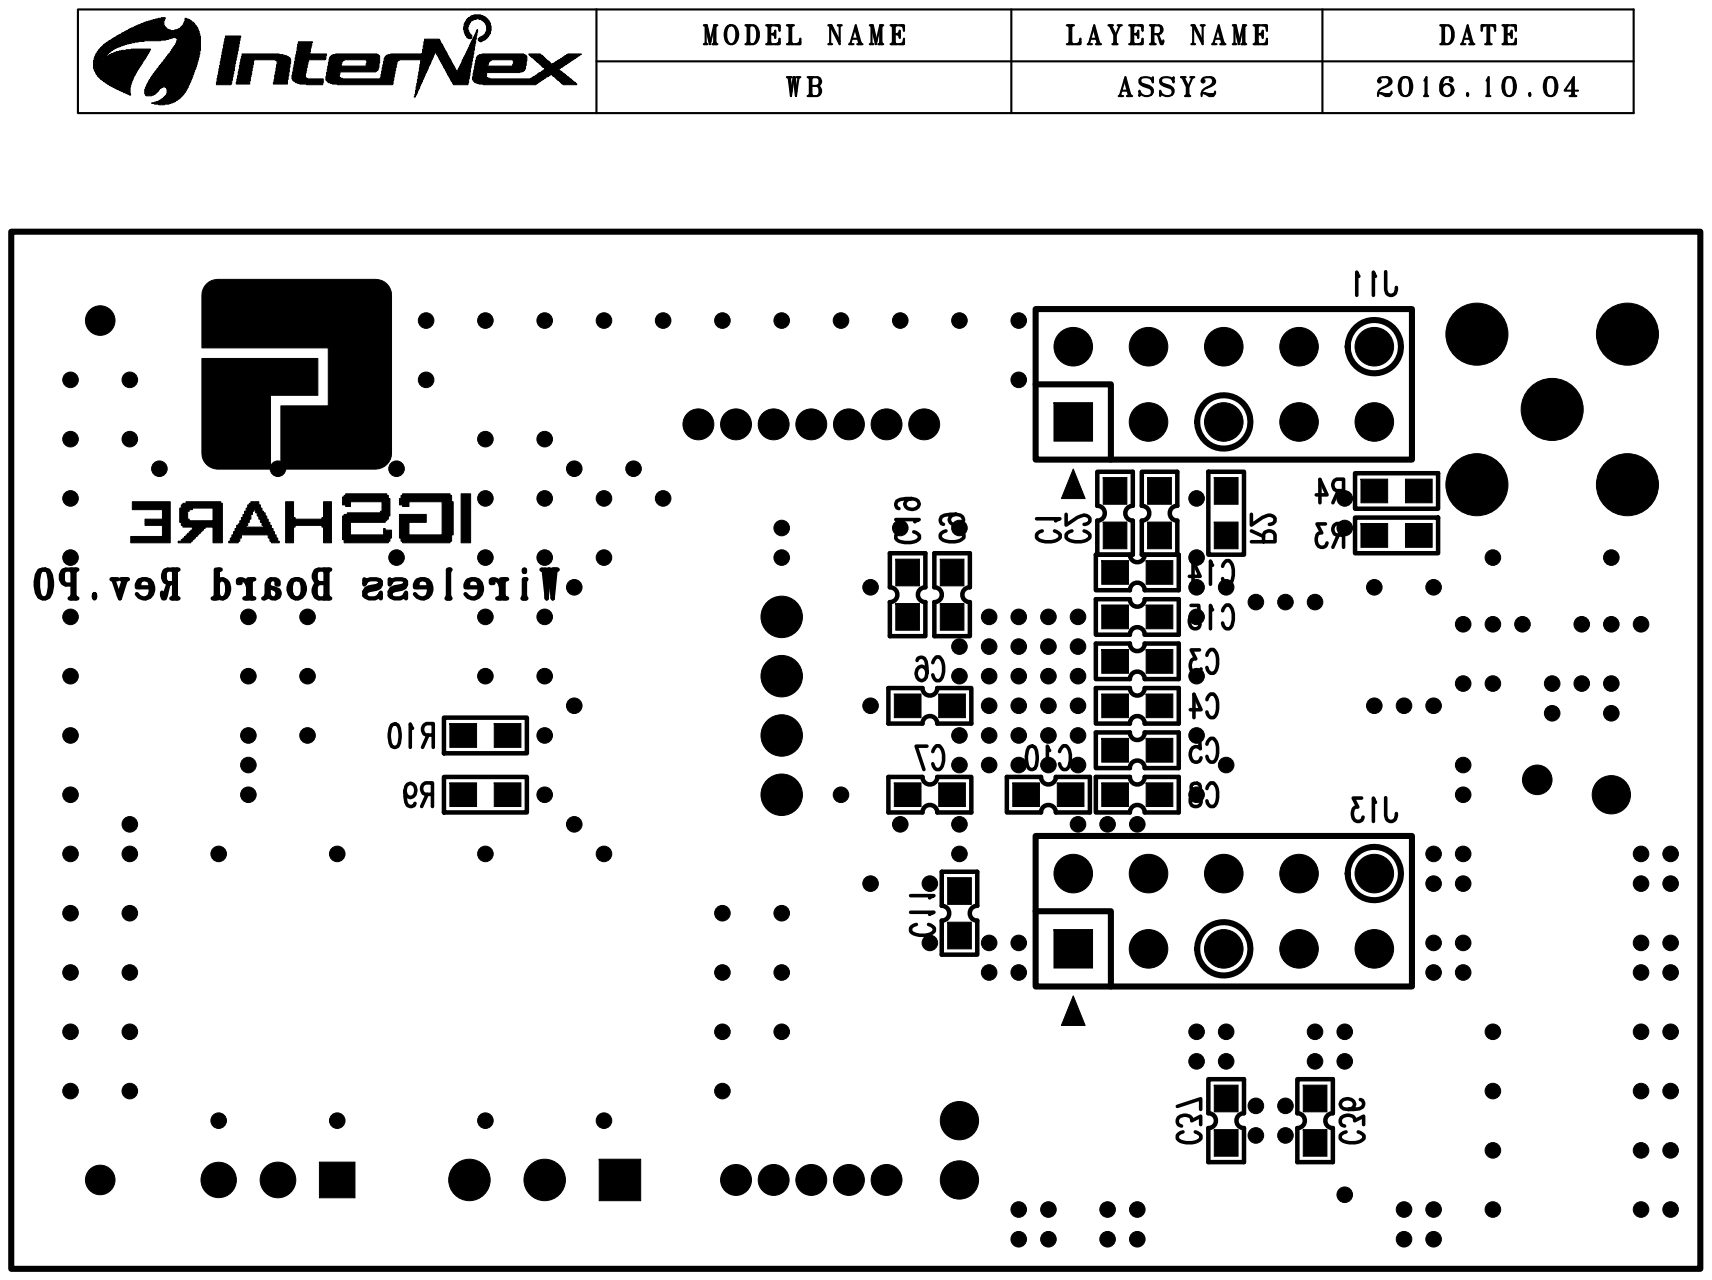
[picture p142: page 3]

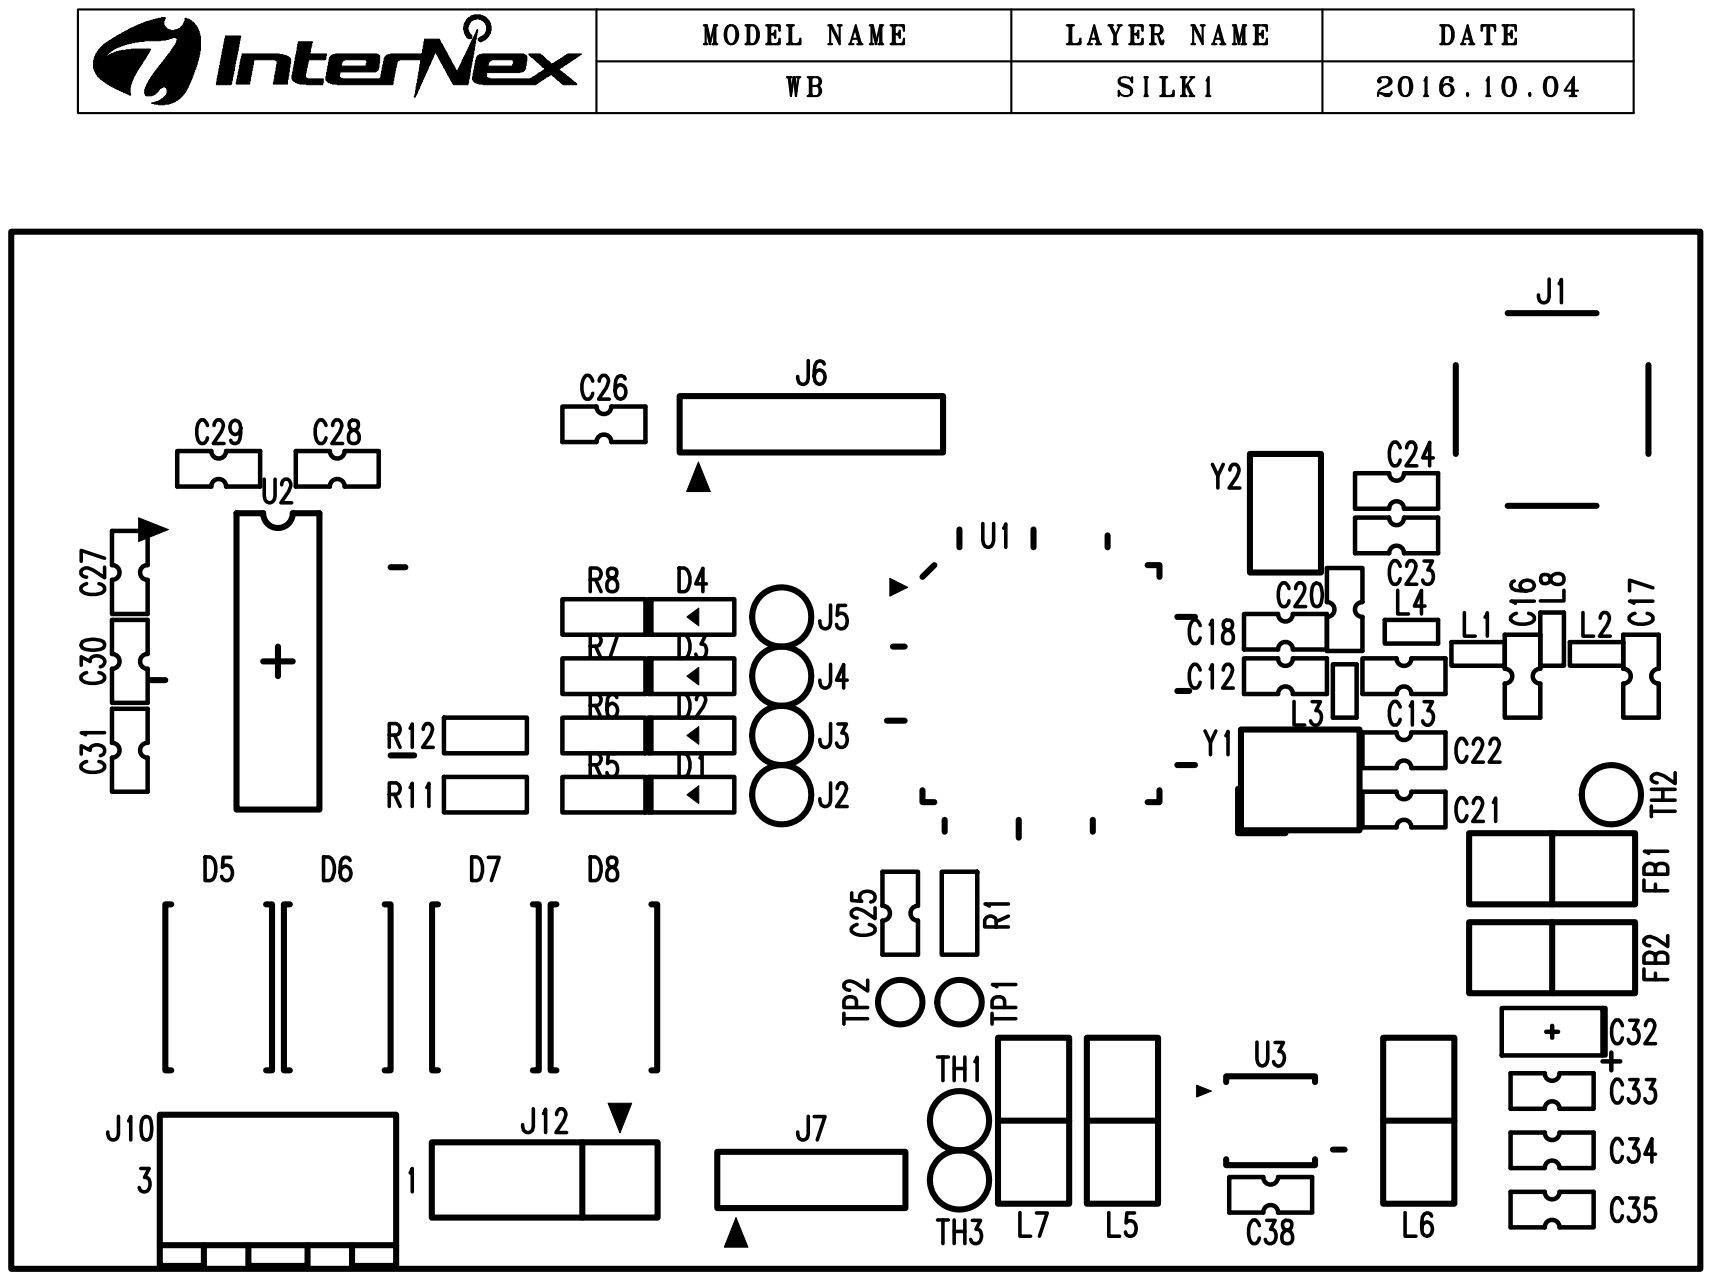
[picture p143: page 4]

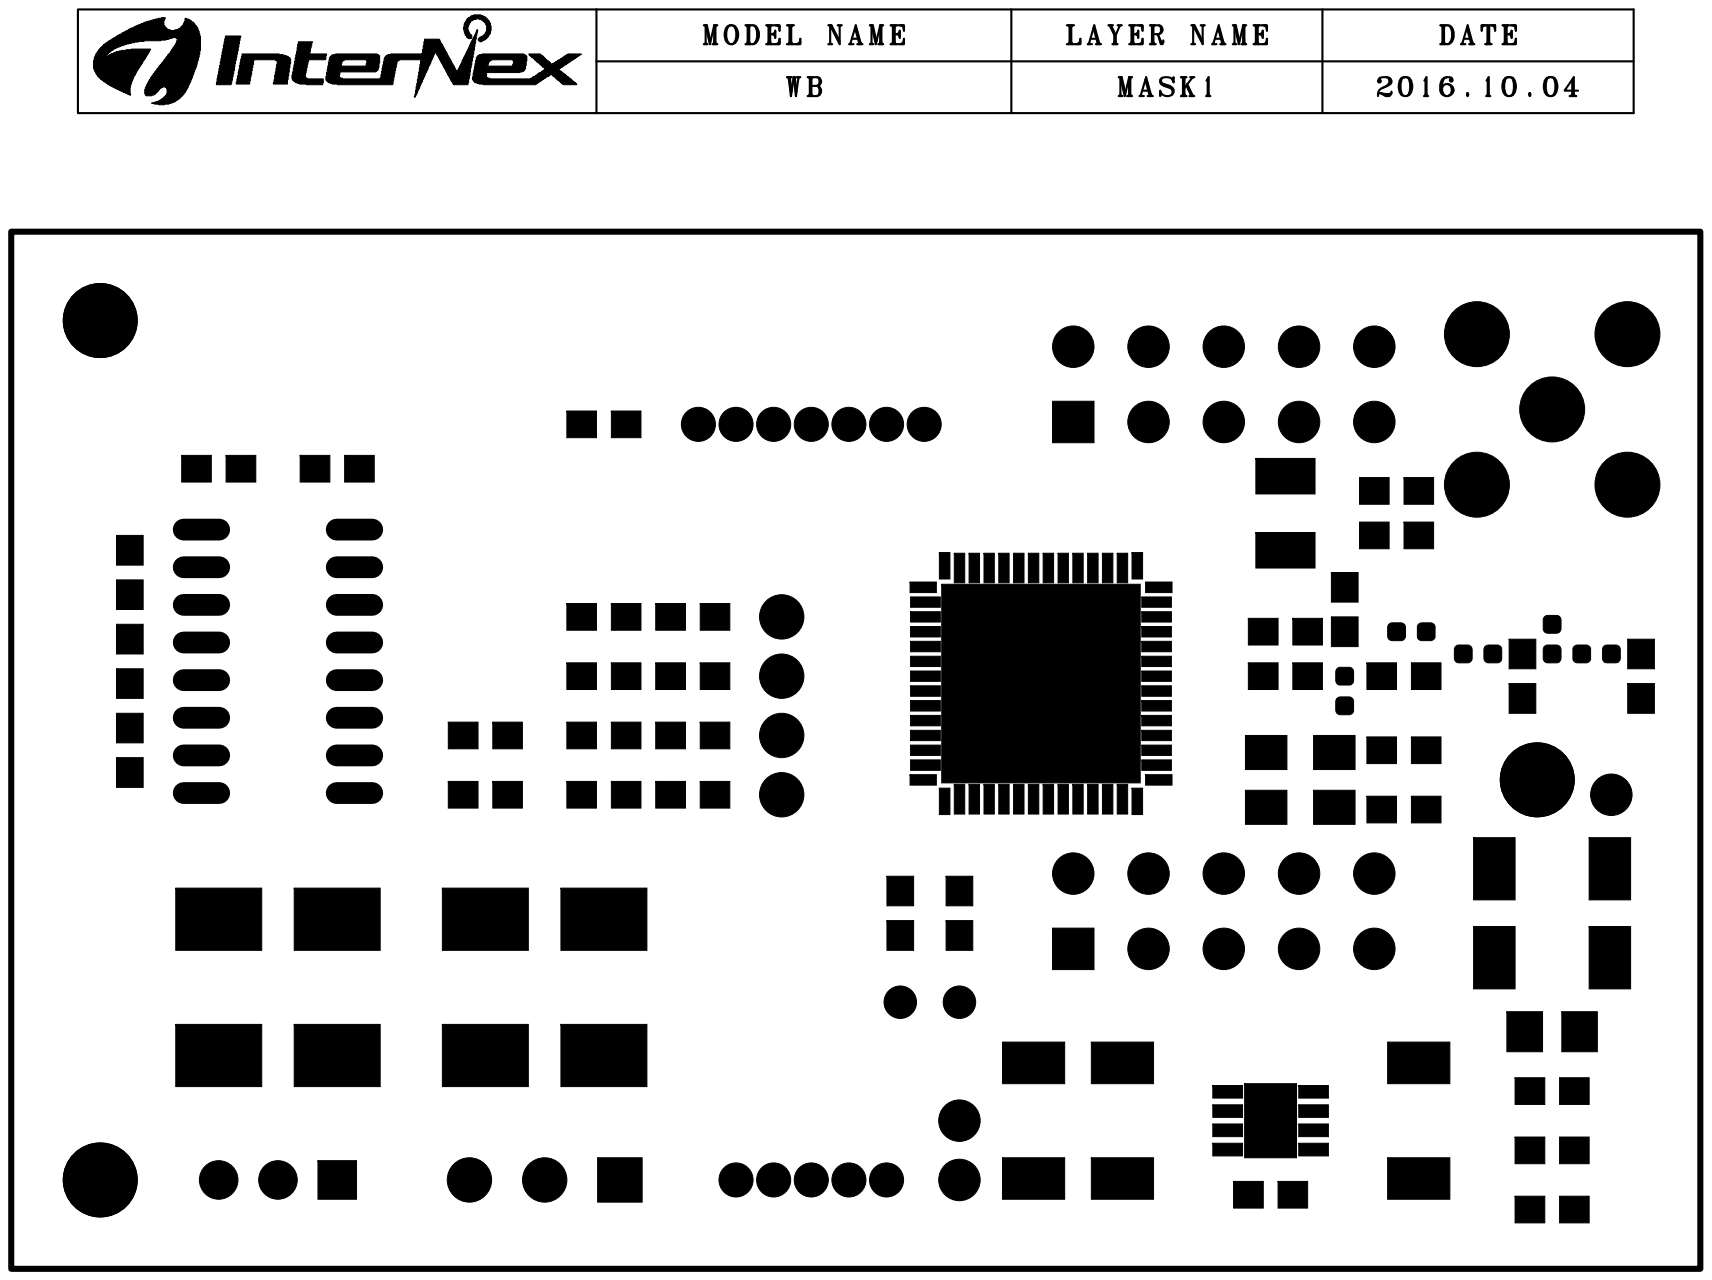
[picture p144: page 5]

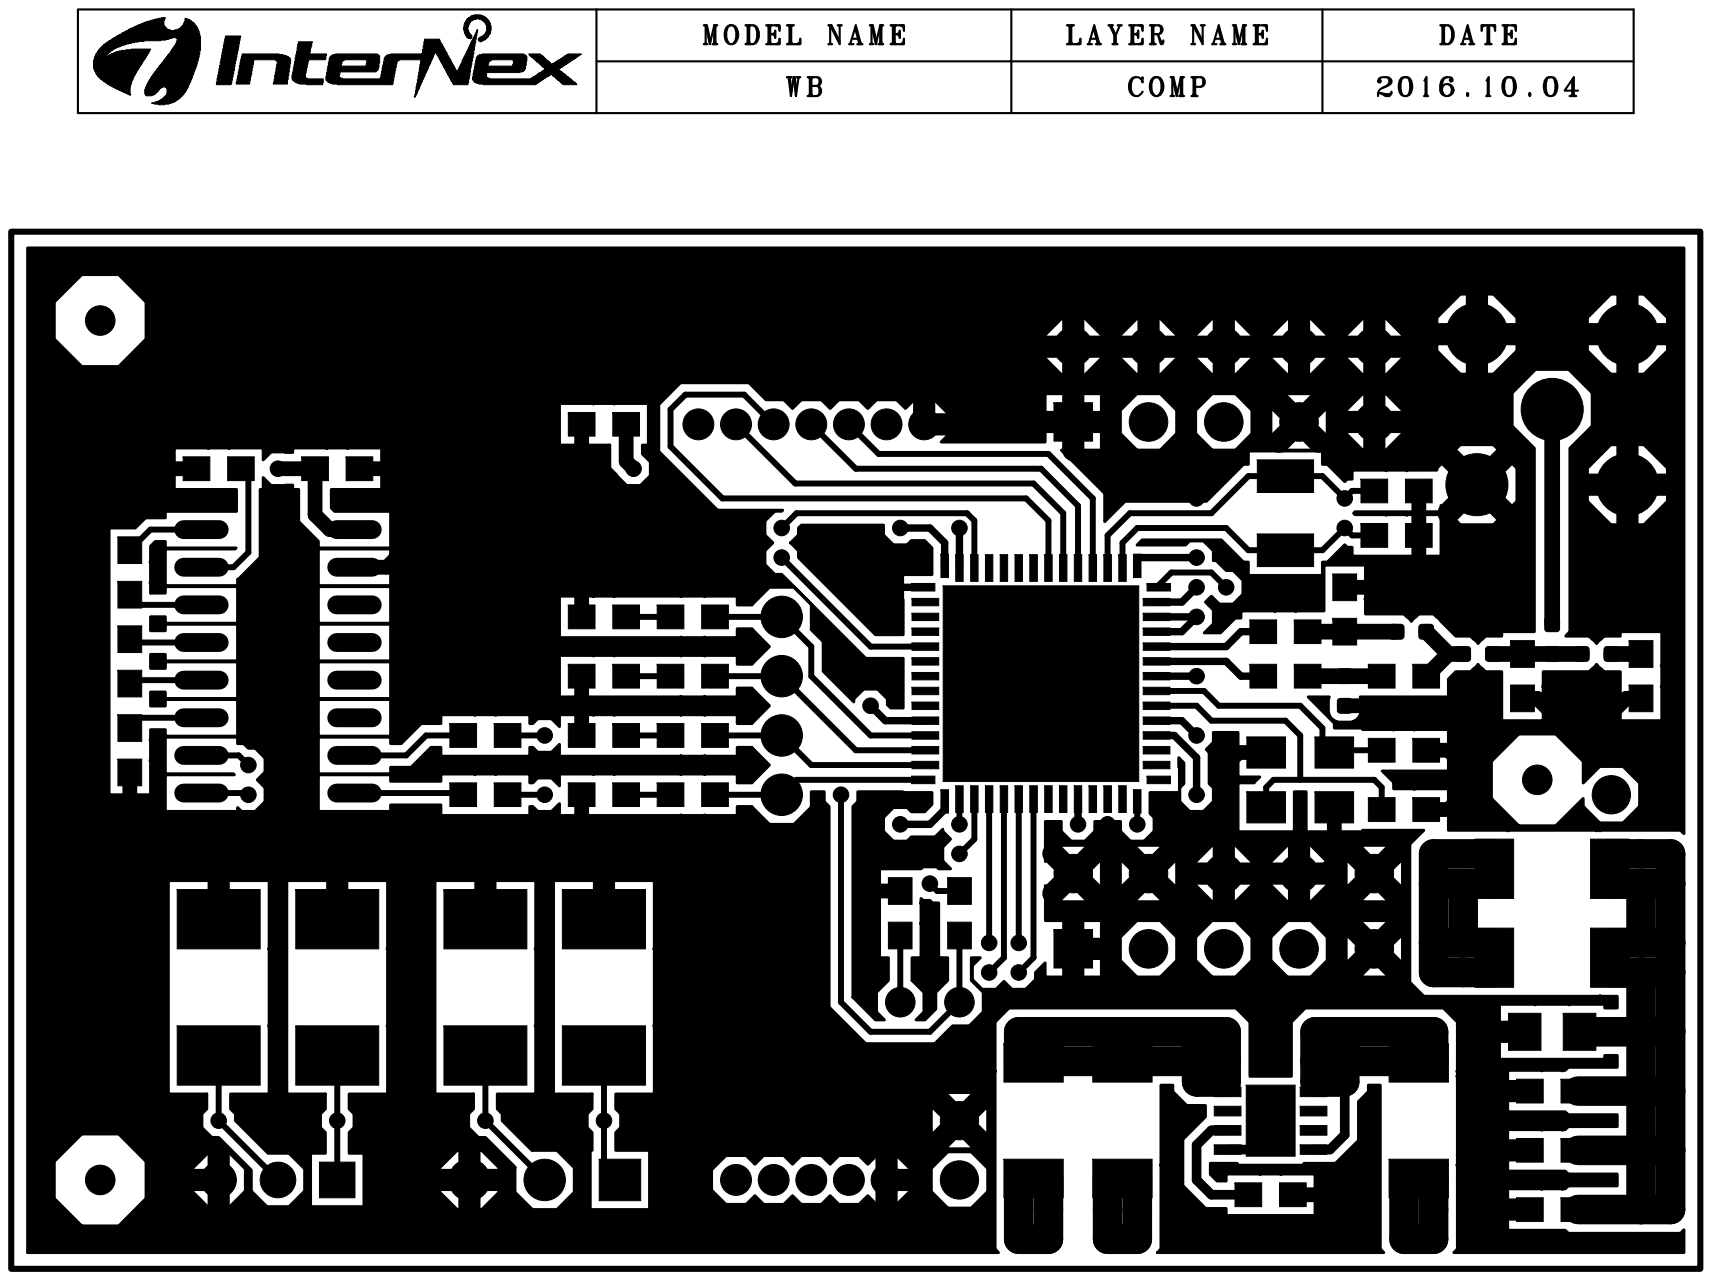
[picture p145: page 6]

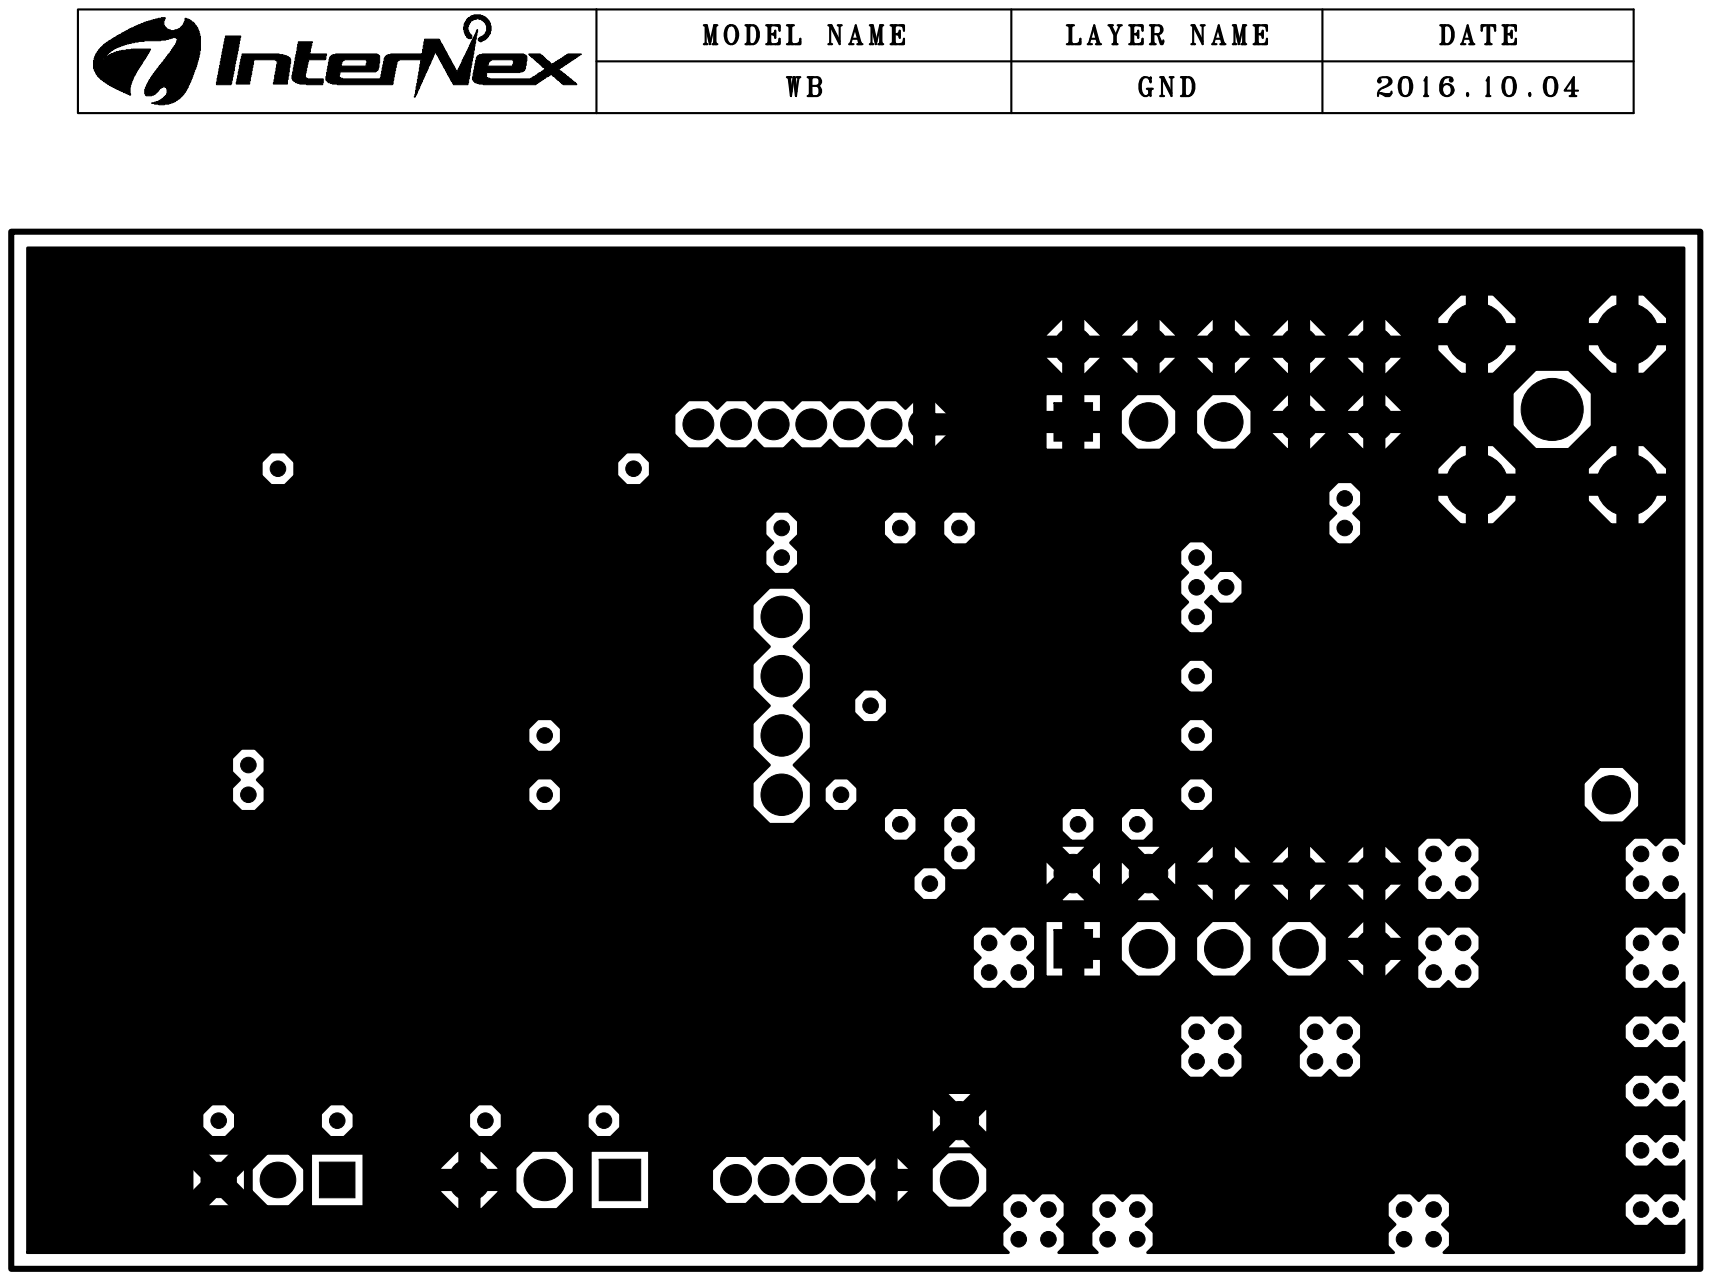
[picture p146: page 7]

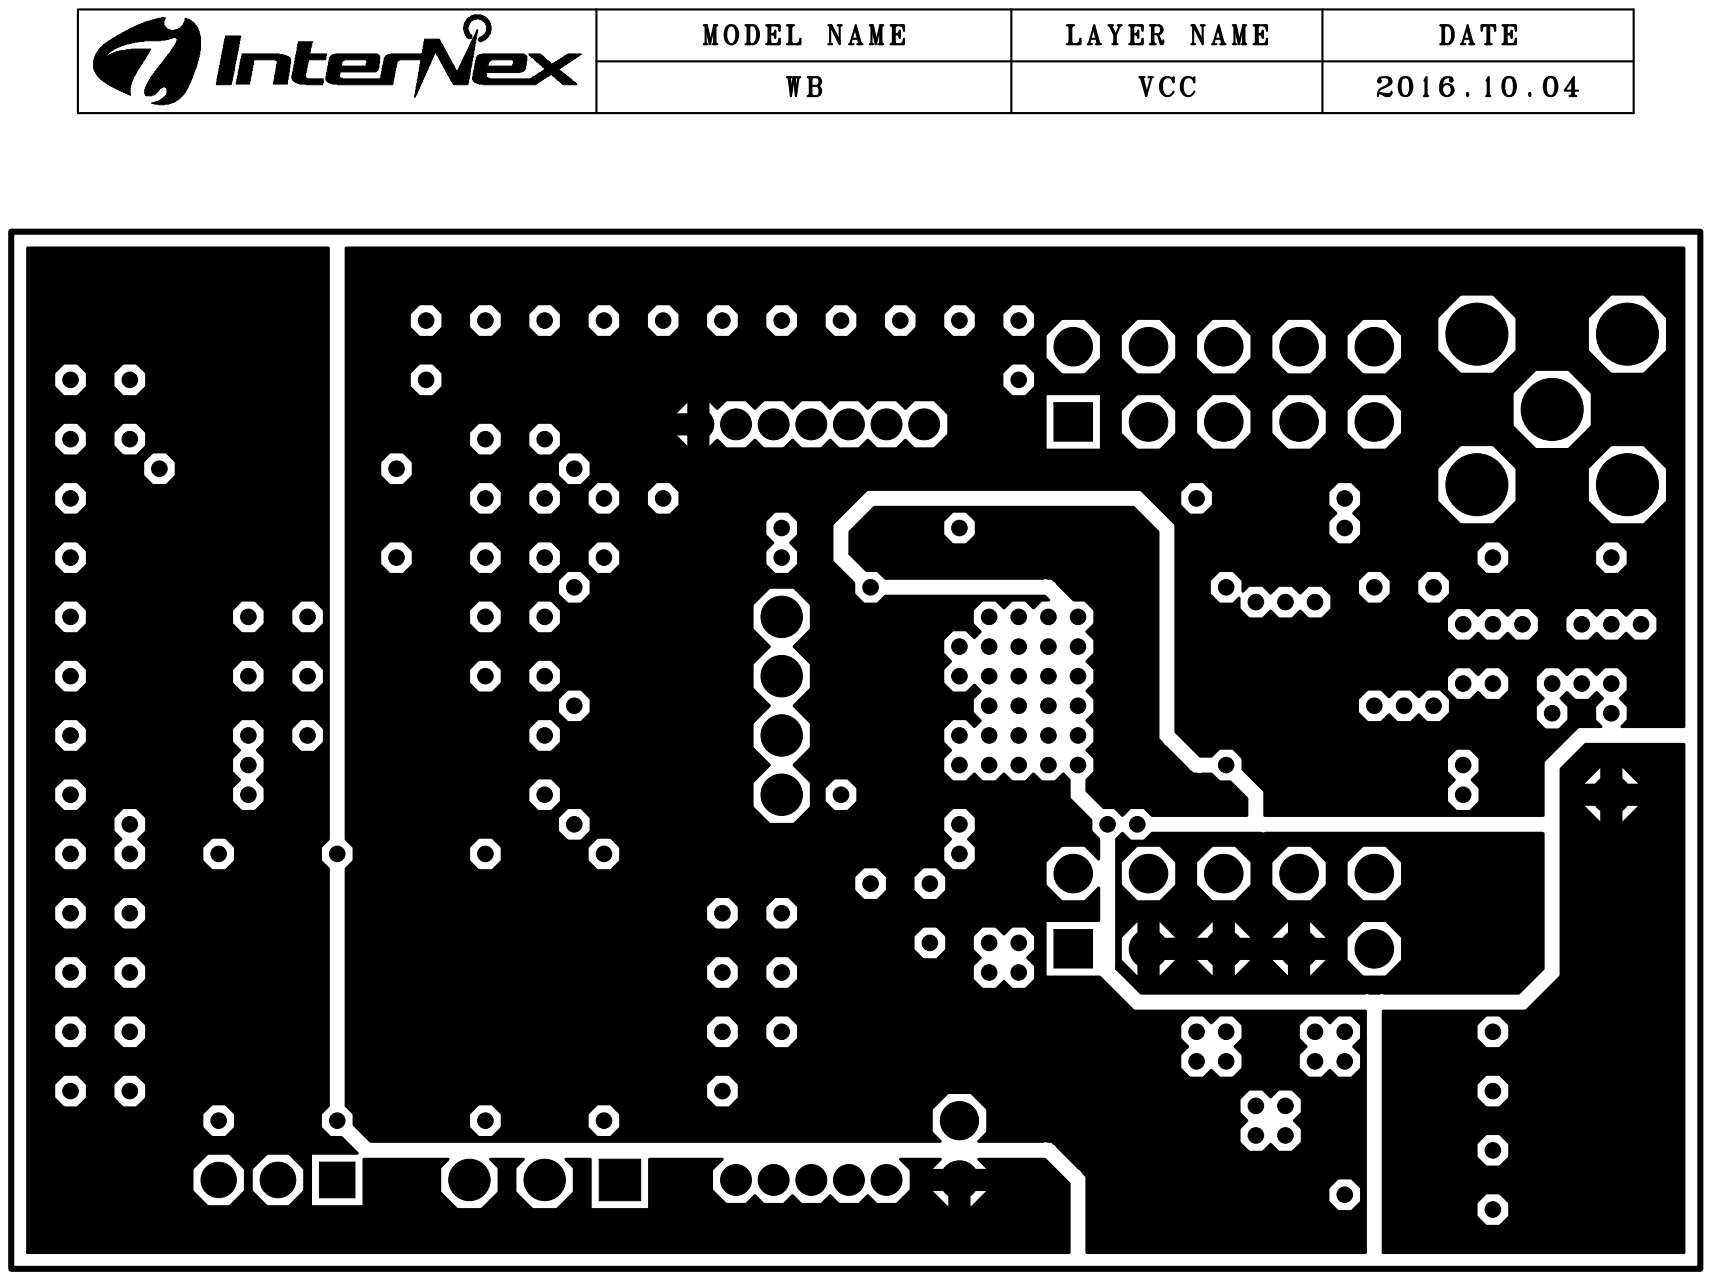
[picture p147: page 8]

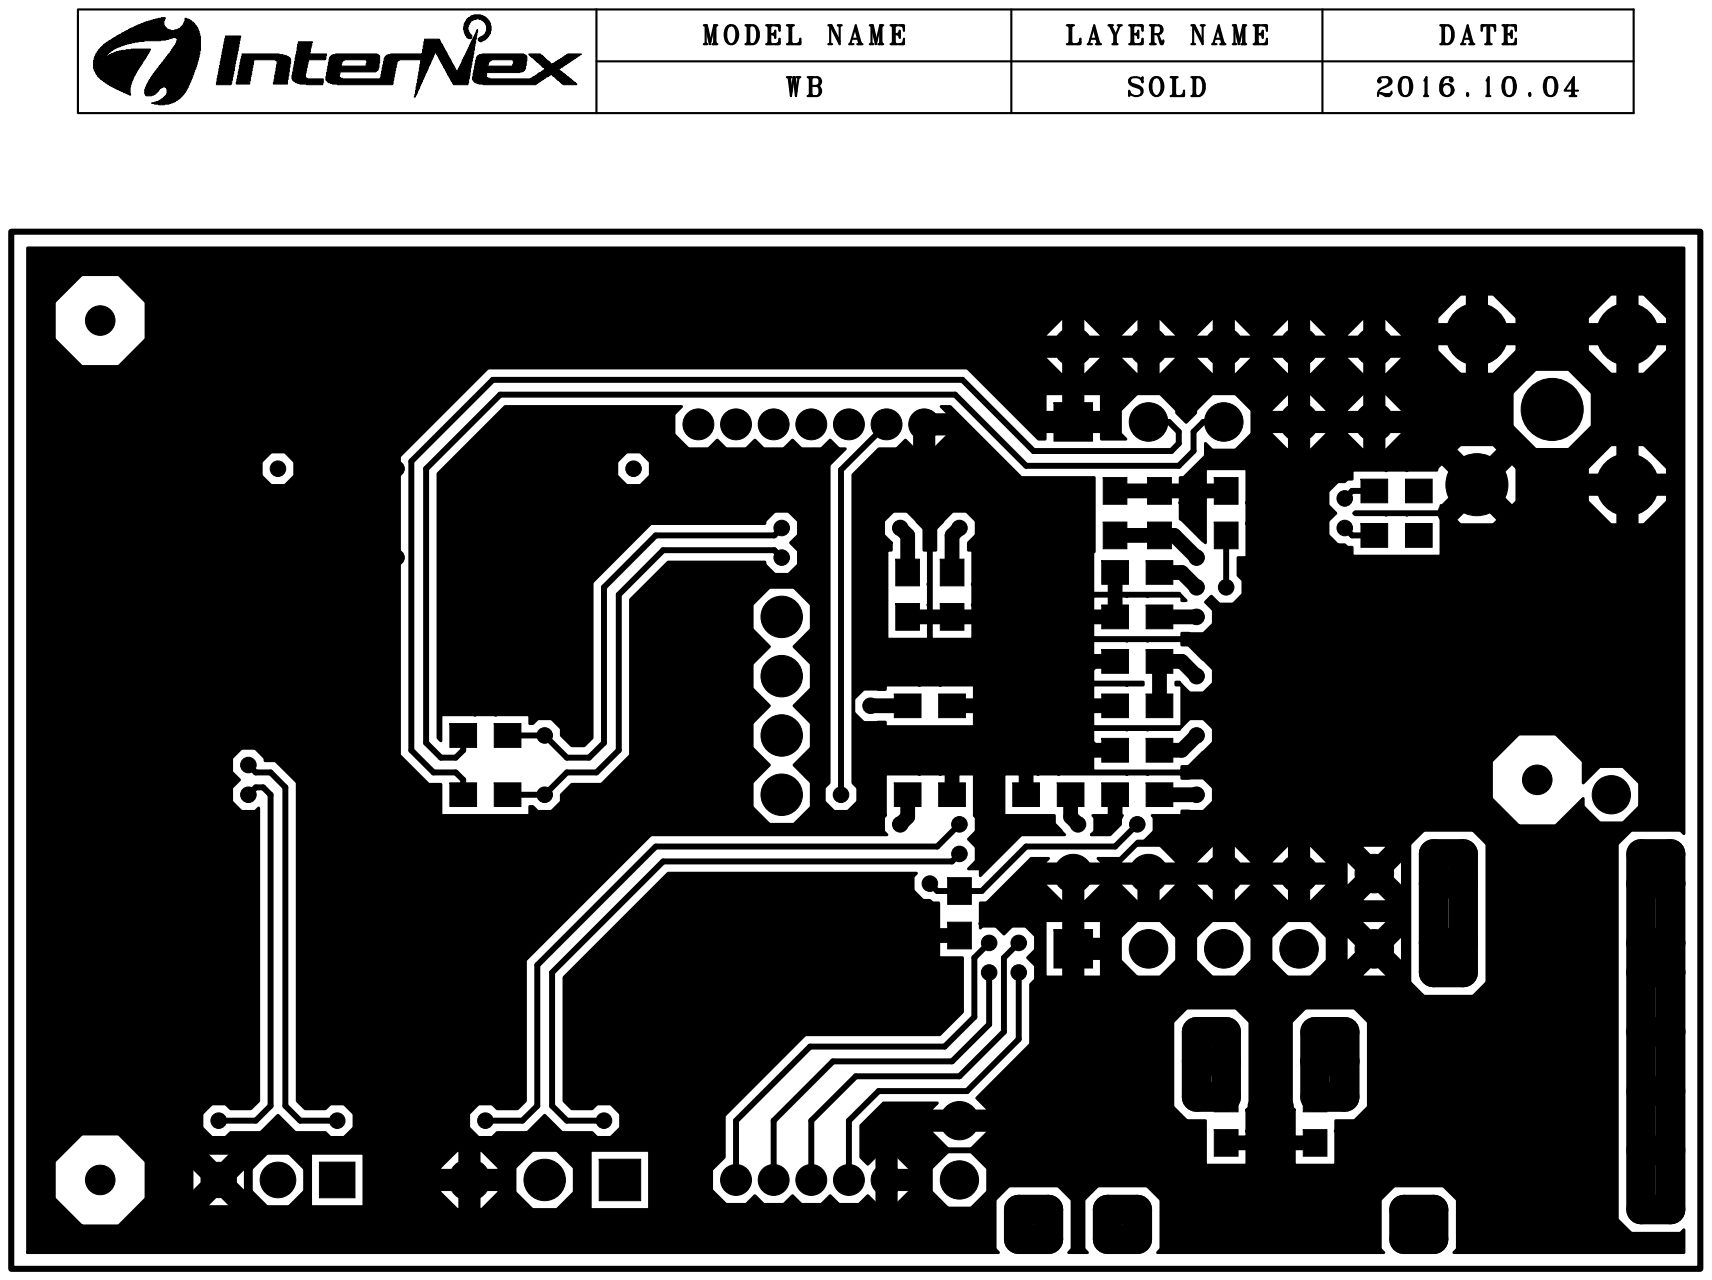
[picture p148: page 9]

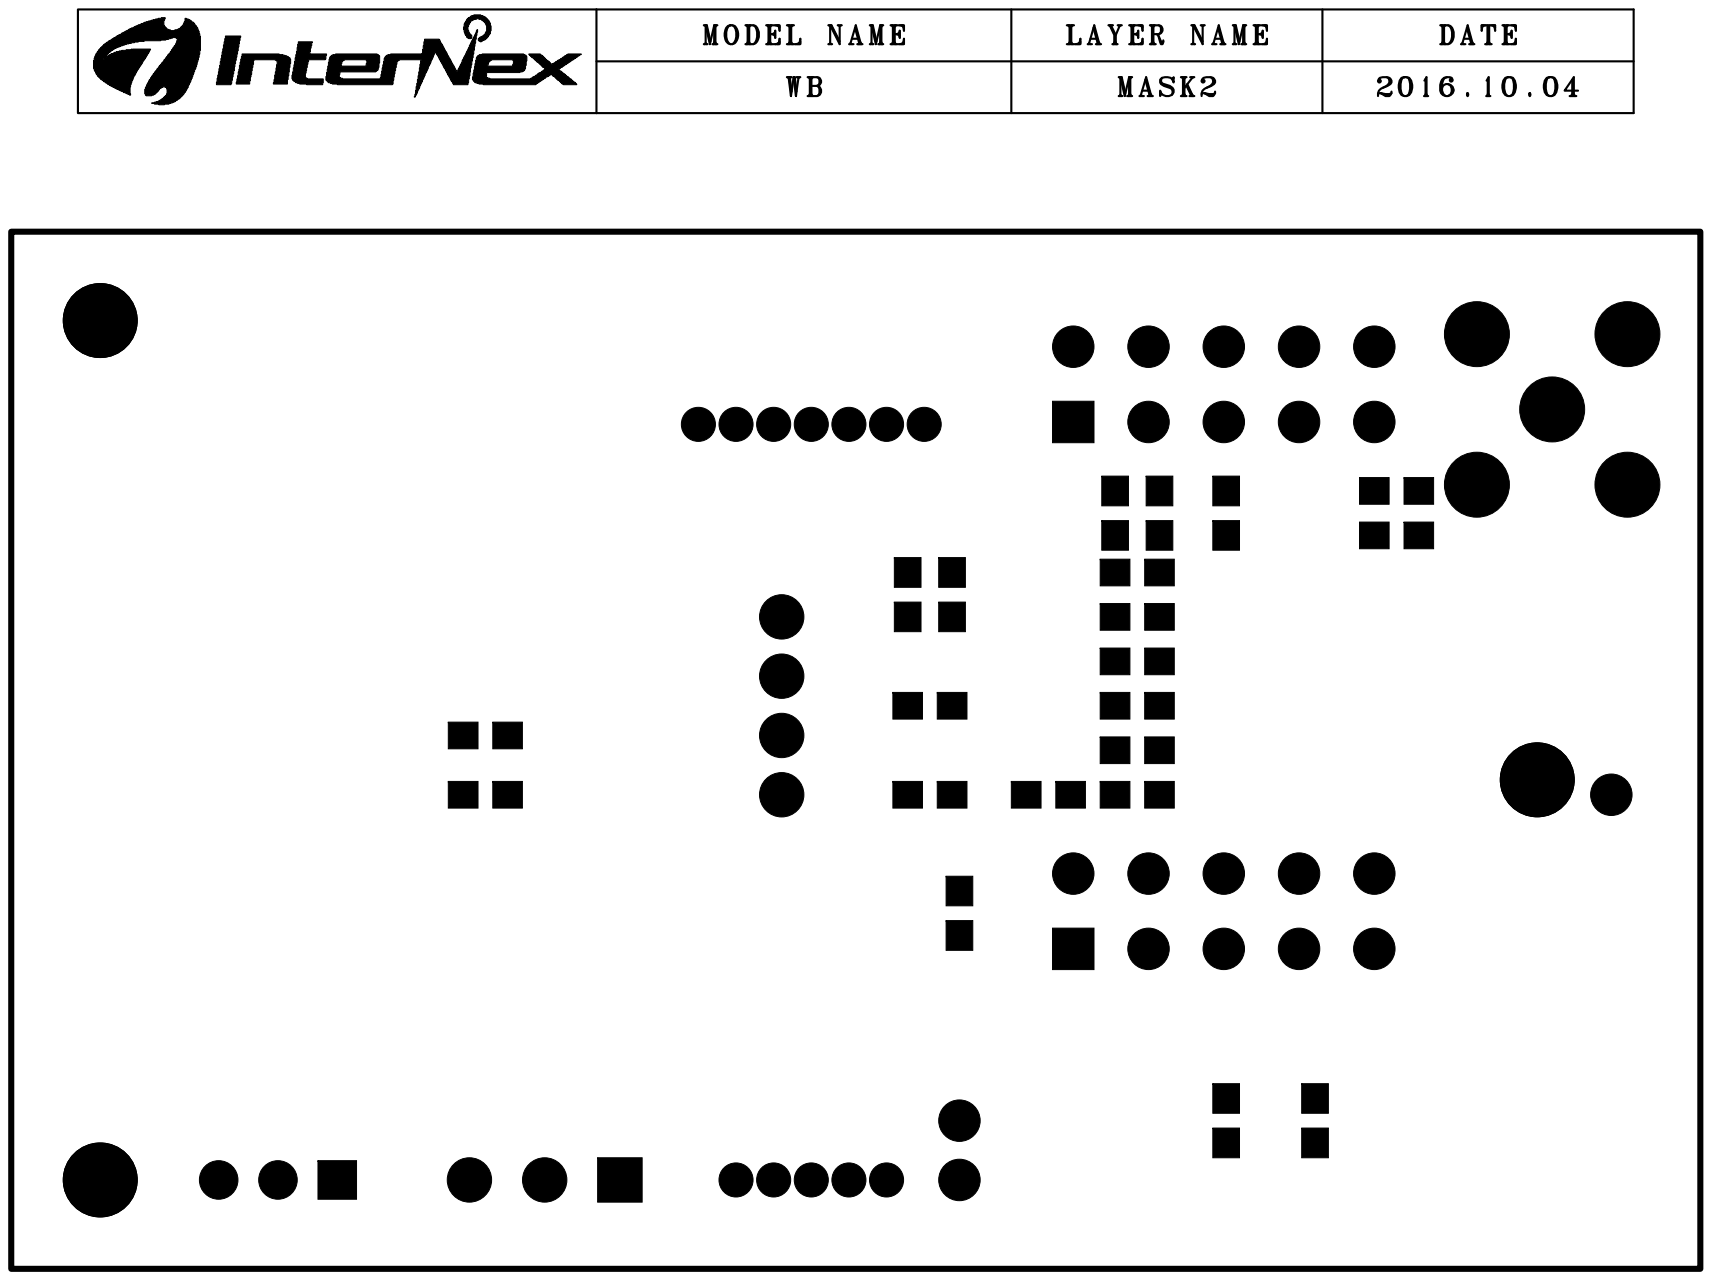
[picture p149: page 10]

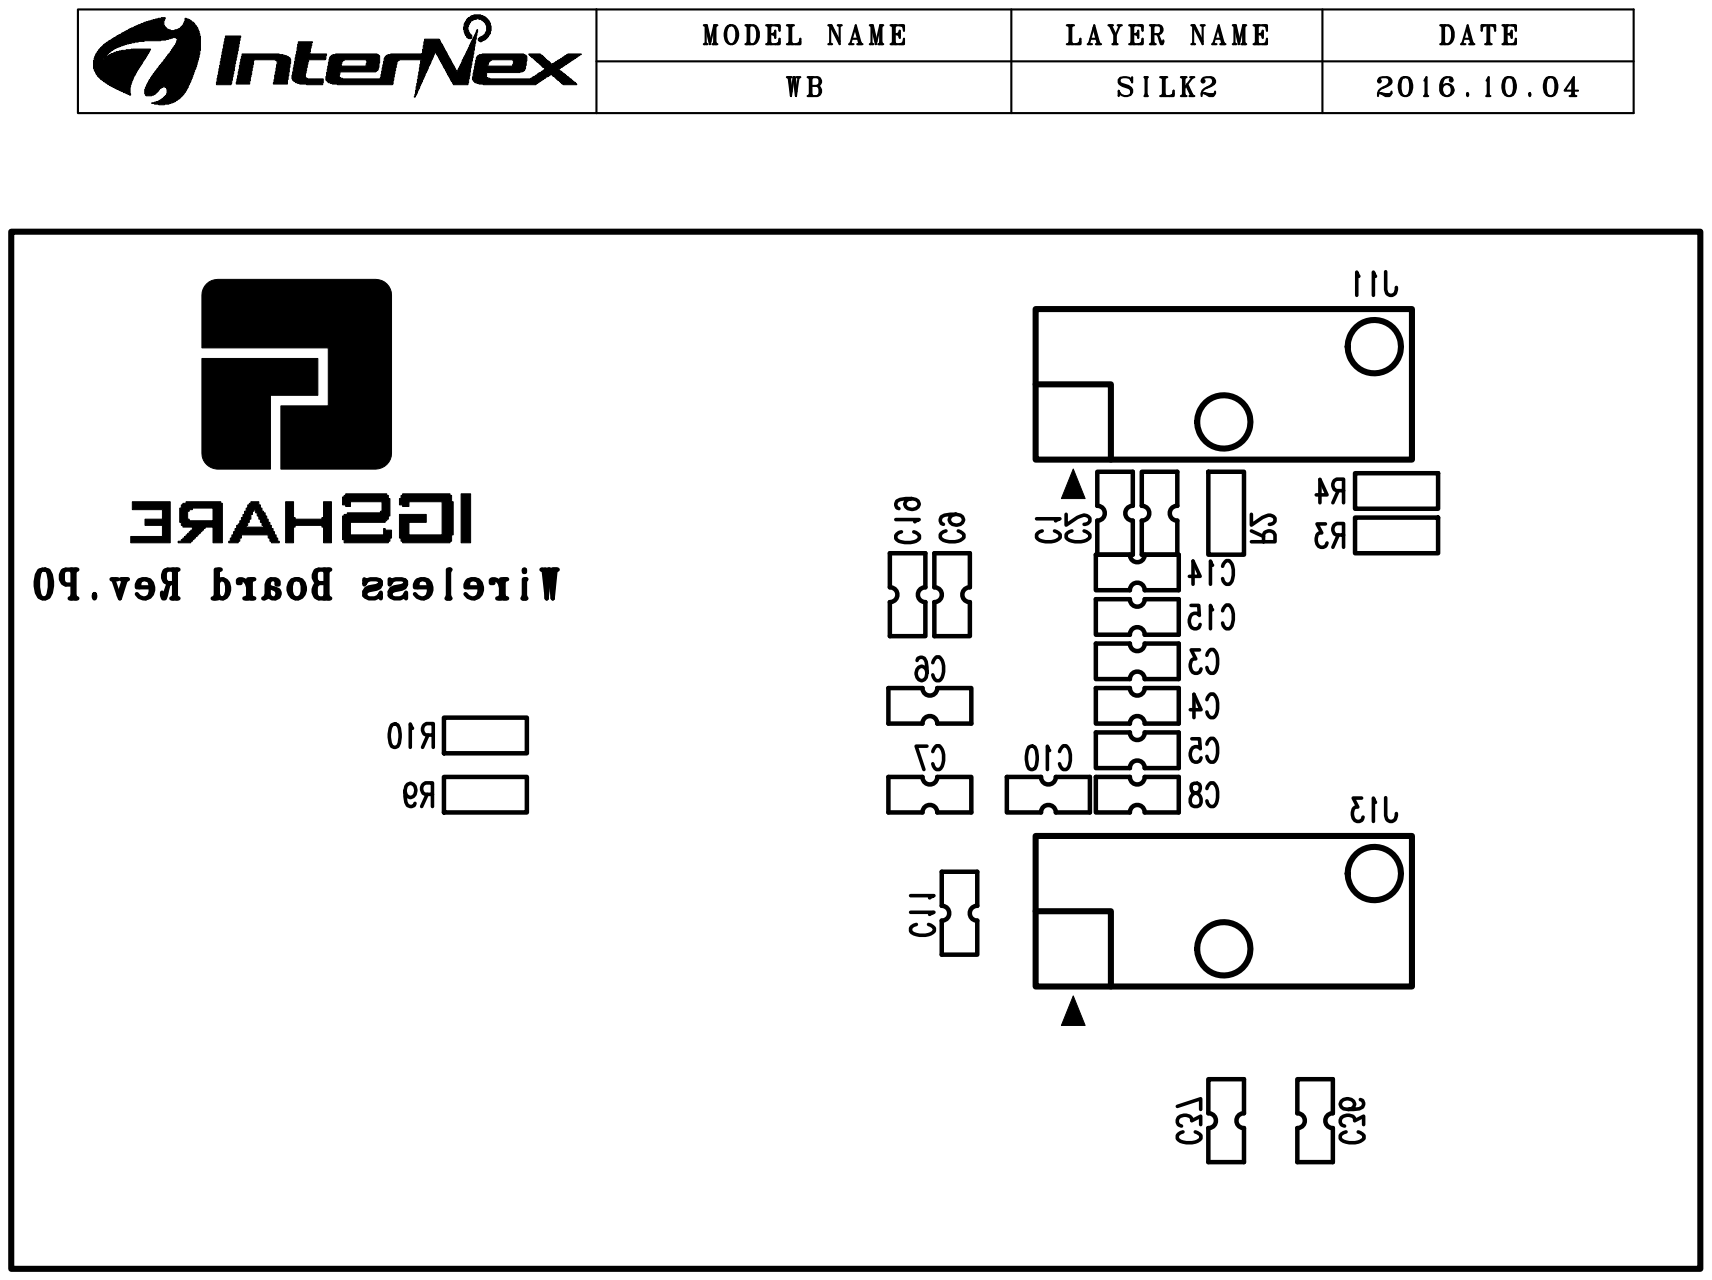
[picture p150: page 11]

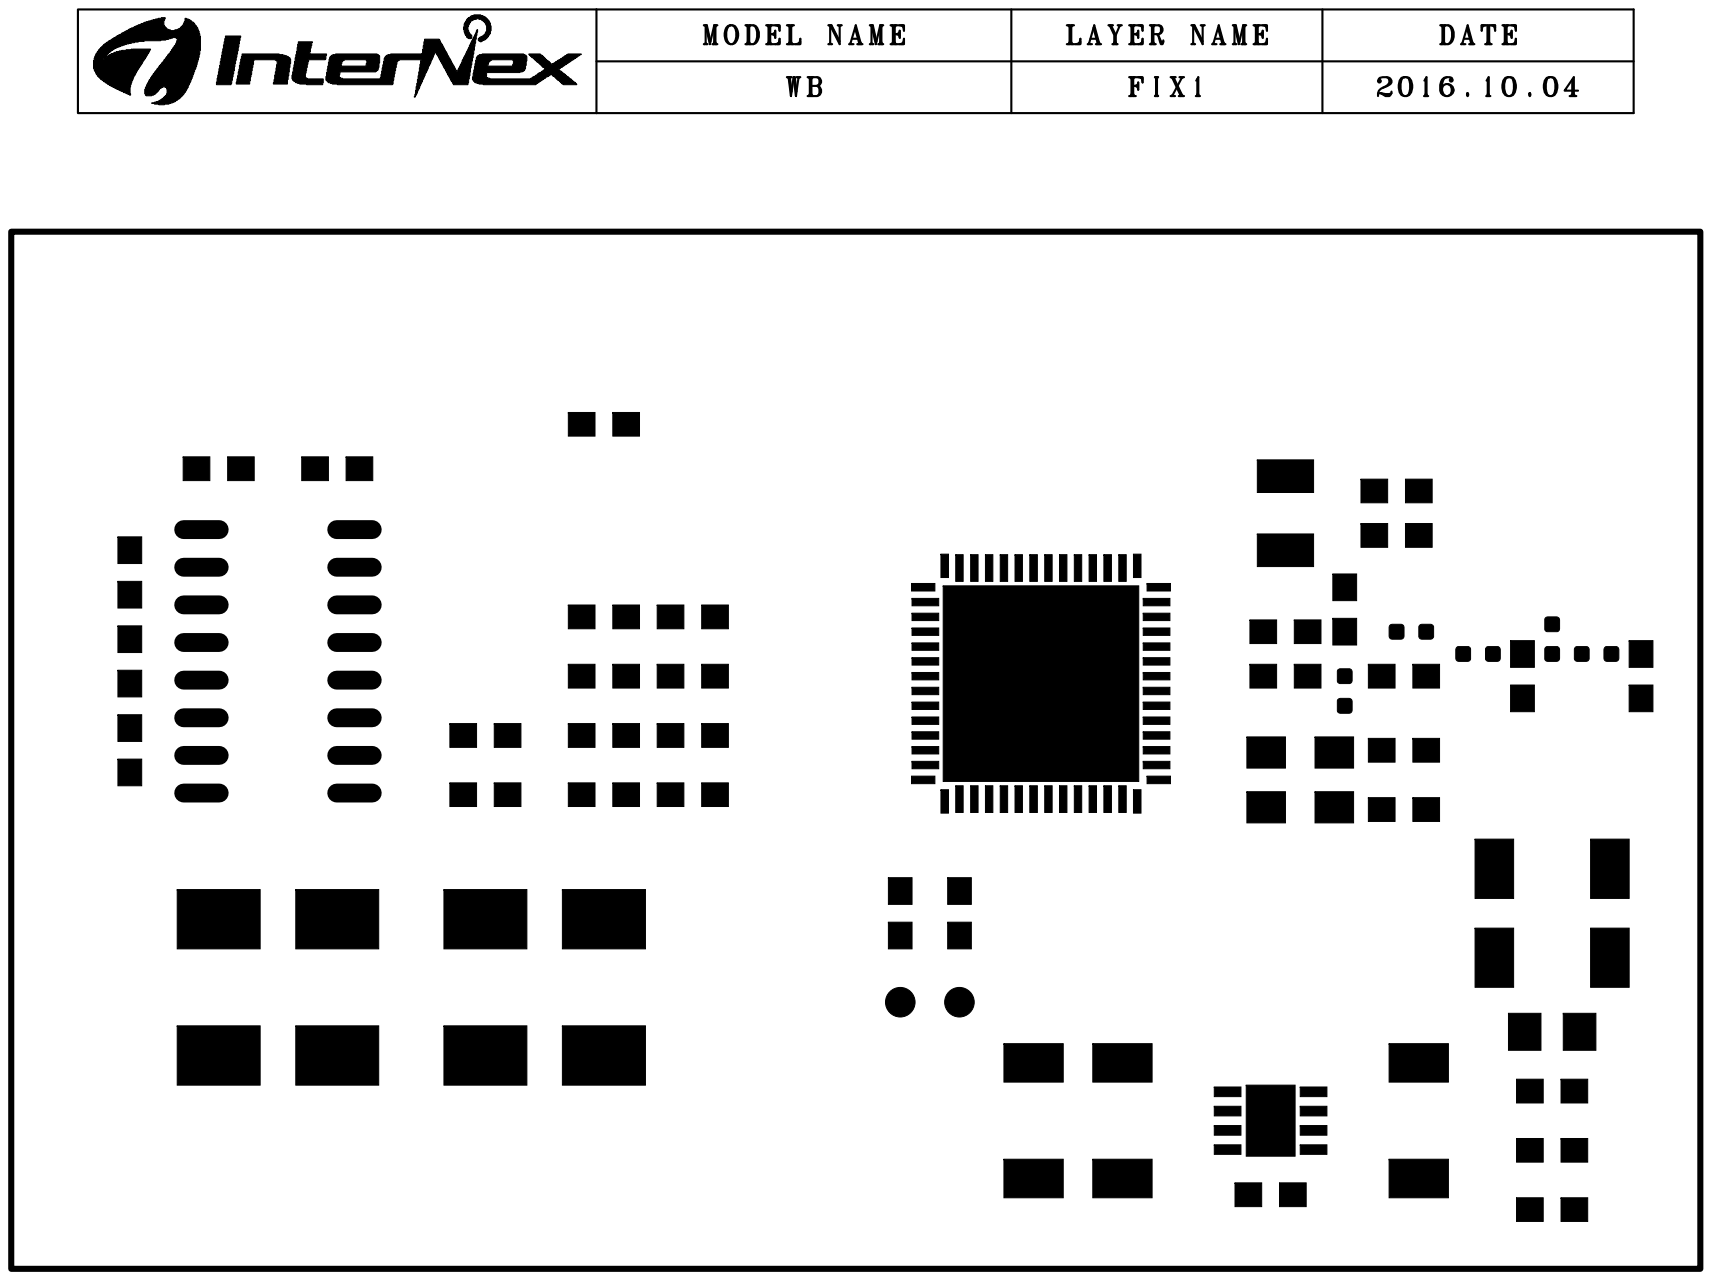
[picture p151: page 12]

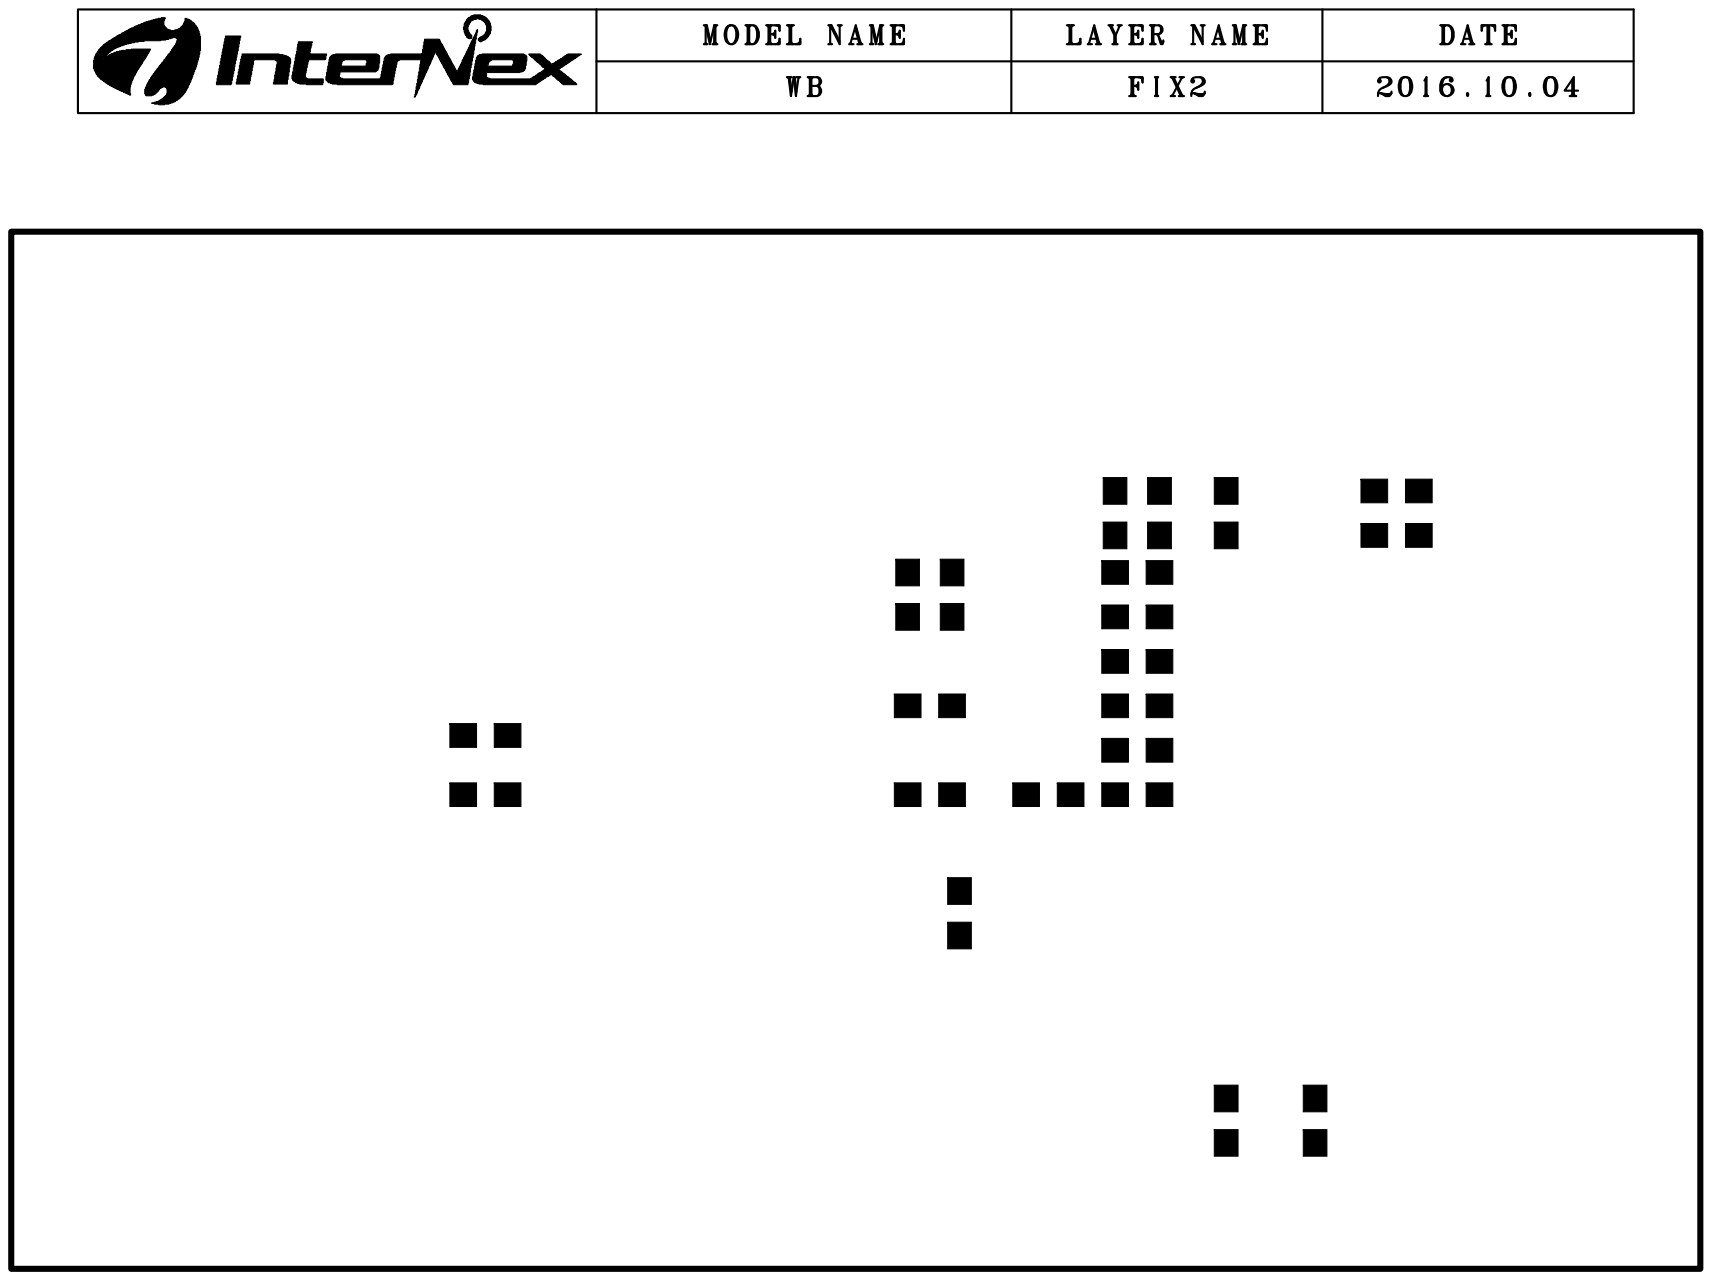
[picture p152: page 13]
