IGShare/01_WPGS/01_HW/02_WSCM/02_Development/01_WB/03_P1/02_Artwork/Wb-r1_닛시/gbr_pdf/fab.pdf

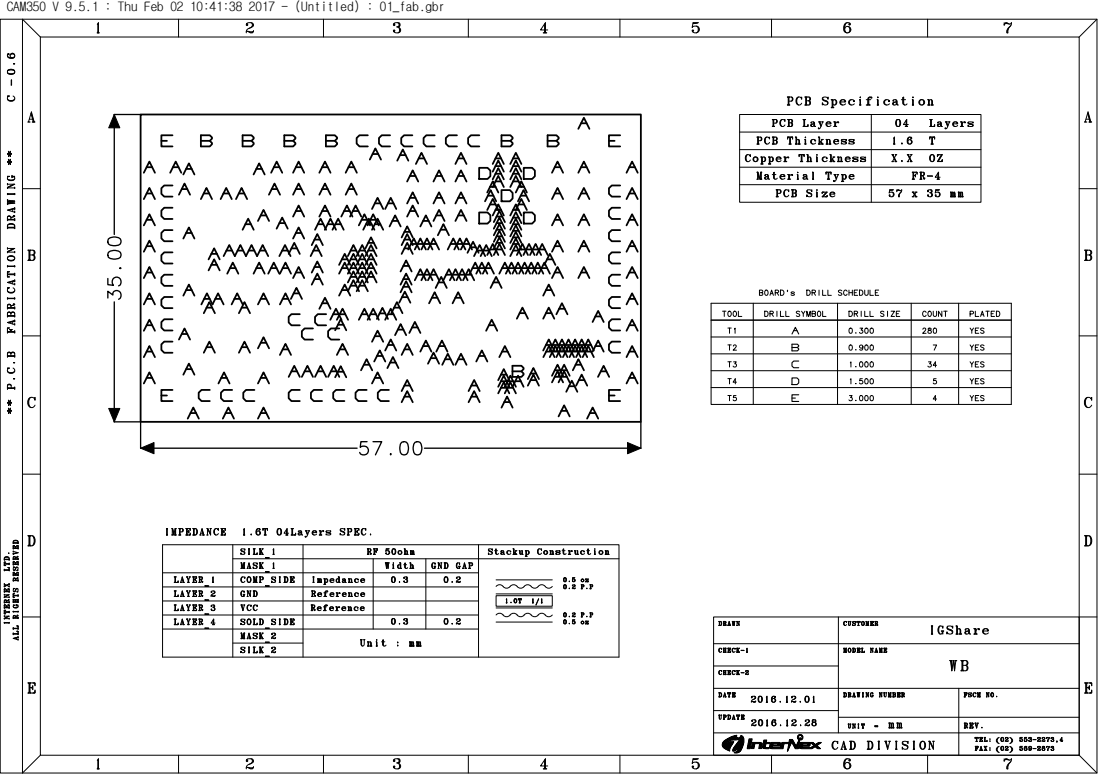
[picture p153: page 1]

CAM350 V 9.5.1 : Thu Feb 02 10:41:38 2017 - (Untitled) : 01_fab.gbr
