IGShare/01_WPGS/01_HW/02_WSCM/02_Development/01_WB/03_P1/02_Artwork/Wb-r1_닛시/gbr_pdf/gbr_pdf.pdf

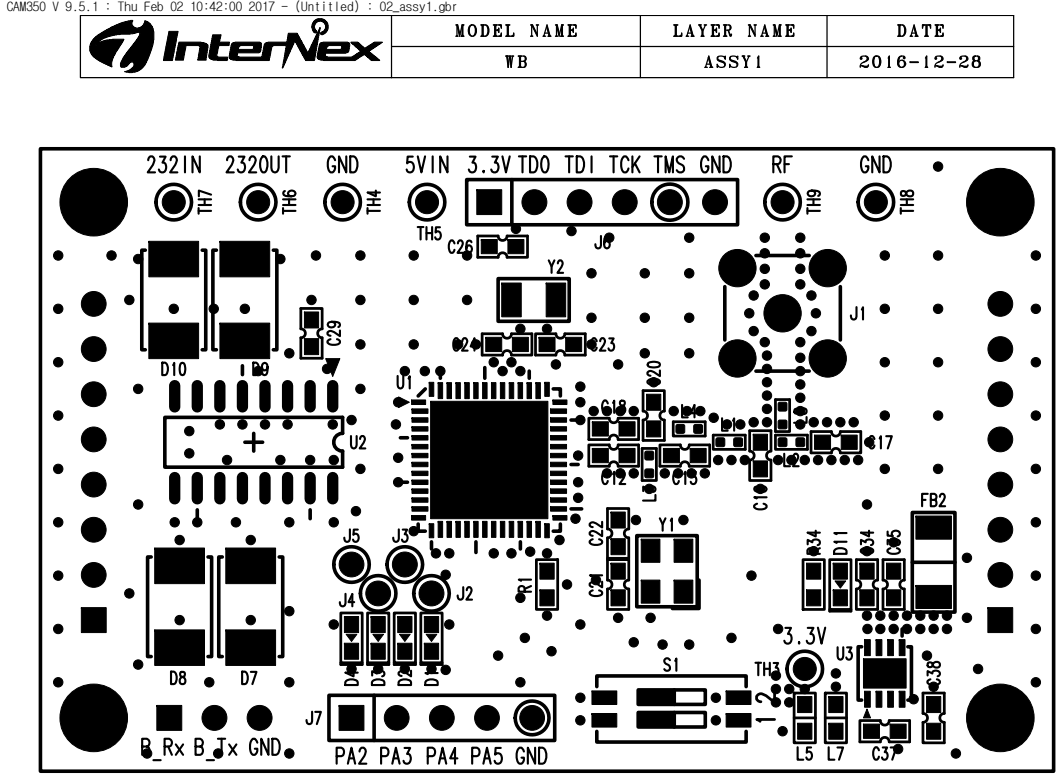
[picture p154: page 1]

CAM350 V 9.5.1 : Thu Feb 02 10:42:00 2017 - (Untitled) : 02_assy1.gbr

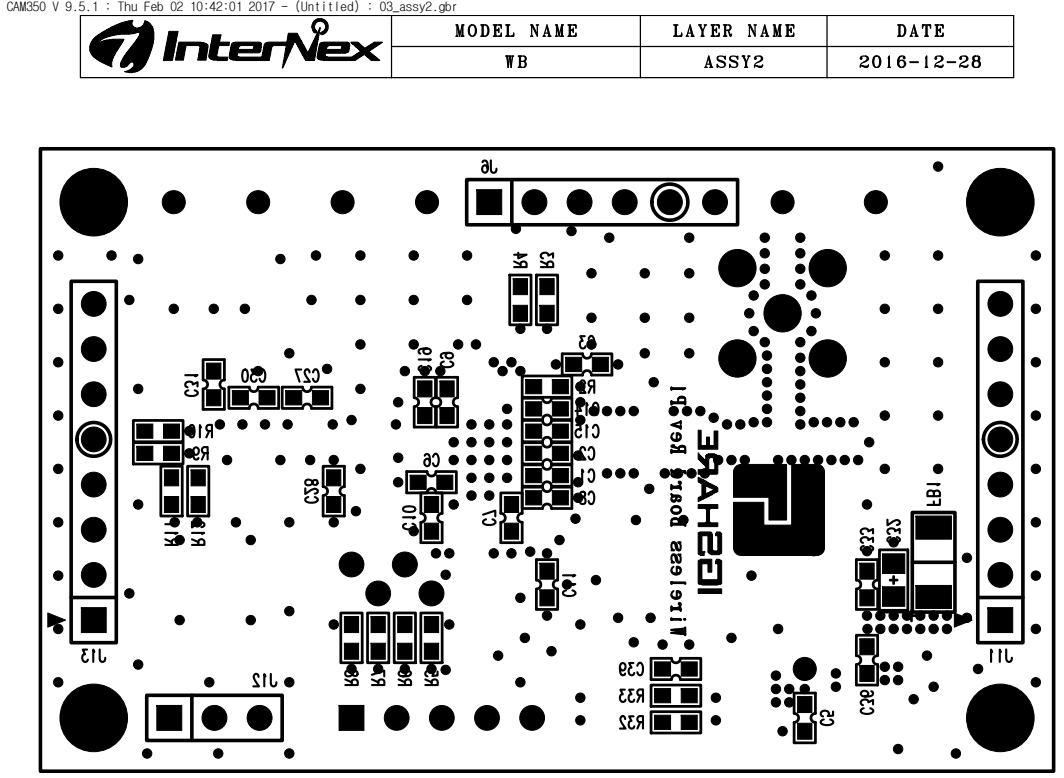
[picture p155: page 2]

CAM350 V 9.5.1 : Thu Feb 02 10:42:01 2017 - (Untitled) : 03_assy2.gbr

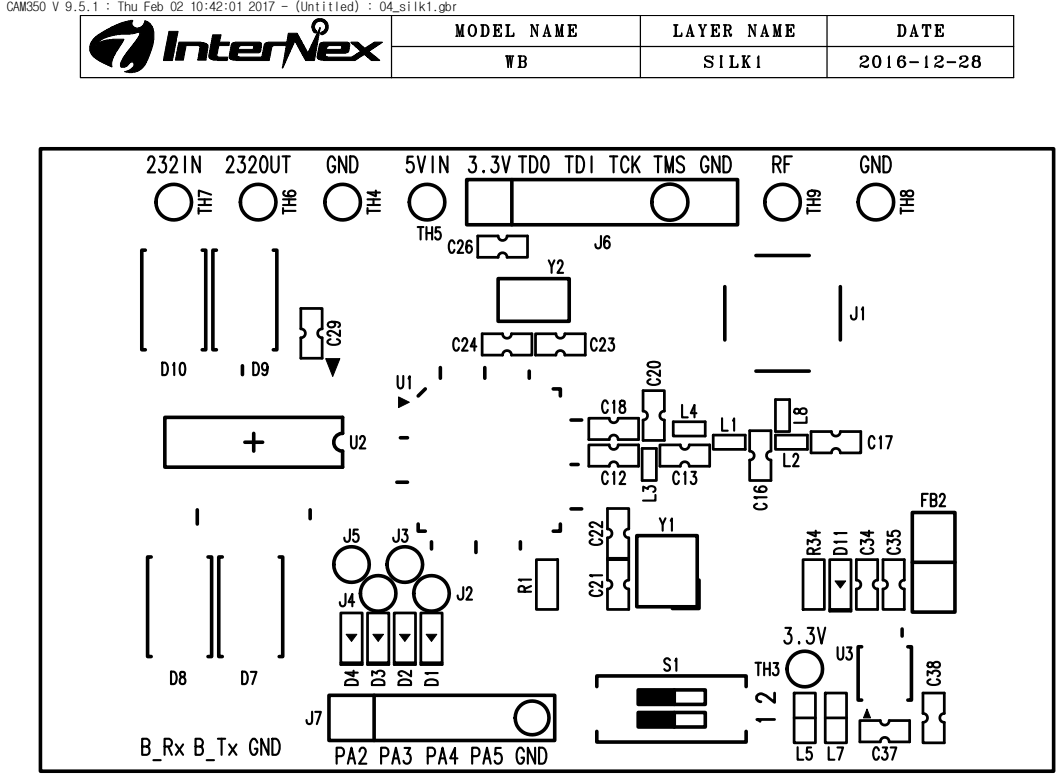
[picture p156: page 3]

CAM350 V 9.5.1 : Thu Feb 02 10:42:01 2017 - (Untitled) : 04_silk1.gbr

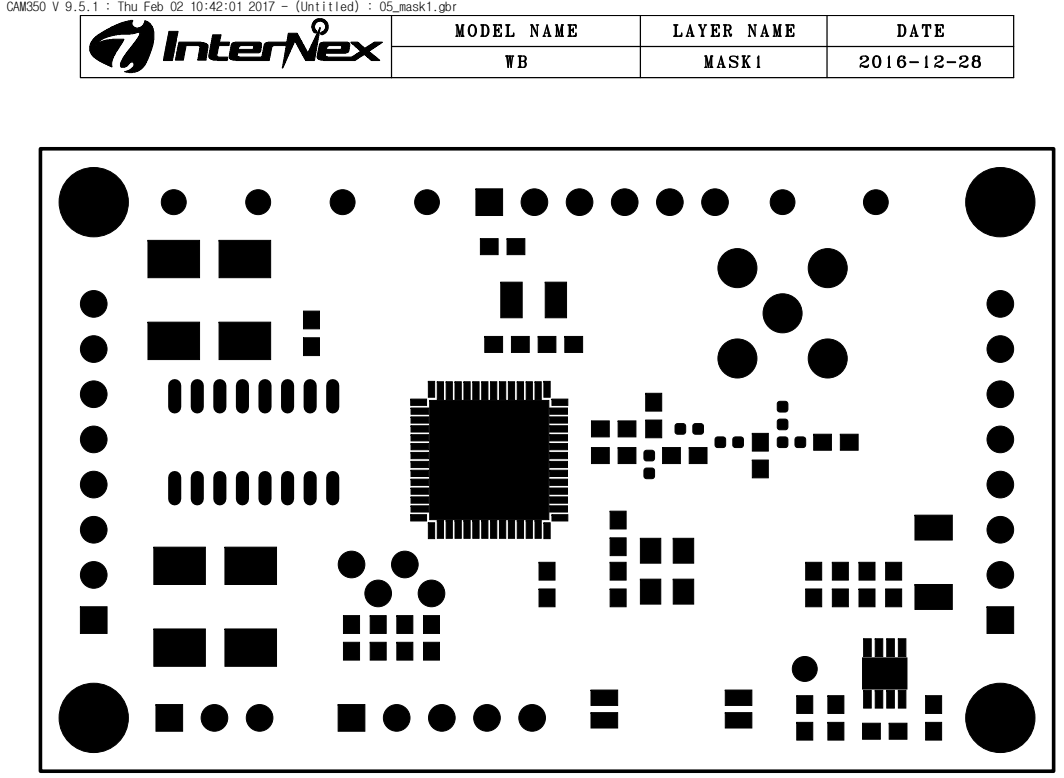
[picture p157: page 4]

CAM350 V 9.5.1 : Thu Feb 02 10:42:01 2017 - (Untitled) : 05_mask1.gbr

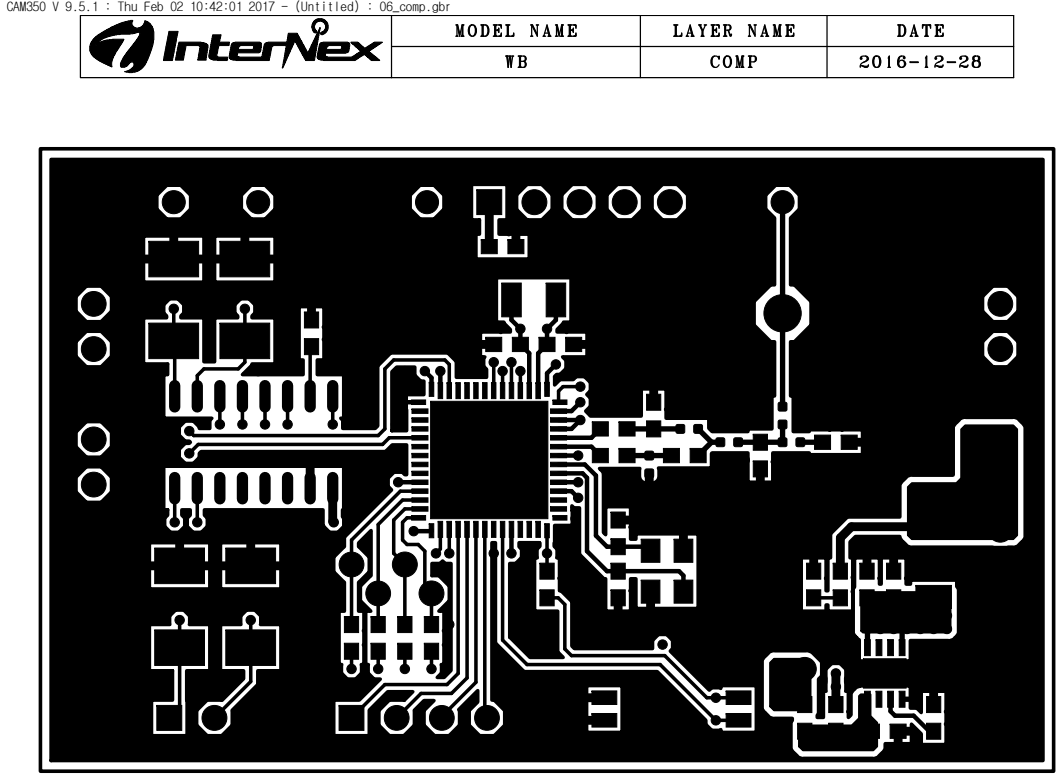
[picture p158: page 5]

CAM350 V 9.5.1 : Thu Feb 02 10:42:01 2017 - (Untitled) : 06_comp.gbr

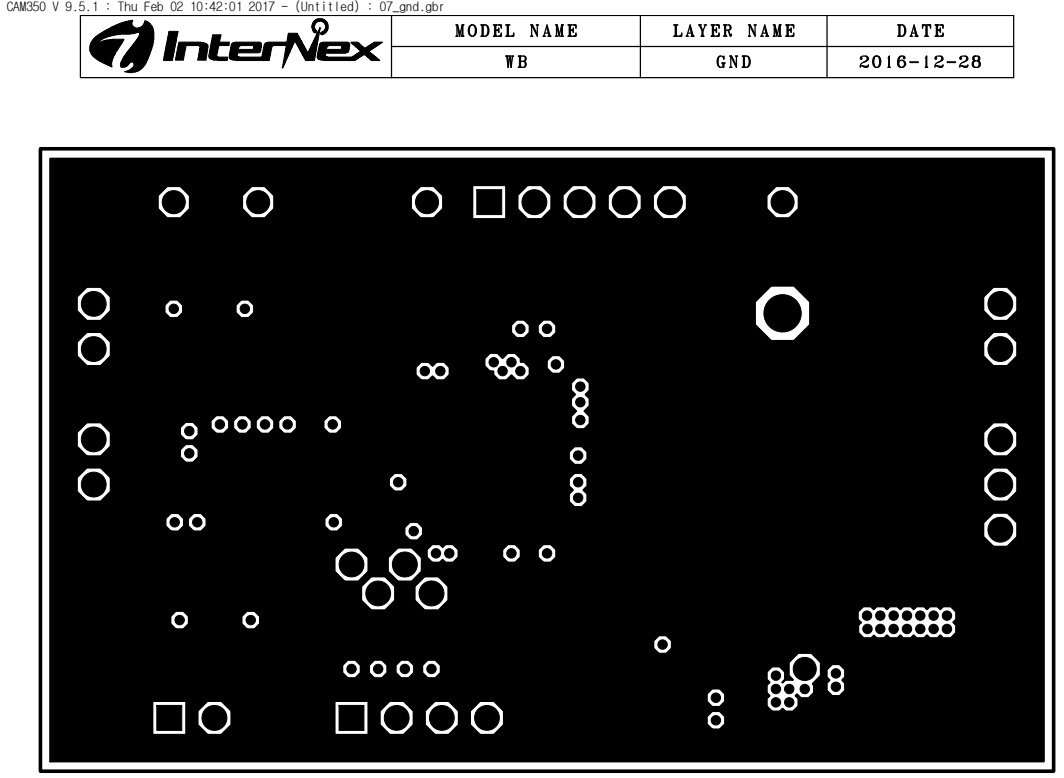
[picture p159: page 6]

CAM350 V 9.5.1 : Thu Feb 02 10:42:01 2017 - (Untitled) : 07_gnd.gbr

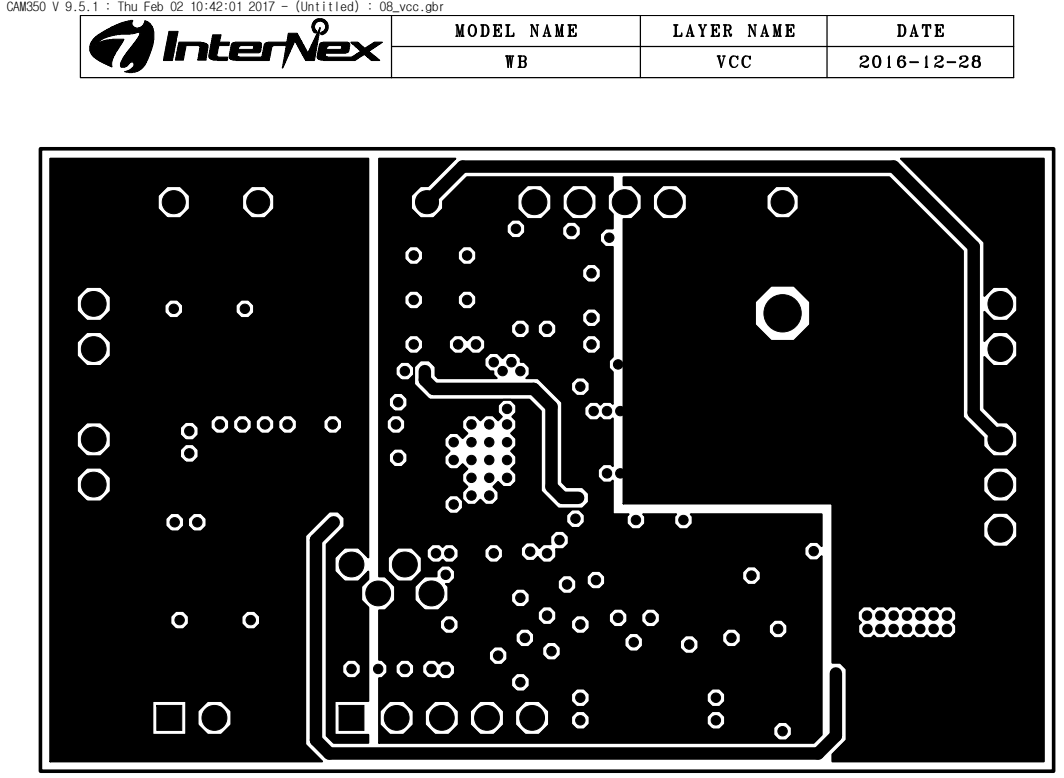
[picture p160: page 7]

CAM350 V 9.5.1 : Thu Feb 02 10:42:01 2017 - (Untitled) : 08_vcc.gbr

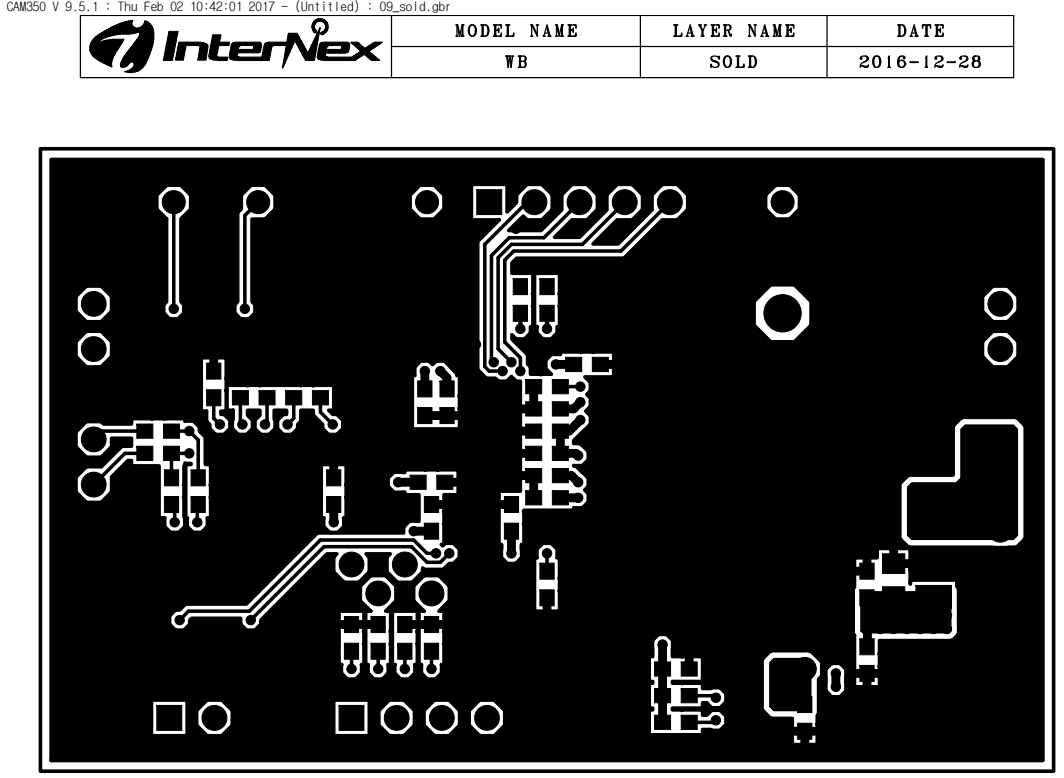
[picture p161: page 8]

CAM350 V 9.5.1 : Thu Feb 02 10:42:01 2017 - (Untitled) : 09_sold.gbr

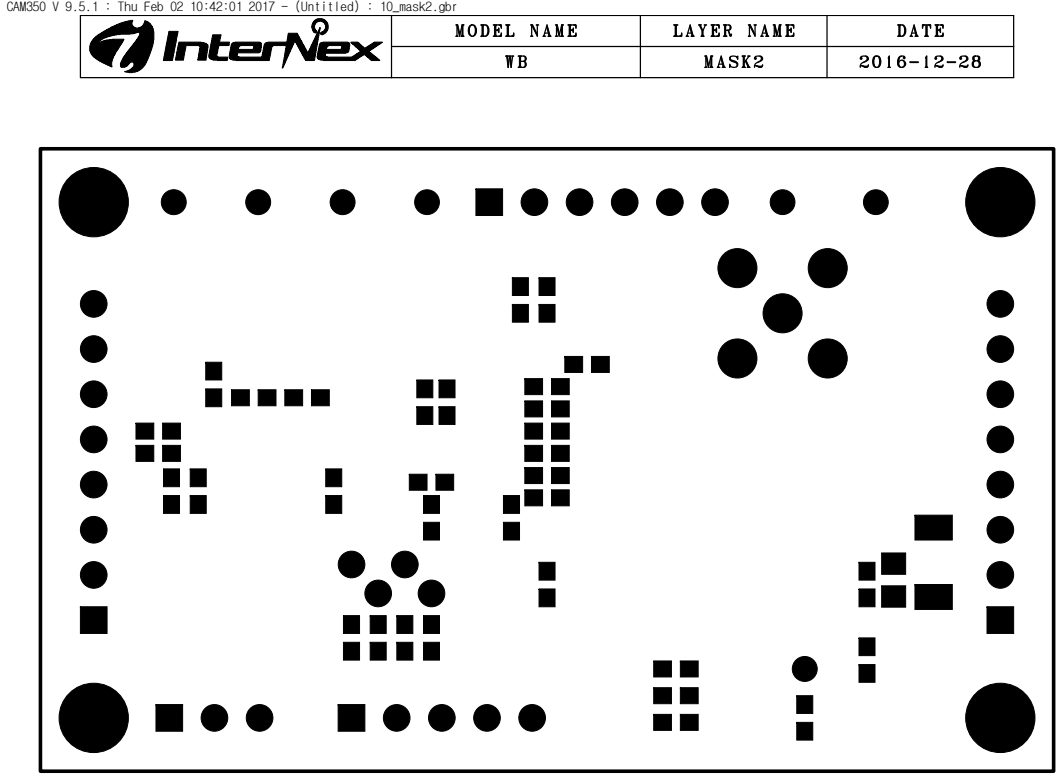
[picture p162: page 9]

CAM350 V 9.5.1 : Thu Feb 02 10:42:01 2017 - (Untitled) : 10_mask2.gbr

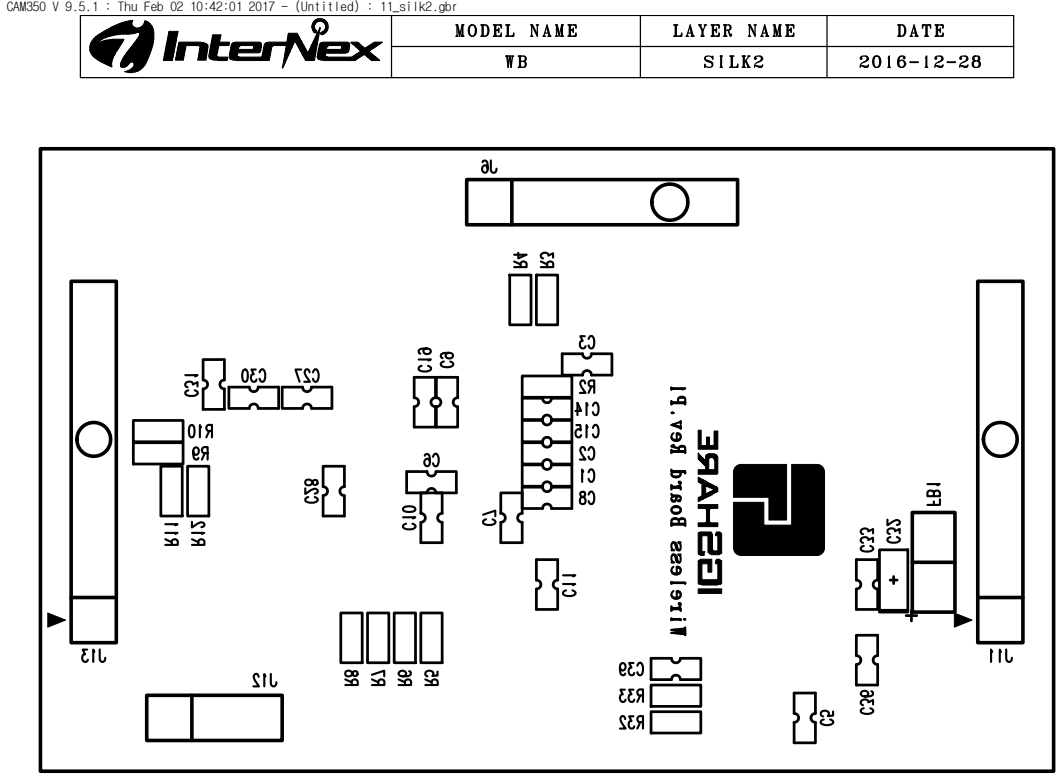
[picture p163: page 10]

CAM350 V 9.5.1 : Thu Feb 02 10:42:01 2017 - (Untitled) : 11_silk2.gbr

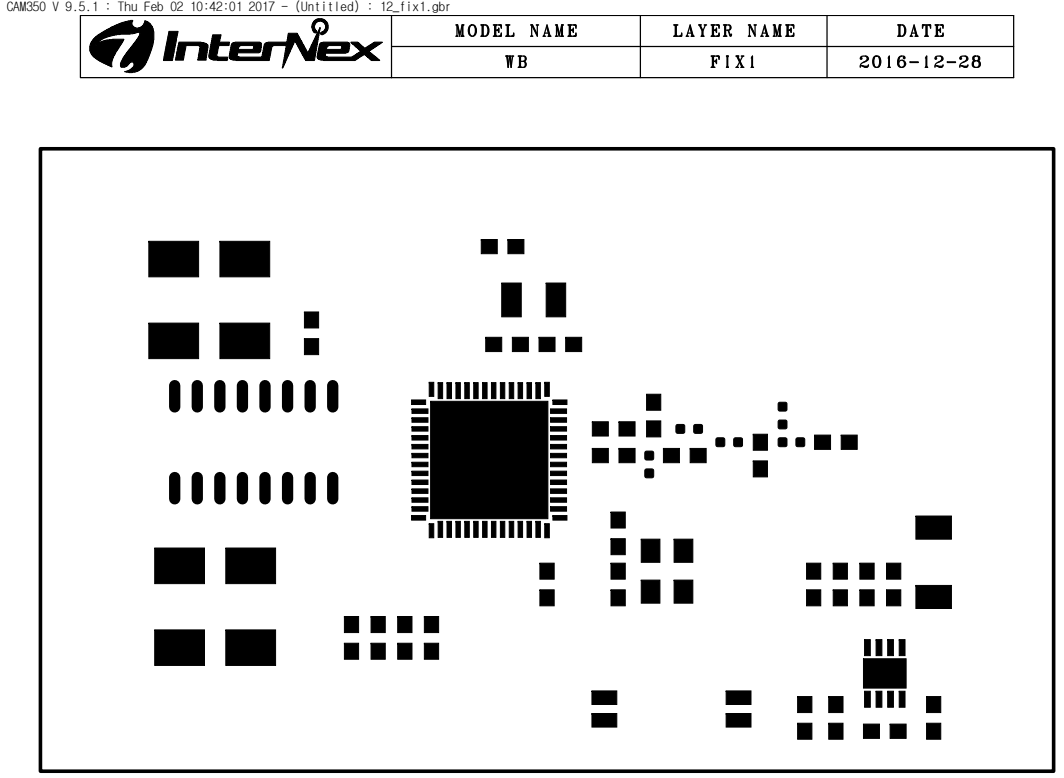
[picture p164: page 11]

CAM350 V 9.5.1 : Thu Feb 02 10:42:01 2017 - (Untitled) : 12_fix1.gbr

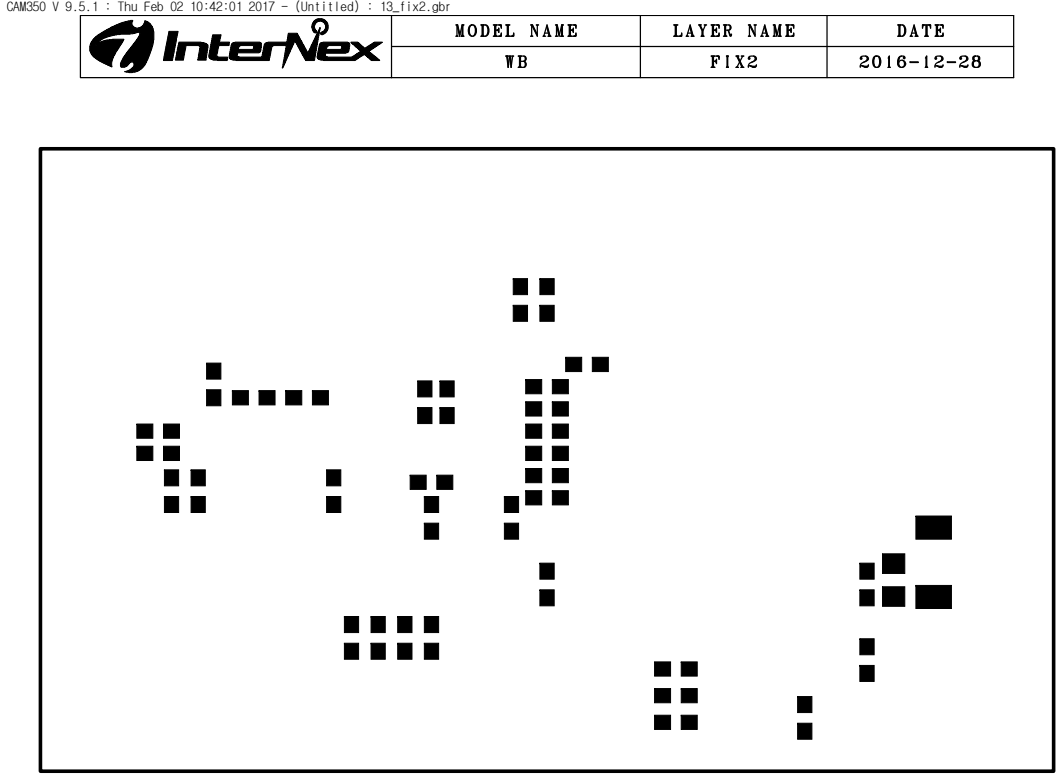
[picture p165: page 12]

CAM350 V 9.5.1 : Thu Feb 02 10:42:01 2017 - (Untitled) : 13_fix2.gbr
