IGShare/01_WPGS/(list of files, drawings)

Other design files:
01_HW/01_WSM/02_Development/02_P0/01_Circuit/IGSHARE_WSM_16_2V_P0.DSN
01_HW/01_WSM/02_Development/03_P1/01_Circuit/IGSHARE_WSM_P1_16_2V_Final.DSN
01_HW/01_WSM/02_Development/04_P2/01_Circuit/IGSHARE_WSM_P2_16_2V_0_02.DSN
01_HW/01_WSM/02_Development/05_P3/01_Circuit/IGSHARE_WSM_P3_16_2V_0_16 _Final.DSN
01_HW/02_WSCM/02_Development/01_WB/02_P0/01_Circuit/IGSHARE_WB_16_2_VP0.DSN
01_HW/02_WSCM/02_Development/01_WB/03_P1/01_Circuit/IGSHARE_WB_16_2_VP1_0_0.DSN
01_HW/02_WSCM/02_Development/01_WB/03_P1/01_Circuit/IGSHARE_WB_REV_P1_.DSN
