IGShare/01_WPGS/02_FW/01_WSM/09_LED_TEST/gpiointerrupt_CC1310_LAUNCHXL_nortos_ccs/Board.h

/*
 * Copyright (c) 2015-2017, Texas Instruments Incorporated
 * All rights reserved.
 *
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
 * *  Redistributions of source code must retain the above copyright
 *    notice, this list of conditions and the following disclaimer.
 *
 * *  Redistributions in binary form must reproduce the above copyright
 *    notice, this list of conditions and the following disclaimer in the
 *    documentation and/or other materials provided with the distribution.
 *
 * *  Neither the name of Texas Instruments Incorporated nor the names of
 *    its contributors may be used to endorse or promote products derived
 *    from this software without specific prior written permission.
 *
 * THIS SOFTWARE IS PROVIDED BY THE COPYRIGHT HOLDERS AND CONTRIBUTORS "AS IS"
 * AND ANY EXPRESS OR IMPLIED WARRANTIES, INCLUDING, BUT NOT LIMITED TO,
 * THE IMPLIED WARRANTIES OF MERCHANTABILITY AND FITNESS FOR A PARTICULAR
 * PURPOSE ARE DISCLAIMED. IN NO EVENT SHALL THE COPYRIGHT OWNER OR
 * CONTRIBUTORS BE LIABLE FOR ANY DIRECT, INDIRECT, INCIDENTAL, SPECIAL,
 * EXEMPLARY, OR CONSEQUENTIAL DAMAGES (INCLUDING, BUT NOT LIMITED TO,
 * PROCUREMENT OF SUBSTITUTE GOODS OR SERVICES; LOSS OF USE, DATA, OR PROFITS;
 * OR BUSINESS INTERRUPTION) HOWEVER CAUSED AND ON ANY THEORY OF LIABILITY,
 * WHETHER IN CONTRACT, STRICT LIABILITY, OR TORT (INCLUDING NEGLIGENCE OR
 * OTHERWISE) ARISING IN ANY WAY OUT OF THE USE OF THIS SOFTWARE,
 * EVEN IF ADVISED OF THE POSSIBILITY OF SUCH DAMAGE.
 */

#ifndef __BOARD_H
#define __BOARD_H

#ifdef __cplusplus
extern "C" {
#endif

#include <ti/drivers/ADC.h>
#include <ti/drivers/ADCBuf.h>
#include <ti/drivers/GPIO.h>
#include <ti/drivers/PWM.h>
#include <ti/drivers/SPI.h>
#include <ti/drivers/UART.h>
#include <ti/drivers/Watchdog.h>

#include "CC1310_LAUNCHXL.h"

#define Board_initGeneral()     CC1310_LAUNCHXL_initGeneral()
#define Board_shutDownExtFlash() CC1310_LAUNCHXL_shutDownExtFlash()
#define Board_wakeUpExtFlash() CC1310_LAUNCHXL_wakeUpExtFlash()

/* These #defines allow us to reuse TI-RTOS across other device families */

#define Board_ADC0              CC1310_LAUNCHXL_ADC0
#define Board_ADC1              CC1310_LAUNCHXL_ADC1

#define Board_ADCBUF0           CC1310_LAUNCHXL_ADCBUF0
#define Board_ADCBUF0CHANNEL0   CC1310_LAUNCHXL_ADCBUF0CHANNEL0
#define Board_ADCBUF0CHANNEL1   CC1310_LAUNCHXL_ADCBUF0CHANNEL1

#define Board_CRYPTO0           CC1310_LAUNCHXL_CRYPTO0

#define Board_DIO0              CC1310_LAUNCHXL_DIO0
#define Board_DIO1              CC1310_LAUNCHXL_DIO1
#define Board_DIO12             CC1310_LAUNCHXL_DIO12
#define Board_DIO15             CC1310_LAUNCHXL_DIO15
#define Board_DIO16_TDO         CC1310_LAUNCHXL_DIO16_TDO
#define Board_DIO17_TDI         CC1310_LAUNCHXL_DIO17_TDI
#define Board_DIO21             CC1310_LAUNCHXL_DIO21
#define Board_DIO22             CC1310_LAUNCHXL_DIO22
#define Board_DIO25             CC1310_LAUNCHXL_DIO25

#define Board_GPIO_BUTTON0      CC1310_LAUNCHXL_GPIO_S1
#define Board_GPIO_BUTTON1      CC1310_LAUNCHXL_GPIO_S2
#define Board_GPIO_BTN1         CC1310_LAUNCHXL_GPIO_S1
#define Board_GPIO_BTN2         CC1310_LAUNCHXL_GPIO_S2
#define Board_GPIO_LED0         CC1310_LAUNCHXL_GPIO_LED_RED
#define Board_GPIO_LED1         CC1310_LAUNCHXL_GPIO_LED_GREEN
#define Board_GPIO_RLED         CC1310_LAUNCHXL_GPIO_LED_RED
#define Board_GPIO_GLED         CC1310_LAUNCHXL_GPIO_LED_GREEN
#define Board_GPIO_LED_ON       CC1310_LAUNCHXL_GPIO_LED_ON
#define Board_GPIO_LED_OFF      CC1310_LAUNCHXL_GPIO_LED_OFF

#define Board_GPTIMER0A         CC1310_LAUNCHXL_GPTIMER0A
#define Board_GPTIMER0B         CC1310_LAUNCHXL_GPTIMER0B
#define Board_GPTIMER1A         CC1310_LAUNCHXL_GPTIMER1A
#define Board_GPTIMER1B         CC1310_LAUNCHXL_GPTIMER1B
#define Board_GPTIMER2A         CC1310_LAUNCHXL_GPTIMER2A
#define Board_GPTIMER2B         CC1310_LAUNCHXL_GPTIMER2B
#define Board_GPTIMER3A         CC1310_LAUNCHXL_GPTIMER3A
#define Board_GPTIMER3B         CC1310_LAUNCHXL_GPTIMER3B

#define Board_I2C0              CC1310_LAUNCHXL_I2C0
#define Board_I2C_TMP           CC1310_LAUNCHXL_I2C0

#define Board_NVS0              CC1310_LAUNCHXL_NVSCC26XX0
#define Board_NVS1              CC1310_LAUNCHXL_NVSSPI25X0

#define Board_PIN_BUTTON0       CC1310_LAUNCHXL_PIN_BTN1
#define Board_PIN_BUTTON1       CC1310_LAUNCHXL_PIN_BTN2
#define Board_PIN_BTN1          CC1310_LAUNCHXL_PIN_BTN1
#define Board_PIN_BTN2          CC1310_LAUNCHXL_PIN_BTN2
#define Board_PIN_LED0          CC1310_LAUNCHXL_PIN_RLED
#define Board_PIN_LED1          CC1310_LAUNCHXL_PIN_GLED
#define Board_PIN_LED2          CC1310_LAUNCHXL_PIN_RLED
#define Board_PIN_RLED          CC1310_LAUNCHXL_PIN_RLED
#define Board_PIN_GLED          CC1310_LAUNCHXL_PIN_GLED

#define Board_PWM0              CC1310_LAUNCHXL_PWM0
#define Board_PWM1              CC1310_LAUNCHXL_PWM1
#define Board_PWM2              CC1310_LAUNCHXL_PWM2
#define Board_PWM3              CC1310_LAUNCHXL_PWM3
#define Board_PWM4              CC1310_LAUNCHXL_PWM4
#define Board_PWM5              CC1310_LAUNCHXL_PWM5
#define Board_PWM6              CC1310_LAUNCHXL_PWM6
#define Board_PWM7              CC1310_LAUNCHXL_PWM7

#define Board_SD0               CC1310_LAUNCHXL_SDSPI0

#define Board_SPI0              CC1310_LAUNCHXL_SPI0
#define Board_SPI1              CC1310_LAUNCHXL_SPI1
#define Board_SPI_FLASH_CS      CC1310_LAUNCHXL_SPI_FLASH_CS
#define Board_FLASH_CS_ON       0
#define Board_FLASH_CS_OFF      1

#define Board_UART0             CC1310_LAUNCHXL_UART0

#define Board_WATCHDOG0         CC1310_LAUNCHXL_WATCHDOG0

/* Board specific I2C addresses */
#define Board_TMP_ADDR          (0x40)
#define Board_SENSORS_BP_TMP_ADDR Board_TMP_ADDR

/*
 * These macros are provided for backwards compatibility.
 * Please use the <Driver>_init functions directly rather
 * than Board_init<Driver>.
 */
#define Board_initADC()         ADC_init()
#define Board_initADCBuf()      ADCBuf_init()
#define Board_initGPIO()        GPIO_init()
#define Board_initPWM()         PWM_init()
#define Board_initSPI()         SPI_init()
#define Board_initUART()        UART_init()
#define Board_initWatchdog()    Watchdog_init()

/*
 * These macros are provided for backwards compatibility.
 * Please use the 'Board_PIN_xxx' macros to differentiate
 * them from the 'Board_GPIO_xxx' macros.
 */
#define Board_BUTTON0           Board_PIN_BUTTON0
#define Board_BUTTON1           Board_PIN_BUTTON1
#define Board_BTN1              Board_PIN_BTN1
#define Board_BTN2              Board_PIN_BTN2
#define Board_LED0              Board_PIN_LED0
#define Board_LED1              Board_PIN_LED1
#define Board_LED2              Board_PIN_LED2
#define Board_RLED              Board_PIN_RLED
#define Board_GLED              Board_PIN_GLED
#define Board_LED_ON            Board_GPIO_LED_ON
#define Board_LED_OFF           Board_GPIO_LED_OFF
#define Board_ADCBUFCHANNEL0    Board_ADCBUF0CHANNEL0
#define Board_ADCBUFCHANNEL1    Board_ADCBUF0CHANNEL1

#ifdef __cplusplus
}
#endif

#endif /* __BOARD_H */
