IGShare/01_WPGS/03_SW/03_UARTTest/UARTDebug/resource.h

//{{NO_DEPENDENCIES}}
// Microsoft Visual C++ generated include file.
// Used by UARTDebug.rc
//
#define IDM_ABOUTBOX                    0x0010
#define IDD_ABOUTBOX                    100
#define IDS_ABOUTBOX                    101
#define IDD_UARTDEBUG_DIALOG            102
#define IDR_MAINFRAME                   128
#define IDC_BUTTON_OPEN_DEVMGR          1000
#define IDC_BUTTON_COM_OPEN             1003
#define IDC_BUTTON_COM_CLOSE            1004
#define IDC_BUTTON_COM_TEST             1005
#define IDC_EDIT3                       1006
#define IDC_BUTTON5                     1007
#define IDC_BUTTON_SendData             1007
#define IDC_COMBO_PORT                  1008
#define IDC_COMBO_BAUDRATE              1009
#define IDC_RICHEDIT21                  1010
#define IDC_BUTTON_START                1011
#define IDC_BUTTON2                     1012
#define IDC_BUTTON_STOP                 1012

// Next default values for new objects
// 
#ifdef APSTUDIO_INVOKED
#ifndef APSTUDIO_READONLY_SYMBOLS
#define _APS_NEXT_RESOURCE_VALUE        130
#define _APS_NEXT_COMMAND_VALUE         32771
#define _APS_NEXT_CONTROL_VALUE         1013
#define _APS_NEXT_SYMED_VALUE           101
#endif
#endif
