IGShare/01_WPGS/03_SW/04_DebugTool/01_WSMDebugTool/resource.h

//{{NO_DEPENDENCIES}}
// Microsoft Visual C++ generated include file.
// Used by 01_WSMDebugTool.rc
//
#define IDM_ABOUTBOX                    0x0010
#define IDD_ABOUTBOX                    100
#define IDS_ABOUTBOX                    101
#define IDD_MY01_WSMDEBUGTOOL_DIALOG    102
#define IDR_MAINFRAME                   128
#define IDC_COMBO_PORT                  1000
#define IDC_COMBO_BAUDRATE              1001
#define IDC_BUTTON_DATA_ACQUISITION_START 1002
#define IDC_BUTTON_COMPORT_OPEN         1003
#define IDC_BUTTON_COMPORT_CLOSE        1004
#define IDC_BUTTON_DATA_ACQUISITION_STOP 1005
#define IDC_BUTTON_DEVICE_MANAGER       1006
#define IDC_RICHEDIT21                  1007
#define IDC_STATIC_STATUS_MESSAGE       1008
#define IDC_RADIO1                      1011
#define IDC_RADIO2                      1012
#define IDC_CHECK_X                     1013
#define IDC_CHECK_Y                     1014
#define IDC_CHECK_Z                     1015
#define IDC_BUTTON_SAVE                 1016
#define IDC_BUTTON1                     1017
#define IDC_BUTTON_CLEAR                1017

// Next default values for new objects
// 
#ifdef APSTUDIO_INVOKED
#ifndef APSTUDIO_READONLY_SYMBOLS
#define _APS_NEXT_RESOURCE_VALUE        130
#define _APS_NEXT_COMMAND_VALUE         32771
#define _APS_NEXT_CONTROL_VALUE         1018
#define _APS_NEXT_SYMED_VALUE           101
#endif
#endif
