IGShare/01_WPGS/(commit log)

2018-02-06 FW
    FW
    [build.cfg, m3_Hwi_asm.obj, m3_Hwi_asm_switch.obj, m3_IntrinsicsSupport_asm.obj, m3_TaskSupport_asm.obj, rfExamples.cfg, rom.cfg, rom_arm_m3_Hwi_asm_iar_lib.obj]
2018-02-06 md
    md
    [P고정판 금형도면 1.dwg, RF 2000 바닥용 도면.dwg, RF 2000 바닥용 도면2.dwg, RF-2000 수정 도면 dwg.dwg, RF-2000 전송 도면 dwg.dwg, RF-M 최종수정 도면 2[2852].dwg, SW-1711[RF-2000].STL, SW-1711[RF-2000].igs]
2018-02-06 hw
    hw
    [01_fab.gbr, 02_assy1.gbr, 03_assy2.gbr, 04_silk1.gbr, 05_mask1.gbr, 06_comp.gbr, 07_gnd.gbr, 07_gnd1.gbr]
2018-02-06 테스트
    테스트
2018-03-02 1
    1
    [AtControl.obj, AtParams.obj, AtProcess.obj, AtTerm.obj, EasyLink.obj, build.cfg, m3_Hwi_asm.obj, m3_Hwi_asm_switch.obj]
